alsizyakin/InvertorPowerNewGen/CHANGELOG_rev0.1.md

# CHANGELOG ревизии 0.1

Ведётся по разделам `REV0_1_TASK.md`. Обозначения — как в проекте, координаты — в мм по rev0.
Решения владельца от 2026-10-15 — раздел **Р** задания (Р1…Р7).

---

## §0. Перенос 0.1/0.2 из rev1 — выполнено (Р4)

| Коммит rev0.1 | Из rev1 | Что |
|---|---|---|
| `4d11850` | `7035780` | 0.1: библиотеки символов |
| `399472e` | `4fded72` | 0.2: `no_connect` на J6.14 и J6.16 |
| `45a6383` | `4f0544f` | 0.2: пояснение про семь цепей +3.3 В |
| `ca5474b` | `28699c8` | 0.2: флаги питания |

Перенос прошёл без конфликтов. Подробная запись — в `CHANGELOG_rev1.md`, файл пришёл вместе с коммитами.

**Проверки** (kicad-cli 10.0.3, на копии проекта):

| | База (`main`) | После переноса |
|---|---|---|
| ERC, ошибки | 21 | **9** |
| ERC, предупреждения | 35 | 30 |
| DRC: ошибки / неразведённые / расхождения со схемой | 0 / 0 / 0 | 0 / 0 / 0 |
| DRC, предупреждения | 1 (`silk_edge_clearance`) | 1, то же |
| Netlist | — | отличается только секцией `libraries` (+`CAN_My`, +`Novosense`) и `pintype` у J6.14/16 (`passive+no_connect`) |

**9 ошибок ERC — новая база (Р5):**
- 6 `different_unit_net` + 2 `duplicate_pins` — дефект символа `Logic_My:TLV3502AIDR` (U6). В rev1 они уходили
  вместе с U6, здесь лист OCP заморожен — остаются;
- 1 `power_pin_not_driven` — цепь GND (ERC показывает её на D6.3, лист `Driver_3`). Снимается флагом PWR_FLAG на
  GND в GUI; по критерию Р5 не обязательно.

Предупреждения `endpoint_off_grid` (12, `Phase_A.kicad_sch`) в rev1 чинились в §1.3. Здесь их можно снять в §3.3,
когда лист всё равно переделывается.

### Как правим схему и плату (проверено 2026-10-15)

- **Новые символы в подлисты можно добавлять правкой файла.** Вывод `CHANGELOG_rev1.md` §0.2 («только в GUI»)
  для подлистов не подтвердился. Проба на копии проекта: в `Phase_A.kicad_sch` добавлен `Device:C_Small`
  (C_gs, DNP) параллельно R21.
  - Результат: ERC — те же 9 ошибок; в netlist +3 компонента (по одному на экземпляр листа), каждый между
    затвором своего LS (Q8 / Q9 / Q11) и GND; других изменений связей нет.
  - Условия: символ копируется из кэша `lib_symbols` другого листа той же версии KiCad; у экземпляра
    перечислены пути всех трёх экземпляров листа.
  - Побочный эффект: безымянные цепи переименовываются по новому компоненту (`Net-(Q8-PadG)` →
    `Net-(C902-Pad1)`). Где имя важно для проверок, ставить метку цепи.
  - Корневой лист `Power.kicad_sch` по-прежнему не трогаем: правки задания его не требуют.
- **Обновление платы из схемы — только в GUI** (Tools → Update PCB from Schematic).
- **Python-модуль `pcbnew` 10.0.3 не годится:** `LoadBoard` падает (segfault). Плата правится как текст
  (`.kicad_pcb`). Зоны перезаливаются и файл сохраняется через `kicad-cli pcb drc --refill-zones --save-board`.
  Проба на неизменённой плате: пересохранение меняет 14 строк (округление заливки), DRC тот же.

---

## §1. Подготовка и сверка

### 1.1 Ветка — выполнено

`rev0.1` от `main`, задание и находки стенда — коммит `403fd38`.

### 1.2 Сверка Находок §2 с разбором — выполнено

Разбор — скриптом по `Power.kicad_pcb` (парсер `bench_2026-10-13/tools/kpcb.py`) и рендером kicad-cli.

| Что | Находки | Разбор | Итог |
|---|---|---|---|
| Возврат SW драйвера (вывод 6) | к узлу у шунта: C y ≈ 100–104, B и A y ≈ 102.5 | дорожкой F.Cu к виа узла: D4 → (126.25, 102.25), D5 → (138.25, 103.75), D6 → (162.25, 103.75); от того же вывода — к C7/C8/C9 | совпадает; у A точка в 7.5 мм правее драйвера |
| Возврат GND драйвера (вывод 3) | виа (126.75, 108.0) на слои GND | D4 (126.75, 108.0), D5 (138.82, 108.18), D6 (150.85, 107.95) | совпадает |
| HO, F.Cu + In3, мм | C 3.1 + 26.9, B 3.1 + 27.0, A 3.1 + 30.9 | то же | совпадает |
| LO, F.Cu + In3, мм | C 3.1 + 34.7, B 3.3 + 30.4, A 3.6 + 30.8 | то же | совпадает |
| HO/LO по In3 внутри блока | 13–23 мм | 6.6–13.6 мм в окне §2 задания (x 116.2…169.2, y 72…91.5, оба конца внутри) | разница из-за окна; на задание не влияет |
| Что режет In3 в блоке | 6 × HO/LO, +3.3 В, 3 × NTC | HO/LO по 0.5 мм; +3.3 В — 52.4 мм; `Net-(U1-+)` / `(U2-+)` / `(U3-+)` — 22.8 / 15.7 / 20.4 мм | совпадает |
| Прочие дорожки In4 в зоне блока и драйверов | не упомянуты | одна: **VDC 1 мм, 29 мм** — от виа стока Q7 (129.5, 87.75) через колонку узла фазы C (x 124…129, y 87.75…95.25) к J6.1–4 | **новое:** пересекает путь пары HO+SW фазы C (§2.2). Обойти или перевести этот участок VDC на другой слой — решить в §2 |
| 0603 у блока | C: C92, C94; B: C93; A: C90, C95, C96 | так же по x. C90 (x 153.0) стоит над полосой GND фазы A, ближе к стоку HS фазы B | совпадает |
| Виа GND у истоков LS, вся полоса | 92 / 38 / 34 | 92 / 37 / 33 (окно — колонка полосы) | совпадает |
| Виа GND в 1.5 / 2.5 мм от выводов S у LS | — | C 8 / 29, B 22 / 31, A 22 / 29 | **у выводов фазы равны**; в 1.5 мм у C даже меньше. Лишние ~60 виа фазы C — у края платы |
| Виа узла у истоков HS | 6 / 65 / 40 | в 2.5 мм от выводов S у HS — 0 / 0 / 0. Числа 65 и 40 — поле виа под нижними LS (y 89…93), на пути к втулке | расхождение в трактовке; критерий §7 — вопрос к владельцу |
| B.Cu под блоком | пуры как на F.Cu | компонентов нет; маска открыта на колонках узла (y 74.2…100.5) — сторона радиатора | → Р1: на B.Cu ничего не ставим |
| **Мосты GND между силовой частью и драйверами/МК** | не упомянуты | Между блоком и драйверами (y 92.5…100) земля есть только в четырёх проходах между вырезами под винты и втулками J1–J3, и только на In1 и In4. На F.Cu, In2 и B.Cu её там нет; In3 ниже блока порезан дорожками, и его зона GND кончается на y 96.5. Наименьшее сечение меди GND поперёк прохода: In1 — проход C (слева от J1) 2.7 мм, J1–J2 / J2–J3 / A — 0; In4 — C 1.15, J1–J2 0.35, J2–J3 0, A 0.65 мм. Убрать In1 или In4 по отдельности — земля цела; убрать оба — распадается | **новое.** Через эти же проходы идут LO, HO, линии NTC, +3.3 В и VDC → J6. Проба «перенести LO внутри блока на In4» перерезала оба моста (виа перехода фазы C на In1, дорожки LO на In4) — GND распался на две части. Отсюда проверка: GND — один остров, мосты не уже rev0 |
| Свободное место на F.Cu у ключей | — | средний ряд между ключами y 80.2…83.6 (3.4 мм); нижний до втулок ~2.8 мм; над ключами — медь VDC, свободно от банок ЗПТ y ≈ 72…74.6, между банками до y ≈ 70 | → Р2, Р6, §8: компромиссы по месту |

### 1.3 Номиналы 0603 C90, C92…C96 — выполнено (ответ владельца 2026-10-15)

- В схеме у них стоит `2.2u`. В `BOM/Power_BOM_23.07.2026_*.xlsx` этих позиций **нет**. Керамика ЗПТ 0805
  (C5, C21, C26…C35, C75…C84) там есть: `2.2u`, 100 В.
- **На собранных платах A и B они стоят.** Ставили максимальный номинал, какой нашли в 0603; точное значение
  не записано. Для 0603 на 100 В это десятые доли микрофарады (`REV1_TASK.md` §0.3 в ветке `rev1`).
- **Обозначение `2.2u` в схеме пока оставляем** (решение владельца). Значит, Находки §2.1 верно считают эти
  0603 частью петли rev0.
- В §9 (BOM) внести их строкой с пометкой «номинал — максимальный доступный в 0603 на 100 В».

---

## §3, §5, §6 — схема: выполнено; плата — после обновления из схемы

Правка — в подлистах `Driver.kicad_sch` и `Phase_A.kicad_sch`; корневой лист не трогали. Сценарий правки и
проверки — как в пробе §0: на копии, затем в проекте.

**Что добавлено и изменено** (номера по фазам C / B / A):

| Что | C | B | A |
|---|---|---|---|
| §3.1 NetTie «SW драйвера ↔ узел» (на плате — у истоков HS) | NT1 | NT2 | NT3 |
| §3.3 R_on HO / LO — 0.82 Ом 0805, у драйвера | R106 / R112 | R107 / R113 | R108 / R114 |
| §3.3 R_off HO / LO — 0 Ом 0603 | R109 / R115 | R110 / R116 | R111 / R117 |
| §3.3 D_off HO / LO — PMEG4010BEA, SOD-323 | D30 / D33 | D31 / D34 | D32 / D35 |
| §3.3 R_g,i — было 2.7 Ом 0805, стало **1 Ом 0603** (HS1, HS2, LS1, LS2) | R23, R1, R25, R4 | R28, R2, R29, R5 | R34, R3, R35, R6 |
| §3.3 C_gs 4.7 нФ 0603 X7R, **DNP** | C100 (Q1), C101 (Q7), C102 (Q8), C103 (Q4) | C104 (Q2), C105 (Q10), C106 (Q9), C107 (Q5) | C108 (Q3), C109 (Q12), C110 (Q11), C111 (Q6) |
| §5 снаббер LS «узел — GND»: C 4.7 нФ 100 В C0G 0805 + R 0.51 Ом 1206, **DNP** | C112 + R100 | C113 + R101 | C114 + R102 |
| §5 снаббер HS «VDC — узел», то же | C115 + R103 | C116 + R104 | C117 + R105 |
| §6 HI: R 0 Ом 0603 + C 100 пФ 0603 **DNP** на GND | R118 + C118 | R119 + C119 | R120 + C120 |
| §6 LI, то же | R121 + C121 | R122 + C122 | R123 + C123 |

- **R_on 0.82 Ом** выбран так, что на ключ при включении выходит 2·0.82 + 1 = 2.64 Ом — как 2.7 Ом на
  плате A. Для режима платы B — 0 Ом.
- **R снаббера — 1206 на 0.5 Вт** (вариант §5 «один 1206 повышенной мощности»). Если при расстановке найдётся
  место под 2010 — сменить футпринт.

**Имена цепей:**
- `/Driver_x/HO` и `/Driver_x/LO` — теперь сторона затворов, после ветви (точка X);
- выводы драйвера — новые `/Driver_x/HO_DRV` и `/Driver_x/LO_DRV`;
- `/Driver_x/SW` — вывод 6 драйвера, C7/C8/C9 и NetTie;
- безымянные цепи затворов получили имена по C_gs (`Net-(C100-Pad1)` и т. п.);
- входы драйверов после R — `Net-(D4-HI)` и т. п.

**Проверки** (kicad-cli 10.0.3):

| | После переноса 0.1/0.2 | После правки |
|---|---|---|
| ERC, ошибки | 9 | **9** (те же: TLV3502 ×8, GND ×1) |
| ERC, предупреждения | 30 | 44: +8 `lib_symbol_mismatch` — новые R взяли кэш `R_Small`, который уже расходится с библиотекой (лечится обновлением символов из библиотеки, как в остатке 0.2); +6 `endpoint_off_grid` — C_gs у R21/R27, которые и так вне сетки |
| Компоненты | — | +57; у 12 R_g сменились номинал и футпринт; удалённых нет |
| Связи | — | сверены по каждой цепи: изменились только перечисленные выше. Цепи HO/LO/SW/HI/LI/затворов/узлов — как задумано во всех трёх фазах |

### Схема, второй заход (Р14, Р15)

- **R_off убраны** (R109–R111, R115–R117): D_off идёт прямо от точки X к выводу драйвера. Ветвь у драйвера —
  R_on ∥ D_off: включение через R_on + R_g,i, выключение через диод + R_g,i.
- **R_on** R106–R108, R112–R114 — 0.82 Ом, корпус 0805 → 0603. **D_off** D30–D35 — SOD-323 «для ручной
  пайки» → стандартный SOD-323 (короче на 0.8 мм).
- **Керамика §4** — C124–C135, 1 мкФ 100 В X7R 1206, по 4 на фазу (C: C124–C127, B: C128–C131, A:
  C132–C135). На листе `Phase_A` — отдельным рядом под ключами, VDC — GND.
- Проверки: ERC — 9 ошибок (база); netlist — −6 R_off, +12 C, у 6 диодов и 6 R_on сменились корпуса, цепи
  `/Driver_x/HO_DRV` и `/Driver_x/LO_DRV` объединились с катодами диодов. Других изменений нет.
- **Почему без R_off и где ветви** — перебор укладки (`geom.py`): в промежутке B.Cu между усилителями шунтов
  (≈ 4.7 × 5.4 мм) встаёт одна ветвь из трёх деталей, а в двух средних промежутках нужно по две ветви. С
  R_on 0603 и SOD-323 ветвь HO встаёт на F.Cu между своим бутстрепным конденсатором и соседним драйвером
  (столбик 1.4 × 5.5 мм), если переложить входы соседнего драйвера; ветвь LO — на B.Cu.

---

## Разводка платы (§2–§9) — выполнено, кроме мест под снабберы §5

Плата правится как текст скриптами `tools/rev01_layout/lay_*.py` (по одному на шаг, в порядке коммитов); зоны
перезаливаются `kicad-cli pcb drc --refill-zones --save-board`. Вспомогательные: `geom.py` (проверка места под
деталь), `router.py` (сеточный трассировщик на одном слое), `bridges.py` (сечения GND в проходах), `gndconn.py`,
`hidist.py` (§6), `final_checks.py` (§9.2), `probes.py` (§8). Коммиты: `aed4c93` (фаза C), `0a5d209` (D4),
`9380710` (фаза B, D5), `2e06348` (фаза A, D6), `0bd0c7e` (§6), `ecd2149` (C_gs LS), `02be98b` (§4), `9befba8`
(Р8), последний — этот раздел.

### §2, §3 — затворы, термисторы, In3

**Фаза — как шаблон C со сдвигом +17 / +34 мм.** R_gs верхних HS фаз B и A (R30/R32, R36/R38) сдвинуты на 0.25 мм
вправо: иначе колонка узла не вмещает термистор, R_g,i, net-tie и C_gs.

| | C | B | A |
|---|---|---|---|
| R_g,i верхнего HS → сторона узла | R23 (125.55, 81.5) | R28 (142.55, 81.5) | R34 (159.55, 81.5) |
| NetTie у истоков HS | NT1 (127.09, 81.5) | NT2 (144.09, 81.5) | NT3 (161.09, 81.5) |
| C_gs HS | C100 / C101 под R19 / R26 | C104 / C105 | C108 / C109 |
| Термистор (остался на узле, Р3) | TH1 (123.75, 81.75) | TH2 (140.75, 81.75) | TH3 (157.75, 81.75) |
| Линии термистора в блоке | In1 | In1; +3.3 В ниже блока — по In2 (там полигон +3.3) | In2; +3.3 В — In2 до полигона +3.3 |
| LO в блоке | In4 | In4 | In4 |
| Пара HO+SW в блоке | In4, рядом | In4, рядом, по правому краю колонки узла | HO In4, SW In1 (одна над другой) |
| Пара в проходе к драйверу | J1–J2: HO In3, SW In4 под ней | J2–J3: так же | справа от J3: HO In3, SW In1 |
| Ветвь выключения HO (R_on ∥ D_off) | B.Cu, R106/D30 между U4 и U9 | B.Cu, R107/D31 между U9 и U12 | B.Cu, R108/D32 правее U12 |
| Ветвь LO | B.Cu, R112/D33 левее U4 | F.Cu, R113/D34 под левыми выводами D5 | F.Cu, R114/D35 под D6 |

- **R_g,i нижних HS (R1, R2, R3) остались в нижнем ряду колонки стока**, как в rev0. Задание (§2.2) просило
  перенести и их; у фазы B низ колонки узла занят полем виа узла (72 шт.), места нет. HO нижнего HS
  подключается к паре короткой дорожкой F.Cu.
- **VDC → J6** перенесён с In4 на In2 (0.4 мм): на In4 он резал мост GND фазы C.
- SW каждого драйвера связан с узлом только через свой NT: `/Driver_x/SW` = {C7/C8/C9.2, D4/D5/D6.6, NT.1}.

**Приёмка §2:**

| | rev0 | rev0.1 |
|---|---|---|
| Сегменты In3 в блоке (x 116.2…169.2, y 72…91.5) | 56 | **0** (виа есть) |
| LO, мм: вывод → ветвь + ветвь → R_g (C / B / A) | 37.8 / 33.7 / 34.4 | 8.2 + 33.3 / 2.9 + 35.2 / 2.9 + 36.3 = **41.5 / 38.1 / 39.2** |
| HO, мм: вывод → ветвь + ветвь → R_g | 30.0 / 30.1 / 34.0 | 3.9 + 34.3 / 3.9 + 32.2 / 3.9 + 32.4; SW парой рядом: 40.3 / 38.0 / 33.1 |

- **LO длиннее rev0 на 3.7–4.8 мм — Р9 не выполнен.** Прибавку дают новая ветвь у драйвера (2.9 мм у B и A,
  8.2 мм у C: ветвь LO-D4 стоит на B.Cu левее U4) и обход полос по In4. Сам участок «ветвь → R_g» у C короче
  rev0 на 4.5 мм, у B и A длиннее на 1.5 и 1.9 мм.
- HO длиннее, но идёт парой с SW на всём пути, кроме последних 2–3 мм у драйвера.

**Мосты GND (Р13)** — наименьшее сечение меди GND поперёк прохода, `bridges.py`:

| | rev0 | rev0.1 |
|---|---|---|
| In1 C | 2.70 | 2.70 |
| In4 C | 1.15 | **1.85** (VDC → J6 ушёл на In2) |
| In4 J1–J2 | 0.35 | 0.20 (под SW фазы C) |
| In4 A | 0.65 | **0.90** |
| Сумма | 4.85 | **5.65** |

GND — один остров (DRC: неразведённых GND нет). `gndconn.py` показывает островок 0.5 мм² у C107 — это пад,
подключённый к виа через тепловой разрыв; скрипт такие связи не видит, DRC видит.

### §4 — керамика

- **1206 1 мкФ 100 В: по одному на фазу**, в среднем ряду колонки стока HS, одинаково на трёх фазах: C124
  (132.35, 82.15), C128 (149.35, 82.15), C132 (166.65, 82.15). У каждого своя пара виа: VDC — (131.79 / 148.79 /
  166.09, 81.15), GND — (132.91 / 149.91 / 167.21, 81.15).
- **Больше не помещается.**
  - Верхняя полоса над стоком HS занята корпусами банок ЗПТ: по футпринту `CP_Radial_D10.0mm` круг Ø10
    (контур Ø10.5) с центром на y 69.13 доходит до y 74.1–74.4 под центром банки. Задание считало полосу
    y 72…74.6 свободной — это не так. Над стоком фазы B стоит банка C12, над стоком C — C6 и C18; свободно
    только правее C11 (фаза A).
  - Нижний ряд колонки стока занят R_g нижнего HS и его дорожками (см. выше).
- **C125–C127, C129–C131, C133–C135 удалены из схемы и платы** (Р6, «по месту»; скрипт
  `sch_rev01_c.py`). 0603 C90, C92…C96 оставлены где были.
- **Оценка ESL ветви:** ~1 нГн (1206) + ~0.3 нГн пара виа ≈ 1.3 нГн на фазу, параллельно имеющимся 0603. До
  ориентира задания (0.5–0.7 нГн при 4–6 конденсаторах) далеко.

### §5 — места под RC-снаббер: не выполнено, нужен выбор владельца

На F.Cu у выводов ключей места нет ни для одной из 12 позиций; C112–C117 и R100–R105 лежат вне платы (DRC:
18 неразведённых — только они).
- **LS (узел ↔ полоса GND):**
  - стык полосы и узла в среднем ряду занят R_g, C_gs, виа LO и термистором;
  - сверху стыки фаз B и A (x 138.2 и 155.2) под банками C18 и C11;
  - снизу у B и A стоят поля виа узла.
- **HS (VDC ↔ узел):** между колонками узла и стока — R_gs, C_gs и net-tie; верх под банками; в нижнем ряду —
  R_g нижнего HS.

**Полный перебор** (`snub_search.py`): F.Cu, вся площадь блока и проходов под ним, шаг 0.2 мм, 2 ориентации.
Выводы на узел, GND и VDC должны лежать на заливке своей цепи, средняя точка — на короткой дорожке до 1 мм. Три
варианта корпусов: C 0805 + R 1206, C 0805 + R 0805, C 0603 + R 0603.
- **Мест у выводов нет ни в одной фазе, ни в одном варианте.**
- Единственная находка — HS фазы C в 0603, в верхней полосе левее банки C6. Это 10–11 мм от выводов HS, такая
  цепочка почти не демпфирует.
- Проба «убрать верхние C_gs нижних ключей (C102, C106, C110)» места под LS не дала.
- B.Cu под блоком — сторона радиатора, маска на колонках узла открыта до y 100.5. Значит, и полоса у нижнего
  края блока, скорее всего, занята радиатором; это нужно подтвердить по чертежу радиатора.

**Вариант «на один шунт меньше»** (предложение владельца 2026-10-16; перебор `snub_search2.py`).
- Вывод на GND или VDC можно опустить своей виа в сплошной слой под ним; корпуса C 0805 + R 0805.
- Без шунта узел фазы идёт прямо во втулку под блоком, и поле виа внизу колонки узла (C 25 / B 76 / A 65 виа)
  больше не нужно; его снятие моделирует `snub_noshunt_sim.py`.

| | LS (узел ↔ GND) | HS (VDC ↔ узел) |
|---|---|---|
| Текущая плата, C / B / A | нет / нет / нет | нет / нет / нет |
| Без шунта фазы B | есть: 1.4 мм до стока нижнего LS (Q5), 3.9 мм до истока, GND — виа в In3 | нет |
| Без шунта фазы A | есть: 1.6 / 3.4 мм (у Q6) | нет |
| Без шунта фазы C | только в 5–7 мм | нет |

- **Цена:**
  - прошивка: ток третьей фазы считается как −(i₁ + i₂);
  - аппаратная защита (диодные max/min на U6 → BKIN): КЗ фаза–фаза ловит, но на синусе пик немеряемой фазы
    видит как половину в двух других;
  - критерий Р8 по виа узла для этой фазы теряет смысл.
- Выигрыш — одна LS-цепочка в одной фазе.

**Состояние на 2026-10-16: решение отложено.** Владелец изучает выбросы на стенде: можно ли обойтись без
снабберов.

### §6 — входы драйверов

- R118–R123 (0 Ом, 0603) последовательно, C118–C123 (100 пФ, DNP) на GND.
- **Где стоят C:**
  - у D4 и D6 C на HI — над выводом 1 (C118, C120);
  - у D5 над выводом 1 проходят столбцы виа узла прохода J1–J2, поэтому C119 стоит у R119;
  - C на LI: у D5, D6 — у вывода 2 (C122, C123); у D4 — у R121 (C121).
- **Расстояние от меди HI/LI до меди узла на F.Cu** (`hidist.py`): **2.09 / 2.11 / 2.03 мм** (D4 / D5 / D6).
  - Получено запретом заливки F.Cu над выводами (до y 101.6 у D4 и D6, до y 103.0 у D5).
  - У D5 сняты три нижних виа узла B в проходе J1–J2: 58 → 55; это не колонка узла из Р8.
  - У D6 ближайшая медь — полигон `Phase_OUT` втулки J3 (узел через шунт).
- GND вывода 3: у D4 и D6 виа под корпусом, у D5 — виа рядом с C122.

### §7 — виа (Р8)

| | rev0 | rev0.1 |
|---|---|---|
| GND в полосе (C / B / A) | 92 / 37 / 33 | **95 / 38 / 36** |
| из них в 2.5 мм от выводов S у LS (метрика §1.2) | 29 / 31 / 29 | **29 / 32 / 29** |
| узла в колонке узла, y 72…93.5 (тот же скрипт) | 16 / 72 / 55 | **16 / 72 / 55** |

- Под верхние C_gs LS сдвинуты 3 / 3 / 4 виа внутри своих полос.
- Пять виа добавлены, чтобы вернуть число у выводов S.
- Числа узла по фазе B: задание пишет 74, тем же окном rev0 даёт 72.

### C_gs нижних ключей (§3.3)

C102 (120.05, 82.65), C103 (120.0, 91.4), C106 (135.0, 80.55), C107 (136.9, 90.2), C110 (154.05, 82.8), C111
(153.4, 90.5). У C107 и C111 GND — своими виа: полигон полосы там уже кончился.

### §8 — точки для щупа

Отдельных площадок не добавлял: для каждой пары острие и пружинная земля встают на уже открытые пэды. Пары
подобраны скриптом `probes.py`, шаг 3.1–5.5 мм.

| | C | B | A |
|---|---|---|---|
| 1. VDC / GND у керамики | C124.1 / C124.2 (3.1) | C128.1 / C110.2 (5.4) | C132.1 / C132.2 (3.1) |
| 2. BST / SW драйвера | C7.1 / C7.2 (3.1) | C8.1 / C8.2 (3.1) | C9.1 / C9.2 (3.1) |
| 3. HI / GND | R118.2 / C1.1 (4.3) | C119.2 / C122.2 (4.6) | R120.2 / D6.3 (5.5) |
| 3. LI / GND | R121.2 / C74.2 (4.8) | R122.2 / D5.3 (5.2) | R123.2 / D6.3 (5.0) |
| 4. G / S верхнего HS | R23.2 / Q8.D (5.0) | R28.2 / Q9.D (5.0) | R34.2 / Q11.D (5.0) |
| 4. G / S нижнего HS | R26.2 / Q7.S (5.0) | R32.2 / Q10.S (5.0) | R38.2 / Q12.S (5.0) |
| 5. G / S верхнего LS | R25.2 / R27.1 (4.9) | R29.2 / R33.1 (4.9) | R35.2 / R39.1 (4.9) |
| 5. D / S верхнего LS | Q8.D / R21.1 (5.0) | Q9.D / R31.1 (5.0) | Q11.D / R37.1 (5.0) |

Земля у HS — сток LS (= исток HS, узел). Если нужны отдельные площадки со своей виа у драйверов (пп. 2, 3), их
придётся добавить в схему (TestPoint), иначе плата разойдётся со схемой.

### Углы дорожек

В новой разводке было 36 изломов на 90° (в rev0 — ни одного). `chamfer.py` срезал их под 45°; длина среза
подбиралась от 0.8 мм вниз так, чтобы до чужой меди оставалось ≥ 0.2 мм. Вход HI драйвера D4 (`/TMR1_CH3`)
делал петлю вправо и обратно — переложен прямо. Осталось 6 изломов, все внутри пэдов и виа. Проверки после
правки: DRC 0 ошибок; In3 в блоке 0 сегментов; §6 — 2.09 / 2.11 / 2.03 мм; мосты GND 5.65 мм.

### §9 — итоговые проверки

| | Результат |
|---|---|
| ERC, ошибки | 9 (база Р5) |
| DRC: ошибки / предупреждения | 0 / 1 (`silk_edge_clearance` у C11 — было в rev0) |
| DRC: неразведённые | 18 — только снабберы §5, лежат вне платы |
| DRC: расхождения со схемой | 0 |
| (а) In3 в блоке | 0 сегментов |
| (в) SW только через net-tie | да, три NT |
| (в′) GND | один остров; сумма мостов 5.65 мм ≥ 4.85 |
| (г) DNP | C_gs C100–C111, снабберы C112–C117 и R100–R105, C на HI/LI C118–C123 |
| BOM | новые позиции: C_gs 4.7 нФ 0603 ×12 DNP; снаббер 4.7 нФ 100 В C0G 0805 ×6 DNP и 0.51 Ом 1206 ×6 DNP; 100 пФ 0603 ×6 DNP; 1 мкФ 100 В X7R 1206 ×3; PMEG4010BEA ×6; 0.82 Ом 0603 ×6; 0 Ом 0603 ×6; R_g,i 2.7 Ом 0805 → 1 Ом 0603 ×12 |
| Netlist rev0 → rev0.1 | `netdiff.py`: изменились только цепи затворов, HO/LO (+ `_DRV`), SW (+ NT), HI/LI, узлы (+ C_gs, снаббер), VDC/GND (+ керамика, снаббер). Цепи термисторов не менялись |

---

## Состояние работы на 2026-10-16 (пауза)

Ветка `rev0.1`, не слита и не отправлена. Плата и схема согласованы: DRC 0 ошибок, расхождений со схемой нет,
18 неразведённых — только снабберы вне платы; ERC 9 (база).

**Ждут решения владельца:**
1. **§5, снабберы.** Варианты:
   - убрать их из rev0.1;
   - B.Cu под нижним краем блока, если радиатор кончается выше y 92;
   - убрать шунт фазы B или A и поставить одну LS-цепочку в этой фазе.

   Решение — после изучения выбросов на стенде.
2. **Р9:** LO длиннее rev0 на 3.7–4.8 мм. Принять или сокращать (начать с ветви LO-D4, 8.2 мм).
3. **§4:** оставить 1 мкФ 1206 или поставить 2.2 мкФ 1210 на то же место (правка схемы).
4. **§8:** хватает ли имеющихся пэдов, или у драйверов нужны отдельные TestPoint.

**Как продолжить.**
- Скрипты шагов — `tools/rev01_layout/lay_*.py`, по порядку коммитов; данные расстановок — `tools/rev01_layout/data`.
- Плата правится как текст: Python-модуль `pcbnew` 10.0.3 в этой сборке падает на `LoadBoard` любой платы.
- Зоны перезаливаются и проверки идут через `run_drc.sh`. Регрессия — `final_checks.py`, `hidist.py`,
  `bridges.py`, `corners.py`.
- KiCad на время правок закрыт; обновление платы из схемы (F8) делает владелец.

---

## Проба 2026-10-17: плата длиннее на 4 мм — места под снабберы §5

Вопрос владельца: если плату можно удлинить на 4 мм, отодвинуть банки ЗПТ от блока и поставить снабберы в
освободившуюся полосу. **Длина ещё выясняется**; рабочая плата не менялась, всё — на копиях.

**Как моделировали.**
- `stretch.py`: всё, что выше y 72 (край, J4/J5, H1/H2, 11 банок, 0805 под ними на B.Cu), поднято на 4 мм. Блок,
  драйверы и всё ниже y 72 не двигаются. DRC копии — как у рабочей платы.
- `stretch_zones.py`: верх зон узла и полос GND на F.Cu (y 74.25 / 73.25) поднят до 71.25, VDC между колонками
  стоков HS вырезан. Колонки стоков HS остаются связаны с полем банок. C90, C93, C94 (0603 2.2 мкФ из rev0)
  мешают, на копии сняты.
- Перебор — тем же `snub_search.py` / `snub_search2.py` (критерии §5), положение банок — через `CANY`.

**Результат.** Расстояние — от вывода цепочки до ближайшего вывода D/S ключа, мм:

| Вариант | LS C / B / A | HS C / B / A |
|---|---|---|
| Рабочая плата | нет | нет |
| +4 мм, зоны как есть | только с виа в плоскость: 1.4/3.8, 1.5/1.5, 1.4/2.6 | с виа: 1.3/1.4, 1.3/2.0, 1.3/1.4 |
| **+4 мм, зоны подняты** | **1.3/1.4 во всех фазах, без виа** | **1.3/1.4, без виа** |
| +3 мм, R 0805 | 1.3/1.4 | 1.3/1.4 |
| +3 мм, R 1206 | 1.3/1.4, 1.5/1.5, 1.3/1.4 | 1.3/3.0, 1.3/1.5, 1.3/1.5 |
| +2 мм | 1.3…2.8, по фазам разное | до 3.4 |

- **Расстановка проверена DRC** (`snub_place.py`, данные `data/snub_plus4_ext_a.json`, `snub_plus3_ext_a.json`):
  C112–C117 0805 и R100–R105 1206, как в схеме, на копиях +4 мм и +3 мм — 0 ошибок, неразведённых 0 (было 18).
  Цепочка U-образная, над своим стыком «GND | узел» (LS) или «узел | VDC» (HS), одинаково на трёх фазах.
- **C90, C93, C94** встают рядом (`cer_scan.py`): C90 — на стык «сток HS-B | полоса GND A» (151.5, 73.75), C94 —
  на стык VDC и полосы GND C (118.25, 72.0); C93 — к x 148–151, не над узлом B.
- **§4:** в полосе вместе со снабберами встаёт ещё один 1206 на фазу, в 2–3 мм от верха стока HS (вывод GND —
  своей виа): 2 × 1206 на фазу вместо одного.
- **Электрически сдвиг банок незаметен:** VDC/GND идут тремя парами слоёв с зазором 0.1 мм; +4 мм пути дают
  ~0.01 нГн и ~0.03 мОм (≈0.1 Вт при 60 А постоянного тока).
- **Д3 при удлинении не нужен:** снабберы встают, R_gs остаются у затворов.

**Механика — решает владелец:**
- длина 109 → 113 мм при радиаторе заказчика 110 мм (`REV1_TASK.md` A.4);
- межцентровое H1/H2 ↔ H3/H4 91.75 → 95.75 мм, J4/J5 сдвигаются на 4 мм относительно J1–J3 (шины);
- уступ контура на y 70.75 поднимается вместе с верхом.

---

## In3 — сплошная земля на всю плату (ветка `rev0.1-gnd`, 2026-10-17)

Решение владельца: In3 — один сплошной слой GND по всей плате. Дорожки с него уходят на соседние In2 и In4 (оба
опираются на In3), под блоком — по краям силовых зон. Ветка `rev0.1-gnd` от `rev0.1` (`cebc037`); скрипт
`tools/rev01_layout/lay_G3.py`, затем `run_drc.sh`.

**Что перенесено.** Все 152 сегмента In3 (456 мм, 23 цепи); геометрия прежняя, кроме оговорённого ниже.

| Куда | Цепи | Почему |
|---|---|---|
| In2 (In3 в 0.1 мм) | HO C, HO B — в проходах J1–J2 и J2–J3 над своим SW на In4; ADC_IN_1/2, TMR1_CH1/2, D24-A, D13-K | ближайшая опора; HO — по кромке зон, там нет места под пару в одном слое |
| In4 | LO C/B/A и HO A — теперь целиком на In4, от блока до драйвера; NTC C (U1+, +3.3V) в проходе C; NTC B/A ниже блока (U2+, U3+); +12V; VDC_MCU; SWCLK/SWDIO; Temp_PCB_1/2/3 | продолжение уже идущих по In4 участков; SWD и Temp на In2 резали плоскость +3.3V на острова (FB7, D16) |

- **LO C:** переходная виа (124.0, 96.1) снята (оба участка на In4), стык 0.3/0.5 мм — одним изломом 45°.
- **LO A:** по x 150 прямо до своей виа (150.6, 109.7) — в обход SW B, который на In4 уходит влево с y 104.6.
- Переходные виа LO B, LO A, HO A остаются: через них идёт и F.Cu.

**Проверки** (kicad-cli 10.0.3):

| | `rev0.1` | `rev0.1-gnd` |
|---|---|---|
| DRC: ошибки / неразведённые / расхождения | 0 / 18 (снабберы) / 0 | 0 / 18 / 0 |
| Дорожки на In3 | 152 сегмента, 456 мм | **0** |
| Заливка GND на In3 | 3617 мм², 4 куска | **4085 мм², 1 кусок** |
| GND — одна связная сеть (`gndconn.py`) | да | да |
| Плоскость +3.3V на In2 | 1768 мм², 1 кусок | 1717 мм², 1 кусок |
| Заливка GND на In4 | 3429 мм², 5 кусков | 3054 мм², 11 кусков (все сшиты виа) |
| Мосты GND в проходах C / J1–J2 / J2–J3 / A, In3 | 0.85 / 0 / 0.70 / 1.85 | **2.70 / 0.90 / 1.75 / 2.65** |
| то же, In4 | 1.85 / 0.20 / 0 / 0.90 | 0.55 / 0 / 0 / 0 |
| Сумма мостов In1 + In3 + In4 | 9.05 мм | 11.25 мм |
| Длины LO / HO (§9.2) | — | без изменений, у LO A 36.3 → 35.9 мм |
| Изломы 90° | 6 | 8, все внутри пэдов и виа |
| Виа Р8 по фазам | 95/53/16, 38/35/72, 36/32/55 | те же |

**Потери меди силовых зон** (в основном полоски ниже кустов виа шунтов, y > 102, — тупиковая медь):
Phase_OUT B на In4 −26 мм² (100 → 74), Phase_OUT A на In4 −20 (87 → 67), Phase_OUT A на In2 −10 (94 → 84),
узел B на In2 −7 (170 → 163). Причина — U2+ и U3+ вдоль y ≈ 102 под втулками и LO A по кромке Phase_OUT A.

**Открыто — решает владелец:**
- **Р13 по букве не выполняется:** In1 + In4 = 3.25 мм < 4.85 мм. Но In3 теперь даёт в проходах 8.0 мм, сумма по
  трём слоям выросла с 9.05 до 11.25 мм. Предложение — считать Р13 по In1 + In3 + In4.
- **Пары HO/SW в проходах разделены слоем In3:** C и B — HO на In2, SW на In4 (было In3/In4); A — HO на In4, SW на
  In1 (было In3/In1). Вдвоём в одном слое по проходу не проходят.

### Ревью ветки `rev0.1-gnd`, раунд 1: правки разводки

Ревью — `docs/reviews/`: 01 (аналог и МК), 03 (ЭМС), 05 (силовая часть). Ответы — 02, 04, 06. Скрипт
`tools/rev01_layout/lay_G3b.py`; замеры — `ovl.py` (перекрытия соседних слоёв), `islands.py` (острова заливки).

| № | По замечанию | Что сделано |
|---|---|---|
| F1 | S2, E9 | Temp_PCB_3 — снова на In2. SWD — на In2 от y ≈ 118 вниз вдоль U6; у J6 остаётся на In4: на In2 там отрезалась бы виа FB7 (121.25, 113.75). Новые переходные виа (120.75, 118.5) и (122.0, 117.75) |
| F2 | S4, E5 | Под входами HI драйверов D4 и D6 на In1 — местные зоны GND с приоритетом выше Phase_OUT, x 127.6–129.4 и 148.9–152.7, y 103.1–105.4 |
| F3 | E6 | HO A ушла из-под шайбы правого винта. Обход по F.Cu у выреза и виа (162.1, 92.9) сняты; ветвь по In4 вдоль y 89.4 и виа (166.66, 89.4) у R3.1 — как HO C по In4 вдоль y 90.65 |
| F6 | E8 | 21 сшивающая виа GND: 17 по краю части управления (шаг ≥ 3 мм, 0.9–1.5 мм от края) и 4 у земляных выводов J6/J7 |
| F7 | E7, S6 | Окружение кельвиновских пар одинаково во всех фазах. U2+ и U3+ ниже блока — на In2, от пар их отделяет In3. Линии +3.3V NTC B/A в местах пересечения — на In4: B — вставка (147.2, 100.85…103.6); A — от (159.26, 101.25) в плоскость через виа (156.4, 104.5). Переходная виа U3+ (159.5, 102.0) снята. Спуск +12V фазы A — по оси шунта x 154.7, как в C и B; GND-виа (154.8, 108.0) перенесена в (155.7, 108.0) |
| F8 | S5, E9 | Вторая виа GND (138.45, 103.38) на острове In4 под U4/U9 (55 мм²) |
| F9 | P5 | Зазоры открытых пэдов: C124/C128 (с VDC-виа и подводами) +0.3 мм по x — VDC-пэд в 0.53 мм от R19.2/C100.1 и R30.2/C104.1 (было 0.225); C7/C8/C9 −0.3 мм по x — дорожки HI соседнего драйвера в 0.53 мм (было 0.23). Мест < 0.5 мм по `hv.py` ревьюера: 30 → 24 |
| F10 | P1 | C132: вторая виа GND (167.31, 82.15) у внутренней кромки GND-пэда, рядом с имеющейся (167.21, 81.15); снаружи пэда места нет |
| F11 | E8 | Плоскость +3.3V на In2 отодвинута от левого, правого и нижнего края на 1 мм (`lay_G3c.py`); 1594 → 1525 мм², один кусок |

**Проверки** (`115276c` → после правок):

| | `115276c` | Сейчас |
|---|---|---|
| DRC: ошибки / неразведённые / расхождения | 0 / 18 / 0 | 0 / 18 / 0 |
| In4 над аналоговыми цепями B.Cu: SWD и Temp_PCB_3 над входами U6, D13-K, D24-A | 0.5–4.8 мм² | **нет** |
| In4 над линиями Кельвина (дорожки B.Cu от шунта к U4/U9/U12) | U2+, U3+, +12V A: 0.8–1.8 мм² | 0.09 мм² (+12V по оси пары) и 0.15 мм² (+3.3V A) |
| Входы HI над Phase_OUT на In1 | D6 0.86 мм² | **нет**, под ними GND |
| Ближайшая затворная линия до выреза под винт | 0.29 мм (HO A, F.Cu) | 1.39 мм (LO C, In4) |
| In3 GND | 4085 мм², 1 кусок | 4080 мм², 1 кусок |
| In4 GND | 3054 мм², 11 кусков | 3168 мм², 8 кусков; на одной виа — только островок 9 мм² в блоке (места нет) |
| Плоскость +3.3V на In2 | 1717 мм², 1 кусок | 1525 мм², 1 кусок, в 1 мм от края |
| Phase_OUT на внутренних слоях, A / B | 247 / 241 мм² | 240 / 249 мм² (в rev0.1 276 / 266); потери — полоски ниже кустов виа шунтов |
| Длины LO / HO | — | LO C 32.6 мм, HO A 31.7 мм; остальные прежние |
| Изломы 90° | 8 | 7, все внутри пэдов и виа |
| Открытые пэды ближе 0.5 мм к меди с разностью до 84–96 В (`hv.py`) | 30 (худшее 0.225) | 24 (худшее 0.27 — шаг J6 до свободных выводов; затем 0.281 C_gs ↔ D-пэд нижнего HS) |
| HI/LI до меди узла на F.Cu (`hidist.py`) | 2.09 / 2.11 / 2.03 мм | 2.09 / 2.21 / 2.03 мм |

**После раунда 1 ждут решения владельца** (подробно — ответы 02, 04, 06):
1. **Длина +4 мм** и чем заполнять полосу. Предложение 05:
   - LS-снаббер в компактной геометрии: средняя точка — островок, R — 2 × 1206 по 1 Ом или 0612;
   - 2 керамики на фазу;
   - HS-снаббер — место без установки.

   U-образная проба с ветвью ~2.2 нГн даёт −13…17 %, а не −35 %.
2. **Д3 снять:** места под снабберы он не даёт (05 проверил на копии), R_gs остаются у затворов.
3. **Заземление радиатора** (03 E1) и медь узла у вырезов под винты и у края, у J6/J7 (E6, затрагивает Р8).
4. **Зазоры для 72–84 В:** 24 места < 0.5 мм у открытых пэдов (`hv.py`) — лак или правки геометрии (05 P5).
5. **Поле виа узла B:** 26 виа под нижним рядом (05 P4). Переносить некуда, остаются варианты против Р8 или Р13.
6. **Правки схемы:**
   - бусина и 100 нФ на VDC у J6 (03 E3);
   - 100 нФ у VDD драйверов (01 S7);
   - фильтр OCP τ 12 мкс (01 S3);
   - CAN: дроссель и разделённая терминация (03 E12).
7. **Р13:** считать мосты по In1 + In3 + In4 — поддержано ревью 03 и 05.
8. **AD8418 против выброса узла 83–87 В уже на 48 В** (01 S1): замер на U4.8/U4.1.

**В список стенда добавлены:**
- выброс HS и эмуляция Кельвина проводом на rev0 (05 P3);
- опыт Д1 с длинной и короткой ветвью снаббера;
- синфазный ток клещами при плавающем и заземлённом радиаторе (03);
- наброс на затвор при C_gs в 3–4 мм от выводов;
- напряжение на входах AD8418;
- знак тока фазы A в прошивке (01 S9).

---

## Ветка `rev0.1-plus4` (от `rev0.1-gnd`, 2026-10-17): решения владельца

Ответ владельца на открытые решения раунда 1:
- Д3 снять;
- Д1 и Д2 выполнить;
- длину +4 мм делать в отдельной ветке;
- радиатор изолирован от VDC и стоит на корпусе объекта; батарея с корпусом не соединяется.

### Д1, Д2 — выполнено (`sch_rev01_d.py`)

| | Было | Стало |
|---|---|---|
| Д1: C_gs C100–C111 (12 шт., 0603) | 4.7 нФ, DNP | **10 нФ 50 В C0G**, ставятся (C0G 0603 10 нФ 50 В есть, например GRM1885C1H103J) |
| Д2: D_off D30–D35 (SOD-323) | ставятся | **DNP** |

- R_on (R106–R108, R112–R114) остаются 0.82 Ом, как в задании; окончательный номинал — по Р5 pslc.
- Правка — в символах листов `Phase_A` и `Driver`. Те же номиналы и признак DNP записаны в посадочные места на плате, поэтому
  плата со схемой сходится без обновления из схемы. F8 после этого ничего не должен менять.
- Проверки: ERC — 9 ошибок (база); DRC — 0 ошибок, 18 неразведённых (снабберы), 0 расхождений; BOM — C100–C111 без DNP,
  D30–D35 с DNP.

### Д3 — снят

Проба на копии (05 P2) мест под снабберы не дала; R_gs остаются у затворов.

### Плата длиннее на 4 мм (`plus4.sh`)

Порядок: `stretch.py` → `stretch_zones.py` → `sch_rev01_e.py` → `lay_P4.py` → перезаливка и DRC. Места в полосе подобраны
перебором `strip_plan.py`, результат — `data/strip_plan_plus4.json`.

**Контур и механика.**
- Плата 53 × 108.76 → 53 × 112.76 мм.
- Всё, что выше y 72, поднято на 4 мм: 11 банок ЗПТ, J4/J5 (y 41.5 → 37.5), H1/H2 (42.5 → 38.5), верх контура.
- Блок ключей, драйверы и всё ниже не двигались.
- Межцентровые: H1/H2 ↔ H3/H4 91.75 → 95.75 мм; J4/J5 ↔ J1–J3 55 → 59 мм.
- Верх F.Cu-зон узла и полос GND поднят до y 71.25, VDC там вырезан — как в пробе.

**Полоса между банками и блоком: что где стоит.**

| | C | B | A |
|---|---|---|---|
| Снаббер LS (узел — GND): C / R | C112 / R100 | C113 / R101 | C114 / R102 |
| — от вывода R / вывода C до выводов ключа, мм | 1.14 / 0.39 | 1.14 / 0.39 | 1.14 / 0.39 |
| Снаббер HS (VDC — узел): C / R | C115 / R103 | C116 / R104 | C117 / R105 |
| — от вывода R / вывода C до выводов ключа, мм | 1.46 / 0.39 | 1.21 / 0.39 | 1.29 / 0.39 |
| Новый 1206 1 мкФ 100 В у стока HS | C125 (132.6, 73.3): GND-пэд на полосе GND фазы B + 2 виа | C129 (150.1, 73.3): GND-пэд на полосе GND фазы A + 2 виа | C133 (165.7, 72.1), стоя; 2 виа над GND-пэдом |
| 0603 2.2 мкФ из rev0 | C94, C92 | C93, C90 | C95, C96 |

- **Снаббер — компактная цепочка по 05 P2.**
  - R 0612 стоит выводами вдоль полосы. C 0805 повёрнут на 90° вплотную к среднему пэду R.
  - Средняя точка — медная перемычка 1.2 мм шириной и 0.5 мм длиной вместо дорожки 0.3 × 2.6 мм.
  - Вывод C — прямо над выводами D/S верхнего ключа (0.39 мм). Вывод R — в 1.1–1.5 мм от выводов.
  - Форма цепочки во всех 6 местах одна, без виа. Положение относительно ключа по фазам отличается на 0.3–0.7 мм (07 P9).
- **R снаббера** — 0.47 Ом, 0612 с выводами по длинной стороне, 1.5 Вт (например ROHM LTR18EZPFLR470). Было 0.51 Ом 1206.
  - Почему: по 05 P2 индуктивность ~0.3 нГн против ~0.75 нГн у 1206.
  - Мощность: верхняя граница C·V²·f — 0.49 / 0.66 Вт при 72 / 84 В и 20 кГц. По модели 07 P10 в R реально уходит
    0.1–0.2 Вт.
  - C снаббера — 4.7 нФ 100 В C0G 0805, как было. Все 12 деталей по-прежнему DNP.
- **Зазоры.** У выводов на узел, VDC и GND задан местный зазор 0.5 мм (05 P5).
  - У средней точки сначала было 0.3 мм. Зоны силовых цепей при этом отступают от неё тоже лишь на 0.3 мм: местный зазор
    пэда сильнее зазора зоны.
  - Этого мало (07 P9): по постоянному току средняя точка сидит на потенциале дальнего вывода R. В раунде 2 зазор стал 0.5 мм (F12).
- **0603 C90, C92…C96 — по две на фазу только по обозначениям** (было 2 / 1 / 3, 05 P4). Каждая — VDC-пэдом на ленту,
  GND-пэдом на свою виа в In1/In3. Старые виа и подводы C92, C95, C96 сняты.
  - У стока HS стоят: у C — C92, у B — C90, у A — C95 и C96.
  - C94 (121.6, 69.7) — над полосой GND фазы C. C93 (141.4, 71.1) — над узлом B (07 P11).
  - Ближе к стокам места нет: там снабберы и новые 1206. Разница фаз ≈0.03 нГн, это ≈1 В при 72 В.

**Не поместилось — вторая 1206 на фазу у стока HS** (05 P1 просил ≥ 2 в полосе).
- Ширины полосы над стоком HS хватает либо на место снаббера HS, либо на вторую 1206. Перебор без места снаббера HS ставит
  обе 1206 в 1.25–4.3 мм от верха стока во всех фазах.
- С местом снаббера HS второй 1206 нет места в своей фазе у B. У C она встаёт только в 12 мм, у A — в 6 мм.
- По Р6 керамики на фазах поровну, поэтому добавлено по одной: на фазу теперь две 1206 (C124 в среднем ряду и новая в
  полосе) и две 0603.
- §5 задания требует не урезать цепочку HS. По 07 P11 место снаббера HS весит в 5–10 раз больше второй 1206:
  −9…−12 В на верхнем HS против −1…−2 В. Место HS оставлено.

**Схема** (`sch_rev01_e.py`, лист `Phase_A`):
- R100/R103 → 0612, 0.47 Ом;
- новый символ C125 (экземпляры C125 / C129 / C133) — параллельно C124, как убранный в раунде 3 C125.

Посадочные места на плате связаны с новыми символами (`data/sch_e_uuids.json`), поэтому F8 ничего менять не должен.

**Проверки** (kicad-cli 10.0.3):

| | `rev0.1-gnd` + Д1/Д2 | `rev0.1-plus4` |
|---|---|---|
| DRC: ошибки / неразведённые / расхождения | 0 / 18 / 0 | **0 / 0 / 0** — снабберы на плате |
| ERC, ошибки | 9 | 9 |
| Открытые пэды ближе 0.5 мм к меди другой цепи (`hv.py`) | 24 | 24 — новых нет |
| Перекрытия корпусов у новых и сдвинутых деталей (`crt_overlap.py`; DRC проекта их не проверяет) | — | 0 |
| In3 GND | 4080 мм², 1 кусок | 4290 мм², 1 кусок |
| Изломы 90° | 7 | те же 7. Ещё 11 на B.Cu GND — это дорожки rev0 у выводов банок, сдвинутые вместе с банками; изломы внутри THT-пэдов |
| Длины затворных линий, мосты GND, виа Р8 | — | без изменений: блок и всё ниже не двигались |

### Радиатор на корпусе, батарея плавающая — что из этого следует (решения 03 E1, E6)

- **GND с радиатором не соединять** — ни напрямую, ни через винт. Изоляцию между узлом, VDC, GND и корпусом держит теплопроводящая
  прокладка; её пробивное напряжение должно покрывать 84 В плюс выбросы.
- **Под головками винтов в вырезах лежит медь высоковольтной части.** Если шайба металлическая и касается радиатора, от неё
  эту медь отделяет только маска.
  - Правый вырез, в радиусе 4.75 мм от центра: 32 виа узла A, C109, R3.
  - Левый вырез, в том же радиусе: 6 виа узла C, C103, R68/R69.
  - **Предложение:** изолирующие шайбы под винты (полиамид или текстолит). Убрать медь из-под шайбы значит снять до 32 виа
    узла A (против Р8) и переставить обвязку затворов.
- **Синфазный ток через радиатор** (ёмкость узел — радиатор 25–100 пФ на фазу) возвращается через корпус. Путь для него —
  конденсаторы Y на входе батареи, на уровне системы. Замер клещами — в списке стенда.
  - 09 E13 с выводом «на этой плате ничего не меняется» не согласен: ниже ~30 МГц ток уходит в жгуты. Он предлагает места
    под Y на самой плате — см. раунд 2.

### Ревью ветки `rev0.1-plus4`, раунд 2: правки

Ревью — `docs/reviews/07` (силовая часть, P9–P14) и `09` (ЭМС, E13–E18). Ответы — `08` и `10`. Скрипт —
`tools/rev01_layout/lay_P4b.py`, он же последний шаг `plus4.sh`.

| № | По замечанию | Что сделано |
|---|---|---|
| F12 | 07 P9 | Средним точкам снабберов (C112–C117.2, R100–R105.1) — местный зазор 0.5 мм. Цепочка LS фазы A (R102, C114, перемычка) поднята на 0.06 мм: R102.1 отходит от D-пэда Q11; по x сдвигать некуда — там C129 и Q11. GND-виа (119.75, 74.85) перенесена в (119.35, 75.05) — дальше от R100.1, у тех же выводов S Q8. `hv.py` теперь считает и среднюю точку: у LS-цепочки — как GND, у HS — как узел своей фазы |
| F13 | 07 P14 | VDC на B.Cu над колонками узла в полосе возвращён: три зоны VDC только на B.Cu, x 121.85–129.5 / 138.85–146.5 / 155.85–163.5, y 71.0–73.65. От полос GND и зон узла на B.Cu — 0.6 мм. Приоритет 9: две зоны одной цепи с одним приоритетом DRC считает ошибкой |
| F14 | 09 E14, 07 P12 | Окна маски B.Mask над узлом отодвинуты от пазов под винты на 1.5 мм: из зон B.Mask узлов C и A вырезан круг r 4.25 вокруг (119.0, 95.5) и (166.5, 95.5). Медь и виа (Р8) не тронуты |

**Проверки** (`ea2d599` → после правок):

| | `ea2d599` | Сейчас |
|---|---|---|
| DRC: ошибки / неразведённые / расхождения | 0 / 0 / 0 | 0 / 0 / 0 |
| `hv.py` со средними точками снабберов: мест < 0.5 мм | 41 | **24** (как до удлинения) |
| Перекрытия корпусов у новых и сдвинутых деталей | 0 | 0 |
| VDC на B.Cu в полосе (y 66–74.25) | 242 мм² | 290 мм² |
| Открытая маской медь узла в 1.5 мм от кромки паза, левый / правый | 9.2 / 12.6 мм² | 0 / 0.1 мм² |
| Окно маски до кромки паза | 0 мм | 1.5 мм |
| `plus4.sh` с `515455d` | — | та же плата: DRC 0 / 0 / 0, `hv.py` 24 |

**Уточнено по ревью** (подробно — в 08 и 10):
- **Снабберы** (07 P10, по модели ревьюера):
  - ветвь ≈1.1 нГн у LS и ≈1.4 нГн у HS;
  - выброс на верхнем ключе −24…−28 %, на нижнем LS −23 %, на нижнем HS −12…−17 %. −35 % с корпусом 0805 не будет;
  - на стенде сначала пробовать C 6.8–10 нФ, R менять потом.
- **Место HS-снаббера оставить, вторую 1206 не ставить** (07 P11). Керамику усиливать заменой корпусов на тех же местах.
  0612 обратной геометрии на 1 мкФ 100 В в продаже не нашёл: поиск дал только LLL31 на 100 нФ при 50 и 16 В.
- **84 В** (07 P13): при R_on 0.82 Ом кристалл выше 100 В даже со снаббером, 104–106 В по модели. Нужен спад тока
  ≥ 10–12 нс, это R_on ≈ 2 Ом — выбор по Р5.
- **Отверстия D-пэдов** (07 P12): 12 × 28 = 336 отверстий Ø0.3, открыты с обеих сторон (`*.Mask`). В настройках платы
  заполнение и закрытие выключены. Под прокладкой это бугорки припоя.

**Ждут решения владельца после раунда 2:**
1. **Механика +4 мм.** Плата 112.76 мм при радиаторе 110 мм. H1/H2 ↔ H3/H4 — 95.75 мм, J4/J5 ↔ J1–J3 — 59 мм.
2. **Изоляция крепежа** (07 P12, 09 E14):
   - втулки с буртиком в пазах вместо плоских шайб;
   - отверстие в прокладке не больше паза;
   - у H1–H4 медь начинается в 2.0 мм от кромки, поэтому там шайбы ≤ Ø6 или изолирующие, либо запрет заливки r 4.5 мм.
3. **Отверстия D-пэдов:** заполнение и закрытие (IPC-4761 тип VII) в примечаниях к изготовлению или прокладка на стеклоткани ≥ 0.2 мм.
4. **Места под Y-конденсаторы на плате** (09 E13):
   - новая цепь CHASSIS: у H1/H2 VDC и GND на корпус, у H3/H4 GND на корпус, DNP;
   - нужно знать, к чему крепятся H1–H4;
   - для 72 В — Y2 или ≥ 1 кВ и 2 мм по поверхности.
5. **Снабберы на первых платах:** ставить ли LS-снабберы хотя бы на одной (09 E15).
6. **R_on для 72/84 В** (07 P13, Р5).
7. **Опора CAN и датчиков Холла** (09 E16, E12): к чему отнесены остальные узлы, нужна ли развязка CAN.
8. **Норма ЭМС**, по которой сверяться (09).
9. Открытое с раунда 1:
   - 24 места < 0.5 мм для 72 В — лак или геометрия;
   - поле виа узла B;
   - правки схемы E3, S7, S3, E12;
   - Р13 по In1 + In3 + In4;
   - AD8418 против выброса.

**В список стенда добавлено:**
- снаббер у верхнего LS и HS на rev0 с ветвью ~1 нГн: выброс на верхнем и нижнем ключе, C 4.7 и 10 нФ (07);
- нагрев R снаббера и банок C6/C18/C11 тепловизором при 48 и 72 В (07, 09);
- изоляция собранного узла: мегаомметр 500 В между VDC/GND/узлами и радиатором, ≥ 100 МОм; осмотр B.Cu на бугорки
  припоя (07, 09);
- ёмкость «узел — радиатор» LCR-метром; синфазный ток клещами на парах DC, фазах и J6/J7, с Y и без, со снабберами и без
  (09);
- напряжение «GND платы — радиатор» дифференциальным щупом и ошибки CAN под нагрузкой (09).

### Замечания владельца 2026-10-19: углы дорожек, VDC на J6, INA240

Скрипты — `tools/rev01_layout/octo.py`, `lay_P4c.py`, `sch_rev01_f.py`; это шаги 6–8 `plus4.sh`. Цепочка с `515455d` даёт ту
же плату и схему: дорожки, виа, посадочные места и поля совпадают.

| № | Замечание | Что сделано |
|---|---|---|
| F17 | Дорожки от затворных резисторов идут «неровно» — держаться углов 0, 45 и 90° | `octo.py`: в разводке rev0.1 было 76 отрезков под произвольными углами (в rev0 — ни одного), теперь все под 0/45/90°. 55 выпрямлены сдвигом конца внутри своего пэда или виа; 3 (R_g → затвор верхнего HS во всех фазах, было 151°) заменены на «45° + прямо»; 14 лежали целиком внутри пэда и сняты; в 2 стыках дорожек сдвинута точка стыка. По цепям: затворы 11, драйверы (HO/LO, HO_DRV/LO_DRV, HI/LI, TMR, U1+) 42, GND 20, VDC 3. Новых изломов 90° вне пэдов нет |
| F15 | 03 E3: дорожка VDC на J6 «безобразная», точка старта проседает при коммутации, режет медь узла в проходе C | Начало — в плоскости VDC верхней полосы на In2 (121.0, 73.4), у банок, а не у низа колонки стока HS (129.0, 91.0) внутри петли коммутации. По In2 — прямо вниз по стыку полосы GND и колонки узла C (x 121.0), затем виа (120.0, 92.3) в углу полосы над пазом: там на F.Cu и B.Cu меди нет. Через проход C — по In1 (там GND), параллельно цепочке виа узла у паза, до J6.1. Дорожка 0.4 мм, около 35 мм, ≈43 мОм. Ближняя к выводам S виа Q8 (120.65, 77.5) стояла в 0.5 мм от виа стока, мешая проходу; она сдвинута на 0.4 мм к выводам S, в (120.25, 77.5). Число виа по Р8 прежнее |
| F16 | Виа в проходе уменьшают сечение полигонов | Линии термистора C (+3.3V, U1+) переходили с In1 на In4 двумя виа прямо в горле прохода C — (124.9, 91.85) и (125.6, 92.35), то есть дырами в меди узла на F.Cu, In2 и B.Cu. Теперь они идут по In1 до своих виа у U1; отрезки на In4 и обе виа сняты |
| F18 | AD8418 → INA240 (пин в пин) | U4, U9, U12 — INA240A1 (INA240A1DR), усиление 20 В/В как было. Распиновка SOIC-8 совпадает (1 IN−, 2 GND, 3 REF2, 4 NC, 5 OUT, 6 VS, 7 REF1, 8 IN+; сверено по даташиту TI). У библиотечного INA240A1D другие координаты выводов, поэтому в `Lib/Logic_My` добавлен символ INA240A1D с рисунком AD8418; листы Current_Sensor_1–3 ссылаются на него. Поля Datasheet, Description и Product Name записаны и на плату, поэтому F8 ничего менять не должен |

**Сечение меди узла C в проходе C**, мм (`ea2d599` → сейчас):

| y | F.Cu | In2 | B.Cu | Сумма |
|---|---|---|---|---|
| 92.0 — горло, вход из блока | 3.92 (2 куска) → **6.33** | 4.26 (2) → **7.00** | 4.59 (2) → **7.00** | 12.8 → 20.3 |
| 95.5 — самое узкое место у паза | 4.25 | 3.67 (2) → **4.61** | 4.25 | 12.2 → 13.1 |
| 97.5 | 4.99 | 3.60 (2) → **5.37** | 5.01 | 13.6 → 15.4 |

**Чем заплачено:**
- GND в проходе C (`bridges.py`): In1 — 2.70 → 0 мм, его заняли VDC и линии термистора; In4 — 0.55 → 1.85 мм. In3 сплошной (4290.7 мм², один кусок), там без изменений.
- VDC на In1 в проходе идёт под медью узла на F.Cu (0.1 мм) примерно 9 мм, это ≈1.5–2 пФ на узел. Раньше дорожка шла в одном слое с медью узла, с зазором 0.25 мм, и начиналась гальванически в петле коммутации. Если связь окажется важнее, VDC можно вести по In4: там над ней сплошная In3 GND на 0.485 мм, но In4 в проходе занят LO C.
- Линии термистора C в проходе теперь между медью узла на F.Cu (0.1 мм) и на In2. Фильтр C14 100 нФ у U1+ на месте (01 S10).

**Проверки** (kicad-cli 10.0.3):
- DRC: 0 ошибок, 0 неразведённых, 0 расхождений со схемой;
- ERC: 9 ошибок (база), все 51 замечание те же, что до правок;
- `hv.py`: 24 (как было);
- перекрытий корпусов нет (новых деталей нет).

**Ответы владельцу, без правок платы:**
- **S7, 100 нФ у VDD драйверов.** Места нет. Под выводом 5 стоят виа +12V (134.0, 110.5) и GND (133.25, 111.5), рядом C1.2 и C119. C1–C3 (0805, 10 мкФ) и так вплотную: от корпуса до корпуса драйвера 0.07 мм, дорожка до VDD 2.3 мм. Оставлено как есть.
- **S3, фильтр OCP.** По схеме R42/R43/R56 120 Ом и C37/C39/C64 100 нФ, это 13 кГц; на платах, по словам владельца, ≈100 кГц. Ток к моменту выключения рассчитан так: порог ±185 А (01 S3), выход усилителя ограничен на ±275 А (6 мВ/А, середина 1.65 В), плюс ≈0.3 мкс на компаратор, BKIN, драйвер и ключ.

  | di/dt | 13 кГц | 100 кГц | 1 МГц (до RC АЦП) |
  |---|---|---|---|
  | 10 А/мкс (перегрузка) | 304 А | 208 А | 194 А |
  | 50 А/мкс | 848 А | 296 А | 228 А |
  | 150 А/мкс (КЗ на кабеле) | >2000 А | 529 А | 312 А |

  Выводы:
  - 100 кГц достаточно для перегрузки и мягкого КЗ через обмотку.
  - Для КЗ на выходе нужен отвод на компаратор до RC: с выхода усилителя через 100 Ом / 1–2.2 нФ. Фильтр 100 кГц остаётся только для АЦП. Это правка листа OCP — решает владелец.
  - С INA241 (полоса 1.1 МГц) при 150 А/мкс получается 276 А вместо 312.
- **Снабберы: 0612 не достать; если занять зону керамикой VDC–GND, будет ли толк?** Почти нет.
  - Места LS-снаббера стоят между узлом и GND, места HS — между VDC и узлом; керамику VDC–GND туда не поставить. Без места HS-снаббера встаёт одна 1206 на фазу (перебор `strip_plan.py`).
  - По модели 07 P11 она даёт −1…−2 В на кристалле; место HS-снаббера — −9…−12 В на верхнем HS. Керамика ещё и не гасит звон.
  - Предложение: места оставить, а вместо 0612 ставить на те же пэды 2 × 0805 параллельно (2 × 1 Ом = 0.5 Ом, например 0805 0.25–0.5 Вт с повышенной мощностью) или 3 × 0603. Пэды 1.18 × 3.40 мм с зазором 0.50 мм принимают оба варианта, плату менять не нужно. Индуктивность двух 0805 в параллель ≈0.4 нГн против ≈0.3 нГн у 0612.
- **CAN (03 E12):** не развязываем, дополнительные элементы — на соединительной плате. На этой плате ничего не меняется.
- **INA240 при 72/84 В:** рабочий синфазный диапазон −4…80 В, предел 90 В. На стенде при 48 В и 120 А выброс узла 83–87 В (01 S1): это выше рабочего диапазона, но в пределах выживания. При 72–84 В шина выходит за 80 В уже по постоянному напряжению. Пин в пин подходит **INA241A2**: 20 В/В, SOIC-8, та же распиновка, −5…110 В (предел −20…120 В), полоса 1.1 МГц. Замена — одна строка в `sch_rev01_f.py`.

**Ждут решения владельца после 2026-10-19:**
1. Механика +4 мм (без изменений).
2. INA240A1 или INA241A2 — для 72 В.
3. S3: отвод на компаратор до RC.
4. Снабберы: R из 2 × 0805 на пэдах 0612.
5. Остальное из списка раунда 2: крепёж, отверстия D-пэдов, Y-конденсаторы, R_on, норма ЭМС, 24 места < 0.5 мм, поле виа узла B.
6. E6: «бухта» меди узла C на In2 и B.Cu под пазом (x 116.5–121.25, y 97.5–104.25). Это тупик, ток туда не идёт, а до J6.2 (VDC) от неё 0.26 мм на In2. Её можно отдать под GND с рядом виа — по предложению 03 E6, сечение прохода от этого не меняется.

### Решения владельца 2026-10-19 (второй ответ) и анализ растекания тока в силовой меди

> **Поправка (раунд 3, 11 P15).** Абсолютные сопротивления и пики |J| в этом разделе посчитаны первой версией `cflow.py` и
> занижены в 1.3–2.4 раза: пэд каждой виа был связан со стаканом целиком, и поля виа замыкались. Решения и относительные
> изменения остаются в силе. Верные числа — в разделе «Ревью ветки `rev0.1-plus4`, раунд 3».

**Решения:**
- **INA240A1 остаётся; при шине 72 В меняется на INA241A2.** INA241A2: SOIC-8, та же распиновка, 20 В/В, синфазное −5…110 В. Это записано в поле Replacement у U4, U9, U12 — в схеме и на плате (`sch_rev01_f.py`).
- **S3:** отвод на компаратор до RC не делаем — владелец опасается звона и ложных срабатываний, места под второй фильтр нет. Остаётся фильтр ≈100 кГц, как на платах.
- **E6** («бухта» узла C под пазом): отдать можно, но пока ждём.
- Виа (120.25, 77.5), сдвинутая в F15, помечена `(free yes)` — как прочие виа сшивки; `pcbedit.add_via(..., free=True)`.

**R снабберов из 2 × 0805 на пэдах 0612 — мощность.** Модель: фронт узла за 6–10 нс через L 1.1 нГн, C 4.7 нФ, R 0.47 Ом,
два фронта за период 20 кГц. Сюда добавлена энергия звона ½·L_ext·I² (0.75 нГн, синус с пиком 120 А, в среднем ≈2.7 мкДж за период).

| Шина | На снаббер, Вт | На каждый 0805 | Верхняя граница C·V²·f |
|---|---|---|---|
| 48 В | 0.15–0.20 | 0.08–0.10 | 0.22 |
| 72 В | 0.28–0.39 | 0.14–0.20 | 0.49 |
| 84 В | 0.36–0.51 | 0.18–0.26 | 0.66 |

- Пиковый ток цепочки — 26–72 А на единицы наносекунд, по 13–36 А на резистор.
- Обычный 0805 (0.125 Вт) годится только для 48 В: у ключей плата горячая, и выше 70 °C номинал снижается.
- Для 72 В нужны импульсостойкие 0805 с номиналом 0.4–0.5 Вт — классы Panasonic ERJ-P06 и ROHM ESR10. Номинал и наличие сверить; например, 2 × 1 Ом.
- Нагрев проверить тепловизором (уже в списке стенда).

**Анализ растекания тока** — `tools/rev01_layout/cflow.py` (модель) и `cflow_cases.py` (случаи).
- Медь цепи разбита на сетку 0.1 мм (у VDC и GND — 0.15 мм) по каждому слою: 35 мкм, 0.49 мОм на квадрат.
- Виа и сверлёные пэды — стаканы с металлизацией 25 мкм, высоты по стеку.
- Ключи WMB043N10HGS стоят по два параллельно, у каждого R_ds 4.3 мОм. Ток 100 А постоянный.
- Пути: узел → пэд шунта (проводит LS или HS); 11 банок → стоки HS одной фазы; истоки LS одной фазы → банки.

| 100 А, медь без ключей, мОм | C | B | A |
|---|---|---|---|
| Узел → шунт, LS / HS | 0.44 / 0.57 | 0.24 / 0.38 | 0.42 / 0.56 |
| VDC: банки → стоки HS | 0.38 | 0.36 | 0.56 |
| GND: истоки LS → банки | 0.27 | 0.16 | 0.17 |

- Параллельные ключи делят ток 48.5 / 51.5 А на узле и 50.7 / 49.3 А по VDC и GND. Делёж задаёт в основном R_ds, а не медь.
- **В проходах ток узла по слоям делится ровно** (y 95.5, проводит LS):
  - C — F / In2 / B: 32 / 35 / 33 %;
  - B — F / In1 / In2 / B: 22 / 26 / 27 / 25 %;
  - A — 27 / 22 / 21 / 30 %.
- **У шунта всё сходится на B.Cu**, ведь шунт стоит на нём. На y 100 B.Cu несёт 51 / 49 / 66 %. Пик плотности у пэда шунта при 100 А: C 1141, B 1204, **A 2638 А/мм²**. Всё входит в один угол пэда, остальные стороны пэда без виа.
- **У фазы A** перед шунтом путь режут линии термистора A:
  - виа +3.3V (159.26, 101.25) в 1.9 мм от пэда R52.2;
  - U3+ и +3.3V на In2;
  - +3.3V на In4.
  
  In1 и In2 ниже y 100.5 почти без тока. Поле виа узла A x 163–169, y 99–103 (63 шт.) стоит в тупике за шунтом, по 0.2 А на виа и меньше. Без него медь хуже на 2 %.

Что стоит каждый слой — на сколько вырастет сопротивление меди без него (пэды остаются):

| | In1 | In2 | In3 | In4 | B.Cu |
|---|---|---|---|---|---|
| Узел C / B / A | +8 / +23 / +17 % | +44 / +31 / +13 % | — | +5 / +6 / +5 % | путь обрывается |
| VDC C / B / A | +3 / +3 / +2 % | +91 / +92 / +117 % | — | +3 / +3 / +2 % | +40 / +40 / +55 % |
| GND C / B / A | +33 / +28 / +29 % | +1 / +3 / +3 % | +78 / +81 / +75 % | +28 / +22 / +22 % | +1 / +4 / +4 % |

- Внутренние слои почти без пользы в двух местах:
  - островки узла на In4 в блоке;
  - колонки VDC на In1 и In4.
  
  Им некуда отдать ток. Узел на In4 дальше блока не идёт: в проходах In4 — GND с LO, HO и линиями термистора. In1 и In4 верхней полосы — GND.
- Если бы дорожки (HO/SW, LO, термистор) не резали островки узла на In1/In4, медь узла была бы меньше на 9 / 16 / 9 %. Для колонок VDC — на 0.2 %. Эти дорожки проложены внутри узла ради петли затвора (стенд, п. 1), трогать их ради 9–16 % не предлагаю.
- У фазы C In1 в блоке даёт лишь +8 %: в проходе C на In1 GND, VDC и линии термистора. Если сделать In1 узлом в проходе C, как у B и A, медь узла C станет меньше на 10 %, но VDC и линии термистора придётся вести по In4 вместе с LO.

**Предложение: новые виа сшивки** — 0.6/0.3, `(free yes)`, без перестановки деталей. Места подобраны по разности потенциалов слоёв и законны по правилам проекта:
- 0.2 мм до чужих дорожек и виа;
- 0.5 мм до чужих пэдов;
- не под корпусами;
- 0.55 мм до края.

Список — `tools/rev01_layout/data/cflow_vias.json`. На копии `b2f3c90` все 42 виа вместе дают DRC 0 / 0 / 0 и `hv.py` 24 (как было); In3 остаётся одним куском. **Не применено.**

| Путь | Где | Виа | Медь |
|---|---|---|---|
| VDC C / B / A | вход в колонку стока: верх колонки y 74.5 и полоса VDC над ней | 5 / 6 / 6 | −11 / −12 / −17 % |
| Узел A | вокруг пэда R52.2, не трогая линии термистора | 5 | −11 % (LS), −9 % (HS); пик 2638 → 2080 А/мм² |
| Узел C | у пэда R7.1 снизу слева | 2 | −2 % |
| Узел B | — | 0 | законных мест у R9.2 нет |
| GND C / B / A | верх полосы GND, y 70–74 | 6 / 6 / 6 | −6 / −2 / −2 % |

- **Самое выгодное — фаза A с переделкой линий термистора.**
  - Если увести с подхода к шунту виа +3.3V (159.26, 101.25) и дорожки U3+ и +3.3V на In2/In4, медь узла A станет меньше на 15 %.
  - Если ещё поставить 6 виа вокруг пэда R52.2, медь узла A станет меньше на 27 % (LS) и 21 % (HS), а пик плотности упадёт с 2638 до 1104 А/мм². Это оценка сверху: вырезы в окне x 155.5–162, y 99–104.6 я засыпал медью целиком.
  - Тупиковое поле виа x 163–169 можно одновременно отдать под E6.
- Остальное даёт по несколько процентов. Сопротивление меди на 100 А — 0.16–0.57 мОм на путь, а R_ds двух ключей в параллель — 2.15 мОм. Выигрыш виа виден в нагреве меди у шунта и на входе в колонки, а не в КПД.

### Перестановки по анализу растекания тока (`lay_P4d.py`), 2026-10-19

> **Поправка (раунд 3, 11 P15).** Абсолютные сопротивления и пики |J| в этом разделе посчитаны первой версией `cflow.py` и
> занижены в 1.3–2.4 раза: пэд каждой виа был связан со стаканом целиком, и поля виа замыкались. Решения и относительные
> изменения остаются в силе. Верные числа — в разделе «Ревью ветки `rev0.1-plus4`, раунд 3».

Решение владельца: «делаем всё»; In1 узлом в проходе C — «по возможности». Скрипт `tools/rev01_layout/lay_P4d.py` — шаг 9
`plus4.sh`. Картинки «до/после» и таблица — `cflow_figs.py`; отчёт — в документе Claude Docs «Растекание тока в силовой
меди rev0.1-plus4».

| № | Что сделано |
|---|---|
| F19 | **Фаза A, подход к шунту R52.2.** Линии термистора A (+3.3V, U3+) идут по In2 вплотную к пазу (x 162.7 / 163.3), а не по середине прохода A. +3.3V входит в плоскость +3.3V на In2 ниже зоны узла. U3+ уходит влево по её верху (y 105.6) к прежней трассе. Сняты виа +3.3V (159.26, 101.25) и (156.4, 104.5) и кусок +3.3V на In4. Снято тупиковое поле виа узла A: 81 виа в x 162.5–168.5, y 98.75–102.25; зоны остались (E6 ждёт). Виа SW драйвера A сдвинута (162.25, 103.75) → (161.75, 103.75). У пэда R52.2 поставлено 6 виа узла |
| F20 | **Виа сшивки, 26 шт., `(free yes)`.** VDC на входе в колонки стока: 5 / 6 / 6 (C / B / A). GND у верха полос: 6 в C, 1 в A. Узел C у R7.1: 2 |

Из первого набора сняты 11 виа GND фаз B и A, стоявшие выше полос GND (y < 71.25). На F.Cu и B.Cu там VDC, так что виа связывала
только и так сплошные In1/In3/In4: GND не выигрывал, а VDC терял (VDC B 0.314 → 0.337 мОм). Модель считает цепи по одной и
этого не видела — показал пересчёт платы после перезаливки.

**Не сделано: In1 узлом в проходе C** (оценка −10 % меди узла C). Для этого из In1 в проходе надо убрать линии термистора C. Им
негде пройти: из блока к проходу есть только полоса справа от массивов виа стоков (x 125.6–128.2). На In4 её занимает пара
HO/SW петли затвора, а в самом проходе на In1 справа кластер виа узла и кольцо J1.

**Результат** — пересчёт по платам после перезаливки зон, `9005041` → сейчас:

| Путь, 100 А | Медь, мОм | Пик на B.Cu, А/мм² |
|---|---|---|
| Узел A → шунт, LS / HS | 0.423 → 0.320 (−24 %) / 0.558 → 0.455 (−18 %) | 2638 → 1303 |
| Узел C → шунт, LS / HS | 0.440 → 0.432 / 0.573 → 0.565 (−2 %) | 1141 → 1039 |
| Узел B | без изменений (у R9.2 законных мест нет) | 1204 |
| VDC C / B / A | 0.379 → 0.338 (−11 %) / 0.356 → 0.314 (−12 %) / 0.564 → 0.468 (−17 %) | — |
| GND C / B / A | 0.268 → 0.256 (−4 %) / 0.161 → 0.162 (+1 %) / 0.166 → 0.167 (+1 %) | — |

GND фаз B и A чуть хуже: новые виа VDC прорезают плоскости GND на In1/In3/In4.

**Проверки:**
- DRC: 0 ошибок, 0 неразведённых, 0 расхождений;
- ERC: 9 (база);
- `hv.py`: 24;
- In3 одним куском;
- отрезки под 0/45/90°, новых изломов 90° нет;
- виа по Р8 прежние, кроме полосы GND фазы C: 94 → 98.

### E6: тупиковая медь узла → GND (`lay_P4e.py`), шунт B — без изменений, 2026-10-19

> **Поправка (раунд 3, 11 P15).** Абсолютные сопротивления и пики |J| в этом разделе посчитаны первой версией `cflow.py` и
> занижены в 1.3–2.4 раза: пэд каждой виа был связан со стаканом целиком, и поля виа замыкались. Решения и относительные
> изменения остаются в силе. Верные числа — в разделе «Ревью ветки `rev0.1-plus4`, раунд 3».

Решение владельца: «1 делаем, 2 нет». Скрипт `tools/rev01_layout/lay_P4e.py` — шаг 10 `plus4.sh`.

| № | Что сделано |
|---|---|
| F21 | Из зон узла вырезаны два тупиковых куска, на их месте — зоны GND (зазор 0.6 мм, как у зон узла): **фаза A** — угол справа от прохода под пазом (x > 163.5, y 98.25–104.25) на F.Cu и B.Cu, у J7 и под головкой винта; **фаза C** — «бухта» под пазом (x < 121.25, y 97.5–104.25) на In2 и B.Cu, у J6.1/J6.2 (VDC на соединительную плату). Виа GND `(free yes)`: ряд из 5 между медью узла и краем и ещё 3 в углу A, две в бухте C (других свободных мест там нет) |

| | Фаза A | Фаза C |
|---|---|---|
| Медь узла в 1 мм от контура (все слои), мм² — с ошибкой: дуги пазов заменены хордами (13 E22); у внешнего контура меди узла не осталось, вместе со стенками пазов −62 / −53 % | 14.9 → 3.0 | 16.4 → 4.4 |
| Медь узла под головкой винта (r 4.25 от центра паза), мм² | 29.9 → 17.4 | 35.1 → 22.4 |
| Медь узла на B.Cu (к радиатору), мм² | 217 → 185 | 204 → 176 |
| От меди узла до выводов разъёма | J7.1–4 (GND): 0.61 → 2.48 мм | **J6.1–4 (VDC): 0.25 → 1.73 мм** |
| Медь узла → шунт, LS / HS (`cflow.py`), мОм | 0.320 → 0.323 / 0.455 → 0.458 (+0.9 %) | 0.432 → 0.433 / 0.565 → 0.566 (+0.2 %) |

- У края и под винтами остаётся медь самих проходов у пазов. Полный E6 (узел ≥ 1.5 мм от любого контура) срезал бы её, и медь
  узла C выросла бы на 12 %, поэтому он не сделан.
- Тепловая роль снятых кусков мала: ток через них не шёл. Боковая теплопроводность такого куска меди 35 мкм — около 0.02 Вт/К
  на слой, а через 0.1 мм препрега в сплошные GND-слои под ним уходит примерно в 5 раз больше. Сама медь осталась, теперь она GND.
- Проверки: DRC 0 / 0 / 0; `hv.py` 24; новые куски GND связаны виа; In3 одним куском; цепочка с `515455d` даёт ту же плату.

**Шунт фазы B оставлен как есть** (решение владельца). Разбор:
- рядом с пэдом R9.2 законных мест под виа нет;
- выигрыш дали бы только виа в самом пэде шунта — заполненные и закрытые (IPC-4761 VII), с переносом бутстрепного диода D2 с F.Cu над шунтом: медь узла B −8 % (LS), пик у шунта 1204 → 874 А/мм²;
- то же для A — −9 %, для C — −2 %.

К этому стоит вернуться, если для отверстий D-пэдов будут заказаны заполненные виа.

### Ревью ветки `rev0.1-plus4`, раунд 3: правки и исправленная модель тока

Ревью — `docs/reviews/11` (силовая часть, P15–P20) и `13` (ЭМС, E19–E27). Ответы — `12` и `14`. Схема — `sch_rev01_g.py`,
плата — `lay_P4f.py` (шаги 11–12 `plus4.sh`).

| № | По замечанию | Что сделано |
|---|---|---|
| F22 | 13 E19 | C134 — 100 нФ, 100 В, X7R, 0805 — у J6 на B.Cu, (118.75, 101.6), горизонтально. Пэд VDC идёт дорожкой B.Cu в J6.1, пэд GND — в карман GND E6, со своей виа (116.85, 101.6). Контур корпуса начинается с y 100.62, на уровне шунтов, вне зоны радиатора блока (Р1). В схеме — на корневом листе у J6 |
| F23 | 13 E24, E26 | C37 / C39 / C64 100 нФ → **15 нФ** (с R 120 Ом это 88 кГц, как на платах rev0; решение владельца). R50 (терминация CAN) — **DNP**: терминация переезжает на соединительную плату |
| F24 | 11 P16 | Вывод 4 (NC) U4 / U9 / U12 соединён с GND. INA241A2, замена при 72 В, требует этого по даташиту; INA240 допускает. В символе `Logic_My:INA240A1D` вывод 4 стал passive и видимым. На плате пэд 4 соединён перемычкой B.Cu с пэдом 3 (REF2 = GND) |

**`cflow.py` исправлен (11 P15).**
- **Ошибка.** Стакан виа был связан с медью слоя по всему пэду r 0.3 мм. `kpcb` не читает размер виа, поэтому все виа шли как 0.6 мм. В полях виа узла (0.5/0.3 с шагом 0.5 мм) диски перекрывались и замыкали соседние стаканы. Сопротивление выходило заниженным в 1.3–2.4 раза и падало при мельчении сетки.
- **Исправление.**
  - Размер виа берётся из текста платы.
  - Стакан связан с медью только у стенки: r = d/2 + 25 мкм = 0.175 мм.
  - Сетка: 0.05 мм для узла, 0.1 мм для VDC/GND. При шаге 0.1 → 0.05 мм результат меняется на 2.5–5 %.
  - Вместо пика |J| в одной клетке (в углу пэда это особая точка, она растёт с сеткой) теперь две меры: потери в меди в 2 мм от пэда шунта и 99-й перцентиль |J| в кольце 0.2–0.5 мм вокруг пэда на B.Cu (`cflow.near_pad`).
  - Числа совпали с независимым расчётом ревьюера (11 P15).
- **Точность.** Абсолют зависит от того, как моделировать стакан: у поля 131 виа узла B — от 0.46–0.48 мОм (отверстия вырезаны, расчёт ревьюера) до 0.58 мОм (связь у стенки), у A и C разброс меньше. Сравнение фаз и вариантов от этого не меняется.
- Все таблицы ниже — исправленной моделью (`cflow_report.py`), 100 А постоянного тока, R_ds 4.3 мОм на ключ.

| Медь, мОм, 100 А | `50ad933` | `b2f3c90` (F15/F16) | `bd1f33e` (F19/F20) | `b78f01b` (E6) и сейчас |
|---|---|---|---|---|
| Узел C → шунт, LS / HS | 0.668 / 0.817 | 0.581 / 0.727 | 0.570 / 0.716 | 0.577 / 0.724 |
| Узел B → шунт, LS / HS | 0.579 / 0.737 | 0.579 / 0.737 | 0.579 / 0.737 | 0.579 / 0.737 |
| Узел A → шунт, LS / HS | 0.681 / 0.831 | 0.681 / 0.831 | 0.508 / 0.657 | 0.517 / 0.667 |
| VDC C / B / A | 0.384 / 0.364 / 0.575 | то же | 0.344 / 0.325 / 0.482 | 0.344 / 0.325 / 0.482 |
| GND C / B / A | 0.292 / 0.181 / 0.186 | 0.291 / 0.181 / 0.186 | 0.282 / 0.183 / 0.188 | 0.282 / 0.183 / 0.188 |

| У пэда шунта, 100 А | `50ad933` | сейчас |
|---|---|---|
| Потери в меди в 2 мм от пэда, Вт: C / B / A | 1.15 / 1.12 / 2.50 | 1.07 / 1.12 / 1.19 |
| |J| в кольце 0.2–0.5 мм, перцентиль 99, А/мм²: C / B / A | 959 / 954 / 2457 | 884 / 954 / 1037 |

Что изменили правки, по отдельности:
- **F15/F16 (VDC на J6, линии термистора C):** узел C −13 % (LS) / −11 % (HS). Раньше в CHANGELOG этого числа не было.
- **F19 (фаза A):** узел A −25 % (LS) / −21 % (HS). У шунта A потери 2.50 → 1.17 Вт, теперь как у B и C.
- **F20:** VDC −10 / −11 / −16 % (C / B / A). GND C −3 %; GND B и A +1 %: их прорезают виа VDC.
- **E6:** узел A +1.8 / +1.4 %, C +1.3 / +1.0 % (LS / HS). Раньше я писал +0.9 / +0.2 %.

Что сделано:
- Узел A у шунта больше не выделяется.
- **Фаза B не лучшая:** все три фазы по меди почти равны, 0.52–0.58 мОм (LS). Раньше я писал, что B лучшая.

**Ценность слоёв** — на сколько вырастет сопротивление, если оставить на слое только пэды (`b2f3c90`, C / B / A):

| | In1 | In2 | In3 | In4 | B.Cu |
|---|---|---|---|---|---|
| Узел | +6 / +28 / +18 % | +44 / +30 / +15 % | — | +3 / +4 / +3 % | путь рвётся |
| VDC | +3 / +3 / +2 % | +88 / +90 / +116 % | — | +3 / +3 / +2 % | +39 / +40 / +55 % |
| GND | +31 / +26 / +27 % | +2 / +3 / +4 % | +79 / +86 / +79 % | +26 / +21 / +20 % | +2 / +4 / +4 % |

Сейчас (после F19/F20, E6 и C134), C / B / A:

| | In1 | In2 | In3 | In4 | B.Cu |
|---|---|---|---|---|---|
| Узел | +6 / +28 / +23 % | +45 / +30 / +23 % | — | +3 / +4 / +4 % | путь рвётся |
| VDC | +4 / +4 / +3 % | +90 / +90 / +97 % | — | +5 / +5 / +3 % | +37 / +38 / +48 % |
| GND | +30 / +27 / +27 % | +2 / +3 / +4 % | +72 / +85 / +74 % | +25 / +21 / +21 % | +3 / +4 / +4 % |

После перекладки фазы A её In1 и In2 у шунта заработали: +18 / +15 → +23 / +23 %.

Ток узла в проходе (y 95.5) делится по слоям:
- C — F / In2 / B: 32 / 35 / 32 %;
- B — F / In1 / In2 / B: 23 / 28 / 26 / 23 %;
- A — 27 / 20 / 25 / 29 %.

**Тепловой бюджет** (по 11 P15). Медь узла при 85–106 А RMS (120–150 А амплитуды):
- при 20 °C — 4.3–7.3 Вт на фазу, при среднем сопротивлении LS и HS ≈ 0.65 мОм;
- в горячем состоянии медь хуже на ~23 %, до ~9 Вт;
- шунт WSLF2512 300 мкОм добавляет 2.2–3.4 Вт.

Это в 1.5–2 раза больше, чем следовало из прежних чисел. Проверить тепловизором (стенд).

**Ещё по ревью:**
- **11 P17.**
  - Виа сшивки VDC на верху колонок стока (y 74.5) сужают In3 GND над окнами стоков HS: 2.45 → 1.35 мм. Цена по ВЧ — ≤ 0.02 нГн. Новых виа в полосе y 73–75.6 не ставить.
  - Виа (164.5, 73.0) у C133 оставлена: без неё VDC A хуже на 3.5 % (0.482 → 0.499 мОм).
- **11 P18, 13 E21/E22.** Виа VDC (120.0, 92.3) и U3+ стоят в 0.30 мм от стенок пазов, под головками винтов. Вопрос изоляции крепежа — втулки с буртиком (07 P12, 09 E14), решает владелец. Отвести виа нельзя: угол полосы GND между C103 и пазом — 0.87 мм по высоте.
- **11 P19.** R снаббера 2 × 0805 на пэдах 0612:
  - класс — антиимпульсный ≥ 0.5 Вт (ERJ-P06), 2 × 1 Ом; ESR10 при 84 В без запаса;
  - паста: футпринт 0612 даёт её на весь пэд 1.18 × 3.40 мм, нужен трафарет под выводы 0805 или свой футпринт «2 × 0805».
  
  Решает владелец.
- **11 P20.** Предохранителя на VDC к J6 нет. При КЗ на соединительной плате дорожка 0.4 мм внутри прохода C станет плавкой вставкой (~15–30 А). Предохранитель 1–2 А, 100 В+ — на входе соединительной платы или здесь в разрыв VDC у J6. Решает владелец.
- **13 E20.** In1 GND разделён на два куска (1709 + 1885 мм²; был один, 3594 мм²): проход C на In1 занят VDC и линиями термистора. Сигналов с опорой на In1 через разрез нет, In3 цел. Р13 считать по In1 + In3 + In4: по четырём проходам 10.95 мм (было 11.25).
- **13 E24.** Фильтр ≈100 кГц пропускает к компаратору OCP только выбросы длиннее ≈2 мкс. Выброс 50 нс от звона 130 МГц ослабляется примерно в 30 раз.
- **13 E25, 11 P16.**
  - INA241A2 при 48 В — только опция, решение по замеру (владелец).
  - INA240 при 48 В работает с запасом 3–7 В до предела 90 В (стенд 83–87 В). Снизу по оценке −5…−10 В против предела −6 В.
- **13 E26.** Условие отказа от развязки CAN: все узлы сети отнесены к минусу той же батареи — подтверждает владелец.

**Проверки:**
- DRC: 0 ошибок, 0 неразведённых, 0 расхождений;
- ERC: 9 ошибок (база), все 51 замечание те же;
- `hv.py`: 24;
- перекрытий корпусов нет;
- цепочка `plus4.sh` с `515455d` даёт ту же плату и схему.

**В список стенда добавлено:**
- VDC на J6.1 относительно J6.11 коаксиалом: ожидание ≤ 0.4 В на 130 МГц, с C134 — меньше; сравнить с rev0 (13);
- выход U4 / U9 / U12 (вывод 5) и вход компаратора OCP на фронтах при 48 В и 120 А: длительность выброса против ≈2 мкс (13);
- U.8 и U.1 относительно U.2 при 48 В, 60 и 120 А на выключении LS и HS: максимум против 80 / 90 В, минимум против −4 / −6 В (11);
- шум АЦП каналов температуры A и C под ШИМ: A должен быть заметно чище (13);
- тепловизор при 80–100 А RMS: проходы и шунты трёх фаз греются одинаково; медь узла 4–7 Вт плюс шунт 2–3.4 Вт на фазу (11);
- нагрев R снаббера 2 × 0805 при 72 В: ≤ 0.2 Вт на резистор (11);
- изоляция: мегаомметр, включая левый паз с виа VDC в 0.30 мм от стенки (11);
- частота звона после виа сшивки VDC: H-зонд по фазам (13).

**Ждут решения владельца после раунда 3:**
1. Опора узлов CAN (13 E26).
2. Предохранитель на VDC к J6 (11 P20).
3. R снаббера: тип (ERJ-P06) и трафарет под 2 × 0805 (11 P19).
4. Втулки в пазах, с учётом U3+ и виа VDC у пазов (07 P12, 09 E14).
5. Открытое с раунда 2:
   - механика +4 мм;
   - Y-конденсаторы (E13);
   - снабберы на первых платах (E15);
   - R_on для 72/84 В;
   - норма ЭМС;
   - отверстия D-пэдов.

### Решения владельца 2026-10-20 (после раунда 3): места под Y, снабберы 2 × 0805, предохранитель, нормы ЭМС

Схема — `sch_rev01_h.py` (корневой лист и Phase_A), плата — `lay_P4g.py` (шаги 13–14 `plus4.sh`). Новый файл
`Power.kicad_dru` (правило CHASSIS).

| № | По замечанию | Что сделано |
|---|---|---|
| F25 | 11 P20 | Предохранитель на линии VDC к J6 был поставлен на эту плату (`1c7dd31`, 2410 у банок). **Владелец отменил: предохранитель — на соединительной плате**, отключающую способность владелец продумает там. Плата и корневой лист возвращены к `d30010b` |
| F26 | 09 E13 | Места под Y-конденсаторы между вводными втулками J4 / J5 (DNP): H5 — металлизированное M3 с кольцом виа, цепь `/CHASSIS`, (142.75, 35.5). **Винт — в радиатор, он и есть корпус, длина меньше 1 см.** C135 VDC → CHASSIS и C136 GND → CHASSIS, 1812, B.Cu ниже H5 вне круга головки винта r 3.5. CHASSIS держит 2 мм до всех цепей на всех слоях: правило в `Power.kicad_dru` и местные зазоры 2.0 на пэдах (местные значения KiCad ставит выше правила) |
| F27 | 11 P19 | Снаббер R: вместо одного 0612 (их не достать) — **два 0805 параллельно**, 2 × 1 Ом = 0.5 Ом (было 0.47). R100–R105 стали 0805, к каждому добавлен R124–R129 (лист Phase_A, по одному символу на LS и HS, по экземпляру на фазу). На плате пара стоит поперёк цепочки в пределах прежних пэдов 0612: R_0805_2012Metric по длине цепочки занимает те же ±1.425 мм, детали — на ±0.96 мм поперёк, между корпусами 0.67 мм, контуры не перекрываются. Одноимённые пэды пары соединены дорожкой. Трафарет теперь стандартный, под 0805. Тип — ERJ-P06J1R0V или равный антиимпульсный ≥ 0.5 Вт (11 P19). По-прежнему DNP |

**Места под Y (F26).**
- Номиналы по 09 E13: 2.2–4.7 нФ, класс Y2 или X7R ≥ 1 кВ в 1812. Конкретную деталь Y2 1812 не выбирал.
- Механика:
  - винт M3 в H5 — головка и шайба до r 4 мм; до края платы 0.56 мм от пэда;
  - от центров J4 / J5 — 10.5 мм, проверить с наконечниками кабелей батареи.
- Цена: отверстие r 5.2 мм на всех слоях между втулками. Путь «втулка → банки» по меди: VDC 0.047 → 0.055 мОм, GND 0.084 → 0.099 мОм (+17…18 %, +0.01 мОм).
- Сумму Y учесть в контроле изоляции (09 E13).

**Предохранитель — заметки для соединительной платы** (поиск 2026-10-20, по даташитам):
- 1206 на 125 В DC бывают только быстрые, I²t 0.0075–0.15 А²с. Бросок при подключении входных ёмкостей, по оценке ~0.05 А²с (4.7 мкФ, 84 В, 0.3 Ом), их сожжёт.
- Ожидаемый ток КЗ со стороны этой платы, моя оценка, — до ~1 кА: банки разряжаются через линию ≈ 43 мОм и разъём J6.
- Bel 0679L1000 — 2410, 1 А, быстрый, 125 В DC, 10 кА при 86 В DC, I²t 0.51 А²с.
- Littelfuse 0452001.MRL — 2410, 1 А, с задержкой, 50 А при 125 В DC, I²t 1.98 А²с. Честен, если ток КЗ ограничен.
- 2 А не брать: I²t 0452002 (8.2 А²с) сравним с плавлением дорожки 0.4 мм / 35 мкм (оценка 7–16 А²с).
- На этой плате у J6 2410 не помещается (между пазом и разъёмом 4.7 мм). У банок помещается, ценой VDC C +0.6 % и GND C +0.8 % (`1c7dd31`).

**Остальные ответы владельца.**
- **13 E26, CAN:** все потребители работают от этой же батареи. Развязку CAN не ставим; в следующих ревизиях может понадобиться.
- **11 P18 / 09 E14, пазы:** оставить как есть.
- **Механика +4 мм:** ждём ответа.
- **Снабберы на первых платах:**
  - на испытываемой плате rev0 RC-снабберов нет;
  - 0603 C90, C92…C96 у блока там — керамика VDC–GND 2.2 мкФ (§1.3), а не снабберы;
  - места под снабберы появились только в rev0.1.
  - **Решение:**
    - на части первых плат rev0.1 снабберы ставим. В схеме они остаются DNP, а набор плат со снабберами задаётся в заказе сборки;
    - на rev0 владелец попробует навесной снаббер: 0805 4.7 нФ C0G + 0805 1 Ом прямо на выводы сток–исток LS. Сравнить звон и его частоту с снаббером и без.

**Нормы ЭМС — поиск 2026-10-20** (источники платные, часть цифр не проверена). Владелец: байк, вероятно, внедорожный.
- Детский мотобайк на 48 / 72 В — не игрушка: директива 2009/48/EC ограничивает питание игрушек 24 В. Не EPAC: EN 15194 — педальный ассистент до 25 км/ч. Скорее всего не PLEV: EN 17128 — до 25 км/ч.
- Внедорожный, без омологации — «аппарат» по директиве ЭМС 2014/30/EU:
  - EN 55012 (CISPR 12) на машину целиком;
  - или пара EN IEC 61000-6-3 (излучение) / 61000-6-1 (устойчивость).
- С омологацией L1e — Правила ООН № 10 (UN R10).
- В ЕАЭС ТР ТС 020/2011 касается готового изделия, а не платы.
- Производители контроллеров стандартов почти не называют:
  - Silixcon, ASI, Kelly, VOTOL, VESC — ничего;
  - Fardriver — «CE / FCC» без стандартов;
  - Sevcon Gen4 — EN 12895, EN 55022 класс B, ISO 11452, UN R10, поле 12 В/м.
- **Цель для платы — принята владельцем 2026-10-20:**
  - кондуктивные помехи на проводах батареи — CISPR 25 класс 3 (метод напряжения, два LISN 5 мкГн / 50 Ом на ≥ 100 А) плюс токовые клещи на жгутах. Главный риск — гармоники ШИМ 20 кГц с 8-й по 15-ю, они попадают в ДВ 150–300 кГц;
  - устойчивость: без влияния до 10 В/м, без опасного поведения до 30 В/м;
  - ESD: не меньше 4 кВ контакт / 8 кВ воздух, цель — 8 / 15 кВ без повреждений.

**Проверки:**
- DRC: 0 ошибок, 0 неразведённых, 0 расхождений;
- ERC: 9 ошибок (база; у R124–R129 то же предупреждение о кэше R_Small, что у R100–R105);
- `hv.py`: 24;
- перекрытий корпусов нет;
- `plus4.sh` с `515455d` даёт ту же плату, схему и `Power.kicad_dru`.

### Проход B на In2, углы и ширины дорожек (`lay_P4h.py`), 2026-10-20

Замечание владельца: на In2 у (142, 102) излом 90° и разная ширина дорожки до и после него; линию +3.3V в проходе B
развести с меньшим числом переходов и плотнее, чтобы освободить место полигону у стойки J2. Шаг 15 `plus4.sh`.

| № | Что сделано |
|---|---|
| F28 | **Проход B, In2:** порядок был +3.3V (x 147.2) / U2+ (148.25, 0.5 мм) / HO (149.25). Внизу +3.3V пересекал U2+ перескоком на In4 через две виа. Теперь U2+ / +3.3V / HO на x 148.15 / 148.7 / 149.25, зазоры 0.25 мм, все дорожки 0.3 мм. **Вверху** виа U2+ и +3.3V поменялись местами: U2+ уходит на In2 в (146.55, 92.4), +3.3V обходит её по In1 снизу и уходит на In2 в (147.6, 92.3). Других мест под виа нет: на F.Cu там C105, R32, R2. **Внизу** U2+ поворачивает влево выше +3.3V и идёт по верхней кромке плоскости +3.3V (y 104.25), а не через полигон Phase_OUT B (y 102.25 с изломом 90° у (141.85, 102.25)); +3.3V входит в свою плоскость на x 147.75; виа HO (148.1, 104.0) → (148.45, 103.95), в стороне от SW на In4 и от C8. Виа в проходе 6 → 4 |
| F29 | **Углы и ширины по всей плате.** Сканер теперь сводит концы отрезков с допуском 0.02 мм: так нашлось место у (141.9, 102.3), где концы расходились на 0.005 мм. Исправлены: /TMR1_CH1 F.Cu (148.1, 114.44) — 45°-кусок 0.085 мм давал поворот 90°; /CAN1_TXD_MCU F.Cu (129.75, 133.5) — то же, из rev0; /Driver_3/LO In4 — зигзаг у Т-отвода (122.0, 91.0) и кусок 0.3 мм среди 0.5, теперь ветка идёт от виа (122.75, 90.25) прямо, 0.5 мм; GND F.Cu (154.5, 108.0) 0.3 → 0.5. После правок углов острее 135° и смен ширины в свободных стыках нет |

**Что дало (исправленная cflow, 100 А):** медь Phase_OUT B от шунта R9 до J2 — 0.153 → 0.122 мОм (−20 %).
- Полигон на In2 справа от J2 стал шире примерно на 1 мм вдоль прохода.
- Полоса под прежней линией U2+ (y 102.5–104) присоединилась к полигону.
- На In4 ушёл перескок +3.3V.

**Где ещё можно сблизить дорожки** — проверка 2026-10-20, параллельные линии внутренних слоёв в блоке, зазор 0.3–0.5 мм.
Сужение до 0.2–0.25 мм даёт полигонам 0.1–0.25 мм по ширине:
- линии термисторов C на In1 (x 124.9 / 125.5) и A на In2 (x 162.7 / 163.3) — зазор 0.3;
- пары HO / SW на In4 у верха проходов C и B — зазор 0.5. Их сближение заодно уменьшает петлю затвора;
- SW B / LO A на In4 (x 149.25 / 150.0) — зазор 0.35.

Не делал, решает владелец.

**Ширины по слоям:** вдоль каждой дорожки между пэдами и виа ширина теперь постоянная. У одной цепи на разных слоях ширины разные, это сделано намеренно:
- внутренние линии 0.3 мм;
- подводы к пэдам на F.Cu / B.Cu 0.4–0.5 мм.

**Проверки:**
- DRC: 0 ошибок, 0 неразведённых, 0 расхождений;
- `hv.py`: 24;
- `plus4.sh` с `515455d` даёт ту же плату.

## Ветка `rev0.1-shift3` (от `rev0.1-plus4`, 2026-10-20): длина прежняя, блок на 3 мм ниже

Решения владельца:
- «по увеличению длины на +4 мм отказ»: снаружи инвертора есть дополнительные детали, корпус встаёт впритык.
- Ужаться в зоне МК и сместить блок ключей вниз, освободив место под снабберы. Радиатор можно менять.
- Снабберы: R 1206 («если плотно расставить, должно получиться»). У C HandSolder остаётся, если ничего не меняет.
- J6/J7 смещаются вместе со всеми деталями. Зазор до отверстий 4 мм, если не выйдет — 3.5 мм.
- H3/H4 и вырезы у конденсаторов едут вниз вместе с зоной МК. Прижимная пластина не меняется и должна прижиматься к
  радиатору.

**Как сделано — `shift3.sh`** (с `515455d`). Плата строится в системе координат растяжки на +3 мм: блок, зона МК, J1–J3,
J6/J7, H3/H4 остаются на своих координатах, а верх с 11 банками, J4/J5 и H1/H2 поднят на 3 мм. Последний шаг
(`lay_S3c.py`) снимает 3 мм снизу.
- Контур 53 × 108.76 мм — как у `rev0.1-gnd`.
- Относительно контура блок, зона МК, J1–J3, J6/J7 и H3/H4 сдвинулись на 3 мм вниз. Банки, J4/J5 и H1/H2 остались на месте.
- Плечи контура у винтов прижимной пластины остаются с блоком, поэтому пластина встаёт на блок как раньше
  (`STRETCH_YEDGE=67.9` в `stretch.py`). Это ступенька y 68–70.75 с дугами. Кривые над ней вытянуты вверх на 3 мм.
- Банки C6/C11 от плечевых кривых: 5.46 мм от центра до контура (в `rev0.1-gnd` 5.37).
- Межцентровые: H1/H2 ↔ H3/H4 91.75 → 94.75 мм, J4/J5 ↔ J1–J3 55 → 58 мм.

**Полоса 3 мм между банками и блоком** — план `data/strip_plan_shift3.json`. Ключи `strip_plan.py` записаны в шапке
`shift3.sh`.

| | C | B | A |
|---|---|---|---|
| Снаббер LS: C / R, форма | C112 / R100, L | C113 / R101, L | C114 / R102, I |
| — от вывода R / вывода C до выводов ключа, мм | 1.86 / 0.25 | 1.57 / 0.25 | 1.37 / 1.43 |
| Снаббер HS: C / R, форма | C115 / R103, L | C116 / R104, I | C117 / R105, L |
| — от вывода R / вывода C до выводов ключа, мм | 2.21 / 0.25 | 1.53 / 1.17 | 1.57 / 0.55 |
| 0603 2.2 мкФ | C94 (132.5, 73.8), C92 (132.5, 72.3) | C93 (143.5, 71.3), C90 (150.7, 72.9) | C95 (153.1, 71.2), C96 (167.7, 72.9) |

- **R снаббера** — один 1206 на место, 0.47 Ом, P/N «Resistor SMD 1206 anti-surge 0.5W», посадка HandSolder
  (`sch_rev01_s3.py`). R124–R129 (2 × 0805 из `50a9d8d`) на этой ветке нет.
- **C снаббера** — посадка `C_0805_2012Metric` (стандартные пэды). С HandSolder и у C, и у R место HS B не помещается в
  3 мм, а с HandSolder у R и стандартными у C помещаются все шесть.
  Решение владельца 2026-10-20: «раз иначе не влезает, значит, прототипы будем паять так».
- **Не поместились 1206 1 мкФ в полосе** C125 / C129 / C133. Остались C124 / C128 / C132 в среднем ряду и шесть 0603.
- **0603.** Сначала встали только пять из шести. Чтобы влезла шестая, места двух 0603 фазы C подбираются вместе с её
  снабберами (`JOINT06=C`). Цена: R снабберов C на 0.3 / 0.6 мм дальше от ключей (LS 1.57 → 1.86, HS 1.58 → 2.21).
- Попутно исправлены две ошибки `strip_plan.py`:
  - нижняя граница перебора не учитывала цену пропуска: если вес места больше цены пропуска, хорошие варианты
    отсекались;
  - заливку VDC справа вырезали сами переносимые C95/C96. Теперь план строится на плате, где они убраны.

**Низ платы (`lay_S3c.py`).** Нижний край y 144.5 → 141.5. Под новым краем оказались U7, обвязка входов U6 и ряд виа.
- **U7** (SPI EEPROM, SOIC-8) перенесена на B.Cu под нижний ряд выводов U5, повёрнута на 270°. Порядок её выводов
  совпадает с порядком выводов U5 50–53 (CS, SCK, MISO, MOSI):
  - на F.Cu четыре линии идут лесенкой: CS сворачивает первой, MOSI идёт прямо вниз;
  - у каждой линии одна виа между рядами пэдов U7, дальше по B.Cu в пэд;
  - C54 стоит у вывода VCC;
  - WP и GND уходят виа под угол U5.
- **R79 / R80 / C91 и R54 / R55 / C62** (входы U6) подняты на 2.05 мм вместе со своими дорожками.
  - Виа /SWCLK_IN (126.25, 137.75) оказалась под C91: диагональ перенесена с In2 на F.Cu, виа теперь в (124.5, 136.45).
  - GND-виа C91 и C62 переставлены сбоку от пэдов: (123.5, 137.7) и (131.0, 137.7).
- Виа у края (GND, D8-K, D9-K) y 141.0 → 140.9. Ряд сшивки GND у нижнего края переставлен на новый край, 5 виа.
- Зоны In1–In4 идут по новому краю. Обозначения D8, D9, R44–R47, C40, C41, C43, Y1 стояли под деталями, теперь над ними.
- Разводчик `route.py` (A* по сетке 0.05 мм, только 0/45/90°) нужен для питания U7 / C54. Сигналы EEPROM, SWCLK_IN и
  входы U6 заданы координатами.

**Сшивка VDC / GND (`lay_P4d.py`, `STRIP_DY=3`).** Из 26 мест plus4 законными остались 11. Остальные подобраны заново:
`cflow.best_vias` на плате shift3, затем проверка перезаливкой и `cflow_cases.py`. Всего снова 26 виа.
- У VDC C новых виа нет. Две лучшие режут плоскости GND у полосы GND C: VDC C −1 %, GND C +9 %.
- `geom.py`: дуги контура теперь разбиты на 16 хорд, а не на две (было до 0.2 мм ошибки), учтены кривые Безье плеч (их не
  было вовсе). Из-за этого две виа у дуг плеч сначала прошли проверку и дали ошибку края в DRC.

**Медь, исправленная cflow, 100 А, мОм:**

| Путь | plus4 (`ee0755d`) | shift3 |
|---|---|---|
| Узел C → шунт, LS / HS | 0.577 / 0.724 | 0.577 / 0.721 |
| Узел B → шунт, LS / HS | 0.579 / 0.737 | 0.579 / 0.734 |
| Узел A → шунт, LS / HS | 0.517 / 0.667 | 0.517 / 0.665 |
| VDC C / B / A | 0.344 / 0.325 / 0.482 | 0.365 / 0.331 / 0.547 |
| GND C / B / A | 0.282 / 0.183 / 0.188 | 0.316 / 0.171 / 0.194 |

- VDC A +13 % и GND C +12 % к plus4 — это цена неподвижных плеч: у A стоки HS у правого плеча, у C полоса GND у левого.
  Обе части контура теперь на 3 мм ближе к блоку, чем на plus4.
- Узлы не изменились: блок тот же.
- **Три виа GND у правого паза (164–168, 92): владелец сказал «давай поставим», но выигрыша нет.** Первая оценка была около −9 % GND A,
  по 17 мкОм на виа. После перезаливки и пересчёта GND A 0.194 → 0.194 мОм, у узла A и VDC A тоже без изменений.
  - Почему ошибся: `cflow.via_gain` брал за потенциал 0 медь, не связанную со стоком. В этом месте In1/In4 — тупиковый
    островок GND, и виа лишь присоединяет его.
  - Исправлено: учитывается только живая медь.
  - После исправления на всех шести путях VDC/GND лучшее новое место даёт ≤ 5.6 мкОм (≈1 %). У VDC C места по 4 мкОм, но
    такие виа режут GND C. Поэтому ничего не добавлено.
  - Сшивку этой ветки ошибка не задела: каждый набор проверялся перезаливкой и полным пересчётом.
  - Точки к тому же лежат под шайбой правого винта (r 4.25 от центра паза). Там уже стоят три GND-виа угла E6 (F21).

**Проверки (сборка `shift3.sh` с `515455d`):**
- DRC: 0 ошибок, 0 неразведённых, 0 расхождений со схемой; 1 предупреждение — шелкография C11 у дуги контура, такое же
  есть в `515455d`;
- ERC: 9 ошибок / 51 всего, как в базе;
- `hv.py`: 24, как на plus4;
- `track_scan.py`: углов острее 135° и коротких 45°-кусков нет;
- `plus4.sh` после правок `geom.py` / `strip_plan.py` даёт ту же плату plus4 (дорожки, виа, детали совпадают с `ee0755d`).

**Открыто:**
- Радиатор под новое положение блока относительно контура.

### Пары HO / SW и одна ширина на цепь (`lay_S3d.py`, шаг 16 `shift3.sh`), 2026-10-20

Решения владельца: пары HO / SW сблизить («1 — согласен»), ширину цепей сделать одинаковой («2 — лучше сделать одинаково»).

| № | Что сделано |
|---|---|
| F30 | **HO / SW фаз C и B на In4**, от виа драйвера до верха прохода: зазор 0.5 мм (у B на вертикали 0.35) → 0.25 мм, центры в 0.55 мм. К SW сдвинута HO, углы концентричные; SW и виа на месте. C: HO x 126.05 → 126.30, y 90.65 → 90.40. B: x 144.20 → 144.30, y 90.65 → 90.40. Площадь петли затвора HS на этих участках −31 % (C) и −21 % (B). У фазы A HO на In4, SW на In1, пары на одном слое нет |
| F31 | **Одна ширина на цепь**, по всем слоям, 46 цепей, 205 отрезков. Ширина — та, что уже у большей части длины. Если она нарушает зазор хоть в одном месте цепи, берётся самая узкая ширина цепи (проверено DRC) |

- **0.5 мм:** LO (In4 0.5, подводы 0.4 к выводам расширены); затворы R_g → G ключей (цепи C100–C111, участки 0.3 у C_gs расширены); D8-K, D9-K.
- **0.3 мм:** HO и SW, линии термисторов U1+ / U2+ / U3+, сигналы МК (Hall, ADC_IN, NRST, кварц PH0 / PH1, CAN1_TXD), VCAP_1/2.
  - Temp_PCB_1–3, Current_measure_1–3, ADC_IN_1, BkIN_1 и VDC_MCU (делитель VDC → АЦП) шли в основном 0.5, но у
    выводов МК 0.5 не проходит по зазору, поэтому они целиком 0.3.
- **Не трогал силовые цепи** (GND, VDC, +3.3V, +3.3VA, +12V): у них магистрали и отводы к выводам разной ширины намеренно.

**Проверки:**
- DRC: 0 / 0 / 0;
- углов и смен ширины в стыках нет;
- `hv.py`: 23 (было 24). Ушло R73.1 (ADC_IN_3) — SW A: дорожка SW стала уже. У пэдов R23.2 / R28.2 / R34.2 до линий
  термисторов 0.325 → 0.375 мм;
- `shift3.sh` с `515455d` даёт ту же плату;
- медь силовых путей не менялась.

## Состояние работы на 2026-10-20 (пауза)

Ветка `rev0.1-shift3`, последний коммит — запись этого раздела (до неё `3603f69`). Ветка не слита и не запушена.
- Плата законченная: DRC 0 / 0 / 0, ERC 9 / 51 (база), `hv.py` 23.
- Схема и плата синхронны, F8 не нужен.
- Сборка с нуля — `tools/rev01_layout/shift3.sh` с `515455d`.

Решение владельца: «радиатор будем перерабатывать». Дальше:
1. Радиатор под новое положение блока: блок, зона МК, J6/J7 и H3/H4 на 3 мм ниже относительно контура, банки на месте,
   плечи у винтов прижимной пластины — с блоком.
2. Испытания.
3. Если с радиатором возникнет проблема — прорабатывать схему без снабберов.
