alsizyakin/InvertorPowerNewGen/REV1_TASK.md

# InvertorPowerNewGen — ревизия 1: задание на изменения

Файл для Claude Code. Положить в корень проекта KiCad (`InvertorPowerNewGen/`) и выполнять по разделам, в указанном порядке. Каждый раздел — отдельный коммит.

## 0. Правила

- Проект KiCad 10 (`Power.kicad_pro`, иерархия листов). Работать в ветке `rev1`, исходное состояние не трогать.
- **Не изменять:** ЗПТ (C4…C25 EEUFS1K181, C5/C21/C26…C35/C75…C84, плата `Capacitors/`), `Connector_Board/`, листы `Hall`, `Temperature` (кроме п. 4.3), узел МК U5, CAN, питание 3,3 В, стек платы, силовые втулки J1–J5.
- Все новые символы — в `Lib/Logic_My.kicad_sym` или `Lib/MOSFET_MY`, футпринты — в `Lib/*.pretty`. Внешние библиотеки не подключать.
- После каждого раздела: ERC без ошибок, Annotate без дубликатов, обновление PCB из схемы без потерянных футпринтов, DRC без ошибок в затронутых цепях.
- В конце — `CHANGELOG_rev1.md`: что изменено, по обозначениям, с обоснованием одной строкой.

## 1. Силовые ключи: PDFN 5×6 → TOLT

### 1.1 Компонент

- Прибор: **Infineon IAUS300N10S5N015T** (100 В, R_ds(on) 1,5 мОм макс @10 В; Q_g, Q_rr, C_oss, R_thJC(top) — взять из даташита и записать в CHANGELOG). Корпус **PG-HDSOP-16-2** (TOLT, охлаждение через верхнюю площадку — сток). Выбран 100 В с расчётом на 72-вольтовую (20S, до 84 В) версию.
- Чертёж корпуса: https://www.infineon.com/cms/en/product/packages/PG-HDSOP/PG-HDSOP-16-2/ ; для справки 80-вольтовый аналог того же семейства IAUS300N08S5N012T (1,2 мОм, R_thJC(top) 0,4 K/W макс, Q_g 231 нКл макс) — допустим только для чисто 14S-изделия.
- Запас 100 В при 84 В шины — 16 В: керамика петли коммутации (п. 1.4) обязательна, выброс V_ds измерить на первом включении (п. 5).

### 1.2 Вариант установки — ВЫБРАТЬ ДО НАЧАЛА

Плата 53×109 мм, радиатор заказчика 110×63 мм. Корпус TOLT 9,9×11,7 мм; 6 штук в ряд = 64 мм — в ширину 53 (и в 63) не помещается.

- **Вариант A (по умолчанию): 6 × TOLT, по одному на ключ.** Q1…Q6 остаются, Q7…Q12 удаляются. Один TOLT 1,5 мОм на плечо против нынешних 2 × 4,3 мОм (2,15 мОм) — потери проводимости на ~30 % ниже при том же контуре платы. Драйвер NSD1624 без буферов (Q_g ~230 нКл, R_g 3,3 Ом → перезаряд ~150 нс). Два ряда по 3 корпуса, блок ~33×26 мм.
- **Вариант B: 12 × TOLT, по два на ключ** (класс 200+ A). Требует расширения контура до ~64×130 мм или выноса МК на отдельную плату — не помещается на радиатор заказчика. Выполнять только по явному указанию; тогда дополнительно: буферы на затворы (п. 1.5), C_boot 4,7 мкФ.

Дальше описан вариант A; отличия B помечены.

### 1.3 Символ и футпринт

- Символ: `Lib/MOSFET_MY`, N-MOSFET, выводы по даташиту (стр. 8): **проверить по чертежу** — ожидается: выводы 1–7 исток, 8 затвор, 9–16 сток, верхняя площадка — сток. Пины истока и стока объединить в символе как пассивные группы (как сделано в `IPTG007N06NM5ATMA1.kicad_sym`).
- Футпринт `Lib/MOSFET_MY.pretty/PG-HDSOP-16-2_TOLT.kicad_mod`: по чертежу Infineon; **пэда под верхнюю площадку на меди нет** (охлаждение сверху, к плате площадка не паяется). Контур верхней площадки нанести на `F.Fab` и `F.Courtyard`; добавить keepout-зону высоты компонентов (см. п. 1.6). 3D-модель — STEP с сайта Infineon в `3D/`.
- Обозначения: Q1, Q2, Q3 — верхние ключи фаз C, B, A (по нынешним сеткам: сток VDC, исток Phase_IN соответствующего Current_Sensor); Q4, Q5, Q6 — нижние. Лист `Phase_A.kicad_sch` (3 экземпляра): удалить второй транзистор в каждом плече и его R_g/R_gs.

### 1.4 Размещение и трассировка силовой зоны

- Сохранить структуру: ряд HS (сток = VDC), ряд LS (исток = GND-остров фазы), между ними узел фазы. Ориентация корпусов одинаковая для всех шести; выводы стока (9–16) — к пуру стока, истока (1–7) — к пуру истока, затвор (8) — со стороны драйвера.
- Все шесть корпусов в одной плоскости (общая прижимная пластина): в пределах контура пластины на F.Cu запрещены компоненты выше 2,0 мм; NTC, керамика 0805/1210, резисторы затворов допускаются. Задать keepout-зону «Footprints» на слое `F.Cu` с именем `TOLT_pressure_plate` вокруг блока ключей с полем 1,5 мм, для компонентов выше 2 мм — вручную проверить в 3D.
- Медь: пуры VDC/Phase_IN/GND под стоками и истоками на F.Cu и In1/In2, как сейчас; виа-поля симметрично для всех трёх фаз (одинаковое число виа на плечо, ±10 %).
- Керамика петли коммутации: рядом с каждым плечом между стоком HS (VDC) и истоком LS (GND) — **4 × 2,2 мкФ/100 В 1210** на F.Cu, не дальше 5 мм от корпусов. Это не ЗПТ, а снаббер петли — добавить, несмотря на п. 0.
- Отверстия крепления пластины: 4 × M3 по углам блока ключей, вне пуров, с зазором ≥ 1 мм до меди на всех слоях.

### 1.5 Затворы и драйвер (лист `Driver.kicad_sch`, `Phase_A.kicad_sch`)

- R_g: вместо одного 2,7 Ом — раздельные пути: R_on 3,3 Ом (0805), R_off 1,0 Ом (0805) через диод 1N4148WS (катод к затвору). R_gs 10 kΩ оставить.
- C_boot (C7 и аналоги): 1 мкФ → **2,2 мкФ/25 В X7R 0805**. D_boot: MURA110 (100 В) → **MURA120** или US1D (200 В): при 84 В шины диод видит ~96 В обратного.
- Проверить по даташиту NSD1624 допустимое напряжение SW/VBST с учётом 84 В + выброс; результат — в CHANGELOG.
- Развязка +12 В драйвера (C1 и аналоги): 10 мкФ → 2 × 10 мкФ 0805.
- Вариант B: добавить буфер на каждый ключ — ZXGD3006E6 (или дискретная пара NPN/PNP SOT-23) между HO/LO и R_g; C_boot 4,7 мкФ.

### 1.6 Термодатчики (лист `Temperature.kicad_sch`, TH1–TH3)

Перенести каждый NTC на медный островок 3×3 мм на F.Cu, соединённый двумя виа 0,3 мм с GND-пуром истока нижнего ключа своей фазы, в 2–3 мм от корпуса LS. Островок — под пэдом NTC (пэд «2» на GND-сторону делителя: проверить схему — если NTC включён между +3,3 В и входом LMV321, островок делать под пэдом со стороны +3,3 В и не связывать электрически, только тепловая площадка под корпусом). Цель — привязка датчика к меди истока, а не к воздуху.

## 2. Защита: мониторинг V_ds нижних ключей (новое)

### 2.1 Новый лист `Vds_Monitor.kicad_sch`, 3 экземпляра (по фазе)

Иерархические выводы: `Drain` (узел фазы = Phase_IN), `LI` (команда нижнего ключа, цепь `/TMR1_CHxN` с МК, **до** входа драйвера), `FAULT` (выход, открытый сток, активный низкий), питание +3,3 В, GND.

Схема одного канала (узел N — общий узел измерения):

| Элемент | Номинал / тип | Включение |
|---|---|---|
| D1 | BAS21 (250 В, ≤5 пФ) | анод — N, катод — `Drain` |
| D2 | 1N4148WS | анод — N, катод — `LI` |
| D3 | 1N4148WS | анод — N, катод — +3,3 В |
| D4 | BAT54 | анод — GND, катод — N |
| R1 | 10 kΩ 0603 | `LI` — N |
| C_bl | 47 пФ C0G 0603 | N — GND |
| R_in | 100 Ом 0603 | N — вход «+» компаратора |
| K1 | LMV7239 (SC70-6, открытый сток, 45 нс) | «+» = N через R_in, «−» = V_ref, выход = `FAULT` |
| R_ref | делитель +3,3 В: 15,4 kΩ верх / 10 kΩ низ + 100 нФ | V_ref = 1,30 В |

Логика: LI = 0 → N ≤ 0,7 В через D2, R1 не тянет. LI = 1 → R1 заряжает C_bl (τ = 0,47 мкс, порог 1,3 В достигается через ~0,5 мкс — бланкирование), ключ к этому моменту открыт, D1 проводит, N = V_ds + V_f(D1) ≈ V_ds + 0,65 В. Сквозной ток/пробой: V_ds не падает → N > V_ref → FAULT.

Порог: V_ds ≈ 0,65 В → ~550 A горячего одиночного TOLT (1,5 мОм × 1,5 ≈ 1,15…1,3 мОм при 125 °C с учётом типового значения ниже максимума). **Подстроить на плате** по осциллограмме узла N: V_ref выставить на 0,3 В выше максимума звона N после окончания бланкирования при номинальном токе. Диапазон подстройки заложить: R_ref верхний 12…22 kΩ (0603, 1 %).

Вариант B (два TOLT на плечо): D1 к стоку любого из пары; порог тот же по V_ds.

### 2.2 Размещение канала

D1 — у пэда стока нижнего ключа своей фазы, не дальше 3 мм; трасса N ≤ 10 мм, вдали от узла фазы и затворов; C_bl, D2, D3, D4, R_in, K1 — компактно у D1. `LI` брать с дорожки `/TMR1_CHxN` у драйвера. Возврат GND канала — к GND-пуру истока LS той же фазы одной виа.

## 3. Защита: окно по фазным токам (переработка `Over_Current_Protection.kicad_sch`)

### 3.1 Удалить

D13, D14, D15, D24, D25, D26 (диодная сеть max/min), R57, R78 (подтяжки узлов), U6 TLV3502 с делителями R54/R55/R79/R80, C62, C91, D7 (диодное ИЛИ).

### 3.2 Добавить: три оконных компаратора

По каналу на фазу, вход — **выход AD8418 до RC** (цепи `Net-(U4-OUT)`, `Net-(U9-OUT)`, `Net-(U12-OUT)`; R42/R43/R56 + C37/C39/C64 остаются как фильтр только для АЦП).

| Элемент | Номинал | Назначение |
|---|---|---|
| K_hi, K_lo | LMV7239 × 2 (или один сдвоенный с открытым стоком того же класса) | K_hi: «+» = OUT, «−» = V_hi; K_lo: «+» = V_lo, «−» = OUT |
| R_in ×2 | 100 Ом + 100 пФ на GND | τ = 10 нс, только от иголок |
| V_hi | делитель 4,7 kΩ / 24 kΩ от +3,3 В + 100 нФ | 2,76 В → +185 A при 6 мВ/A |
| V_lo | делитель 10,2 kΩ / 2,0 kΩ от +3,3 В + 100 нФ | 0,54 В → −185 A |

Делители V_hi/V_lo — общие на три канала (одна пара делителей, три компаратора на каждый порог). Порог ±185 A сохранён от текущей схемы; при смене шунтов пересчитать.

### 3.3 Объединение в BKIN

Все выходы (3 × V_ds + 6 × окно) — открытый сток, монтажное ИЛИ на существующей цепи `/BkIN_1`: R подтяжки 4,7 kΩ к +3,3 В, C56 10 пФ и R51 100 Ом оставить. Активный уровень — низкий (в прошивке: TIM1 BKIN polarity = low, MOE защёлкивается аппаратно). Прошивочная часть — вне этого задания; зафиксировать в CHANGELOG.

## 4. Тракт измерения тока (листы `Current_Sensor_1/2/3.kicad_sch`, PCB)

### 4.1 Исправить полярность фазы A

В `Current_Sensor_3.kicad_sch` (экземпляр «Current_Sensor_1», U12/R52/J3) иерархические метки `Phase_IN` и `Phase_OUT` переставлены относительно двух других листов: у U12 +IN сидит на стороне разъёма, у U4/U9 — на стороне моста. Привести к виду `Current_Sensor_1.kicad_sch` (+IN = Phase_IN, −IN = Phase_OUT). Проверить по PCB после обновления: U12 pad 8 → `/Current_Sensor_1/Phase_IN`.

### 4.2 Кельвиновские отводы (PCB, все три фазы одинаково)

- Пуры Phase_IN / Phase_OUT на B.Cu **не должны заходить под корпус шунта**: граница пура — по внешней кромке пэда, зазор между пурами разных цепей под корпусом ≥ 1,5 мм.
- Отводы к входам AD8418 — от **внутренних** кромок пэдов шунта (со стороны резистивного элемента), трассой 0,3 мм, парой, параллельно, длиной ≤ 6 мм; пур не касается трассы отвода (правило зазора 0,3 мм для класса `Kelvin`).
- Виа-поля Phase_IN и Phase_OUT: столбцы вдоль всей высоты пэда с внешней стороны, одинаковое число для всех трёх фаз (сейчас: A 14, B 38, C 32 — выровнять).

### 4.3 Шунты — без изменений в rev1

300 мкОм WSLF2512 и AD8418 остаются (предел ~140 A, что выше ограничения ЗПТ). Замена на 100 мкОм + усилитель — в rev2 вместе с ЗПТ. Целевой усилитель для 72-вольтовой версии — **INA241A2** (синфазное −5…110 В): INA240 (80 В) и AD8418 (70 В) при заряженной батарее 20S (84 В) вне диапазона.

## 5. Итоговые проверки

1. ERC, DRC — чисто; `Power.kicad_pcb` открывается без потерянных футпринтов.
2. 3D-вид: в контуре пластины нет компонентов выше 2 мм; шесть TOLT копланарны (одна сторона, одна ориентация).
2а. Зафиксировать в CHANGELOG пункт для первого включения: выброс V_ds на нижнем ключе при выключении на максимальном токе — не более 15 В над V_dc (щуп с пружинной землёй на пэдах TOLT).
3. Сетка проверки по PCB (скриптом): для каждой фазы — число виа Phase_IN/Phase_OUT у шунта; U4/U9/U12 pad 8 на Phase_IN; отсутствие цепей `Net-(D13-K)`, `Net-(D24-A)`.
4. BOM: обновить `BOM/Power_BOM_*.xlsx` (RU/EN), новые позиции — с Product Name и корпусом.
5. `CHANGELOG_rev1.md` + сравнение netlist rev0/rev1 (`kicad-cli sch export netlist`, diff по цепям силовой зоны и защит).

## 6. Открытые решения (не выполнять, вынести в CHANGELOG как вопросы)

- Вариант B (12 TOLT) и связанное изменение контура / двухплатная конструкция.
- Замена шунтов и AD8418 (rev2).
- ЗПТ (rev2): для 72-вольтовой версии электролиты 80 В не годятся; MLCC 100 В при 84 В теряют ~70 % ёмкости — только гибриды 100 В плюс керамика у ключей.
- Втулки M4 → M6 (при переходе к 200 A).
