alsizyakin/InvertorPowerNewGen/docs/reviews/13_review_plus4r3_emc.md

# Ревью ЭМС: InvertorPowerNewGen, ветка `rev0.1-plus4` (b78f01b)

*Ревьюер: субагент «инженер по ЭМС», 2026-10-20. Текст — как получен.*

**Вердикт.**
- **Четыре коммита по ЭМС принимаю.** В сумме нигде не стало хуже. Заметно лучше стали линии термистора A и медь узла у края.
- **VDC на J6: точку отбора перенесли правильно, а сама дорожка в проходе C связана с узлом сильнее, чем раньше** (E19).
  - Начало теперь в плоскости VDC полосы, у C94. Раньше это был хвост колонки стока HS внутри петли коммутации. Гальваническая связь с L·di/dt колонки ушла: по оценке, это 2–10 В на фронте и звоне.
  - В проходе C дорожка ≈8.3 мм идёт полосковой линией между медью узла на F.Cu (0.1 мм) и на In2 (0.485 мм). Связь с узлом ≈2.7 пФ, раньше было ≈0.65 пФ. GND рядом с дорожкой нет.
  - Фильтра у J6 по-прежнему нет (E3). Место под 0805 100 нФ теперь есть.
- **GND на In1 в проходе C пропал, и In1 GND разрезан на два куска:** 1715 + 1905 мм², раньше было 3619 мм² одним куском (E20).
  - Сигналов, которые опираются на In1 и пересекают разрез, нет. In3 цел.
  - Мосты GND прохода C: 5.95 → 4.55 мм. Принять, но записать в Р13.
- **Линии термистора A — лучшая правка раунда** (E21).
  - U3+ теперь идёт между GND на In1 и In3. Связь с узлом и SW ≈0.9 → <0.05 пФ, у +3.3V ≈1.2 → ≈0.35 пФ.
  - Линии термистора C на In1 связаны с узлом так же, как раньше (≈4 пФ). Изменилось одно: опоры GND у них больше нет.
- **E6 сделан по существу** (E22).
  - В 1 мм от внешнего контура меди узла не осталось: C 8.5 → 0, A 7.6 → 0 мм².
  - До J6 (VDC) теперь 1.65–1.70 мм, до J7 — 2.45 мм.
  - Ёмкость узла на радиатор в окнах маски не изменилась (±3 мм²).
- **S3: решение «≈100 кГц, как на платах» в схему не записано** (E24).
  - В схеме R42/R43/R56 120 Ом и C37/C39/C64 100 нФ — это 13 кГц.
  - По BOM новые платы получат 13 кГц. По таблице автора это ток >2000 А к моменту выключения при КЗ на кабеле, а при 100 кГц — 529 А.
- **INA240 по ЭМС лучше AD8418** (E25). Но выброс узла со стенда (83–87 В) выше рабочих 80 В. Нужен замер выхода усилителя на фронтах.
- **CAN без развязки** принимаю при одном условии: все узлы сети отнесены к минусу батареи (E26).
- Углы 0/45/90° на петли затворов не влияют (E27). Виа сшивки и снятое поле виа по ЭМС нейтральны (E23).

**Как проверял.**
- Платы `b78f01b`, `50ad933`, `b2f3c90` и `bd1f33e` извлёк через `git show` во временный каталог. Рабочее дерево не трогал.
- Полная копия проекта на `b78f01b`, kicad-cli 10.0.3, `run_drc.sh`:
  - 0 ошибок, 0 неразведённых, 0 расхождений; одно предупреждение шелкографии у края;
  - площади заливок в коммите совпадают со свежей перезаливкой по всем зонам;
  - `hv.py`: 24, список тот же, что на `50ad933`.
- Растр медь всех 6 слоёв с шагом 0.05 мм — свой `rast.py`, контур с кривыми Безье. Ёмкости по перекрытию соседних слоёв — ε0·4.2·S/d.
- Погонные ёмкости дорожек в проходах считал 2D-решением уравнения Лапласа по сечению. Шаг 5 мкм, медь 35 мкм, εr 4.2, краевые поля учтены. Сечения взяты из растра: проход C — y 95.5, проход A — y 97.
- Инструменты проекта: `bridges.py`, `islands.py`, `hv.py`.
- Данные усилителей:
  - INA240 — даташит TI SBOS662C;
  - INA241 — даташит TI;
  - AD8418 — по ревью 01.
- Допущения:
  - dv/dt узла 5–10 В/нс;
  - звон 130 МГц амплитудой 20–35 В;
  - L петли 1.15 нГн, Coss 1.3 нФ;
  - входное сопротивление соединительной платы по VDC на 130 МГц — 2–5 Ом (данных нет).
- Скрипты: `/tmp/claude-1000/-home-alexey-Git-KiCad-InvertorPowerNewGen/13246ab1-031f-4df4-bddd-3876e07683de/scratchpad/e13/` (`rast.py`, `coupling.py`, `fd2d.py`, `pic.py`).

**Чего не знаю:**
- вход VDC и цепи CAN на соединительной плате;
- где кончается радиатор (беру край окна маски, y 100.5);
- к чему отнесены остальные узлы CAN;
- номиналы фильтра OCP на платах rev0.

---

## Находки

### E19 — средняя. VDC на J6: точка отбора ушла из петли, но в проходе C дорожка лежит между слоями узла; фильтра у J6 нет

**Где.** Дорожка VDC шириной 0.4 мм:
- In2: (121.0, 73.4) → (121.0, 91.3);
- виа (120.0, 92.3);
- In1: (121.6, 92.3) → (123.25, 93.95) → (123.25, 97.65) → (119.5, 101.4) → J6.1.

Разъём: J6.1–4 — VDC, J6.11/12/17/18 — GND.

**Факты.**
- Длина 35.1 мм: In2 19.3 мм, In1 15.8 мм. Раньше было 20.3 мм. Сопротивление 43 мОм.
- **Точка отбора** — плоскость VDC полосы на In2.
  - В 3.7 мм ниже VDC-вывода C94 (120.74, 69.7). До входа в колонку стока HS (x 128.5, y 74.5) — 7.6 мм.
  - Ток коммутации идёт от керамики вправо, к колонке. Точка отбора лежит в стороне от него.
  - Раньше отбор был в хвосте колонки стока HS C, (129.0, 91.0). Напряжение там отличалось от напряжения на керамике на L колонки и выводов HS: 0.2–0.4 нГн × di/dt 10–17 А/нс, по оценке 2–10 В на фронте и звоне. Теперь этого слагаемого нет.
- **Погонная ёмкость** (2D-сечение):

  | Участок | Слой и соседи | К узлу, пФ/мм | К GND, пФ/мм |
  |---|---|---|---|
  | Было, проход C (y 95.5) | In2; узел In2 с двух сторон в 0.25 мм; GND на In1 и In3 | 0.032 | 0.232 |
  | Сейчас, x 121 (y 73–91) | In2; узел In2 справа; In3 GND в 0.1 мм | 0.028 | 0.235 |
  | Сейчас, проход C | In1; узел на F.Cu в 0.1 мм и на In2 в 0.485 мм | **0.261** | **0** |

  - Медь узла есть с обеих сторон дорожки на ≈8.3 мм: перекрытие 3.29 мм² с F.Cu и 3.35 мм² с In2.
- **Связь с узлом C в сумме:** ≈2.2 пФ в проходе и ≈0.5 пФ вдоль x 121, всего ≈**2.7 пФ**.
  - Раньше было ≈0.65 пФ — боковая связь в слое In2 — плюс гальваническая связь с петлёй.
  - Автор оценивает 1.5–2 пФ. Это плоский конденсатор без краевых полей; по растру у меня тоже 1.48 пФ.
- **Ток узла в дорожку:**
  - на фронте 2.7 пФ × 5–10 В/нс = 14–27 мА;
  - на звоне 130 МГц при 20–35 В — 44–77 мА.
- **У J6** нет ни бусины, ни конденсатора (E3). Ближайший GND-вывод, J6.11, в 5.1 мм от J6.3.
- С того же конца дорожки питается делитель АЦП шины R68/R69 (VDC_MCU): R68.1 соединён дорожкой F.Cu с J6.2.
- После E6 слева от J6 на In2 и B.Cu лежит GND — «карман» 23.9 мм², x 116.5–121.25, y 97.7–104.1. Под концом дорожки у J6 теперь есть опора GND на In2.

**Последствие.**
- Главное сделано: гальванической связи с петлёй коммутации больше нет.
- Остаётся ёмкостный ток узла. При 2–5 Ом на входе соединительной платы (допущение) это 0.1–0.4 В на 130 МГц на J6.1 относительно GND. Это оценка, не замер.
- В проходе обратный путь для этой дорожки — сама медь узла. Плоскость In3 закрыта от неё слоем In2.

**Рекомендация.**
- **Трассу оставить.** Обойти проход C на пути к J6 нельзя. Любой слой прохода, кроме In3, соседствует с узлом через 0.1 мм.
- **Вернуться к E3: место под конденсатор теперь есть.**
  - 0805 100 нФ 100 В X7R на B.Cu, вертикально, центр ≈(118.9, 101.8).
  - Верхний пэд — GND кармана, со своей виа. Нижний — VDC, коротким отрезком B.Cu к J6.2.
  - Грубая проверка растром: до чужой меди, виа и пэдов J6 не меньше 0.2 мм. Проверить `geom.py` и DRC.
  - Проверить, не заходит ли туда радиатор: окно маски кончается на y 100.5, B.Cu-детали рядом уже стоят (R7, U4).
  - С конденсатором остаток на J6 — ≈35–60 мВ (ESL с виа ≈1 нГн).
- Бусина нужна, только если у входа соединительной платы нет керамики.

### E20 — низкая. Проход C без GND на In1: In1 GND разрезан на два куска, мосты GND 5.95 → 4.55 мм

**Где.** In1, проход C: x 121–126.6, y 91.5–101.

**Факты.**
- GND на In1 в проходе C: 2.70 → 0 мм (`bridges.py`). Слой заняли VDC и линии термистора C, остатки меди сняла заливка.
- Через проходы J1–J2 и J2–J3 GND по In1 не шёл и раньше. В проходе A его 0.20 мм, но этот кусок с верхним не соединён.
- Поэтому In1 GND теперь из двух кусков, связанных только через виа на In3 и In4:
  - верхний — полоса ЗПТ и полосы GND, y 31.9–92.6: 1715 мм²;
  - нижний — часть управления, y 91.4–144.2: 1905 мм²;
  - раньше был один кусок 3619 мм².
- Мосты GND по слоям, мм (`bridges.py`):

  | Проход | In1 | In3 | In4 | Сумма |
  |---|---|---|---|---|
  | C | 2.70 → 0 | 2.70 | 0.55 → 1.85 | 5.95 → 4.55 |
  | A | 0 → 0.20 | 2.65 | 0 → 0.90 | 2.65 → 3.75 |
  | Все четыре | 2.70 → 0.20 | 8.00 | 0.55 → 2.75 | 11.25 → 10.95 |

- In3 — один кусок.
- **Что пересекает разрез.**
  - На In1 в проходе C — только VDC и линии термистора C. Их опора — узел, а не GND (E19 и ниже).
  - LO C на In4 опирается на In3, как и раньше.
  - На F.Cu и In2 в проходах лежит медь узла, сигнальных дорожек там нет.
- **Ёмкость узла C на GND** по всем слоям — 95 → 73 пФ. Ушла пара «узел на F.Cu — GND на In1» с зазором 0.1 мм. Это 1.7 % от Coss двух ключей.
- **Линии термистора C на In1 в проходе** (2D-сечение):
  - к узлу 0.209 пФ/мм, к GND 0;
  - раньше (In4, ширина 0.5 мм) было 0.234 и 0.052 пФ/мм.
- Связь линий с узлом в сумме почти не изменилась:
  - +3.3V ≈4.1 → ≈4.0 пФ;
  - U1+ ≈4.6 → ≈4.5 пФ;
  - к GND ≈0.6–0.7 → 0 пФ.
- Заряд за фронт в C14 100 нФ: 4.5 пФ × 48 В — это 2.2 мВ.

**Последствие.**
- По ЭМС почти ничего не изменилось. Возвратный ток драйвера LS фазы C и раньше шёл в основном по In3 и In4.
- Р13 по букве (In1 + In4) теперь 2.95 мм. До правок было 3.25 мм, в rev0 — 4.85 мм.

**Рекомендация.**
- Принять.
- Записать в CHANGELOG, что In1 GND разделён на два куска.
- Р13 считать по In1 + In3 + In4: 10.95 мм.

### E21 — низкая (улучшение). Линии термистора A у паза: связь с узлом почти пропала

**Где.** In2: +3.3V по x 162.7, U3+ по x 163.3, y 92.9–105.6. Правый паз — (166.5, 95.5).

**Факты.**
- Погонная ёмкость в проходе A, сечение y 97 (2D):

  | Линия | К узлу A, пФ/мм | К SW A, пФ/мм | К GND, пФ/мм |
  |---|---|---|---|
  | U3+, было (x 162.0) | 0.038 | 0.015 | 0.163 |
  | U3+, сейчас (x 163.3) | 0.001 | <0.001 | 0.209 |
  | +3.3V, было (x 161.25) | 0.043 | 0.006 | 0.166 |
  | +3.3V, сейчас (x 162.7) | 0.013 | 0.001 | 0.198 |

- **Соседи по слоям.**
  - Над линиями теперь GND на In1 (раньше — узел A), под ними — GND на In3 в 0.1 мм.
  - Узел остался только сбоку, на In2: в 0.25 мм от +3.3V.
- **Переход через медь узла перед шунтом снят.** Раньше U3+ шёл по In2 вдоль y 102, а +3.3V — по In4 над узлом на B.Cu.
- Связь в сумме, к узлу и SW:
  - U3+ ≈0.9 → <0.05 пФ;
  - +3.3V ≈1.2 → ≈0.35 пФ. Из них ≈0.2 пФ — прежний участок в блоке (x 161.25) под узлом на In1.
- **Пары Кельвина шунта A.** Из-под Phase_IN на In4 ушёл +3.3V: 0.15 → 0 мм². Окружение теперь как у фазы C: GND/узел 1.39 / 1.32 мм² против 1.43 / 1.24 мм² у C.
- **Стенка паза.**
  - U3+ теперь ближайшая к стержню винта медь на In2: 0.30 мм до стенки. +3.3V — 0.95 мм.
  - Меди узла A у стенки паза на In1–In4 больше нет.
- **Плоскость +3.3V.** U3+ по y 105.6 прорезает её на In2 на 8.3 мм. TH3 питается по полоске шириной 0.95 мм. Под полоской — In3 GND в 0.1 мм. Сигналов с опорой на +3.3V там нет, поэтому по ЭМС это безразлично.

**Последствие.**
- Наводка на канал температуры A уменьшилась примерно в 3 раза по +3.3V и больше чем на порядок по U3+. Теперь этот канал чище канала C.
- U3+ относится к домену батареи. Если в пазу нет изолирующей втулки, от стержня винта (корпуса) его отделяют 0.30 мм кромки стеклотекстолита.

**Рекомендация.**
- Принять.
- U3+ учесть в той же оценке изоляции у пазов, что и E14 (втулки с буртиком).

### E22 — низкая. E6: медь узла ушла от внешнего контура и от разъёмов; ёмкость на радиатор почти не изменилась

**Где.**
- Угол фазы A: x 163.5–169.25, y 98.25–104.25. На F.Cu и B.Cu медь узла отдана GND.
- Карман фазы C: x 116.5–121.25, y 97.5–104.25. На In2 и B.Cu медь узла отдана GND.

**Факты** (растр, все слои; `bd1f33e` → `b78f01b`, если не сказано иное).

| | Фаза C | Фаза A |
|---|---|---|
| Узел в 1 мм от внешнего контура, мм² | 8.5 → 0 | 7.6 → 0 (в `50ad933` было 16.5) |
| Узел в 1 мм от стенок паза, мм² | 22.3 → 14.6 | 16.6 → 9.2 (в `50ad933` было 36.8) |
| Узел под головкой винта (r 4.25), мм² | 39.5 → 26.8 | 30.2 → 17.7 |
| Узел — пэды разъёма | J6.1/2 (VDC), In2 и B.Cu: 0.25 (по автору) → 1.65–1.70 мм | J7.1/2 (GND), F.Cu/B.Cu: 0.42 → 2.45 мм |
| Узел на B.Cu, всего, мм² | 209.9 → 181.9 | 223.2 → 191.1 |
| то же в окнах маски (на прокладке), от `50ad933` | 110.3 → 112.7 | 129.3 → 125.6 |
| то же под маской, y 74.25–100.5 | 166.9 → 155.0 | 182.7 → 169.3 |

- **Проценты у края.** Автор пишет «−73…−80 %» для меди в 1 мм от края. У меня выходит −53 % (C) и −62 % (A): я считаю и стенки пазов.
  - У внешнего контура узла не осталось совсем.
  - Всё, что осталось, — медь самих проходов у пазов.
- **Ёмкость узла на радиатор.**
  - В окнах маски медь узла изменилась на −3.7 / +2.4 мм² — практически без изменений.
  - Под маской до y 100.5 стало меньше на 12–13 мм². Это −2.6…−3.0 пФ на фазу при прокладке 0.2 мм и εr 5, если радиатор доходит до y 100.5. От 46–56 пФ (09 E13) это ≈5 %.
- **Новые куски GND.**
  - Угол A: по 31.5 мм² на F.Cu и B.Cu и 8 новых виа GND. Пять из них стоят рядом через 1 мм между узлом и краем.
  - После снятия поля виа GND пришёл в угол A и на внутренних слоях: In1 5.5 → 59.6, In3 42.6 → 68.6, In4 15.8 → 62.6 мм².
  - Карман C: по 23.9 мм² на In2 и B.Cu, 2 виа. Для электростатического экрана размером 4.7 × 6.4 мм этого хватает: его резонансы — в гигагерцах.
- **У левого паза появилась виа VDC (120.0, 92.3)** — начало участка трассы E19 на In1.
  - 0.30 мм до стенки паза на всех слоях.
  - Лежит под головкой винта: r 3.35 мм от центра паза.
  - На F.Cu и B.Cu закрыта маской.

**Последствие.**
- Ушло то, о чём просил 03 E6: краевое поле узла у края платы и связь узла с ответными частями J6/J7.
- Синфазный ток на радиатор E6 почти не уменьшил. Под прокладкой лежит медь окон маски, а её E6 не трогал.

**Рекомендация.**
- Принять.
- Виа VDC у левого паза внести в оценку изоляции E14. Это вопрос изоляции, не ЭМС.

### E23 — низкая (для сведения). Виа сшивки и снятое поле виа: дыр в GND стало чуть больше, разрывов нет

**Факты.**
- **17 виа VDC в полосе ЗПТ прорезают GND.**
  - In1 и In4 теряют по 9.6 мм², In3 — 15.8 мм². Это около 1 % площади полосы.
  - Пустот на In3: 143 → 155, по площади 769 → 789 мм². In3 по-прежнему один кусок.
- **Снятые 81 виа узла A в тупике** вернули GND на внутренние слои угла A: In1 +54, In3 +26, In4 +47 мм².
- **Медь узла A** по всем слоям — 1007 → 828 мм² (−18 %). Ёмкость узла A на GND та же, 53 пФ (плоский конденсатор): медь узла на F.Cu теперь лежит над GND на In1.
- **Новые виа узла:** 6 у R52.2 и 2 у R7.1. Они стоят в меди узла перед шунтами. На окружение пар Кельвина не влияют (E21).
- **Виа VDC на входе в колонки стока** должны снизить L VDC-части петли коммутации; автор считает сопротивление −11…−17 %. Частота звона, по оценке, вырастет на единицы процентов, амплитуда немного упадёт. Не считал.

**Вывод.** По ЭМС нейтрально или в плюс. Правок не нужно.

### E24 — средняя. S3: решение «≈100 кГц, как на платах» в схему не записано

**Где.** Листы Current_Sensor_1–3: R42 / R43 / R56 120 Ом и C37 / C39 / C64 100 нФ. Это общий RC перед компаратором OCP и АЦП.

**Факты.**
- 120 Ом × 100 нФ дают fc = 13.3 кГц, τ = 12 мкс. Эти номиналы и уйдут в BOM.
- Таблица автора (CHANGELOG, S3), при 150 А/мкс: с фильтром 13 кГц ток к моменту выключения >2000 А, с фильтром 100 кГц — 529 А.
- **Помехоустойчивость при ≈100 кГц** (τ 1.6 мкс):
  - порог ±185 А — это ±1.11 В от середины 1.65 В; выход усилителя отклоняется не больше чем на +1.45 / −1.6 В;
  - чтобы дойти до порога, выброс выхода до упора должен длиться ≥2 мкс;
  - выброс длиной 50 нс от звона 130 МГц ослабляется примерно в 30 раз, до ≈50 мВ.
- Значит, фильтр ≈100 кГц не даст ложных срабатываний от фронтов и звона, если выброс на выходе усилителя короче 2 мкс.

**Последствие.**
- Если схему не исправить, новые платы получат фильтр в 7.5 раза медленнее, чем решил владелец.
- По ЭМС такой фильтр ещё «тише», но защита от КЗ на кабеле перестаёт работать.

**Рекомендация.**
- Записать в схему номиналы, которые реально стоят на платах.
- При R 120 Ом для ≈100 кГц нужен C 12–15 нФ (110–88 кГц).
- Номиналы сверить с платами rev0: замером или по их BOM.
- Решение владельца оставить один фильтр по ЭМС поддерживаю.

### E25 — низкая. INA240 против AD8418: по ЭМС лучше, но выброс узла 83–87 В выше рабочих 80 В

**Факты.**

| | AD8418 | INA240A1 | INA241A2 |
|---|---|---|---|
| Синфазное рабочее, В | −2…+70 | −4…+80 | −5…+110 |
| Синфазное предельное, В | −4…+85 | −6…+90 | −20…+120 |
| CMRR | — | 132 дБ DC (мин. 120), 93 дБ на 50 кГц | 166 дБ DC, 104 дБ на 100 кГц, 89 дБ на 1 МГц |
| Полоса; установление | — | 400 кГц; 9.6 мкс до 0.5 % | 1.1 МГц; 1 мкс до 1 % |

- **Узел — синфазный вход усилителя**, потому что шунт стоит в фазе. На стенде при 48 В и 120 А выброс узла 83–87 В (01 S1).
- **Живучесть.** INA240 этот выброс переживает (предел 90 В), AD8418 (предел 85 В) — нет.
- **Работа во время выброса.** 83–87 В выше рабочего диапазона INA240. На время выброса выход не нормирован.
  - После выброса выход восстанавливается за время до ~10 мкс — это время установления по даташиту.
  - Восстановление после синфазного скачка TI не нормирует.
- **Входного фильтра нет.** Так и рекомендует TI: не больше 10 Ом последовательно.
- **Опора выхода — VS/2** (REF1 = VS, REF2 = GND). Половина шума +3.3V после FB проходит на выход — так же, как у AD8418.

**Последствие.**
- Замена на INA240 улучшила живучесть и подавление фронтов.
- При 48 В на фронтах выключения LS с током 100–120 А выход может давать выброс. С фильтром ≈100 кГц он опасен, только если длится дольше ≈2 мкс (E24).
- LS-снабберы (E15) сняли бы 20–30 % выброса узла, до ≈65 В.

**Рекомендация.**
- На стенде снять выход U4/U9/U12 (вывод 5) на фронтах при 48 В и 120 А.
- Если выброс длиннее 1 мкс или больше 0.3 В — ставить INA241A2 уже для 48 В. Она совместима пин в пин, поле Replacement уже заполнено.
- Плату не трогать.

### E26 — низкая (системная). CAN без развязки на этой плате — принимаю при одном условии

**Факты.**
- Приёмопередатчик SIT65HVD232 стоит на этой плате, без развязки, рядом с МК STM32F405. По схеме ставятся R50 120 Ом, C58/C59 по 56 пФ и TVS D12.
- GND платы — минус плавающей батареи. Относительно корпуса он скачет на каждом фронте: по 09 E16, без Y-конденсаторов это единицы–10 В. Синфазный диапазон SIT65HVD232 — −2…+7 В.
- J6 — межплатный разъём с шагом 1.27 мм. Кабель CAN выходит с соединительной платы.

**Последствие.**
- Дроссель и разделённая терминация на соединительной плате стоят в правильном месте: там, где кабель выходит из корпуса, а не в 20 мм внутри.
- Позже перенести развязку на соединительную плату не получится: приёмопередатчик стоит здесь. Понадобится перенести его и поставить цифровую развязку TX/RX, то есть переделать обе платы.

**Рекомендация — решает владелец.**
- Подтвердить, что все узлы CAN отнесены к минусу той же батареи, а не к корпусу. Если хоть один отнесён к корпусу, развязка нужна.
- Если терминация переезжает на соединительную плату по разделённой схеме (2 × 60 Ом + 4.7 нФ), R50 здесь сделать DNP. Иначе на этом конце линии будет 60 Ом.
- TVS поставить у разъёма кабеля на соединительной плате. D12 здесь можно оставить.

### E27 — для сведения. Углы 0/45/90° на петли затворов не влияют

**Факты.**
- Отрезков не под 0/45/90° было 74 (мой счёт, допуск 0.01°), стало 0.
- Длины затворных цепей изменились на −0.61…+0.14 мм:
  - HO_DRV −0.61 мм;
  - LO_DRV −0.56 мм;
  - R_g → затвор HS (C100/C104/C108.1) +0.14 мм.
  
  Это ≤2 % длины петли затвора.
- Виа SW драйвера A теперь стоит в (161.75, 103.75), прямо над HO A на In4 (x 161.75). Излом пары на 0.5 мм ушёл.

**Вывод.** Принять.

---

## Пункты прошлых раундов

| № | Что сейчас |
|---|---|
| E3 | Точку отбора VDC вынесли из петли. Фильтра у J6 нет, связь с узлом 2.7 пФ — E19. Открыто |
| E4 | Закрыт (ответ 10). Линии термистора C ушли с In4, LO C не изменился |
| E6 | Сделан в объёме решения владельца — E22 |
| E7 | Окружение пар Кельвина A теперь как у C (E21) |
| E12, E16 | Решение владельца — CAN без развязки; условия — E26 |
| E13 | Без изменений: мест под Y-конденсаторы нет. Открыто |
| E14 | Окна маски сделаны (F14). У пазов добавились виа VDC (0.30 мм) и U3+ (0.30 мм) — E21, E22. Втулки — открыто |
| E15 | Снабберы по-прежнему DNP (C112/C115, R100/R103 на листе Phase_A). Открыто |

## Что хорошо
- Точка отбора VDC — вне петли коммутации, рядом с C94.
- U3+ и +3.3V фазы A идут между GND-слоями. Связь с узлом — <0.05 и ≈0.35 пФ.
- **Медь узла у края и разъёмов.**
  - У внешнего контура меди узла нет.
  - J6 (VDC) отодвинут от узла на 1.65–1.70 мм, J7 — на 2.45 мм.
  - Между узлом A и краем стоит ряд виа GND.
- Пары Кельвина фаз A и C — в одинаковом окружении.
- **Проверки.**
  - In3 — один кусок.
  - DRC на копии — 0 / 0 / 0, заливки в коммите совпадают с перезаливкой.
  - `hv.py`: 24, как было.

## Что решает владелец
1. **E19:** конденсатор 100 нФ у J6, место — B.Cu ≈(118.9, 101.8).
2. **E24:** номинал C фильтра OCP в схеме под ≈100 кГц, со сверкой по платам rev0.
3. **E25:** INA241A2 уже при 48 В — по результату замера.
4. **E26:** к чему отнесены узлы CAN; R50 — DNP, если терминация переезжает.
5. **Открытое с раунда 2:**
   - E13 — места под Y-конденсаторы;
   - E14 — втулки в пазах;
   - E15 — снабберы на первых платах;
   - норма ЭМС.

## Что мерить на стенде (добавить)
1. **VDC на J6.1 относительно J6.11.**
   - Коаксиал 50 Ом через разделительный конденсатор; 48 В, 60–120 А.
   - Ожидаю ≤0.4 В на 130 МГц.
   - Сравнить с rev0 (старая точка отбора) и с 100 нФ у J6.
2. **Выход U4/U9/U12 (вывод 5) и вход компаратора OCP на фронтах**, 48 В / 120 А: амплитуда и длительность выброса. Критерий: при фильтре ≈100 кГц до порога доходит только выброс длиной ≥2 мкс.
3. **Шум АЦП каналов температуры A и C под ШИМ.** Ожидаю, что A заметно чище.
4. **Частота звона после виа сшивки VDC** — вместе с п. 4 списка 09 (H-зонд по фазам).
