alsizyakin/InvertorPowerNewGen/docs/reviews/09_review_plus4_emc.md

# Ревью ЭМС: InvertorPowerNewGen, ветка `rev0.1-plus4` (ea2d599)

*Ревьюер: субагент «инженер по ЭМС», 2026-10-17. Текст — как получен.*

**Вердикт.**
- **Полосу +4 мм по ЭМС принимаю.**
  - Шесть снабберов стоят одинаково, без виа. Каждая петля занимает 9–10 мм² в плане и лежит над In1 GND в 0.1 мм.
  - Медь узла на F.Cu выросла на 9–13 мм² на фазу, и вся она лежит над GND.
  - Новых пустот в GND нет, сигнальных дорожек в полосе нет.
- **Снабберы стоят как DNP.** Если собрать плату по BOM, звон 125–139 МГц останется таким же. По линейной модели LS-снаббер снижает резонансный пик на 10–19 дБ — это главный рычаг в полосе 30–300 МГц (E15).
- **Радиатор на корпусе, батарея плавающая.** Путь синфазного тока теперь определён. Но с выводом журнала «на этой плате ничего не меняется» не согласен:
  - ниже ~30 МГц почти весь синфазный ток уходит в жгуты (по иллюстрации E13 — 75–130 %);
  - Y-конденсаторы у батареи оставляют кабель ЗПТ внутри петли;
  - на плате нет ни точки корпуса, ни мест под Y-конденсаторы (E13).
- **Крепёж теперь на потенциале корпуса.**
  - У вырезов под винты медь узла лежит в 0.25 мм от кромки на всех слоях, а на B.Cu не закрыта маской.
  - У H1–H4 медь шины начинается в 2.0 мм от кромки отверстия.
  - Изолирующей шайбы под головкой винта для этого мало (E14).
- **Д1/Д2 по ЭМС нейтральны или полезны** (E18).
- **E12 (CAN, датчики Холла) стал важнее.** GND платы — это минус батареи, и теперь он «качается» относительно корпуса (E16).

**Как проверял.**
- Взял `ea2d599` и `515455d`. У `515455d` медь та же, что у `rev0.1-gnd` (`0e54180`), отличаются только номиналы и признак DNP.
- Обе платы перезалил и проверил через kicad-cli 10.0.3, на копиях проекта:
  - `ea2d599`: 0 ошибок, 0 неразведённых, 0 расхождений (одно предупреждение по шелкографии у края);
  - `515455d`: 18 неразведённых.
  - У `ea2d599` заливки в коммите совпадают со свежей перезаливкой.
- Медь всех 6 слоёв перевёл в растр с шагом 0.05 мм. Это скрипты раунда 1, окно расширено до y 31.5.
- Ёмкости считал по перекрытию соседних слоёв: ε0·4.2·S/d, без краевых полей.
- По растру посчитал:
  - перекрытия;
  - медь у контура, у вырезов под винты и у H1–H4;
  - окна маски B.Mask;
  - пустоты в слоях GND;
  - сшивку по краю.
- Петли снабберов — по центрам пэдов.
- Модель звона — линейная:
  - Coss 1.3 нФ (2 × WMB043N10HGS при 48–80 В, библиотека pslc);
  - L петли 1.15 нГн (из частоты 130 МГц);
  - R петли 0.05–0.1 Ом, то есть Q0 = 9–19.
- Деление синфазного тока — иллюстрация: внешний путь задан мной (см. E13).
- Скрипты: `/tmp/claude-1000/-home-alexey-Git-KiCad-InvertorPowerNewGen/b297bce8-a27b-4b43-a5c5-acb44f8d7330/scratchpad/emc9/`.

**Чего не знаю:**
- прокладку (TIM): толщину, εr, размер отверстия под винт;
- к чему крепятся H1–H4;
- длины кабелей;
- ёмкость обмоток мотора на корпус;
- опору остальных узлов CAN.

---

## Находки

### E13 — высокая. Радиатор на корпусе: ниже ~30 МГц синфазный ток уходит в жгуты; на плате нет ни точки корпуса, ни мест под Y

**Где.** Вся плата, но решение принимается на уровне системы. H1–H4 — неметаллизированные отверстия, медь в 2.0 мм от их кромки. J4/J5.

**Факты.**

Ёмкость меди B.Cu к радиатору в полосе y 74.25–100.45 (блок не менялся; узел B — +3.8 мм², то есть +2 %):

| Прокладка | Узел C / B / A, пФ | VDC + GND, пФ |
|---|---|---|
| 0.5 мм, εr 6 | 23 / 22 / 27 | 46 |
| 0.2 мм, εr 5 | 48 / 46 / 56 | 95 |
| 0.1 мм, εr 4.5 | 86 / 83 / 100 | 171 |

- Ток узла в радиатор:
  - на фронт: C·dv/dt = 50 пФ × 2–10 В/нс = 0.1–0.5 А;
  - на звоне 130 МГц (20–35 В): до ~1 А.
- Раньше этот ток возвращался только местно. Теперь радиатор связан с корпусом, и ток делится:
  - местный путь — ёмкость VDC и GND на тот же радиатор, ≈95 пФ;
  - внешний путь — жгуты: кабель ЗПТ, ёмкость батареи на корпус, фазные кабели и обмотки, J6/J7.
- Доля тока во внешнем пути. Внешний путь для иллюстрации: 1 м кабеля ≈0.7 мкГн последовательно с 2 нФ «батарея — корпус».

| Частота | Только 95 пФ на плате | + Y 2 × 4.7 нФ у платы (путь ≈6 нГн) | Выигрыш |
|---|---|---|---|
| 0.15–1 МГц | ≈95 % | ≈18 % | −14 дБ |
| 10 МГц | ≈130 % (резонанс пути) | ≈4 % | −30 дБ |
| 30 МГц | ≈75 % | <0.5 % | −45 дБ |
| 130 МГц | ≈2 % | ≈1.3 % | −5 дБ |

- Y-конденсаторы «на входе батареи» эту петлю не укорачивают. Они замыкают ток через кабель ЗПТ, то есть делают кабель частью петли.
- На 130 МГц внешний путь получает всего ~2 %, но это всё ещё ~10–20 мА синфазного тока. Для излучения это очень много: при 1 м кабеля норму 30–230 МГц дают единицы мкА. На этой частоте помогает только сам звон — E15.

**Последствие.**
- Кондуктивная помеха 150 кГц–30 МГц и нижняя часть излучения идут по кабелю ЗПТ, фазным кабелям и жгуту J6/J7.
- Добавить Y-конденсаторы потом негде: на плате нет контакта с корпусом.

**Рекомендация — решает владелец, правка схемы.**
- Места под Y-конденсаторы (DNP) на этой плате — дешёвая страховка.
  - **У H1/H2, рядом с J4/J5:**
    - отверстие с металлизацией и кольцом, новая цепь CHASSIS;
    - по одному конденсатору VDC→CHASSIS и GND→CHASSIS, 2.2–4.7 нФ;
    - GND-вывод — своей виа в In1/In3.
  - **Желательно ещё у H3/H4, рядом с J6/J7:** GND→CHASSIS. Это опора для интерфейса (E16).
- **Условие:** H1–H4 должны крепиться к металлу радиатора или корпуса. С удлинением межцентровое H1/H2 ↔ H3/H4 стало 95.75 мм — сверить с радиатором 110 мм.
- **Для 72 В** (выше 60 В DC) Y-конденсаторы и зазоры CHASSIS входят в основную изоляцию:
  - конденсаторы класса Y2 или X7R ≥1 кВ, 1210/1812;
  - зазор CHASSIS ↔ VDC/GND по поверхности ≥2 мм.
  - Поля VDC вокруг H1/H2 придётся отодвинуть примерно до r 5.5 мм.
- Суммарную ёмкость Y учесть в схеме контроля изоляции (ИМД).
- Если H1–H4 не на корпусе — нужен иной контакт с радиатором (пружинный контакт на B.Cu вне прокладки). Это вопрос механики.

### E14 — высокая для 72 В, средняя для 48 В. Крепёж на потенциале корпуса: медь узла у вырезов и медь шины у H1–H4

**Где.** Вырезы под винты (119.0, 95.5) и (166.5, 95.5), r 2.75; отверстия H1–H4.

**Факты.**
- **Вырезы.** Медь узла лежит в 0.25 мм от кромки выреза на всех 6 слоях:
  - F.Cu, In1–In4, B.Cu: 0.25–0.28 мм;
  - на F.Cu под маской — 42 мм² (левый вырез) и 67 мм² (правый) в пределах 4.75 мм от кромки.
- **Окна маски B.Mask заходят в вырезы.**
  - Правое окно x ≤ 165.25 при вершине выреза x 163.75. Левое x ≥ 121.25 при 121.75.
  - Медь узла без маски на B.Cu в пределах 1 мм от кромки: 4.3 мм² (левый) и 6.1 мм² (правый); в пределах 2 мм — 12.9 и 16.9 мм².
- **Виа узла у кромки выреза** (считая от края пэда виа):

  | Расстояние | Левый вырез | Правый вырез |
  |---|---|---|
  | ≤ 1.0 мм | 6 | 13 |
  | ≤ 1.5 мм | 6 | 24 |
- **H1–H4.** Медь начинается в 2.01 мм от кромки, то есть на r 3.61 мм от центра.
  - H1/H2: VDC на F.Cu, In2, B.Cu.
  - H3/H4: GND, +3.3V (In2), CANH (F.Cu, r 4.35).
  - Край шайбы M3 по DIN 125 (Ø7) не доходит до меди всего 0.1 мм. Головка Ø5.5–5.7 без шайбы оставляет 0.8 мм.
  - GND — это минус батареи, то есть тот же изолированный домен, что и VDC.

**Последствие.**
- **Вырез.** Винт стоит на корпусе. Изолирующая шайба закрывает только головку.
  - Между медью узла и стержнем винта остаются 0.25 мм кромки стеклотекстолита плюс воздушный зазор.
  - Со стороны радиатора открытая медь узла смотрит на металл через отверстие в прокладке, на расстоянии её толщины (0.1–0.5 мм).
  - Пиковое напряжение 84 В плюс выброс — 110–120 В. Для основной изоляции при 72 В этого мало. Пробой в одной точке привяжет «плавающую» батарею к корпусу.
- **Ёмкостная связь** со стержнем — доли пФ. Для ЭМС это не важно, вопрос только в изоляции.

**Рекомендация.**
- **Вырезы:**
  - изолирующие шайбы с буртиком (втулкой в вырез), а не плоские;
  - окна B.Mask отвести от кромки вырезов на ≥1.5 мм. Это правка только маски, около 20 мм² окна на сторону;
  - отверстие в прокладке — не больше выреза + 1 мм.
- Отвод меди узла на ≥1 мм на всех слоях снимает 6/13 виа (Р8). Делать это только если варианту 72 В не хватит втулки.
- **H1–H4:** шайбы ≤ Ø6 или изолирующие. Либо зона запрета заливки r ≥ 4.5 мм вокруг H1–H4 (до −23 мм² меди на слой у каждого отверстия, в углах платы).
- Если H1/H2 станут точками CHASSIS по E13 — зазор 2 мм от кольца.

### E15 — средняя. Снабберы встали хорошо, но все DNP: без них звон 125–139 МГц не демпфирован

**Где.** C112–C117 / R100–R105, y 70.8–74.3.

**Факты.**
- **Петля снаббера в плане** (вывод ключа → C → перемычка → R → вывод ключа): LS 10.1 / 10.2 / 10.4 мм², HS 9.0 / 9.3 / 9.1 мм² (C / B / A).
  - Под всеми петлями — сплошной In1 GND в 0.1 мм. Виа в петле нет.
  - Сигнальных дорожек в полосе нет, кроме самих перемычек: 6 × 1.6 мм.
- **L ветви снаббера** — моя оценка 0.8–1.1 нГн:

  | Участок | L, нГн |
  |---|---|
  | C 0805 | ≈0.4 |
  | Перемычка 1.2 × 1.8 мм над In1 | 0.1–0.25 |
  | R 0612 | 0.15–0.3 |
  | Подводы | 0.1–0.2 |
- **Модель LS-выключения:** высота резонанса и где оказывается остаточный пик.

  | L_s | Q0 = 19 | Q0 = 9 | Остаточный пик, ζ |
  |---|---|---|---|
  | 0.6 нГн | −22 дБ | −16 дБ | 229 МГц, 0.20 |
  | 0.8–1.0 нГн | −17…−19 дБ | −11…−14 дБ | 196–209 МГц, 0.12 |
  | 1.5 нГн | −12 дБ | −7 дБ | 176 МГц, 0.08 |

  Без снаббера: 130 МГц, ζ 0.03–0.05, τ 23–46 нс.
- Новые 1206 C125/C129/C133 у стоков HS снижают L петли. Частоту звона жду на 5–10 % выше, ≈135–150 МГц (оценка).
- R101 и R103 стоят в 0.77 мм (в плане) от корпусов банок C18 и C6, R105 — в 0.94 мм. На R приходится 0.22 / 0.49 / 0.66 Вт при 48 / 72 / 84 В.

**Последствие.**
- По BOM снабберы не ставятся, поэтому звон и всё, что идёт за ним в E13 и E16, останутся как на rev0.
- Со снаббером звон уходит на 190–230 МГц с низкой добротностью. Широкий низкий пик проще для норм, но это другие полосы — с какой нормой сверять, решает владелец.
- Нагрев R рядом с алюминиевыми электролитами сокращает их ресурс.

**Рекомендация.**
- На первых платах поставить хотя бы LS-снабберы хотя бы на одной плате. Предварительный скан делать с ними и без них: это единственный рычаг на 130 МГц.
- Проверить тепловизором температуру R и корпусов C6/C18 при 48 и 72 В.

### E16 — средняя (зависит от системы). CAN и датчики Холла: GND платы — минус батареи, и теперь он «качается» относительно корпуса

**Где.**
- CAN: SIT65HVD232 (без гальванической развязки), J6.19/20. TVS D12, R50 120 Ом, C58/C59 по 56 пФ. Синфазного дросселя нет.
- Датчики Холла: J7.18–20, на входах RC и диоды (лист `Hall`). Датчики сидят в моторе, а мотор стоит на корпусе.

**Факты.**
- На каждом фронте фазы потенциал шинного домена относительно корпуса скачет. Величину задаёт делитель:
  - с одной стороны — ёмкость узла на радиатор и ёмкость обмоток на корпус мотора;
  - с другой — ёмкость шины на корпус: местные ≈95 пФ, батарея, Y-конденсаторы.
- Без Y-конденсаторов это, по оценке, единицы–10 В на фронт плюс звон. Диапазон синфазного напряжения SIT65HVD232 — −2…+7 В.
- По схеме ничего не изменилось с раунда 1 (E12): дросселя нет, терминация не разделена, на +12V у J6 конденсатора нет.

**Последствие.**
- Если хотя бы один узел CAN или опора датчиков Холла связан с корпусом:
  - CAN получит синфазную помеху на пределе диапазона, будут ошибки кадров;
  - связь через GND привяжет батарею к корпусу.
- Если вся сеть CAN питается от той же батареи — по постоянному току вопроса нет. Но жгут CAN всё равно несёт синфазный ток (E13).

**Рекомендация — решает владелец.**
- Выяснить, к чему отнесены остальные узлы CAN и датчики Холла.
- Если к корпусу — развязка CAN (изолированный приёмопередатчик) на этой или на соединительной плате.
- В любом случае:
  - места под синфазный дроссель и разделённую терминацию (E12);
  - Y GND→CHASSIS у H3/H4 (E13).

### E17 — низкая. Удлинение +4 мм: по ЭМС ничего не ухудшило

**Факты.**
- **Медь узла.** Узел C / B / A на F.Cu: 202 → 215, 198 → 210, 259 → 270 мм² (+4…6 %). Прирост — в полосе y 71.25–74.25.
  - Вся новая медь лежит над In1 GND в 0.1 мм. Ёмкость узла на GND выросла на +5 / +3 / +4 пФ — это меньше 0.4 % от Coss.
  - Узел целиком по всем слоям: +1 %.
  - Раунд 1 оценивал прирост в +21 мм² на фазу — по факту вдвое меньше.
  - Узел B на B.Cu +3.8 мм² (y 74.25–74.9, в окне маски) — это +0.8 пФ на радиатор при прокладке 0.2 мм.
- **VDC в полосе.** На F.Cu VDC заменён узлом и GND, на B.Cu — GND и пустыми местами (x 121–129, 138.5–146, 155–163). Колонки стоков HS связаны с полем банок на F.Cu, In2 и B.Cu.
- **Плоскости GND.** In1, In3 и In4 прибавили по +210 мм² (полоса 53 × 4 мм). Число и площадь пустот не изменились:

  | Слой | Пустот | Площадь пустот |
  |---|---|---|
  | In1 | 97 | 263 мм² |
  | In3 | 143 | 780 мм² |
  | In4 | 72 | 294 мм² |

  In3 — один кусок, 4290 мм².
- **Путь банки → блок.** +4 мм трёх пар VDC/GND с зазором 0.1 мм дают ≈0.003–0.01 нГн и ≈0.03 мОм. J4/J5 и H1/H2 сдвинуты вместе с банками, путь J4/J5 → банки прежний. Журнал подтверждаю.
- **Медь у контура** по слоям — та же, что раньше. Минимум для узла 0.25 мм; периметр в 1 мм от меди узла: 22 / 19 / 31 / 11 / 11 / 31 мм.
- **Верхний край** (часть ЗПТ): 127 мм периметра без GND-виа ближе 3 мм, было 119.
  - Снаружи там VDC, внутри GND In1/In3/In4, связанные выводами банок и J5.
  - Первая резонансная мода пары VDC/GND — выше 0.6 ГГц. Для 30–300 МГц это не важно.

**Вывод.** Принять, правок не нужно.

### E18 — низкая (для сведения). Д1/Д2: спектр не хуже, на фронтах выключения — лучше

**Факты** (стенд 16.10 и 13.10, оценки 05 P3/P6).
- **Без D_off выключение идёт через R_on.**
  - Фронт напряжения ≈18 → 29 нс. Верхний излом спектра трапеции сдвигается с 17.7 до 11 МГц, выше него — −4 дБ, но только на фронтах выключения.
  - di/dt HS −27 % (05), выброс при 120 А 37 → 33.5 В: минус 1–3 дБ звона на этих фронтах.
- **Фронты включения не изменились** (R_on и раньше работал на включение). Огибающую спектра выше ~20 МГц задают они и обратное восстановление диода (Qrr 82 нКл).
- **C_gs 10 нФ на выводах:**
  - наброс на затвор 3.0–3.4 → 1.3 В: уходит риск частичного включения и сквозных пиков тока — сильного ВЧ-источника;
  - у каждого из параллельных приборов свой C_gs — гасит паразитную генерацию между ними;
  - звон 130 МГц C_gs не демпфирует: выброс 20 → 20–24 В при 60 А.
- **Заряд затвора вырос** ≈98 → ≈218 нКл на прибор. Средний ток +12V ≈24 → ≈53 мА при 20 кГц. Импульсы дают C1–C3 по 10 мкФ у драйверов; у J6 конденсатора по-прежнему нет (E12).

**Вывод.** По ЭМС Д1/Д2 принимаю. Если на предварительном скане не хватит запаса в 10–100 МГц, ручка — R_on (общий на оба фронта), а не C_gs.

---

## Пункты раунда 1

| № | Что сейчас |
|---|---|
| E1 | Владелец решил: радиатор на корпусе. Из этого — E13 и E14 |
| E2 | Места под снабберы есть во всех 6 позициях, R 0612 0.47 Ом 1.5 Вт. Все DNP — E15 |
| E3 | Без изменений: дорожка VDC на In2, 0.4 мм, от колонки стока C к J6.1; ни бусины, ни 100 нФ. Открыто (схема) |
| E4 | Без изменений: LO C / B / A к узлу на B.Cu — 2.92 / 2.33 / 2.51 пФ. Довод 05 P8 (< 0.5 % Qgd) принимаю, можно закрыть |
| E5, E7–E11 | Блок не двигался; состояние после F1–F11 сохранилось |
| E6 | Медь узла у края и у J6/J7 — как было. Теперь это и вопрос изоляции от корпуса: вырезы — E14 |
| E12 | Без изменений, но стал важнее — E16 |

## Что хорошо
- Снабберы во всех 6 позициях одинаковы, без виа, над сплошным In1 GND. Средняя точка — перемычка 1.2 мм, а не дорожка.
- Новые 1206 C125/C129/C133 — у верха стоков HS, GND-вывод на две виа в In1 в 0.1 мм.
- 0603 стоят по две на фазу, у каждой своя виа GND.
- Медь узла выросла меньше, чем ожидалось, и вся лежит над GND. Рядом нет ничего чувствительного.
- Удлинение не дало новых пустот. In3 — один кусок. DRC 0 / 0 / 0 — проверено на копии.

## Что решает владелец
1. **Места под Y-конденсаторы на плате (E13):**
   - у H1/H2 — VDC и GND на CHASSIS;
   - у H3/H4 — GND на CHASSIS;
   - DNP; к чему крепятся H1–H4.

   Это правка схемы (новая цепь CHASSIS) и посадочных мест H.
2. **Изоляция у крепежа (E14):**
   - шайбы с буртиком в вырезах;
   - окна B.Mask в ≥1.5 мм от вырезов;
   - отверстие в прокладке;
   - шайбы или запрет заливки у H1–H4.
3. **Снабберы на первых платах (E15):** ставить ли LS хотя бы на одной плате.
4. **Опора CAN и датчиков Холла (E16):** развязка CAN, дроссель и разделённая терминация.
5. **Норма для ЭМС:** звон уходит на 135–150 МГц (керамика), а со снаббером — на 190–230 МГц. От нормы зависят полосы, на которые смотреть.

## Что мерить на стенде
1. На собранном узле с прокладкой и затянутыми винтами:
   - LCR-метром ёмкости «узел C/B/A — радиатор» и «VDC+GND — радиатор»;
   - сопротивление изоляции VDC и GND на радиатор при 500 В DC (до установки Y).
2. Синфазный ток токовыми клещами, 150 кГц–300 МГц:
   - где: пара DC (J4+J5), три фазы вместе, жгут J6/J7;
   - три варианта: как есть; временные Y 2 × 4.7 нФ/1 кВ с короткими выводами от J4/J5 на винт радиатора; плюс LS-снабберы.
3. Напряжение «GND платы (J6.11) — радиатор» дифференциальным щупом ≥200 МГц:
   - сравнить с диапазоном −2…+7 В у SIT65HVD232;
   - счётчики ошибок CAN под нагрузкой.
4. H-зондом по фазам:
   - частота и затухание звона без снабберов и с ними;
   - ожидаю ≈135–150 МГц и ≈190–210 МГц соответственно.
5. Тепловизором — R100–R105 и корпуса C6/C18/C11 при 48 и 72 В.
6. Кондуктивная помеха на входе DC через эквивалент сети, 150 кГц–108 МГц, с Y у платы и без.
