alsizyakin/InvertorPowerNewGen/docs/reviews/02_reply_gnd_analog.md

# Ответ на ревью 01 (аналог и МК), ветка `rev0.1-gnd`

**Где правки.**
- Коммиты: `5a5163a` (по ревью 01 и 03), `e4ee7da` (по 05), следующий — F11 и ответы.
- Скрипты: `tools/rev01_layout/lay_G3b.py` и `lay_G3c.py`.
- Запись: `CHANGELOG_rev0.1.md`, раздел «Ревью ветки `rev0.1-gnd`, раунд 1».

**Состояние после правок:** DRC — 0 ошибок, 18 неразведённых (это снабберы вне платы), 0 расхождений со схемой.

**Перепроверка утверждений ревью.**
- **S2.** Пересчитал своим растром (`tools/rev01_layout/ovl.py`), порядок величин тот же:
  - Temp_PCB_3 над D13-K — 4.77 мм² (в ревью 5.73);
  - SWCLK над U6B+ — 1.20 мм² (в ревью 1.34).

  В `rev0.1` этих наложений не было — подтверждаю.
- **S4.** 0.86 мм² — подтверждаю.
- **S3.** Номиналы по схеме: R42/R43/R56 — 120 Ом, C37/C39/C64 — 100 нФ. Подтверждаю.

---

**S1 — согласен, вопрос не разводки, решает владелец.**
- То, что AD8418 (70 В) не годится для варианта 72 В, уже записано в `REV1_TASK.md`; там же целевой усилитель для rev2 — INA241A2.
- Новое в ревью: выброс узла 83–87 В при 48 В и 120 А выходит за рабочий диапазон уже на 48 В и почти упирается в предел 85 В.
- Замер на U4.8/U4.1 относительно U4.2 добавляю в список стенда.

**S2 — сделано (F1).**
- Temp_PCB_3 целиком вернул на In2. Плоскость +3.3V не рвётся (проверено DRC).
- SWD — на In2 от y ≈ 118 вниз, на всём участке вдоль U6. Новые переходные виа — (120.75, 118.5) и (122.0, 117.75).
  - Участок у J6 (y 111.9–118) остался на In4. Под ним на B.Cu аналоговых цепей нет.
  - На In2 этот участок отрезал бы на остров виа FB7 (121.25, 113.75), через которую FB7 садится на плоскость. Проверено пробой со всей SWD на In2: DRC даёт «не соединено» FB7.
- **Результат:** над входами U6, D13-K, D24-A и D7 на In4 больше ничего нет (было 0.5–4.8 мм²).
- **Остались на In4 над аналогом B.Cu:**
  - VDC_MCU над Current_measure_3 — 2.81 мм². На этом узле стоит 100 нФ, по вашей оценке это микровольты.
  - Temp_PCB_1/2 над D13-K — 0.38 и 0.62 мм², это пересечения. На In2 эти линии отрезают D16/D17 от плоскости — проверено.
  - +12V над REF1 — 0.9–1.2 мм², одинаково во всех трёх фазах.

**S3 — подтверждаю, решает владелец.**
- C37/C39/C64 стоят на листах Current_Sensor, а не на замороженном листе OCP, так что вариант «1–2.2 нФ» делается правкой схемы.
- Это меняет фильтр перед АЦП и требует ответа владельца и сверки с временем выборки в прошивке.

**S4 — сделано (F2).**
- Под HI драйверов D4 и D6 на In1 стоят местные зоны GND с приоритетом 40 — выше, чем у Phase_OUT: x 127.6–129.4 и 148.9–152.7, y 103.1–105.4.
- Проверка F.Cu ↔ In1 через `ovl.py`: под всеми HI/LI теперь только GND.
- Цена: Phase_OUT A на In1 95.4 → 90.0 мм².
- `hidist.py` не дополнял. Межслойную проверку делает `ovl.py <board> F.Cu In1.Cu … HI,LI`.

**S5 — сделано частично (F6, F8).**
- GND на In4 — 11 → 8 кусков.
- Острова под U4/U9 (55 мм²) и под U12 (30 мм²) теперь на двух виа.
- На одной виа остался только островок 9 мм² в блоке, у LO B (x 136.5–138.1, y 85.4–92.9). Места под вторую виа там нет: поиск `check_items` ничего не нашёл.
- Куски по 0.3 мм² — это кольца виа, а не острова.
- По краю части управления добавлена 21 сшивающая виа (E8 ревью 03).

**S6 — сделано (F7).**
- Спуск +12V фазы A идёт по оси шунта x 154.7, как у C (130.7) и B (142.75). GND-виа (154.8, 108.0) перенесена в (155.7, 108.0).
- U2+ и U3+ ниже блока ушли на In2, от линий Кельвина их отделяет In3.
- Чтобы они не пересекали линии +3.3V NTC, те в местах пересечения перешли на In4:
  - B — вставка (147.2, 100.85…103.6);
  - A — от (159.26, 101.25) в плоскость через виа (156.4, 104.5).
- Над линиями Кельвина (дорожки B.Cu от шунта к выводам 1/8) на In4 теперь 0.09 мм² (+12V по оси пары) и 0.15 мм² (+3.3V A). Было 0.8–1.8 мм² от U2+, U3+ и +12V.

**S7 — согласен.** 100 нФ у VDD — правка схемы, решает владелец.

**S8 — принимаю, не менял.** Ревью 05 (P8) оценивает это в 0.15–0.2 нКл за фронт против Qgd 2 × 32 нКл, меньше 0.5 %. Запрет заливки B.Cu под LO снял бы медь узла на пути к шунтам — см. ответ 04, E4.

**S9 — для прошивки.** Знак тока фазы A записал в открытые вопросы.

**S10 — согласен.**

**Остаётся открытым:** S1, S3, S7 и S8/E4 — решения владельца; S9 — прошивка.
