alsizyakin/InvertorPowerNewGen/docs/reviews/04_reply_gnd_emc.md

# Ответ на ревью 03 (ЭМС), ветка `rev0.1-gnd`

**Где правки.**
- Коммиты: `5a5163a`, `e4ee7da`, следующий — F11 и ответы.
- Скрипты: `tools/rev01_layout/lay_G3b.py` и `lay_G3c.py`.
- Запись: `CHANGELOG_rev0.1.md`, раздел «Ревью ветки `rev0.1-gnd`, раунд 1».
- DRC после правок: 0 ошибок, 18 неразведённых (снабберы), 0 расхождений со схемой.

**Перепроверка утверждений ревью.**
- **E5.** D6-HI над Phase_OUT на In1 — 0.86 мм². Подтверждаю.
- **E6.** HO A на F.Cu в 0.29 мм от кромки правого выреза. Подтверждаю.
- **E9.** Наложения In4 на B.Cu: того же порядка, что в ревью 01.
- **E1.** Ёмкости «узел — радиатор» не пересчитывал: без данных о прокладке это всё равно оценка.

---

**E1 — решает владелец.** Схема заземления радиатора — системное решение.
- Что сделано: затворная линия HO A убрана из-под шайбы (F3, см. E6).
- Кольцо GND вокруг вырезов требует отвести медь узла C/A и поле виа узла A — это Р8.
- Без решения владельца не делаю.

**E2 — согласен.**
- Пересчёт мощности: 4.7 нФ · 48² · 20 кГц = 0.22 Вт, при 72 В — 0.49 Вт.
- Вариант «+3 мм с R 0805» снимаю.
- Геометрию и номиналы снаббера для +4 мм пересмотрю вместе с 05 P2, когда будет решение по длине:
  - средняя точка — островок вместо дорожки;
  - R — 2 × 1206 по 1 Ом или 0612.

**E3 — решает владелец.**
- Бусина и 100 нФ у J6.1–4 — правка схемы корневого листа, его в этой ветке не трогаем.
- Запрет заливки узла вдоль дорожки VDC на In2 снимает медь узла C в горловине. Там, по 05 P7, и так 12.1 мм ширины меди против 12.9 мм в rev0.
- Выношу вместе с фильтром.

**E4 — оставил как есть, решает владелец.**
- 05 P8: наводка 0.15–0.2 нКл за фронт против Qgd 2 × 32 нКл, меньше 0.5 %.
- 01 S8: «принять».
- Запрет заливки B.Cu полосой 1.2–1.5 мм под LO и линиями NTC снимает медь узла в проходах, а это путь тока к шунтам.

**E5 — сделано (F2).**
- Под HI D4 и D6 на In1 — местные зоны GND с приоритетом выше Phase_OUT.
- Под всеми HI/LI на In1 теперь только GND (`ovl.py`).

**E6 — HO A сделано (F3), остальное решает владелец.**
- Обход HO A по F.Cu у выреза и его виа (162.1, 92.9) сняты.
- Затвор нижнего HS A теперь питается ветвью по In4 вдоль y 89.4 под колонкой стока, через виа (166.66, 89.4) у R3.1 — так же, как HO C идёт по In4 вдоль y 90.65.
- Ближайшая к вырезам затворная линия — LO C на In4, в 1.39 мм. На F.Cu и B.Cu у вырезов затворов нет.
- Отвод меди узла от края и от J6/J7 — решает владелец: это затрагивает поле виа узла A (Р8).

**E7 — сделано (F7).**
- U2+ и U3+ ниже блока — на In2, за слоем In3.
- Спуск +12V A — по оси шунта, как у C и B.
- Над линиями Кельвина на In4: 0.09 мм² (+12V по оси пары) и 0.15 мм² (+3.3V A). Было 0.8–1.8 мм².
- Окружение пар теперь одинаковое в трёх фазах.

**E8 — сделано (F6, F11).**
- 21 сшивающая виа GND: 17 по краю части управления (шаг ≥ 3 мм, 0.9–1.5 мм от края) и 4 у земляных выводов J6/J7.
- Плоскость +3.3V на In2 отодвинута на 1 мм от левого, правого и нижнего края: 1525 мм², один кусок.
- У скруглений под H3/H4 зазор до края по-прежнему задаёт общее правило 0.25 мм.

**E9 — сделано (F1, F8).**
- Temp_PCB_3 и участки SWD вдоль U6 ушли на In2. Над входами компаратора OCP на In4 ничего нет.
- Остров In4 под U4/U9 получил вторую виа.
- На одной виа остался только островок 9 мм² в блоке, места под вторую виа там нет.

**E10 — согласен, для сведения.** Ту же разницу фазы B нашёл 05 (P4). Перенести 26 виа узла B ниже нельзя, см. ответ 06.

**E11 — согласен, оставляю.** 05 P8: по индуктивности это то же, что было на In3/In4 (~0.78 нГн/мм).

**E12 — решает владелец.** Это схема и, возможно, уже сделано на соединительной плате.

**Остаётся открытым:** E1, E3, E4, E6 (медь узла у края), E12 и длина платы с номиналами снаббера (E2) — решения владельца.
