alsizyakin/InvertorPowerNewGen/docs/reviews/06_reply_gnd_power.md

# Ответ на ревью 05 (силовая часть), ветка `rev0.1-gnd`

**Где правки.**
- Коммит `e4ee7da` (F9, F10), правки по 01/03 — `5a5163a`.
- Скрипт: `tools/rev01_layout/lay_G3b.py`.
- Ваш скрипт зазоров добавлен в репозиторий как `tools/rev01_layout/hv.py`.
- DRC после правок: 0 ошибок, 18 неразведённых (снабберы), 0 расхождений со схемой.

**Перепроверка утверждений ревью.**
- **P4.** Виа узла под нижним рядом (y 88.45–90.1): C 0, B 26, A 8. Подтверждаю.
- **P5.** Ваш `hv.py` на `115276c` дал 29 мест. Худшие 0.225 мм (C124.1/C128.1) и 0.23 мм (C7/C8 ↔ HI) подтверждаю по геометрии пэдов.
- **P6.** C7–C9 — 1 мкФ 1206, в поле Description P/N указано «50V». Требование ≥ 25 В выполнено.
- **Д3.** Ваш вывод совпадает с геометрией: R_gs не стоят у верхней кромки блока, где ищутся места под снабберы.

---

**P1 — сделано частично (F10).**
- **C132:** вторая виа GND (167.31, 82.15) у внутренней кромки GND-пэда, рядом с имеющейся (167.21, 81.15). Снаружи пэда места нет: поиск `check_items` в радиусе 1.5 мм дал только места под пэдом.
- **C124/C128:** виа и так стоят у внутренних кромок пэдов, в 0.04 мм от края, в промежутке между пэдами. «Дорожка 1.1 мм» — это подвод от центра пэда к его углу. GND-пэд к тому же слит с полосой GND соседней фазы. После F9 GND-пэд ушёл в полосу ещё на 0.3 мм. Больше здесь ничего не делал.
- **≥ 2 × 1206 в полосе +4 мм и 0612 обратной геометрии** — после решения по длине платы.
- **Окна под D-пэдами** — это футпринт (Р8), не трогаю.

**P2 — согласен, решает владелец (вместе с длиной).**
- Если плату удлинят, полоса заполняется так:
  - LS-снаббер в компактной геометрии: средняя точка — медный островок ≥ 1.2 мм, R — 2 × 1206 по 1 Ом или 0612;
  - 2 керамики на фазу;
  - HS-снаббер — место без установки.
- Ваша оценка ветки U-образной пробы (~2.2 нГн) снимает мою оценку −35 %. В CHANGELOG пробы +4 мм это нужно уточнить при её выполнении.
- **Д3:** предлагаю владельцу снять его из задания — R_gs остаются у затворов.

**P3 — согласен.**
- Замер выброса HS (P2) и эмуляцию Кельвина проводом на rev0 добавляю в список стенда до заказа.
- R_on для HO и LO и так отдельные детали: R106–R108 и R112–R114.

**P4 — проверил, решает владелец.**
- Перенести 26 виа узла B ниже y 90.6 нельзя: свободных мест в поле узла B там два. Поиск `check_items`: виа 0.6/0.3 с посадкой на заливку узла F.Cu и B.Cu.
- Остаются два пути, оба затрагивают решения владельца:
  - убрать эти 26 виа — против Р8;
  - сдвинуть часть поля в проход J1–J2 — съест мост In3 0.9 мм, то есть Р13.

**P5 — сделано в части худших мест (F9).**
- C124/C128 сдвинуты на +0.3 мм по x вместе с VDC-виа и подводами. VDC-пэд теперь в 0.53 мм от R19.2/C100.1 и R30.2/C104.1 (было 0.225). GND-виа остались на месте: на сдвинутом месте у C124 она подходила к C106.1.
- C7/C8/C9 сдвинуты на −0.3 мм по x. Дорожки HI соседнего драйвера теперь в 0.53 мм (было 0.23). Все концы дорожек остались внутри пэдов. C9 сдвинут ради одинаковости фаз.
- По `hv.py`: мест меньше 0.5 мм — 30 → 24.
- **Оставшиеся места:**
  - 0.27 мм — шаг J6 до свободных выводов;
  - 0.281 мм — C_gs верхнего HS ↔ D-пэд нижнего HS. Сдвиг C_gs тянет за собой R_gs, а на его пэде стоит NT (Кельвин) — не делал;
  - 0.325 мм — R23/R28/R34 ↔ линии NTC;
  - 0.35 мм — GND U4/U9/U12 ↔ HO_DRV на B.Cu.
- Правило `.kicad_dru` на 0.5 мм не добавлял: DRC сразу даст 24 ошибки. Сначала нужно решение владельца — лак или правки.

**P6 — принято.**
- C0G 10 нФ учту при выполнении Д1.
- Наброс на затвор при C_gs в 3–4 мм от выводов — в список стенда.

**P7 — согласен.**

**P8 — согласен.** Это закрывает открытый вопрос CHANGELOG о парах HO/SW, разделённых слоем In3.

**Остаётся открытым:** P1 (керамика в полосе +4 мм), P2, P4, P5 (24 места: лак или геометрия) — решения владельца; P3 и P6 — стенд.
