alsizyakin/InvertorPowerNewGen/docs/reviews/01_review_gnd_analog.md

# Ревью разводки `rev0.1-gnd` (`115276c`): аналоговая часть — датчики тока, NTC, МК, входы драйверов

*Ревьюер: субагент «электронщик: аналог, смешанный сигнал, МК», 2026-10-17. Текст — как получен.*

**Вердикт.** Для аналоговой части перенос дорожек с In3 в целом безопасен:
- всё, что ушло на In2 (ADC_IN_1/2, TMR1_CH1/2, D24-A, D13-K), стало полосковой линией между GND In1 (0.485 мм) и GND In3 (0.1 мм) — 100 % длины над землёй;
- плоскость +3.3V — один кусок 1717 мм² без горловин;
- на копии подтверждены DRC 0 ошибок / 18 неразведённых / 0 расхождений и ERC 9 (база).

**Главный регресс.** Дорожки, ушедшие на In4, теперь лежат в 0.1 мм над аналоговыми цепями B.Cu (OCP U6, Current_measure, REF/VS AD8418). В rev0.1 между ними был экран In4 GND, а In4 GND под аналогом распался на острова, часть из которых держится на одной виа. Связи получаются по ёмкости малыми (0.2–2.3 пФ); практический риск — ложный BKIN от SWD около порога.

**Самое серьёзное в датчиках тока — не от переноса.** Синфазный диапазон AD8418 (−2…+70 В) ниже выброса узла со стенда (83–87 В) и не допускает вариант 72 В. Перед компаратором OCP стоит RC с τ = 12 мкс.

Ёмкости ниже — плоский конденсатор, εr 4.5 из стека платы: 0.40 пФ/мм² при 0.1 мм, 0.08 пФ/мм² при 0.485 мм. Краевые поля не учтены (+30–60 %), так что это нижние оценки.

---

## Находки

### S1 — высокая для 72 В, средняя для 48 В. Синфазное напряжение AD8418 против выброса узла
- **Где.** U4/U9/U12 (B.Cu, y 107.25). Входы — прямо на узле и втулке, последовательных R нет: U4.8 = Phase_IN C, U4.1 = Phase_OUT C.
- **Данные.**
  - AD8418: рабочий диапазон синфазного −2…+70 В, выживание −4…+85 В (даташит, по поисковой выдаче).
  - По поисковой выдаче, у AD8418A ADI PCN 18_0156 снижает предел до −3…+80 В; сам PCN открыть не удалось.
  - В BOM — просто «AD8418», без суффикса.
  - Стенд (REV0_1_TASK A, Д): выброс при выключении LS 83–87 В при 120 А; при 60 А перерегулирование 20–26 В, то есть пики 68–74 В.
- **Следствие.**
  - 48 В, 120 А: пики выходят за рабочий диапазон и упираются в предел выживания. После каждого выключения LS выход может восстанавливаться с ошибкой.
  - 72 В: шина выше рабочего диапазона уже по постоянному напряжению.
- **Рекомендация (решает владелец).**
  - Для 72 В нужен усилитель с синфазным ≥ 100 В (класса INA241, −5…+110 В). Распиновку и посадочное место я не сверял.
  - Для 48 В снять напряжение прямо на выводах U4.8/U4.1 относительно U4.2 при 120 А (на стенде мерили у LS, у усилителя — нет). Учесть это в решении по снабберам §5.

### S2 — средняя (регресс). In4 над аналогом B.Cu: экран снят, связь через 0.1 мм
- **Что.** В rev0.1 перенесённые цепи лежали на In3, и под ними на In4 была заливка GND:
  - SWCLK_IN 27.0 мм из 27.6, SWDIO_IN 26.2 мм, Temp_PCB_3 36.6 мм, VDC_MCU 24.1 мм, +12V 60.6 мм.
  - Теперь они сами на In4, и ближайший проводник — B.Cu в 0.1 мм. In3 GND остаётся выше, в 0.485 мм.
- **Наложения In4 → B.Cu** (`ovl.py`, мм² → пФ):

  | Источник помехи (In4) | Жертва (B.Cu) | мм² | пФ | Где |
  |---|---|---|---|---|
  | SWCLK_IN | U6B+ (порог) | 1.34 | 0.53 | x 125.0, y 133–136 |
  | SWCLK_IN | D24-A (узел min) | 1.34 | 0.53 | около (120.25, 120.3) |
  | SWCLK_IN | U6A− (порог) | 0.81 | 0.32 | около (124.1, 128.6) |
  | SWDIO_IN | D13-K (узел max) | 1.41 | 0.56 | около (125.75, 128.9) |
  | SWDIO_IN | D7.1 = OUTB U6 | 1.01 | 0.40 | около (123.2, 125.5) |
  | Temp_PCB_3 | D13-K | 5.73 | 2.3 | 10.5 мм, x 138–150, y 118.75–121 |
  | VDC_MCU | Current_measure_3 | 3.47 | 1.4 | 5.6 мм, около (136–142, 119.5–120.5) |
  | +12V | REF1/VS U4 / U9 / U12 | 1.64 / 1.80 / 1.24 | 0.5–0.7 | ряд C36/C38/C63, y 110.5–111.5 |
  | +12V | U4-OUT, U1+ | 0.72, 1.35 | 0.29, 0.54 | там же |

- **Доля длины B.Cu-цепей над In4 GND:** в rev0.1 было 100 %, теперь:
  - D13-K — 47 % (17.3 из 37 мм);
  - D24-A — 71 %;
  - U6B+ — 64 %;
  - Current_measure_3 — 67 %;
  - REF1 U9 — 38 %, REF1 U12 — 46 %.
- **Следствие.**
  - Почти у всех жертв на выводе стоят 100 нФ (REF1, Current_measure, NTC, пороги), там наводки — микровольты.
  - Исключение — узлы max/min D13-K и D24-A на входах TLV3502 (4.5 нс): там только 10 кОм и BAT54WS.
  - Грубая оценка: фронт SWD 3.3 В через 0.5 пФ на собственные ~25–30 пФ узла (переходы трёх диодов) даёт выброс ~50–100 мВ длительностью в несколько нс. Это ≈ 8–15 А по шкале 6 мВ/А.
  - Ложный BKIN возможен, только когда SWD активен (отладчик, live watch на стенде), а ток в пределах ~10–15 А от порога.
- **Рекомендация.**
  - Минимум: переложить на In4 участки SWCLK_IN/SWDIO_IN, которые идут вдоль входов U6 (x 120–126, y 119–136). Пересекать U6 поперёк над выводами 5 (V−) и 8 (V+), а не над 1–4. Temp_PCB_3 сдвинуть с D13-K на ≥ 1 мм вбок.
  - Полностью (решает владелец): вернуть SWD и Temp на In2 другим путём, чтобы не отрезать FB7/D16 (в CHANGELOG отрезала исходная трасса, а не сам слой), и восстановить In4 GND над узлом OCP.
  - На In2 TMR1_CH1 идёт вдоль D24-A 6–7 мм с зазором 0.48 мм. Так было и на In3; при опоре в 0.1 мм это не критично.

### S3 — средняя (схема, было с rev0). OCP стоит за фильтром с τ = 12 мкс
- **Где.** U4.OUT → R42 120 Ом → Current_measure_3 → C37 100 нФ → диоды max/min D13–D26 → U6 → D7 → R51/C56 → BKIN. Так же в фазах B (R43/C39) и A (R56/C64).
- **Данные.**
  - τ = 120 Ом × 100 нФ = 12 мкс, f−3дБ = 13.3 кГц.
  - Пороги: U6A− = 3.3·18/23.6 = 2.52 В; U6B+ = 3.3·0.75/3.15 = 0.79 В.
  - При 6 мВ/А, середине 1.65 В и Vf BAT54WS ≈ 0.25 В срабатывание ≈ ±185 А.
- **Следствие.** Компаратор на 4.5 нс стоит за фильтром на 12 мкс. При нарастании 10–50 А/мкс (КЗ на выходе) ток к срабатыванию превысит порог на 120–600 А.
- **Рекомендация (решает владелец).** Если OCP должна защищать от КЗ, а не только от перегрузки:
  - уменьшить C37/C39/C64 до 1–2.2 нФ (АЦП при 120 Ом это допускает; сверить с временем выборки);
  - или брать max/min с выхода усилителя до R42. Это правка на листе OCP, а он заморожен.

### S4 — низкая–средняя (с rev0.1, `hidist.py` её не видит). Вход HI драйвера D6 над узлом A на In1
- **Где.** Пад C120.2 и дорожка HI на y 104.10, x 149.30–151.05, y 103.63–104.23. Под ними в 0.1 мм — заливка In1 `/Current_Sensor_1/Phase_OUT`: её край y 104.25, это узел A через шунт.
- **Данные.**
  - D6-HI: 0.85 мм² ≈ 0.34 пФ к узлу. D4-HI: 0.15 мм² (x 128.33–128.78). У D5 перекрытия нет.
  - В rev0 перекрытия не было (TMR1_CH1 целиком над In1 GND). Появилось при перекладке §6 под C120.
  - `hidist.py` меряет только F.Cu и показывает 2.03 мм.
- **Следствие.** Прямая ёмкостная связь узла со входом HI — ровно механизм гипотезы просадки узла (BENCH §3.4). По амплитуде мала: ~3 мА при 10 В/нс.
- **Рекомендация.**
  - Запрет заливки на In1 для Phase_OUT A в окне x 149–153, y > 103.3 (≈ −4 мм² медь шунт → втулка). То же у D4: x 127.8–129.
  - Добавить в `hidist.py` проекцию на In1.

### S5 — низкая. In4 GND под аналогом раздроблен
- **Данные.**
  - Площадь In4 GND в окне x 116–170, y 98–140: 1728 → 1385 мм² (−20 %).
  - Новые острова, висящие на одной виа:
    - 7.0 мм² под U6 (x 120.8–125.2, y 119.7–128.9);
    - 22.4 мм² под выводами 5–8 U9 (x 138.0–141.4, y 100.9–110.1);
    - 5.9 мм² (x 153.2–155.2, y 104.0–110.7);
    - 9.2 мм² в блоке (x 136.5–138.1, y 85.4–92.9);
    - 1.0 мм² (x 144.7–146.4, y 117.8–118.5).
  - Остров 16.1 мм² под U12 (x 150.5–153.4, y 103.7–110.1) — на двух виа.
  - Полоса +12V (y 110–111.5, x 118–158) отрезает ряд усилителей от остальной In4 GND.
- **Рекомендация.** Вторая виа GND на каждый остров ≥ 5 мм² там, где на B.Cu нет пэдов. Мелкие острова убрать настройкой зоны.

### S6 — низкая. Фазы несимметричны в окружении усилителей тока
- **+12V к диоду бутстрепа.** Взаимная индуктивность (интеграл Неймана, обратный ток — в In3) с петлёй «шунт — линии Кельвина — входы»:
  - C ≈ 0 (спуск по x 130.70 — ровно по оси пары);
  - B 0.02 нГн;
  - A 0.25 нГн: спуск уходит наискось (154.70, 103.25) → (156.0, 104.55), пересекает линию IN− и идёт над выводами 1–4 U12.
- **NTC над линиями Кельвина.**
  - U2+ (x 141.85) лежит прямо над IN+ фазы B (x 141.95) на 4.0 мм; U3+ (x 153.85) — над IN+ фазы A на 3.7 мм. По 1.09 мм² ≈ 0.43 пФ.
  - В фазе C NTC идёт в проходе, мимо усилителя.
- **Следствие.** Импульс в выходе фазы A — двуполярный, среднее ≈ 0; при RC 12 мкс он практически не виден. Но фазы перестают быть одинаковыми по смещению и шуму.
- **Рекомендация (если трогать In4).**
  - Спуск +12V фазы A провести прямо вниз по x 154.70, как в C/B. Это требует сдвинуть U3+: сейчас зазор ~0.2 мм.
  - U2+/U3+ проводить поперёк пары, а не вдоль IN+.

### S7 — низкая. Распределение +12V на драйверы
- **Данные.**
  - In4, 1.0 мм, всего 77 мм; от J6.7–10 до D6 ≈ 40 мм ≈ 20 мОм. Средний ток — десятки мА, падение — единицы мВ.
  - Локально у каждого драйвера только C1/C2/C3 10 мкФ 0805 50 В (BOM). От C1.2 до D4.5 3.1 мм по F.Cu, земля через виа у C1.1 и D4.3.
  - Ток подзаряда бутстрепа идёт по вертикальным отводам In4 над U4/U9/U12 (S6).
- **Вывод.** Сечение и путь в порядке.
- **Рекомендация (решает владелец).** Опционально — 100 нФ 0603 у каждого вывода VDD. Учесть просадку ёмкости 10 мкФ 0805 под постоянным смещением 12 В.

### S8 — низкая. LO C сильнее связан со своим узлом
- **Данные.** Перекрытие LO с медью своего узла через 0.1 мм:
  - LO C: 4.5 → 7.74 мм² (≈ 1.8 → 3.1 пФ). LO на In4 над B.Cu Phase_IN C в проходе C.
  - LO B 6.4 → 6.4, LO A 7.1 → 7.1 — без изменений.
- **Следствие.** При 10 В/нс ≈ 31 мА в цепь LO, ~55 мВ на точке X. Это 2–4 % от наброса на затвор, измеренного на стенде (1.3–3.4 В).
- **Рекомендация.** Принять. При правке прохода C — сместить LO C с пура узла на B.Cu.

### S9 — низкая. Полярность фазы A обратная (информация, так с rev0)
- **Где.**
  - U12.8 (IN+) = Phase_OUT A (втулка), U12.1 = Phase_IN A.
  - У U4/U9 наоборот: IN+ = Phase_IN.
- **Следствие.** Знак тока фазы A должна инвертировать прошивка. OCP — окно max/min, на неё это не влияет.
- **Рекомендация.** Подтвердить в прошивке.

### S10 — низкая (приемлемо). Линии NTC
- **Данные.**
  - На перенесённых участках связь с медью узла через 0.1 мм у C и A прежняя: U1+ 5.79 → 5.73 мм², его +3.3V 6.02 → 5.95 мм², U3+ ~2.5 мм².
  - У B выросла: U2+ 2.99 → 5.20 мм².
  - На In4 они идут вдоль +12V (U2+ 11.6 мм с зазором 0.25 мм, U3+ 5.1 мм с зазором 0.2 мм), а +3.3V к TH1 — вдоль LO C (4.4 мм, 0.25 мм).
  - Фильтр на месте: C14/C16/C19 100 нФ в ≤ 2 мм от U1+/U2+/U3+, линия входит через узел R20/C14.
- **Следствие.** ~±1 мВ на фронт, знак чередуется, среднее ≈ 0. На температуру не влияет.

---

## Что хорошо
- **In3** — сплошная GND 4085 мм² одним куском. Сопротивление земли между AD8418 (её REF2 = локальная GND) и VSSA МК стало меньше.
- **Сигналы на In2** — полосковая линия, 100 % длины над GND с обеих сторон, кроме вырезов вокруг виа. Переходные виа — в 1.0–4.5 мм от ближайшей виа GND.
- **+3.3V на In2:**
  - один кусок; прорези TMR1/D24-A и ADC_IN — внутренние;
  - с верхней полосой (FB7–FB12) плоскость связана слева (x 116.5–127) и справа (x 158.5–169);
  - пара In2/In3 через 0.1 мм даёт ≈ 0.68 нФ межслойной ёмкости;
  - развязка U5 не менялась.
- **Линии Кельвина:**
  - от внутренней кромки пэда шунта, 0.5 мм, шаг пары 1.5 мм, ~5.5 мм каждая;
  - геометрия одинакова во всех трёх фазах;
  - заливкой своей цепи не поглощены (0.02–0.03 мм из 5.5).
- **HI/LI:** на F.Cu 100 % над In1 GND (кроме S4); `hidist.py` 2.09 / 2.11 / 2.03 мм — без изменений.
- **HO C и HO B в проходах:** перекрытие с медью узла соседней фазы прежнее (3.22 / 3.26 мм²), но теперь через 0.485 мм вместо 0.1 мм: ≈ 1.3 → 0.27 пФ. Остаётся боковой зазор 0.25 мм к заливкам узлов B/A на In2 по 12 мм. Цена — пара HO/SW разделена слоем In3; это уже записано в CHANGELOG.
- **U6 TLV3502:** распиновка символа сверена с TI SBOS321E (1 +IN A, 2 −IN A, 3 +IN B, 4 −IN B, 5 V−, 6 OUT B, 7 OUT A, 8 V+) — верна. 8 ошибок ERC — только продублированные выводы NC.
- **Связность:** GND одна сеть (`gndconn.py`: известный пэд 0.5 мм² у C107). DRC 0 / 18 / 0, ERC 9.

## Что добавить в стендовые проверки
1. Напряжение на U4.8/U4.1 (и U9, U12) относительно U4.2 при выключении LS на 60 и 120 А. Выход U4.5 до R42 — время восстановления после выброса (S1).
2. Смещение и шум трёх каналов тока при ШИМ и 0 А — сравнить фазы (S6), с SWD отключённым и с активным live watch (S2).
3. OCP:
   - задержка от пересечения порога по Current_measure до BKIN на ступеньке или пилообразном тестовом сигнале — ожидаю ≈ τ (S3);
   - пики на U6.1/U6.4 при работающем SWCLK (S2).
4. HI у вывода D6.1 на фронтах узла A против D5.1 — с C120 и без (S4).
5. Пульсации на выходах U1–U3, синхронные с ШИМ (S10).

**Не проверено:** сам ADI PCN 18_0156 (не открылся); пороги входов NSD1624; ёмкости — нижние оценки, а собственная ёмкость узлов max/min (~25–30 пФ) — грубая.
