alsizyakin/InvertorPowerNewGen/docs/reviews/03_review_gnd_emc.md

# Ревью ЭМС: ветка `rev0.1-gnd` (`115276c`), сравнение с `rev0.1` (`cebc037`) и rev0 (`main`)

*Ревьюер: субагент «специалист по ЭМС», 2026-10-17. Текст — как получен.*

**Вердикт.** Сплошной In3 в целом улучшает ЭМС, и по ЭМС его стоит принять:
- пустоты In3 сократились с 1234 до 775 мм², 41–43-миллиметровые прорези от дорожек исчезли;
- связь плоскости +3.3V и линий термисторов с узлом стала меньше, чем в rev0, примерно в 2.5–3 раза.

Почти все сигналы (ШИМ, HI/LI, CAN, SPI, выходы датчиков тока) идут над сплошной землёй. Главные риски ЭМС создало не это изменение:
- **(1)** не определён путь синфазного тока через радиатор: медь узла на B.Cu под радиатором, медь узла вокруг вырезов под винты;
- **(2)** звон 125–139 МГц не демпфирован, мест под снабберы на рабочей плате нет;
- **(3)** VDC уходит на J6 без фильтра, и отвод взят в самой шумной точке.

Изменение внесло четыре новых мелких недостатка:
- линии LO C и NTC C на In4 лежат над медью узла на B.Cu;
- кельвиновские пары шунтов потеряли одинаковое окружение;
- на In4 появились островки на одной виа;
- две линии на In4 идут параллельно дорожкам B.Cu на 10.4 и 5.5 мм.

Вариант «+4 мм» по ЭМС поддерживаю, но номиналы и мощность резистора снаббера нужно поправить.

**Как проверял.** Все 6 слоёв трёх ревизий переведены в растр с шагом 0.05 мм. Ёмкости посчитаны по перекрытию соседних слоёв, ε0·4.2·S/d, без краевых полей. Скрипты и картинки — в `/tmp/claude-1000/-home-alexey-Git-KiCad-InvertorPowerNewGen/b297bce8-a27b-4b43-a5c5-acb44f8d7330/scratchpad/rev_emc/`.

Чего не знаю:
- dv/dt узла не измерено. Беру 5–15 В/нс: стенд дал спад тока около 6 нс, ΔV 33–37 В;
- нет данных о радиаторе, прокладке (TIM) и винтах. В `3D/Invertor_v1.0.step` радиатора нет.

---

## Находки

### E1 — высокая. Путь синфазного тока через радиатор не определён

**Где.** B.Cu в окне маски y 74.25–100.45, отверстия H1–H4, вырезы под винты с центрами (119.0, 95.5) и (166.5, 95.5), радиус 2.75 мм.

**Факты.**
- Медь узла (Phase_IN + Phase_OUT) на B.Cu в окне: C 218 / B 205 / A 250 мм².
- Из неё под открытой маской, то есть прямо на прокладке: Phase_IN 116 / 99 / 136 мм² и Phase_OUT 7 / 25 / 21 мм², всего около 403 мм².
- В том же окне VDC 271 мм² (открыто 99) и GND 164 мм² (открыто 0.9).
- Ёмкость «узел — радиатор» на фазу:

  | Прокладка | Ёмкость на фазу |
  |---|---|
  | 0.5 мм, εr 6 | 23–28 пФ |
  | 0.2 мм, εr 5 | 45–55 пФ |
  | 0.1 мм, εr 4.5 | 82–100 пФ |

- При 10 В/нс это 0.2–1 А пикового тока на каждый фронт. На частоте звона 130 МГц сопротивление 50 пФ около 24 Ом.
- Если радиатор плавает, на нём остаётся около 9–11 В ступеньки на каждый фронт фазы: доля узла в ёмкостях 218–250 из 1108 мм², умножить на 48 В.
- H1–H4 — неметаллизированные отверстия, меди нет в радиусе 3.5 мм ни на одном слое. Связать землю платы с корпусом негде.
- Вокруг вырезов под винты, в радиусе 4.75 мм (под головкой или шайбой), лежит узел, а не земля:
  - слева: узел C на F.Cu 12.1 мм², на B.Cu 20.8 мм²; GND 2.1 / 2.3 мм²;
  - справа: узел A на F.Cu 18.4 мм², на B.Cu 22.2 мм², плюс HO фазы A 1.9 мм²; GND 0.
  - Узел у вырезов был и в rev0, HO A — новое (см. E6).

**Последствие.**
- Звон и фронты узла уходят синфазным током через радиатор: излучение 30–230 МГц и кондуктивная помеха по шинам.
- Если винты металлические, между узлом и радиатором только паяльная маска. Для варианта 72 В это и вопрос надёжности.

**Рекомендация — решает владелец (схема заземления системы).**
- Предпочтительно связать радиатор с GND по ВЧ прямо у блока:
  - вокруг обоих вырезов кольцо GND на F.Cu и B.Cu, по 6–8 виа к In1/In3/In4;
  - металлический винт с зубчатой шайбой;
  - если гальваническая связь с DC− запрещена — места под 2 конденсатора Y (1206, 4.7–10 нФ, DNP) от кольца GND к изолированной площадке винта.
- Как минимум отвести медь узла от вырезов на радиус шайбы + 0.5 мм. Это около 20 мм² на сторону; проверить плотность тока к шунту.
- Измерить ёмкость «узел — радиатор» на собранном узле с прокладкой.

### E2 — высокая. Звон 125–139 МГц без демпфирования; места под снабберы есть только в пробе «+4 мм»

**Факты.**
- Отношение выброса к L·di/dt около 1.85 — звон почти не затухает.
- На рабочей плате C112–C117 и R100–R105 вне контура (18 неразведённых).
- В пробе +4 мм цепочки встают в 1.3 / 1.4 мм от выводов во всех фазах.
- Мощность на R снаббера P = C·V²·f:
  - 4.7 нФ, 48 В, 20 кГц — 0.22 Вт;
  - при 72 В — 0.49 Вт, то есть 98 % от 0.5 Вт у 1206, без запаса на температуру;
  - вариант «+3 мм, R 0805» (0.125–0.25 Вт) перегружен уже при 48 В.
- Индуктивность ветви снаббера — оценка 1–2 нГн: U-образная пара C 0805 + R 1206, центры в 2.4 мм (`snub_plus4_ext_a.json`). Это сопоставимо с L петли около 1 нГн. На 130 МГц X_L около 0.8–1.6 Ом против R 0.51 Ом, поэтому демпфирование будет частичным. Это оценка, не проверено.
- Плата +4 мм прибавляет к узлу на F.Cu около 21 мм² на фазу (+10 %) — несущественно.

**Последствие.** Звон 130 МГц — основной источник излучения: через кабели фаз, радиатор (E1) и шину. От него же зависит запас для варианта 72 В.

**Рекомендация.**
- По ЭМС поддерживаю +4 мм: снабберы LS и HS во всех фазах плюс второй 1206 на фазу.
- Номиналы снаббера:
  - либо C 2.2–3.3 нФ (1.5–2 × Coss). Получается 0.10–0.15 Вт при 48 В и 0.23–0.34 Вт при 72 В, R 0.5–0.8 Ом;
  - либо оставить 4.7 нФ, но R 2010/2512 или два 1206 параллельно.
- Выбор — по опыту Д1 на платах rev0. Проверить затухание звона и температуру R тепловизором.
- Зазор в букве U держать минимальным.

### E3 — средняя/высокая. VDC на соединительную плату взят из петли коммутации, без фильтра

**Где.** Дорожка In2 0.4 мм, 20.3 мм:
- начинается в (129.0, 91.0) — низ колонки стока HS фазы C, рядом с Q7;
- идёт через проход C внутри заливки узла C на In2 с зазором 0.25 мм;
- приходит на J6.1 (119.5, 104.25).

Делитель R68/R69 снят с J6.2.

**Факты.**
- Ни последовательного элемента, ни конденсатора у J6.1–4 нет.
- Ближайший GND-вывод, J6.11/12, в 5.1 мм от J6.3/4.

**Последствие.** Пульсации и остаток звона шины, наводки от узла уходят прямо на соединительную плату и её кабели.

**Рекомендация.**
- Ферритовая бусина 0603/0805 (≥ 200 мА) последовательно и 100 нФ 100 В X7R 0805/1206 на GND со своей виа, у J6.1–4. Место — x 117–121.5, y 99.5–103.5 рядом с R68/R69; проверить `geom.py` и DRC.
- Дорожку VDC отвести от заливки узла на ≥ 1 мм (запрет заливки вдоль неё).

### E4 — средняя. LO и линии термистора C идут по In4 в 0.1 мм над медью узла на B.Cu

**Факты.** In3 GND над ними в 0.485 мм, то есть ближайшая опора — узел. Длина над узлом и ёмкость к нему:

| Линия | Длина над узлом | Ёмкость |
|---|---|---|
| LO C | 17.5 мм | 2.92 пФ |
| LO B | 12.7 мм | 2.39 пФ |
| LO A (над Phase_OUT/узлом A) | 13.3 мм | 2.51 пФ |
| +3.3V к термистору C | 12 мм | 2.24 пФ |
| U1+ | 11.5 мм | 2.15 пФ |

Где: проход C (x 121–125, y 91–106), x 137–138 у фазы B, x 150–152 у фазы A.

Суммарная ёмкость LO к узлу (C / B / A):

| | C | B | A |
|---|---|---|---|
| rev0 | 4.39 | 3.65 | 3.55 |
| rev0.1 | 2.41 | 3.08 | 3.27 |
| rev0.1-gnd | **3.58** | 3.05 | 2.84 |

У фазы C — ухудшение относительно `rev0.1`, но всё ещё ниже rev0.

Сечение прохода J1–J2 при y 96–100: LO B лежит под полоской In3 шириной 0.9 мм между пустотами виа узла, под ней сплошной узел B на B.Cu. Мелочь: SW фазы B над узлом A — 1.3 пФ.

**Последствие.**
- Около 25–35 мА на фронт втекает в LO, того же знака, что ток Миллера. Это мало по сравнению с Cgd·dv/dt, но съедает запас после C_gs.
- Этот ток возвращается через землю драйвера и мосты GND в часть управления; по +3.3V шум уходит и на J7.

**Рекомендация.** Под LO, +3.3V и U1+ в проходах сделать запрет заливки на B.Cu полосой 1.2–1.5 мм. Узел C на B.Cu в проходе шириной 11 мм, останется около 9.5 мм; проверить ток к R7. Другой путь — эти участки на In2 с запретом заливки узла: In2 над In3 в 0.1 мм — лучшая опора. Решает владелец.

### E5 — средняя. Входы HI драйверов D6 и D4 над Phase_OUT на In1; проверка §6 смотрела только F.Cu

**Факты.**
- `Net-(D6-HI)` — площадка C120.2 и дорожка к D6.1, x 149.4–151.2, y 103.7–104.25. Лежит в 0.1 мм над In1 Phase_OUT A: 0.90 мм², около 0.33 пФ.
- `Net-(D4-HI)`: 0.16 мм² над In1 Phase_OUT C у (128.3, 103.6), около 0.06 пФ.
- В rev0 перекрытий не было.
- `hidist.py` мерил только F.Cu (2.03 мм).

**Последствие.** Около 3 мА на фронт и до около 8 мА на звоне в HI при R120 = 0 Ом и C120 DNP. На выводе драйвера это десятки–сотни мВ — ровно тот механизм, который Находки §3.4 подозревают в частичном выключении HS.

**Рекомендация.**
- Зоны запрета «HI/LI Dx» распространить на In1/In2: Phase_OUT A/C отодвинуть на ≥ 1 мм от меди HI/LI (под C118/C120 — y ≤ 103.0).
- Повторить проверку §6 по всем слоям.
- Поставить C118–C123 по 100 пФ.

### E6 — средняя. Медь узла у края платы, у J6/J7 и HO фазы A у выреза

**Факты.**
- Медь узла в пределах 1 мм от контура (длина по периметру): F.Cu 20 мм, In1 19, In2 31, In4 11, B.Cu 31; минимум 0.25 мм.
  - Фаза C: x 116.5–122.7, y 92.6–104 (In2, B.Cu).
  - Фаза A: x 162.8–168.9, y 92–104, все слои.
- Расстояние от узла до площадок разъёмов:
  - до J6.2 (VDC): In2 0.26 мм, B.Cu 0.61 мм;
  - узел A до J7.1–2: In1/In2 0.26 мм, F.Cu/B.Cu 0.63 мм.
- HO фазы A на F.Cu — (162.6 → 165.56, 92.4), ширина 0.4 — в 0.29 мм от кромки правого выреза, то есть под головкой винта. В rev0 этой дорожки там не было.

**Последствие.** Краевое поле узла уходит в корпус и радиатор, ёмкостная связь с ответной частью J6/J7. Затвор HS A отделён от винта только маской.

**Рекомендация.**
- Отвести медь узла на ≥ 1.5–2 мм от контура и от площадок J6/J7, поставить между ними ряд виа GND.
- HO A увести на ≥ 1.5 мм от выреза.
- Поле виа узла A (x 163–169, y 99–103) затрагивает Р8 — решает владелец.

### E7 — средняя/низкая. Кельвиновские пары шунтов потеряли одинаковое окружение на In4

**Факты.**
- В `rev0.1` все шесть линий (B.Cu 0.5 мм, по 6.2 мм) имели над собой на In4 одно и то же: 2.4 мм GND и 3.6 мм Phase_OUT.
- Сейчас (y 103.25–105.0):
  - C: Phase_OUT — 3.6 мм без меди на In4;
  - B (x 141.95): Phase_IN под U2+ (линия термистора B) 2.5 мм, около 0.28 пФ; Phase_OUT на всех 6.2 мм без меди;
  - A: Phase_IN под +12V 2.6 мм, 0.48 пФ; Phase_OUT под U3+ 2.5 мм.

**Последствие.**
- Несимметрия паразитных ёмкостей дифференциального входа AD8418: часть синфазного скачка 48 В переходит в дифференциальную ошибку.
- Прямая наводка от линий термистора (у них около 8 пФ связи с узлом) и от +12V (импульсы заряда бутстрепа).
- По величине мало (источник — шунт 300 мкОм), но это самая чувствительная аналоговая точка.

**Рекомендация.** Увести U2+, U3+ и +12V на In4 от пар на ≥ 1 мм (пересекать под прямым углом) и вернуть GND на In4 под обе линии каждой пары одинаково.

### E8 — низкая/средняя. Сшивка GND по краю части управления и у J6/J7

**Факты.** Самые длинные участки края без виа или GND-вывода в пределах 3 мм:
- 60 мм — правый край от y 116.8, вокруг H3, по низу до x 136.2;
- 28.5 мм — правый край, y 83.5–101.8;
- 22 мм — левый край, y 93–108, включая верх J6.

Ниже y 104 всего 78 виа GND, но у края — только выводы J6/J7 и 3 виа. Земля J6 держится только на 4 своих выводах (11, 12, 17, 18), дополнительных виа рядом нет. Плоскость +3.3V на In2 доходит до 0.27 мм от контура, наравне с GND.

**Рекомендация.**
- Ряд виа GND 0.3/0.6 мм через 3–4 мм по периметру нижней части.
- По 2–4 виа GND у J6.11/12/17/18 и у J7.
- +3.3V отодвинуть от края на 1 мм.

Дёшево, ограничения не затрагивает.

### E9 — низкая. Разрезы In4: островки и дорожки B.Cu без близкой опоры

**Факты.**
- GND на In4: 3429 → 3054 мм², 5 → 11 кусков.
- Новые островки на 1–2 виа: 22 мм² (x 138–141, y 101–110), 16, 9, 7, 6 мм².
- Дорожки B.Cu под дорожками In4 в 0.1 мм:
  - D13-K (вход OCP по максимуму) под Temp_PCB_3 — 10.4 мм параллельно, 1.76 пФ;
  - Current_measure_3 под VDC_MCU — 5.5 мм, 1.04 пФ;
  - SWCLK_IN/SWDIO_IN пересекают цепи OCP (D24-A, U6B+, U6A−, D13-K) — 0.2–0.5 пФ каждое.

**Последствие.** В основном цепи медленные и отфильтрованные. Но SWD — внешняя линия, и она пересекает входы компаратора OCP.

**Рекомендация.**
- Temp_PCB_3 сдвинуть с D13-K на ≥ 0.5 мм в сторону.
- Островкам — вторая виа или удаление.
- SWD пересекать цепи U6 под прямым углом.

### E10 — низкая (для сведения). In3: оставшиеся пустоты и разница фаз

**Факты.**
- In3 — один кусок, пустот 775 мм².
- Крупнейшие пустоты — втулки вместе с полями виа узла:
  - фаза B: 18.8 мм, 112 мм², от D-пэда Q5 через поле виа к J2, x 136.75–147, y 84.2–103;
  - фаза A: 91.6 мм²; фаза C: 74.7 мм².
- Колонка виа в проходе J1–J2: щель 1.5 × 9.25 мм.
- Под каждым ключом D-пэд даёт пустоту 4.6 × 4.6 мм — 12 штук по 17.1 мм².
- Заполнение In3 под блоком 72 % (rev0 — 57 %). Под колонками узла C / B / A — 0.66 / 0.54 / 0.59.

**Вывод.** Щели в проходах вытянуты по y, вдоль тока GND, — это допустимо. Под узлом B обратный путь по x перфорирован сильнее всего, так что L петли и частота звона по фазам, вероятно, разные.

### E11 — низкая. Пары HO/SW в проходах разделены слоем In3 (открытый вопрос в CHANGELOG)

**Факты.** Ёмкость HO к GND: C 2.02 пФ, B 2.07 пФ (в `rev0.1` 1.40 и 1.26). Это +0.6–0.8 пФ, около 6–8 мА на фронт.

**Вывод.** По ЭМС приемлемо: поле петли затвора заперто между плоскостями, In3 экранирует. Менять не нужно.

### E12 — низкая. Интерфейс J6: CAN, SWD, +12V

**Факты.**
- CAN: TVS D12 в 8–9 мм от разъёма, R50 120 Ом без разделённой терминации, C58/C59 по 56 пФ на GND.
  - CANH и CANL в 1.9 мм друг от друга, длины 20.9 / 18.8 мм.
  - CANH на 5 мм в 1.75 мм от края.
  - Места под синфазный дроссель нет.
- SWD: 28 мм по In4 до R48/R49, защита от ESD U10 стоит у МК.
- +12V: у J6 конденсатора нет. Ближайшие — C1–C3 по 10 мкФ у драйверов, в 12–38 мм.

**Рекомендация (если на соединительной плате этого нет).** Место под синфазный дроссель и разделённую терминацию (DNP); 100 нФ на +12V у J6.7–10.

---

## Что хорошо

- In3 — один кусок, 4085 мм². Пустоты 1234 → 775 мм², прорези 43.5 и 41.3 мм ушли. Заполнение под блоком 57 % (rev0) → 72 %. Мосты In3 в проходах — 2.70 / 0.90 / 1.75 / 2.65 мм.
- Ушла связь дорожек In3 с плоскостью +3.3V в 0.1 мм: +12V — 21.6 пФ, Temp — 2.7–6.9 пФ, SWD — около 5 пФ на линию, VDC_MCU — 4.5 пФ.
- Связь с узлом: +3.3V — 17.9 → 6.2 пФ, линии термисторов — 18.8 → 7.9 пФ относительно rev0.
- Все линии ШИМ (TMR1_CHx/CHxN) и HI/LI идут по F.Cu над сплошной In1 GND (исключение — E5). Переходы CH1/CH2 на In2 — с виа GND не дальше 1.4 мм. Дорожки In2 везде над In3 в 0.1 мм.
- Межплоскостная ёмкость: +3.3V/In3 — 778 пФ (было 672); VDC/GND — три пары по 0.1 мм, 1.41 нФ. Плюс 22 конденсатора 2.2 мкФ 0805 и 11 электролитов.
- SW драйверов связан с узлом только через NT. На выходах AD8418 стоит RC 120 Ом / 100 нФ. На CAN есть TVS.

## Что добавить на стенд и предварительные замеры ЭМС

1. Токовыми клещами — синфазный ток 30–300 МГц, пики 125–139 МГц:
   - на паре DC (J4/J5), на каждом фазном кабеле и на всех трёх вместе, на кабеле J6/J7;
   - два варианта: радиатор плавает или временно соединён с GND через винт в вырезе.
2. Ёмкость «узел — радиатор» по фазам LCR-метром на собранном узле; напряжение радиатора относительно GND щупом ×10 при 48 В.
3. Ближнее поле:
   - H-зонд над каждой фазой — частота звона по фазам (ожидаю отличие у B);
   - E-зонд у вырезов под винты, у края J6/J7, у J6.1–4.
4. VDC на J6.1–4 через разделительный конденсатор и коаксиал 50 Ом — до и после бусины с конденсатором.
5. HI и LI на выводах D6.1 и D4.1 при 60–120 А — с C120 и без.
6. Выходы AD8418 на фронтах, по фазам (проверка E7).
7. Опыт Д1 (снаббер) на rev0: затухание звона, ΔV, температура R; пересчёт на 72 В.
8. Кондуктивная помеха на входе DC через эквивалент сети (150 кГц–108 МГц) и предварительный скан излучения 30–300 МГц с реальным жгутом.
