alsizyakin/InvertorPowerNewGen/docs/reviews/12_reply_plus4r3_power.md

# Ответ на ревью 11 (силовая часть), ветка `rev0.1-plus4`, раунд 3

**Где правки.**
- Схема: `tools/rev01_layout/sch_rev01_g.py`.
- Плата: `lay_P4f.py` (шаги 11–12 `plus4.sh`).
- Модель:
  - `cflow.py`, `cflow_cases.py` — исправлены;
  - `cflow_figs.py` — меры у шунта;
  - `cflow_report.py` — новый, все таблицы одной командой.
- Коммит — этот, вместе с ответами 12 и 14.
- Запись — `CHANGELOG_rev0.1.md`, раздел «Ревью ветки `rev0.1-plus4`, раунд 3». В трёх прежних разделах с числами cflow стоит поправка со ссылкой на него.
- Проверки после правок:
  - DRC: 0 ошибок, 0 неразведённых, 0 расхождений;
  - ERC: 9 ошибок, база;
  - `hv.py`: 24;
  - перекрытий корпусов нет;
  - цепочка `plus4.sh` с `515455d` даёт ту же плату — отрезки, виа, зоны, посадочные места, цепи пэдов, Value — и ту же схему с точностью до uuid.

**Перепроверка утверждений ревью.**
- **P15, сходимость прежней модели.** Повторил: на старом коде число падает с сеткой, как у вас.
- **P15, исправленная модель, h 0.1 → 0.05 мм.** Узел C 0.592 → 0.577, B 0.599 → 0.579, A 0.542 → 0.517 мОм (LS) — разница 2.5–5 %. VDC и GND, h 0.15 → 0.1: 1–3 %.
- **P15, ваши числа.** Сходятся с моими до третьего знака:

  | 100 А, LS / HS, мОм | C | B | A |
  |---|---|---|---|
  | Ваш вариант «стенка стакана», h 0.05 | 0.574 / 0.720 | 0.573 / 0.730 | 0.515 / 0.665 |
  | Мой пересчёт, `b78f01b` и сейчас | 0.577 / 0.724 | 0.579 / 0.737 | 0.517 / 0.667 |

- **P15, по коммитам.** Тоже совпадают:
  - фаза A по `lay_P4d`: 0.681 → 0.508 (LS, −25 %), 0.831 → 0.657 (HS, −21 %);
  - E6: A +1.8 / +1.4 %, C +1.3 / +1.0 % (LS / HS);
  - F15/F16: узел C 0.668 → 0.581 (−13 %). У вас 0.659 → 0.577 (−12 %), расхождение 1.4 % — в пределах сходимости по сетке;
  - у шунта, потери в 2 мм от пэда: A 2.50 → 1.19, B 1.12, C 1.15 → 1.07 Вт;
  - перцентиль 99 в кольце 0.2–0.5 мм: A 2457 → 1037, B 954, C 959 → 884 А/мм²;
  - ценность слоёв сейчас — без In1 / In2 / In4: C +6 / +45 / +3 %, B +28 / +30 / +4 %, A +23 / +23 / +4 %;
  - VDC C / B / A: 0.384 → 0.344, 0.364 → 0.325, 0.575 → 0.482 мОм.
- **P16.**
  - Вывод 4 — `unconnected-(U12-NC-Pad4)`, то же у U4 и U9. Подтверждаю.
  - В символе проекта `Logic_My:INA240A1D` вывод 4 был `no_connect` и скрыт.
- **P17.** Виа (164.5, 73.0) нужна VDC A: без неё 0.482 → 0.499 мОм (+3.5 %).
- **P18.** Виа VDC (120.0, 92.3): пэд в 0.30 мм от стенки левого паза, отверстие в 0.45 мм. Подтверждаю.
- **P20.** Предохранителей в схеме нет ни одного. Подтверждаю.
- **P19.** Энергию снаббера не пересчитывал: исходные данные те же, что у 07 P10, а верхняя граница совпадает с CHANGELOG.

---

**P15 — согласен, сделано.**
- **`cflow.py`:**
  - размер виа читается из текста платы (`pcbedit.Board.vias()`);
  - стакан связан с медью слоя только у стенки, r = d/2 + 25 мкм = 0.175 мм. Для сверлёных пэдов так же. На грубой сетке, если в этот круг не попала ни одна клетка, берётся ближайшая;
  - новая функция `near_pad`: потери в меди в заданном радиусе от пэда (все слои) и 99-й перцентиль |J| в кольце на B.Cu.
- **`cflow_cases.py`:**
  - сетка по умолчанию 0.05 мм для узла, 0.1 мм для VDC/GND;
  - в любом вызове её можно переопределить через `CFLOW_H` / `CFLOW_HP`.
- **`cflow_figs.py`:** вместо пика в одной клетке — `near_pad`, в подписях картинок — перцентиль 99.
- **`cflow_report.py`** (новый): все числа таблиц CHANGELOG для нескольких плат сразу. В этом раунде — 5 коммитов от `50ad933` до сейчас.
- **CHANGELOG:**
  - в разделах «анализ растекания», «перестановки» и «E6» стоит поправка: абсолютные числа там занижены, решения в силе;
  - верные числа — таблицей в разделе раунда 3;
  - фраза «фаза B лучшая» снята: три фазы по меди почти равны.
- **Тепловой бюджет** записан по вашим числам: медь узла 4.3–7.3 Вт на фазу при 20 °C, до ~9 Вт горячая, шунт 2.2–3.4 Вт. Он же — ожидание для тепловизора в списке стенда.
- **Документ с картинками** растекания тока пересчитан той же моделью, картинки заменены.
- **В 1D-оценке и в варианте «отверстия вырезаны» вы правы:** абсолют узла B зависит от того, как моделировать стакан (0.46–0.58 мОм). В CHANGELOG это записано как точность модели. Сравнение фаз и вариантов от этого не меняется.
- **In1 узлом в проходе C и виа в пэдах шунтов** по старой модели не решались:
  - In1 в проходе C развести не удалось;
  - виа в пэдах отложены владельцем до заказа заполненных виа.

  Если к ним вернёмся — считать только исправленной моделью.

**P16 — сделано, п. 1 (F24); п. 2 и 3 — решение владельца.**
- **Вывод 4 соединён с GND:**
  - в символе `Logic_My:INA240A1D` (библиотека проекта и кэши трёх листов) вывод 4 стал `passive` и видимым;
  - на его конце в каждом листе Current_Sensor — символ GND;
  - на плате пэд 4 U4 / U9 / U12 соединён с пэдом 3 (REF2 = GND) перемычкой B.Cu 0.3 мм.

  ERC — та же база, 9 ошибок.
- **INA241A2 на 48 В.** Владелец решил: только опция, по результату замера. Замена записана в поле Replacement, после п. 1 она полная.
- **Замер** U.8 и U.1 относительно U.2 на выключении LS и HS при 48 В, 60 и 120 А — в списке стенда, с пределами 80 / 90 В и −4 / −6 В.
- **LS-снабберы на 48 В** — вопрос владельцу, вместе с 09 E15.

**P17 — согласен, оставлено.**
- Новых виа в полосе y 73–75.6 над колонками стока не ставим, правило записано в CHANGELOG.
- **(164.5, 73.0) у C133 оставлена.** Без неё VDC A хуже на 3.5 %, это больше половины выигрыша F20 для фазы A.
- Отвести её от C133, не ухудшив VDC, можно только вместе с правкой ленты In1 GND там. Оставляю до повода трогать это место.

**P18 — согласен; виа не отведена.**
- Виа VDC (120.0, 92.3) стоит в углу полосы GND между C103 и пазом. На виа 0.6 мм там 0.87 мм по высоте, отвести её на 0.3–0.5 мм некуда.
- Без сдвига C103 вопрос закрывают втулки (07 P12).
- Линии термистора A местами не менял, как вы советуете.
- **Испытание изоляции** левого паза — в списке стенда.

**P19 — согласен, решает владелец.**
- В CHANGELOG записано:
  - ERJ-P06 или равный антиимпульсный 0805 ≥ 0.5 Вт, 2 × 1 Ом;
  - ESR10 для 84 В — без запаса;
  - окна трафарета только под выводы 0805 или свой футпринт «2 × 0805» с той же медью.
- Футпринт R100–R105 пока 0612: какие резисторы ставить, выбирает владелец.

**P20 — согласен, решает владелец.**
- Предохранитель 1–2 А, 100 В+:
  - на входе соединительной платы — правка той платы;
  - или в разрыв VDC у J6 здесь — правка схемы; место под него на этой плате я не искал.
- Вынесено владельцу первым пунктом вместе с опорой CAN (13 E26).

**Стенд** — ваши четыре пункта перенесены в CHANGELOG, в общий список раунда 3.

**Остаётся открытым (решает владелец):**
- предохранитель VDC к J6 (P20);
- INA241A2 на 48 В или LS-снабберы (P16, по замеру);
- тип R снаббера и трафарет (P19);
- втулки (P18, 07 P12);
- отвод виа (164.5, 73.0) — при случае (P17).
