alsizyakin/InvertorPowerNewGen/docs/reviews/14_reply_plus4r3_emc.md

# Ответ на ревью 13 (ЭМС), ветка `rev0.1-plus4`, раунд 3

**Где правки.**
- Схема — `tools/rev01_layout/sch_rev01_g.py`, плата — `lay_P4f.py` (шаги 11–12 `plus4.sh`). Коммит — этот, вместе с ответами.
- Запись — `CHANGELOG_rev0.1.md`, раздел «Ревью ветки `rev0.1-plus4`, раунд 3».
- Проверки после правок:
  - DRC: 0 ошибок, 0 неразведённых, 0 расхождений;
  - ERC: 9 ошибок — база, все 51 замечание те же;
  - `hv.py`: 24;
  - перекрытий корпусов нет.

**Перепроверка утверждений ревью.**
- **E20.** In1 GND сейчас из двух кусков: 1709 и 1885 мм². На `50ad933` был один, 3594 мм². Подтверждаю.
- **E21, E22.** Виа VDC (120.0, 92.3) и U3+ лежат в 0.30 мм от стенки паза (пэд виа — 0.303 мм). Подтверждаю.
- **E22, моя ошибка.**
  - «Медь узла в 1 мм от края −73…−80 %» я считал через `geom.Board.edge`. Там дуга паза заменена двумя хордами, а хорды лежат внутри паза, поэтому расстояние до стенки выходило больше настоящего.
  - Ваши цифры верны: у внешнего контура меди узла не осталось, вместе со стенками пазов −53 / −62 %. CHANGELOG поправил.
  - Тот же дефект хорд нашёлся в моей проверке места для новых виа рядом с пазами (`cflow.legal_via`). Новые виа ставил по точной дуге — DRC их принял.
- **E19.**
  - Место 0805 на B.Cu у J6 проверил по пэдам, виа и дорожкам. Ставлю горизонтально, центр (118.75, 101.6), а не вертикально в (118.9, 101.8).
  - Причина: контур корпуса начинается с y 100.62 — на уровне шунтов (контуры с y 100.57). Он не заходит в зону радиатора блока (Р1: B.Cu на y 74…100). Вертикально контур начинался бы с y 99.92.

---

**E19 — сделано (F22).**
- C134 — 100 нФ, 100 В, X7R, 0805 — на B.Cu:
  - пэд 1 (VDC) короткой дорожкой B.Cu 0.5 мм в J6.1;
  - пэд 2 (GND) — в кармане GND, который освободил E6, со своей виа (116.85, 101.6).
- В схеме C134 — на корневом листе у J6, между символами VDC и GND. На плате посадочное место связано с символом, поэтому F8 ничего менять не должен.
- **Трасса VDC оставлена,** как вы и советуете: обойти проход C нельзя.
- **Бусина** не ставится. По словам владельца, фильтры есть на входе соединительной платы.

**E20 — согласен.**
- В CHANGELOG записано, что In1 GND разделён на два куска.
- Р13 считаем по In1 + In3 + In4: сумма по четырём проходам 10.95 мм (у вас), было 11.25.

**E21 — согласен.** U3+ в 0.30 мм от стенки правого паза внесён в оценку изоляции крепежа (E14, втулки), вместе с виа VDC у левого паза.

**E22 — согласен; мои проценты исправлены** (см. выше).
- Виа VDC (120.0, 92.3) под головкой левого винта стоит в 0.30 мм от паза.
- Отвести её на 0.3–0.5 мм не удаётся: угол полосы GND зажат между C103 сверху и пазом снизу (0.87 мм по высоте на виа 0.6). Остаётся вопросом втулок (E14).

**E23 — согласен.**
- Силовой ревьюер (11 P17) сделал ту же оценку с другой стороны: виа VDC на верху колонок стока сужают In3 GND над окнами стоков. Цена по ВЧ ≤ 0.02 нГн.
- Новых виа в полосе y 73–75.6 не ставим.

**E24 — сделано (F23).**
- Владелец подтвердил номинал: C37 / C39 / C64 — 15 нФ. С R 120 Ом это 88 кГц.
- Записано в схему и на плату (поле Value), BOM теперь совпадает с платами rev0.
- Ваш довод, что фильтр ≈100 кГц пропускает к компаратору только выбросы длиннее ≈2 мкс, внесён в CHANGELOG.

**E25 — решение владельца: только опция, по результату замера.**
- Замена на INA241A2 при 48 В остаётся в поле Replacement.
- Для неё по даташиту обязательно заземлить вывод 4 (NC) — это 11 P16, сделано (F24): пэд 4 U4 / U9 / U12 соединён с пэдом 3 (REF2 = GND).
- Замер выхода U4 / U9 / U12 на фронтах при 48 В и 120 А — в списке стенда.

**E26 — R50 сделан DNP (F23).**
- Терминация переезжает на соединительную плату, как вы предлагаете: 2 × 60 Ом + 4.7 нФ и TVS у разъёма кабеля. D12 остаётся.
- Условие «все узлы CAN отнесены к минусу батареи» передано владельцу: от этого зависит, хватит ли развязки на соединительной плате или нужна на этой.

**E27 — согласен.**

**Пункты прошлых раундов.**
- **E3** закрыт: точка отбора вне петли (F15), у J6 стоит C134.
- **E6** закрыт в объёме решения владельца (F21).
- **E12/E16** — см. E26.
- **E13, E14, E15** и норма ЭМС открыты, решает владелец.

**Замеры** — ваш список «Что мерить на стенде» перенесён в CHANGELOG.

**Остаётся открытым:**
- опора узлов CAN (E26);
- E13 — места под Y;
- E14 — втулки, с учётом U3+ и виа VDC у пазов;
- E15 — снабберы;
- норма ЭМС.
