alsizyakin/InvertorPowerNewGen/docs/reviews/07_review_plus4_power.md

# Ревью силовой части: InvertorPowerNewGen, ветка `rev0.1-plus4` (ea2d599)

*Ревьюер: субагент «инженер силовой электроники», 2026-10-17. Текст — как получен.*

**Вердикт.**
- Удлинение сделано чисто. Блок, драйверы и всё ниже y 72 не сдвинулись: посадочные места, дорожки, виа и заливки внутри блока сверены с `515455d`. DRC на копии 0 / 0 / 0, ERC 9 (база). Лишние 4 мм пути от банок электрически незаметны.
- Снабберы §5 подключены правильно и стоят у выводов верхнего ряда, над сплошной GND In1. Ветвь L-цепочки ≈1.1 нГн (LS) и ≈1.4 нГн (HS), у U-пробы было ≈2.2. По модели при 72 В и 120 А выброс на ближнем ключе снижается на 24–28 % (у U-пробы на 20 %). На дальнем ключе позиции: LS −23 %, HS −12…−17 %. Обещанные −35 % требуют ветви ~0.3 нГн, с корпусом 0805 это недостижимо. R 0612 на 1.5 Вт с большим запасом: реально в нём 0.1–0.2 Вт.
- Вторую 1206 ценой места HS-снаббера не ставить. Она даёт −1…−2 В, установленный HS-снаббер — −9…−12 В на верхнем HS. Керамику лучше улучшать заменой корпусов на тех же местах.
- Новое по зазорам: средние точки снабберов (X) лежат в 0.30–0.44 мм от меди узла и VDC, разность до 84 В. Таких мест 17, `hv.py` их не видит. Лечится зазором 0.5 мм у X-пэдов, на копии проверено.
- «Радиатор на корпусе»: шайб под головками мало. Медь узла на всех шести слоях лежит в 0.21–0.25 мм от кромки пазов под винты. Со стороны радиатора маска открыта до самой кромки, под прокладкой 336 открытых отверстий D-пэдов.
- Д1/Д2 подключены верно, мёртвое время с запасом. При 84 В и R_on 0.82 Ом кристалл по-прежнему выше 100 В (104–106 В даже со снаббером). Нужен спад тока ≥ 10–12 нс, то есть R_on ≈ 2 Ом (Р5).

**Как проверял.**
- Копия проекта, kicad-cli 10.0.3:
  - DRC с перезаливкой: 0 ошибок, 0 неразведённых, 0 расхождений; одно предупреждение silk у C11. Перезалитая плата совпала с файлом ветки байт в байт.
  - ERC: 9 ошибок, это база.
- Сравнил с `515455d` (до удлинения): посадочные места, дорожки и виа; заливки растром 0.05 мм по слоям внутри блока.
- Зазоры: `hv.py` как есть и его вариант, где X относится к своей цепи (у LS ≈ GND, у HS ≈ узел). Окно расширил на всю плату.
- Сечения VDC/GND — растром по горизонталям. Вырезы под винты — растром 0.025 мм, расстояние до кромки паза.
- Опыт на копии: зазор 0.5 мм у 12 X-пэдов, затем перезаливка, DRC и `hv.py`.
- L ветвей — суммы микрополосков над In1 (h 0.135 мм; Z₀ в воздухе по Уилеру) плюс типовые ESL корпусов. Допущения указаны в таблицах.
- Выброс — своя модель выключения (RK4, шаг 2–4 пс):
  - элементы: нелинейная Coss WMB043 из pslc (`mosfet_si.csv`), L корпусов 0.25 нГн на пару, линейный спад тока канала t_f, Coss HS с идеальным диодом, снаббер L_s–R–C у выводов;
  - вариант «два прибора»: снаббер у верхнего, нижний связан с ним через L_tb;
  - калибровка как в 05: 48 В, 120 А, L_ext 0.75 нГн, t_f 6 нс → 31.7–32.4 В на выводах (стенд 33–37 В), звон 118 МГц (стенд 125–139 МГц). Абсолюту не верю, беру разности и отношения.
- Номинал R: ROHM LTR18EZPFLR470 — 1.5 Вт при 70 °C (даташит серии LTR18, element14).

---

## Находки

### P9 — средняя. Средние точки снабберов: 17 мест 0.30–0.44 мм до меди с разностью 84 В
**Где.** X-пэды R100–R105.1 и C112–C117.2, y 70.8–74.2.

**Факты.**
- По постоянному току X сидит на потенциале дальнего вывода R: у LS-цепочки ≈ GND, у HS ≈ узел. Поэтому зазоры X ↔ узел (у LS) и X ↔ VDC (у обеих) держат всю шину.
- Местный зазор X-пэдов — 0.3 мм. Зоны F.Cu (свой зазор 0.6) отступают от X только на 0.30–0.385 мм: побеждает зазор пэда. Фраза CHANGELOG «зоны силовых цепей и так держат 0.6 мм» для X неверна.
- `hv.py` относит X к `None` и не считает. Если отнести X к его цепи, на `ea2d599` получается 41 место < 0.5 мм против 24 на `515455d`. Новые 17:

| Зазор, мм | Что с чем | Мест |
|---|---|---|
| 0.30 | R100/R101/R102.1 (X LS) ↔ зона узла | 3 |
| 0.314 | R100–R105.1 ↔ зона VDC | 6 |
| 0.385–0.395 | C112–C117.2 ↔ зона VDC или узла | 7 |
| 0.44 | C113.2 ↔ зона узла B | 1 |

- Есть и место «открытый пэд — открытый пэд»: R102.1 (X LS, фаза A) ↔ Q11.D, 0.457 мм по DRC.
  - Цепочка A стоит на 0.7 мм ближе к стоку, чем C: R102 x 154.3 при Q11 x 156.75, а R100 x 119.6 при Q8 x 122.75.
  - Форма цепочки во всех фазах одна, сдвиг относительно ключей — нет.

**Следствие.**
- При DNP X-пэды плавают — опасности нет.
- При установке на стенде:
  - уже на 48 В 0.30 мм меньше 0.4 мм (IPC-2221B A6, 31–50 В);
  - на 72–84 В — меньше 0.5 мм, как места из 05 P5.

**Проверено на копии.** Зазор 0.5 мм у 12 X-пэдов, перезаливка:
- неразведённых 0;
- сечения VDC/GND прежние (F.Cu GND на y 72: −0.6 мм);
- `hv.py` с X — 24 места, как до удлинения;
- DRC — 2 ошибки:
  - R102.1 ↔ Q11.D 0.457 мм;
  - R100.1 ↔ виа GND (119.75, 74.85) 0.416 мм. Это тот же потенциал, электрически безвредно.

**Что сделать.**
1. X-пэдам — зазор 0.5 мм.
2. Цепочку A (R102, C114, перемычку) сдвинуть на −0.1…−0.2 мм по x. Виа (119.75, 74.85) — сдвинуть или оставить исключением.
3. В `hv.py` относить X к своей цепи: у LS — к GND, у HS — к узлу. Иначе регрессионная проверка их не видит.

### P10 — средняя. Снабберы §5: подключение верное, ветвь вдвое короче U-пробы, но −35 % не будет; HS-цепочка работает на верхний HS
**Где.**
- LS: C112/R100 (C), C113/R101 (B), C114/R102 (A).
- HS: C115/R103, C116/R104, C117/R105.
- Все шесть — над верхним рядом ключей, y 70.8–74.2.

**Подключение.** По плате, при паритете со схемой 0:
- LS: узел — C.1 | C.2 — X — R.1 | R.2 — GND;
- HS: VDC — C.1 | C.2 — X — R.1 | R.2 — узел.

Фазы верные: Current_Sensor_3/2/1 = C/B/A. Все 12 деталей — DNP.

**Близость к выводам.**
- Пэд C до D-пэда верхнего ключа: 0.385 мм, во всех шести цепочках.
- Пэд R на GND до выводов S у LS: 1.145 мм.
- Пэд R на узел до выводов S у HS: 1.46 / 1.21 / 1.29 мм. Путь по меди около 3 мм — в обход X-пэда.
- Под цепочками In1 — сплошная лента GND (y < 74.0) в 0.1 мм. Это главный плюс места: боковая петля над такой плоскостью — почти микрополоски.

**Оценка L ветви, нГн.** Сумма микрополосков над In1 (h 0.135 мм) и типовые ESL корпусов:

| Участок | LS | HS |
|---|---|---|
| От вывода ключа к C (узел / VDC) | 0.10–0.17 | 0.15–0.25 |
| C 0805 4.7 нФ | 0.40–0.55 | 0.40–0.55 |
| X: пэд C + перемычка 1.2 × 0.5 + пэд R (1.85 мм, 0.106 нГн/мм) | 0.15–0.20 | 0.15–0.20 |
| R 0612 (1.6 × 3.2 мм, плёнка на ~0.55 мм) | 0.20–0.30 | 0.20–0.30 |
| От R к выводам S (GND / узел) | 0.08–0.15 | 0.25–0.35 |
| **Итого** | **0.9–1.4, ≈1.1** | **1.15–1.65, ≈1.4** |

- U-проба (05 P2): ≈2.2 нГн (1.5–2.5).
- Теперь самый большой член ветви — C 0805.

**Модель.** ΔV на кристалле, В, 72 В, 120 А; L_ext — петля без корпусов:

| | Без снаббера | U, L_s 2.2 | HS, L_s 1.4 | LS, L_s 1.1 | L_s 0.3 |
|---|---|---|---|---|---|
| t_f 6 нс, L_ext 0.75 | 39.8 | 31.8 (−20 %) | 30.3 (−24 %) | 29.4 (−26 %) | 25.8 (−35 %) |
| t_f 6 нс, L_ext 0.6 | 33.9 | 28.1 | 27.0 | 26.4 | 23.5 |
| t_f 8 нс (Д2, R_on 0.82), L_ext 0.75 | 30.0 | 24.3 | 23.2 | 22.6 | — |

При 84 В цифры те же с точностью ±0.3 В: выше 80 В Coss постоянна.

**Какие ключи гасит.** Модель «два прибора»: снаббер у верхнего, нижний через L_tb (значения из 05 P2). 72 В, t_f 6 нс, L_ext 0.75; без снаббера 39.6 / 39.6 В.

| Цепочка | L_tb, нГн | Верхний | Нижний |
|---|---|---|---|
| LS, L_s 1.1 | 0.25 | 28.7 (−28 %) | 30.4 (−23 %) |
| HS, L_s 1.4 | 0.8 | 28.5 (−28 %) | 32.7 (−17 %) |
| HS, L_s 1.4 | 1.7 | 27.3 (−31 %) | 34.7 (−12 %) |

**Номиналы.**
- При L_s 1.1 R почти не важен: 0.33–1.0 Ом дают 29.0–30.7 В.
- C важнее: 3.3 / 4.7 / 6.8 / 10 нФ (R 0.47) → 30.3 / 29.4 / 28.2 / 26.6 В.

**Мощность R.**
- Верхняя граница C·V²·f = 0.22 / 0.49 / 0.66 Вт при 48 / 72 / 84 В и 20 кГц — эти числа в CHANGELOG.
- Реально в R за период:
  - жёсткий фронт: C²V²R / t_фр при t_фр ≈ 20 нс — 2.7–3.7 мкДж;
  - звон после выключения — 1.4–1.8 мкДж (модель);
  - мягкий фронт — ≲3 мкДж.

  Итого 0.1–0.2 Вт.
- Остальная часть C·V²/2 уходит во включающийся ключ: ≈0.2 Вт на цепочку при 72 В, ≈0.4 Вт на фазу с двумя цепочками. Это единицы процентов потерь переключения фазы при 120 А.
- LTR18EZPFLR470 рассчитан на 1.5 Вт при 70 °C — запас не меньше пяти раз.

**Следствие.**
- L-цепочка — хороший компромисс: −24…−28 % на верхнем ряду.
- Нижний HS (Q7/Q10/Q12) она гасит вдвое слабее.
- Ожидание −35 % (§5, Находки §3.1) снять.

**Что сделать.**
1. Геометрию оставить.
2. В CHANGELOG записать:
   - L ветви ≈1.1 / 1.4 нГн;
   - ожидание −24…−28 % на верхнем ряду и −12…−23 % на нижнем;
   - мощность R 0.1–0.2 Вт (граница 0.5–0.66 Вт).
3. На стенде сначала пробовать C 6.8–10 нФ C0G 0805 100 В, R менять потом.

### P11 — средняя. Керамика петли: вторая 1206 против места HS-снаббера — место снаббера важнее
**Где.**
- 1206: C124 / C128 / C132 — средний ряд; C125 (132.6, 73.3), C129 (150.1, 73.3), C133 (165.7, 72.1, стоя).
- 0603: C92, C94 — фаза C; C90, C93 — B; C95, C96 — A.

**Факты.**
- Новые 1206 стоят хорошо:
  - VDC-пэд — на верху колонки стока, в 0.35 мм от D-пэда верхнего HS;
  - у GND-пэда две виа 0.6/0.3 вплотную (0.015–0.02 мм от пэда), в In1 (лента GND в 0.1 мм) и In3.
- Ветви, оценка:
  - 1206 с монтажом над In1 — ≈1.0–1.2 нГн;
  - C124 — ≈1.2–1.6 нГн (05 P1);
  - 0603 у стока — ≈0.7–0.9 нГн;
  - 0603 вдали — ≈1.1–1.3 нГн (ещё +0.3–0.5 нГн по ленте VDC).

  Вся сеть фазы ≈0.27 нГн без учёта взаимной индукции.
- «По две 0603 на фазу» — только по обозначениям. У стока HS стоят: у C одна (C92), у B одна (C90), у A две (C95, C96).
  - C94 (121.6, 69.7) — над полосой GND фазы C, в 7–8 мм от колонки стока.
  - C93 (141.4, 71.1) — снова над узлом B, хотя 05 P4 просило x 148–151.
  - Разница фаз ≈0.03 нГн, это ≈1 В при 72 В.

**Сравнение.** Модель, 72 В, 120 А, t_f 6 нс, L_ext 0.75:

| Мера | Действует на | ΔV на кристалле |
|---|---|---|
| Вторая 1206 рядом с C125 (ΔL_ext ≈ −0.04…−0.05 нГн) | LS и HS, всегда | −1.9 В без снабберов, −1.0 В со снаббером |
| Установленный HS-снаббер, L_s 1.4 | выключение HS | верхний HS −9…−12 В, нижний −5…−7 В |
| Замена C125/C129/C133 на 0612 обратной геометрии или на 2 × 0603 1 мкФ 100 В со своими виа (ΔL ≈ −0.06…−0.08 нГн) | LS и HS, всегда | −1.2…−3 В |

**Вывод.**
- Место HS-снаббера весит в 5–10 раз больше второй 1206.
- После Кельвина выброс HS дорастёт до уровня LS (05 P3), а замеров HS всё ещё нет. Требование §5 «не урезать HS-цепочку» в силе.

**Что сделать.**
1. Место HS-снаббера оставить. Вторую 1206 ценой снаббера не ставить.
2. Если керамику нужно усилить — уменьшать ESL на тех же местах:
   - 0612 обратной геометрии на 100 В, если найдётся;
   - иначе 2 × 0603 1 мкФ 100 В X7S/X7R, у каждой своя виа в In1.
3. C93 перенести к стоку B, C94 — к стоку C, если влезут. Иначе записать в CHANGELOG, что «по две на фазу» — только по обозначениям.

### P12 — высокая для решения «радиатор на корпусе». Изоляция у вырезов под винты и со стороны радиатора держится на 0.25 мм и прокладке
**Где.**
- Вырезы — U-пазы шириной 5.5 мм, открытые к краю платы, с центрами (119.0, 95.5) и (166.5, 95.5).
- B.Cu под блоком.

**Измерено** (растр 0.025 мм).
- Медь до кромки паза:
  - узел — 0.21–0.25 мм на всех шести слоях (слева узел C, справа A);
  - GND на In1–In4 у левого паза — 0.25 мм.
- Окна маски B.Cu (зоны B.Mask узлов C и A) доходят до кромки паза (0.02 мм).
  - Открытой меди узла в 1 мм от кромки: 5.2 / 7.6 мм² (левый / правый паз); в 2 мм — 13.8 / 18.4 мм².
  - Виа узла, у которых кольцо в 1 мм от кромки: 6 / 13.
- Отверстия D-пэдов: 12 × 28 = 336 шт., Ø0.3 мм.
  - В посадочном месте у них `*.Mask`, то есть на B.Cu они открыты.
  - Ни заполнения, ни закрытия нет: в настройках платы plugging, filling и capping выключены.
  - Под LS это узел, под HS — VDC.
- Под головкой (r ≤ 5 мм) на F.Cu:
  - справа — 32 виа узла A (закрыты маской);
  - слева — 6 виа узла C, 3 виа GND и пэды C103, R68/R69.

  Совпадает с CHANGELOG.

**Следствие.**
- Стержень винта (потенциал корпуса) отделён от меди узла только 0.25 мм кромки — по стенке паза, без маски. Шайба под головкой этого не закрывает.
- Со стороны радиатора открытая медь и кольца виа узла стоят у самого паза. Если отверстие в прокладке больше паза, между узлом и радиатором остаётся только воздух, не больше толщины прокладки.
- Припой затекает в 0.3-мм отверстия D-пэдов и даёт бугорки на B.Cu (обычно десятки–сотни мкм). Они могут проколоть прокладку.
  - Теперь прокладка — единственная изоляция VDC и узлов от корпуса: 84 В плюс выбросы до ~110 В.

**Что сделать.**
1. Изолирующие втулки с буртиком (полиамид со стеклом): изолируют и стержень в пазу, и головку. Плоской шайбы мало.
2. Окна B.Mask узлов отодвинуть от пазов на ≥1.5–2 мм.
   - Правится только маска: медь и виа (Р8) не трогаются.
   - Теряется 14–18 мм² открытой меди у J1/J3, не под ключами.
3. В примечаниях к изготовлению: заполнение и закрытие отверстий D-пэдов (IPC-4761, тип VII) или хотя бы закрытие со стороны B.Cu. Если нет — прокладка на стеклоткани ≥ 0.2 мм и контроль бугорков.
4. Отверстие в прокладке — не больше паза.
5. Испытание изоляции собранного узла — см. «Что добавить на стенде».

### P13 — средняя. Д1/Д2: подключение верное, мёртвое время с запасом; для 84 В спад тока нужен медленнее
**Подключение** (все 12 ключей).
- C_gs.1 — на цепи затвора после R_g,i (вместе с R_gs).
- C_gs.2 — на S своего ключа: у LS это GND, у HS — свой узел.
- C100–C111 — 10 нФ 50 В C0G, ставятся. D30–D35 — DNP. R106–R108 и R112–R114 — 0.82 Ом, ставятся.
- Расстояния центр–центр: до G — 1.2–3.6 мм, до S — 2.6–4.7 мм (как в 05 P6).

**Времена.**
- τ = R·(5.1 нФ + C_gs) по стенду 16.10; сток драйвера 0.9 Ом, источник 0.6 Ом.
- Спад тока — по формуле 05 P3, L_cs 0.3–0.5 нГн.

| | R_on 0.82 Ом | R_on 2.0 Ом |
|---|---|---|
| R на прибор, выключение / включение | 4.44 / 3.84 Ом | 6.8 / 6.2 Ом |
| τ выключения | 67 нс | 103 нс |
| Задержка до 10 % Vds (×1.46, стенд) | ≈98 нс | ≈150 нс |
| Затвор ниже 1.0 В (горячий порог), с плато | ≈195 нс | ≈300 нс |
| Запас до мёртвого времени 500 нс | ≈300 нс | ≈200 нс |
| Спад тока при 120 А | 8–9.5 нс | 11–12 нс |

- Бутстреп: 2 × (≈98 + 120) нКл ≈ 0.44 мкКл, это 0.44 В на 1 мкФ (≈0.55 В с учётом DC-bias). Норма.

**84 В по модели.** Пик на кристалле, В:

| t_f, нс | L_ext 0.75: без снаббера / со снаббером 1.1 | L_ext 0.6: без / со снаббером |
|---|---|---|
| 8 | 114 / 106 | 109 / 104 |
| 10 | 108 / 102 | 104 / 100 |
| 12 | 104 / 100 | 101 / 98 |
| 15 | 100 / 97 | 98 / 95 |

**Следствие.**
- При R_on 0.82 Ом и 84 В кристалл выше 100 В даже со снаббером.
- Ниже 100 В — при t_f ≥ 10–12 нс со снаббером или ≥ 15 нс без него. R_on ≈ 2 Ом это даёт, и мёртвое время 500 нс ещё проходит.
- Цена — рост E_sw, её считать по Р5 в pslc.
- Диод D_off не ставить — согласен (Д2).

**Что сделать.** В Р5 выбрать R_on для 72/84 В по выбросу и E_sw. До 2.2 Ом мёртвое время 500 нс менять не нужно.

### P14 — низкая. Удлинение: блок цел, но VDC у кромки блока потерял 27 % сечения, B.Cu над узлами в полосе пустой
**Измерено** (`ea2d599` против `515455d`).
- Изменились только детали полосы: сдвинуты 18 (снабберы и 0603), добавлены 3 новых 1206.
- Дорожки: −5 / +18 (подводы 0603 и перемычки снабберов). Виа: −4 / +12. Всё это — только в полосе.
- Заливки в блоке (y ≥ 74.6): на внутренних слоях без изменений; на F.Cu и B.Cu +4 мм² — на месте снятых подводов.
- Сечение VDC (сумма ширин меди по слоям) на y 74.1–74.2:
  - 50–53 мм против 69–72 мм, то есть −27 %;
  - F.Cu — 14 мм вместо 19, B.Cu — 15 вместо 29.
- Сечение GND там же: 106–111 мм против 93–97 (+14 %).
- На B.Cu в полосе y 71.3–74.25 над колонками узла (3 участка по ~7 мм) меди нет.
  - VDC вырезать нужно было только на F.Cu.
  - Вырез в двухслойной зоне VDC убрал медь и на B.Cu, а зона узла на B.Cu начинается только с y 74.25.
- Путь «банки → блок» стал длиннее на 4 мм: ≈0.004 нГн (три пары слоёв через 0.1 мм на ширине 52 мм) и ≈26 мкОм (VDC + GND). Цифры CHANGELOG подтверждаю.

**Следствие.** Электрически незаметно: в узком месте +8 мкОм. Медь просто потеряна.

**Что сделать.** Вернуть VDC на B.Cu над колонками узла в полосе: вырез в двухслойной зоне VDC оставить только на F.Cu.

---

## Что хорошо
- Снабберы стоят над сплошной GND In1 в 0.1 мм, без виа; C — в 0.39 мм от стока. Цепочка одинаковая во всех фазах.
- Новые 1206 — вплотную к стоку HS, у каждого по две виа у пэда в In1/In3.
- Блок и всё ниже y 72 не тронуты. DRC 0 / 0 / 0, ERC 9. Прежние 24 места по зазорам не ухудшились, сечение GND у кромки блока выросло.
- Д1/Д2 внесены в схему и плату одинаково, расхождений со схемой нет.

## Что решает владелец
1. P9: зазор 0.5 мм у X-пэдов и сдвиг цепочки A на 0.1–0.2 мм — или лак, вместе с решением по P5.
2. P11: место HS-снаббера оставить (рекомендую). Керамику усиливать заменой корпусов на тех же местах; вторую 1206 ценой снаббера не ставить.
3. P12: втулки с буртиком, отступ маски B.Cu от пазов, заполнение отверстий D-пэдов в примечаниях к изготовлению, тип прокладки.
4. P13: R_on для 72/84 В (Р5). При 0.82 Ом на 84 В кристалл выше 100 В.
5. Если радиатор на корпусе — нужны ли на плате места под Y-конденсаторы «GND/VDC — корпус» (DNP). Сейчас точки корпуса на плате нет: H1–H4 неметаллизированы.
6. Механика из пробы: плата 112.76 мм при радиаторе заказчика 110 мм, межцентровое H1/H2 ↔ H3/H4 95.75 мм — подтвердить у заказчика.

## Что добавить на стенде
1. Снаббер у верхнего LS на rev0, с ветвью ~1 нГн: выброс на верхнем и нижнем LS. Ожидание −28 % / −23 %. C 4.7 и 10 нФ.
2. То же для HS после эмуляции Кельвина (05 P3): верхний и нижний HS. Ожидание −28 % / −12…−17 %.
3. Нагрев R снаббера при 72 В. Ожидаю 0.1–0.2 Вт.
4. Изоляция:
   - до установки — осмотреть B.Cu на бугорки припоя в отверстиях D-пэдов;
   - на собранной плате с прокладкой и втулками — мегаомметр 500 В между закороченными VDC/GND/узлами и радиатором, ≥ 100 МОм.
5. 84 В — поднимать ступенями, R_on — по Р5. Пик на выводах держать ≤ 90 В: на кристалле по модели на 8–11 В больше.

**Не проверено.**
- Абсолютные L: модель откалибрована как в 05, беру только разности.
- Есть ли в продаже 0612 обратной геометрии 1 мкФ 100 В.
- Действительно ли 0603 2.2 мкФ (C90, C92–C96) на 100 В: в BOM только «Capacitor SMD 100V», без P/N.
- Чертёж радиатора и винтов. По ширине паза 5.5 мм это M5 или M4 с зазором.
- L_tb между верхним и нижним прибором — взяты из 05, сам не считал.
