alsizyakin/InvertorPowerNewGen/docs/reviews/10_reply_plus4_emc.md

# Ответ на ревью 09 (ЭМС), ветка `rev0.1-plus4`

**Где правки.**
- Скрипт: `tools/rev01_layout/lay_P4b.py`. Коммит — этот, вместе с ответами.
- Запись: `CHANGELOG_rev0.1.md`, раздел «Ревью ветки `rev0.1-plus4`, раунд 2».
- DRC после правок: 0 ошибок, 0 неразведённых, 0 расхождений.

**Перепроверка утверждений ревью.**
- **E14, H1–H4.** Отверстия Ø3.2. Ближайшая точка заливки — r 3.60 мм от центра, то есть 2.0 мм от кромки. Подтверждаю.
- **E14, вырезы.** Окна B.Mask доходят до кромки паза: моим растром 0.00 мм. Медь всех слоёв — по правилу 0.25 мм от края.
  Подтверждаю.
- **E15.** Положения снабберов совпадают с моими данными: шесть цепочек, без виа, над In1 GND.
- **E13, E16** — оценки системы (кабели, ёмкость батареи на корпус). Не пересчитывал: исходных данных у меня тоже нет.

---

**E13 — согласен, решает владелец.**
- Вывод CHANGELOG «на этой плате ничего не меняется» был слишком сильным. Исправил его там же со ссылкой на ваше ревью.
- Места под Y (DNP) с новой цепью CHASSIS у H1/H2 и H3/H4 — это правка схемы и посадочных мест H. Сначала нужно знать, к
  чему крепятся H1–H4. Вынесено владельцу вместе с условиями для 72 В: Y2 или ≥ 1 кВ, 2 мм по поверхности, отвод VDC у
  H1/H2.

**E14 — маска сделана (F14), остальное решает владелец.**
- Окна B.Mask узлов отодвинуты от пазов на 1.5 мм. Открытой меди узла в 1.5 мм от кромки было 9.2 / 12.6 мм², стало
  0 / 0.1 мм².
- **Медь узла в 0.25 мм от кромки паза.** Отвод на ≥ 1 мм снимает 6 / 13 виа (Р8), как вы и пишете. Не делал: сначала —
  втулки с буртиком.
- **H1–H4:** шайбы ≤ Ø6 или изолирующие, либо запрет заливки r 4.5 мм — решение владельца.

**E15 — согласен, решает владелец.**
- Поставить ли LS-снабберы хотя бы на одной из первых плат — вопрос владельцу.
- Нагрев R и банок тепловизором — в списке стенда. По модели 07 P10 в R уходит 0.1–0.2 Вт, а не 0.5–0.66 Вт.

**E16 — решает владелец** (опора остальных узлов CAN и датчиков Холла). Стоит вместе с E12.

**E17, E18 — согласен.**

**Пункты раунда 1:**
- **E4** — закрываю по доводу 05 P8, оба ревью согласны.
- **E3 и E12** — открыты, это правка схемы.
- Норма ЭМС — вопрос владельцу.

**Замеры** — список «Что мерить на стенде» перенесён в CHANGELOG.

**Остаётся открытым:** E13, E14 (крепёж), E15, E16, E3, E12 и норма ЭМС — решения владельца.
