alsizyakin/InvertorPowerNewGen/docs/reviews/05_review_gnd_power.md

# Ревью силовой части: InvertorPowerNewGen, ветка `rev0.1-gnd` (115276c)

*Ревьюер: субагент «инженер силовой электроники», 2026-10-17. Текст — как получен.*

**Вердикт.**
- Под ключами обратный путь заметно лучше, чем в rev0. Петля затвора HS стала замкнутой и короткой. DRC чистый: на копии 0 нарушений, 18 неразведённых (это снабберы вне платы), 0 расхождений со схемой.
- Цель §4 (петля 0.5–0.7 нГн) не достигнута. Под каждым D-пэдом In3 вырезан. Ёмкостная ветвь — один 1206 на фазу, по оценке она сопоставима с путём через ключи.
- Снабберы из пробы «+4 мм» в предложенной U-геометрии снизят выброс на 13–17 %, а не на 35 %. R 1206 на 72 В перегружен. Проба Д3 мест под снабберы не даёт (проверено на копии).
- После Кельвина выброс HS вырастет до уровня LS, а замеров HS ещё нет. Для 72/84 В ни одна мера в одиночку не держит кристалл ниже 100 В. Нужны вместе: меньше L петли, компактный снаббер и более медленное выключение (раздел Д).
- `rev0.1-gnd` внутри блока ничего не меняет относительно `rev0.1`: In3 там уже был чистым. Её вклад — мосты GND и восстановленная горловина узла C.

**Как проверял.**
- Медь всех 6 слоёв трёх ревизий (main, cebc037, 115276c) растеризовал с шагом 0.05 мм. По растру — покрытие слоёв, сечения, что лежит рядом с дорожками. Зазоры считал по геометрии пэдов, дорожек и заливок.
- Индуктивность пути ключей — своя PEEC-модель. Ток через корпуса задан, ток возврата в In3 решается по минимуму энергии. Проверка на микрополоске: расхождение с формулой Уилера ±2 % при h = 0.79 мм.
  - Абсолют модели со стендом не сходится: для rev0 модель даёт 2.6–3.5 нГн только на путь ключей, а частота звона на стенде даёт ≲1–1.3 нГн на всю петлю. Поэтому беру **только отношения**.
- Выброс — модель выключения LS: L петли, L корпусов 0.25 нГн на пару, нелинейная Coss из библиотеки pslc, спад тока 6 нс. Калибровка: 48 В, 120 А, L_ext 0.75 нГн → 32 В на выводах; на стенде 33–37 В.
- DRC и Д3 — kicad-cli на копии проекта. Для Д3 удалил 12 R_gs, перезалил зоны, прогнал `snub_search.py` и `snub_search2.py`.

---

## Находки

### P1 — высокая. Петля коммутации: возврат только по In3, и он с окнами; ветвь керамики слабая
**Где.** Блок, все фазы. Смотрел полосу под путём тока «сток HS → узел → исток LS»: x 119.6–133.6 (+17/+34 по фазам), y 75–89.
- In1, In2, In4 и B.Cu там — острова узла и VDC (узел 62–66 %, VDC 71–85 % площади). GND на этих слоях есть только в полосах и в верхней ленте (y < 74.5).
- In3 — единственный GND под путём, в 0.79 мм под F.Cu.
  - Под каждым D-пэдом In3 вырезан на 98 %. Антипады 28 отверстий сливаются: шаг 0.71 мм, пэд 0.6 + зазор 0.25. Получается 12 окон ≈ 4.2 × 3.8 мм.
  - В rev0 так же. Без смены футпринта не лечится, а футпринт трогать нельзя (Р8).
- В промежутке «D-пэд LS — выводы S HS» меди In3 теперь 94/91/93 % (C/B/A), в rev0 было 58/65/67 %.

**Модель пути ключей** (относительные единицы, VDC идёт по паре In2/In3):

| | C | B | A |
|---|---|---|---|
| rev0, возврат только по In3 | 3.50 | 3.82 | 3.83 |
| rev0.1 = rev0.1-gnd | 1.74 | 2.19 | 1.78 |
| с радиатором (проводящая плоскость на −1.76 мм), rev0 → rev0.1 | 2.58 → 1.65 | 2.81 → 1.91 | — |
| если бы окна под D-пэдами были залиты | 1.21 | 1.23 | 1.22 |

Итог по модели: путь ключей стал на 32–50 % ниже. Окна под D-пэдами добавляют +40 %. Фаза B хуже на 16–25 % (P4).

**Ветвь керамики.**
- На фазу один 1206 1 мкФ (C124/C128/C132) и те же 0603 из rev0: 2 / 1 / 3 шт. по фазам C/B/A.
- GND-пэд 1206 идёт на одну виа 0.3 мм в In3 через дорожку 0.5 × 1.1 мм. Тело конденсатора на ~1.2 мм выше In3.
- Индуктивность ветви ≈1.2–1.6 нГн (оценка; в CHANGELOG §4 — 1.3 нГн), то есть сопоставима с путём ключей.
- У C124 и C128 GND-пэд ещё и сливается с полосой GND соседней фазы, где много виа. У C132 (фаза A) — только одна виа.

**Следствие.** Частота звона вырастет, но 0.5–0.7 нГн не будет. Модель при 72 В, 120 А, спаде 6 нс: на кристалле ΔV = 41 В (113 В) при L_ext 0.75 нГн и 31 В (103 В) при 0.5 нГн.

**Что сделать.**
1. В полосе +4 мм ставить **≥2** × 1206/1210 на 100 В на фазу, а не один.
   - Вывод VDC — прямо на ленту VDC F.Cu.
   - Вывод GND — ≥2 виа у самого пэда. Под лентой In1 — GND в 0.1 мм, это лучшая опора на плате.
   - По модели при 72 В каждые −0.1 нГн L_ext дают ≈ −4 В выброса.
2. C132: добавить 1–2 виа GND. У всех трёх 1206 виа поставить вплотную к пэду, а не через 1.1 мм дорожки.
3. Если найдутся на 100 В — 0612 обратной геометрии (ESL ~0.3 нГн против ~1 нГн) на те же места. По Р12 размер допустим.

### P2 — высокая. Снабберы §5 в пробе «+4 мм»: индуктивность ветви съедает эффект, R перегружен на 72 В; Д3 не помогает
**Где.** `data/snub_plus4_ext_a.json`. C 0805 и R 1206 стоят вертикально в 2.4 мм друг от друга (C-LS: C в точке (122.2, 73.2), R — (119.8, 72.6)). Средняя точка соединена дорожкой 0.3 мм длиной 2.64 мм.

**Оценка L ветви** (над GND In1 в 0.135 мм): C ≈0.6 + R ≈0.75 + дорожка ≈0.75 + подводы ≈0.1 ≈ **2.2 нГн** (диапазон 1.5–2.5). Это больше, чем L петли.

**Модель, 72 В, 120 А, ΔV на кристалле, В** (при 84 В почти те же цифры):

| L_ext \ снаббер | нет | L_s 2.2 (как в пробе) | L_s 1.5 | L_s 1.0 |
|---|---|---|---|---|
| 0.75 нГн | 41 | 34 | 33 | 31 |
| 0.60 нГн | 35 | 30 | 29 | 28 |
| 0.50 нГн | 31 | 27 | 26 | 25 |

- Снаббер с почти нулевой L ветви (L_s 0.3 нГн) даёт 26 В, то есть −35 %, как в Находках.
- При L_s 2 нГн номиналы почти не важны: R 0.33–1 Ом и C 4.7–10 нФ дают 33.4–34.6 В. Подбирать R и C бессмысленно, пока L_s больше L петли.

**Мощность в R.** C·V²·f = 0.22 / 0.49 / 0.66 Вт при 48 / 72 / 84 В и 20 кГц, плюс часть энергии звона. 1206 «0.5 Вт» при плате 80–100 °C после снижения нагрузки держит ~0.3 Вт. На 72 В этого мало.

**Какие ключи гасит цепочка сверху блока.**
- LS-цепочка гасит оба LS фазы: Q8 и Q4 связаны по стоку через In2 узла над In3 GND (0.1 мм), по истоку — через полосу GND. Между ними ≈0.25 нГн.
- HS-цепочка гасит в основном верхний HS. Q1 и Q7 связаны по истоку только через F.Cu узла, по стоку — через колонку VDC. Это ≈0.8–1.7 нГн (оценка). Нижние HS (Q7/Q10/Q12) она почти не демпфирует.

**Д3 проверен на копии.** Удалил все 12 R_gs и перезалил зоны. `snub_search.py` (варианты a и c) и `snub_search2.py` (вариант b, с виа в слой) мест у выводов не находят ни в одной фазе. Есть только HS-C в 0603+0603 на 10.6 / 5.4 мм от выводов, как и раньше. **Д3 не нужен — R_gs оставить у затворов.**

**Что сделать.**
1. Среднюю точку сделать медным островком шириной ≥1.2 мм (или поставить пэды встык) вместо дорожки 0.3 мм. Это −0.4…−0.5 нГн.
2. R: два 1206 по 1.0 Ом параллельно (вдвое меньше L, вдвое больше мощность) или широкотерминальный 0612 на ≥1 Вт (L ~0.3 нГн; проверить наличие 0.5 Ом).
3. C 4.7 нФ C0G 0805 на 100 В оставить: C/Coss ≈ 4, волновое сопротивление петли ≈0.7–0.8 Ом, R 0.51 Ом в разумной зоне.
4. В полосе: LS-снаббер плюс 2 керамики на фазу. HS-снаббер — место без установки (DNP), с пониманием, что он работает на верхний HS.
5. До фиксации полосы снять Д1/Д2 на rev0 (см. «Что добавить на стенде», п. 3).

### P3 — высокая для 72/84 В. Выброс выключения HS вырастет до уровня LS, а замеров HS нет
**Где.** NT1–NT3 стоят в 2.3–2.8 мм от выводов S HS, вне пути тока коммутации, — Кельвин работает. В rev0 SW подключался у шунта, L_cs(HS) ≈1–2 нГн, и выброс HS был 8–16 В.

**Оценка** по формуле Находок di/dt = gm·(Vpl − Voff)/(Ciss·R + gm·L_cs) при gm 62 См, Vpl 4.9 В, Ciss 5.2 нФ:
- rev0, HS (R ≈2 Ом, L_cs 1.5 нГн): 2.9 А/нс на прибор;
- rev0.1, HS с Д (R ≈ 2·0.82 + 1 + 1.3 + 0.5 = 4.4 Ом, L_cs 0.3–0.5 нГн): 5.6–7.3 А/нс, то есть в 1.9–2.5 раза больше;
- проверка формулы: LS платы A даёт 7.3–10.5 А/нс на прибор, 15–21 на позицию; на стенде ~20.

**Следствие.**
- Выброс HS ожидаю на уровне LS этой ревизии: 20–27 В на выводах при 48 В и 120 А.
- Д по сравнению с платой A снижает di/dt на ~27 % (спад ≈8–9 нс). При 72 В и L_ext 0.75: 27 В на кристалле без снаббера (99 В), 22 В со снаббером L_s 1.5 (94 В). Запаса почти нет. Замер P2 (выброс HS) не сделан, HS-снаббера нет.

**Что сделать.**
1. Сделать P2 на rev0 сейчас. Затем эмулировать Кельвин на rev0: дорожку SW от D4.6 перерезать у шунта и провести проводом к выводам S Q1/Q7. Так рост di/dt HS будет виден до заказа.
2. R_on HO (R106–R108) и R_on LO (R112–R114) — отдельные детали. Выключение HS можно замедлить отдельно (например 1.5–2.2 Ом), не трогая LS.

### P4 — средняя. Разброс фаз: B хуже из-за поля виа узла под нижним рядом
**Где.**
- Из виа поля узла B **26 стоят выше y 90.1**, то есть прямо под нижним рядом (Q5/Q10; низ D-пэдов на y 88.45). In3 там сплошь в антипадах: x 137.3–144, y 88.4–92.8.
- У фазы C таких виа 0 (поле начинается с y 91.75), у A — 8.

**Модель.** Путь ключей B — 2.19 против 1.74/1.78 у C/A (с радиатором 1.91 против 1.65). Если освободить полосу In3 шириной 1.1 мм (y 88.4–89.5) под нижним рядом B, получается 1.79 — как у C/A. Виа в среднем ряду (TH, NT, R_g) на результат не влияют (<1 %).

**Добавляют разброс.** C132 (фаза A) — одна виа GND. Набор 0603 остался как в rev0: 2/1/3, и C93 стоит над узлом B, а не у стока.

**Следствие.** Звон фазы B на ~7–10 % ниже по частоте, выброс выше на ~10–15 % при том же di/dt (оценка).

**Что сделать.** 26 виа узла B с y < 90.1 перенести ниже (y ≥ 90.6) или в проход J1–J2 — число по Р8 сохраняется. C132 — по P1. C93 — к стоку B (в пробе +4 мм уже предложено место x 148–151).

### P5 — средняя. Зазоры для 72–84 В: открытые пэды в 0.225–0.47 мм от меди с разностью 84–96 В
**Измерено** (внешние слои; разность — максимальная при шине 84 В):

| Зазор, мм | ΔV, В | Что с чем | Фазы |
|---|---|---|---|
| 0.225 | 84 | C124.1/C128.1 (VDC) ↔ C100.1, R19.2 / C104.1, R30.2 (затвор HS) | C, B (у A — 0.56) |
| 0.23 | 96 | C7.2, C8.1, C8.2 (SW/BST) ↔ дорожки HI соседнего драйвера (D5-HI, D6-HI) | C→B, B→A |
| 0.281 | 84 | C_gs верхних HS (C100.1, C104.1, C108.1) ↔ D-пэд нижнего HS (VDC) | все |
| 0.325 | 96 | R23 / R28 / R34 (HO, затвор HS) ↔ дорожки +3.3V и NTC | все |
| 0.35 | 96 | U4.2 / U9.2 / U12.2 (GND) ↔ HO_DRV на B.Cu | все |
| 0.42–0.47 | 84–96 | C106.1↔Q1.D, Q6.D↔C110.1, TH1–3↔D-пэды LS, R73.1 (ADC_IN_3)↔SW A | — |

- Всего 27 мест меньше 0.5 мм. В rev0 их было 17, худшее 0.447 мм. Выводы J6.5/J6.6 не считаю — они свободные.
- Нормы IPC-2221B, табл. 6-1:
  - открытые выводы компонентов без покрытия (A6): 0.4 мм для 31–50 В, 0.5 мм для 51–100 В;
  - дорожки под маской (B4): 0.13 мм;
  - внутренние слои (B1): 0.1 мм.
- Внутренние слои и дорожки под маской проходят (в проекте один класс с зазором 0.2 мм). Места 0.225–0.35 мм у открытых пэдов не проходят уже при 48 В.

**Что сделать.**
1. C124 и C128 сдвинуть на +0.3 мм по x: GND-пэд уйдёт глубже в полосу GND (та же цепь), зазор станет 0.525 мм.
2. Дорожки HI соседнего драйвера отвести от C7/C8 на ≥0.5 мм.
3. Добавить правило в `.kicad_dru`: на внешних слоях 0.5 мм между {VDC, узлы, цепи домена HS} и остальным — DRC сам найдёт такие места.
4. Для 72/84 В — эти правки или лак (A7: 0.13 мм). **Решает владелец.**
5. Держать пики ниже 100 В. Иначе действует строка 101–150 В: B4 0.4 мм, A6 0.8 мм.

### P6 — средняя. Раздел Д: задержка в норме, но фронт и потери растут; C_gs стоят не у выводов
- **Задержка.** τ_выкл ≈ 4.4 Ом × 15.1 нФ ≈ 67 нс (на стенде B — 42 нс). Задержка ≈ 1.45·τ ≈ 97 нс; коэффициент 1.45 взят со стенда (62/43). Это много меньше мёртвого времени 500 нс.
- **Фронт и потери.** Ток затвора на плато 4.9 В / 4.4 Ом ≈ 1.1 А (на стенде B — 1.75 А). Фронт напряжения ≈ Qgd/Ig ≈ 29 нс вместо 18 (+60 %). По таблице pslc при 120 А и 20 кГц: R_g 2.7 Ом против 1 Ом — E_sw +10 %, +2.2 Вт на три фазы. Плата за это — di/dt −27 % (P3).
- **Бутстреп.** Заряд на одно включение HS ≈ 2 × (≈108 нКл + 10 нФ · 12 В) ≈ 0.46 мкКл. На 1 мкФ это ΔV ≈ 0.5 В, с учётом DC-bias до ~0.7 В. До UVLO запас есть. Напряжение C7–C9 в схеме не указано — проверить, что ≥25 В.
- **Положение C_gs.** C_gs стоят в 3.4–4.7 мм (центр–центр) от выводов G/S своего ключа; C106, C107, C111 — в 1.2–2.9 мм. На стенде 16.10 C_gs были прямо на выводах. Контур удержания ~1–2 нГн против ~0.5, так что наброс на плате может быть выше 1.3 В. Проверить на стенде.
- **Тип C_gs.** 10 нФ C0G 50 В в 0603 существуют (Murata GRM1885C1H103J…, TDK C1608C0G1H103J…) — брать C0G.
- Д1 в плату ещё не внесён (C100–C111 = 4.7 нФ DNP) — по заданию так и должно быть.

### P7 — низкая. Сечения по току
- **Узел C**, горловина между отверстием крепежа и J1 (y ≈ 95.75–96): F.Cu 4.2 + In2 3.7 + B.Cu 4.2 = 12.1 мм ширины меди (0.42 мм²). В rev0 было 12.9 мм.
  - В `rev0.1` было 7.6 мм: виа перехода LO C в точке (124.0, 96.1) резала F.Cu и B.Cu. В `rev0.1-gnd` это исправлено.
  - Оставшиеся −0.8 мм на In2 — дорожка VDC → J6.
- **Узел B** — 14.0 мм (rev0 14.6). **Узел A** — 16.5 мм (rev0 18.9, −13 % с rev0.1): в проходе A легли SW A на In1 и U3+/+3.3V на In2.
- При 120 А постоянного тока (стопор) в горловине C ~285 А/мм², ~1 Вт на ~2 мм длины (оценка). Тепло уходит в радиатор: маска B.Cu там открыта до y 100.5.
- **Phase_OUT.** Потери на In4/In2 (−26/−20/−10 мм²) — тупиковые куски ниже кустов виа шунтов, подтверждаю. Обхват втулок заливкой по слоям не изменился: F.Cu/B.Cu 10–11 мм из 25, внутренние 12–18 мм. Между шунтом (B.Cu) и внутренними слоями Phase_OUT — 9–10 виа на фазу, как в rev0.
- **Шина.** Минимальные сечения VDC/GND — 58.5 / 71.7 мм ширины меди, без изменений.
- **Тепло и Р1/Р8.** В каждом D-пэде по-прежнему 28 отверстий. Под радиатором на B.Cu деталей нет. Виа GND в блоке 165 → 175, виа узла 147 → 147.

### P8 — низкая. Петли затворов после переноса In3: индуктивность не хуже rev0.1, связь с узлом пренебрежима
- **HO/SW фаз C и B.** 12 мм идут парой In2/In4 через In3: 0.66 мм по вертикали, в плане совпадают (0.1 мм). Ещё 13–17 мм — рядом на In4 с шагом 0.7–1.0 мм.
  - По индуктивности это то же, что было на In3/In4: ~0.78 нГн/мм в обоих случаях (две микрополоски над In3, 0.26 + 0.53, против пары с зазором 0.52 мм).
- **Фаза A.** HO на In4, SW на In1: 22.6 мм, 1.17 мм по вертикали, между ними In2 и In3. Ещё 3.3 мм HO идёт по F.Cu к R3 в 3.4 мм от SW.
- **Оценка петель.** HS ~18–21 нГн на фазу (C/B/A близки), LS ~15–20 нГн. С C_gs 10 нФ: Z0 = √(20 нГн / 30 нФ) ≈ 0.8 Ом при R ≈ 2.5 Ом → ζ ≈ 1.5, звона не будет. В rev0 петля HS была ~6 × 28 мм вокруг самого ключа.
- **Нижние HS** (Q7/Q10/Q12): R_g,i стоят в нижнем ряду колонки стока (R1–R3), а возврат идёт вверх к NT (y 81.5) и обратно вниз по SW. Петля больше, чем у верхних HS; расхождение по времени ~2 нс (оценка) — некритично. Цепи затворов от R_g,i до G симметричны: 4.5–5.8 мм.
- **Связь с узлом.**
  - LO в 0.1 мм над медью узла на B.Cu: C — 17.5 мм, B — 12.7, A — 13.3. Это 3–4 пФ, 0.15–0.2 нКл за фронт против Qgd 2 × 32 нКл (<0.5 %).
  - HO C/B на In2 в 0.1 мм над GND: ~2 пФ, ~40 мА при 20 В/нс.
  - NTC (U1+) 11.5 мм на In4 над узлом C: на входе LMV321 стоит 100 нФ, наводка — единицы мВ.

---

## Что хорошо
- In3 — один кусок, в блоке без дорожек. Горловина узла C восстановлена. Мосты GND суммарно 11.25 мм (In1 + In3 + In4).
- Кельвин HS: NT в среднем ряду, вне пути тока коммутации. SW связан с узлом только там, HO на всём пути идёт парой с SW.
- 1206 в среднем ряду колонки стока — правильное место: симметрично между верхним и нижним HS, одинаково на трёх фазах.
- На каждый прибор свои R_g,i и C_gs. R_on для HO и LO — отдельные детали, скорость HS и LS можно подбирать раздельно.
- Р1 и Р8 соблюдены (P7). DRC 0 / 18 (снабберы) / 0 — проверено на копии. На VDD каждого драйвера 10 мкФ.

## Что добавить на стенде
1. Сначала Р1 (наводка на щуп), затем Б1–Б5 на **всех трёх** фазах: частота звона и выброс. По модели B должна быть на 7–10 % ниже по частоте.
2. P2 (выброс HS) на rev0 и эмуляция Кельвина проводом (P3) — до заказа rev0.1.
3. Д1/Д2 на rev0:
   - снаббер распаять дважды — с ветвью ~2 нГн, как в U-пробе, и максимально коротким;
   - отдельно 2–3 × 1206 у стойки;
   - по результатам решить, чем заполнять полосу +4 мм.
4. Наброс на затвор LS при C_gs в 3–4 мм от выводов (как на плате) против C_gs прямо на выводах.
5. Нагрев горловины узла C и шунта при 120 А постоянного тока (стопор), со стороны F.Cu.
6. Для 72 В поднимать шину ступенями 48 → 60 → 72 В. Пик на выводах держать < 90 В: на кристалле по модели на ~10 В больше.

**Не проверено:** абсолютная L петли (модель с бенчем не сходится, взяты только отношения), чертёж радиатора, наличие 0612 нужных номиналов на 100 В, номинальное напряжение C7–C9.
