alsizyakin/InvertorPowerNewGen/REV0_1_TASK.md

# InvertorPowerNewGen — ревизия 0.1: доработка PDFN-версии по стенду 13.10.2026

**Редакция 2 от 2026-10-15.** Редакция 1 — коммит `403fd38`. В редакции 2 внесены решения владельца от
2026-10-15 (раздел **Р**); места, которые они меняют, помечены «(Р1)»…«(Р7)».

**Дополнение от 2026-10-17 — раздел Д** (стенд 16.10: C_gs, D_off, R_gs). Оно заменяет в §3.3 строки C_gs
и D_off.

Задание подготовлено в проекте `~/Git/PC/power_loss_calc` (pslc) по результатам
стенда и разбору `Power.kicad_pcb`. Обоснование, картинки и числа —
`bench_2026-10-13/BENCH_FINDINGS.md` (дальше — **«Находки»**, ссылки вида «Находки §3.1»).

**Ревизия 1 (TOLT, `REV1_TASK.md`) откладывается.** Сначала дорабатывается текущая плата с теми же ключами,
проверяется на стенде, и только потом — следующая ревизия. Уроки этой доработки для rev1 — Находки §9.

---

## Как пользоваться этим документом

- Разделы выполняются сверху вниз, каждый — отдельным коммитом.
- Под каждой задачей — **Почему** (одна-две строки и ссылка на Находки) и **Приёмка** (что проверить скриптом
  или глазами).
- Координаты — в мм, как в KiCad, по текущему `Power.kicad_pcb` (rev0).

| Пометка | Смысл |
|---|---|
| **Почему:** | обоснование; подробности — в Находках |
| **Измерено:** | факт из `Power.kicad_pcb` или со стенда |
| **Проверить:** | цифра прикидочная или зависит от того, что видно только в KiCad |
| **Решает владелец** | вопрос, где у задания нет данных; вынести в CHANGELOG и спросить |

---

## A. Что это за доработка

**Плата остаётся той же:**
- 12 × WMB043N10HGS (PDFN 5×6, по два на ключ, на F.Cu);
- драйверы D4–D6 NSD1624 с бутстрепом;
- контур, стек (6 слоёв, медь 35 мкм), разъёмы J6/J7 и втулки J1–J5 — как в rev0 (`REV1_TASK.md` A.4 в силе).

**Что показал стенд** (только фаза C, 48 В, до 120 А; Находки §0, §3):
1. Выброс при выключении нижнего ключа — 83–87 В при 120 А (ΔV 33–37 В). Спад тока ~6 нс. Для 72-вольтового
   варианта это за пределом 100 В.
2. Звон 125–139 МГц → индуктивность петли ~1 нГн. Общий участок истока у LS мал (0.3–0.5 нГн), у HS — больше.
3. Наброс на затвор выключенного LS — 2.8–3.4 В при Vth typ 2.9 В (min 2 В).
4. На плате B при 20 А узел проседает до 24 В через ~70 нс после включения HS.

**Что в разводке за этим стоит** (Находки §2):
- обратный путь петли коммутации — слой In3 — под ключами нарезан дорожками;
- у ключей только 0603;
- возврат затвора HS — у шунта, в 15–25 мм от истоков;
- входы HI/LI без RC у конца пура узла;
- фазы несимметричны.

**Цель ревизии 0.1:**
- меньше индуктивность петли и её разброс по фазам;
- управляемые и короткие петли затворов;
- места под снаббер, C_gs и R_off, чтобы подобрать их на стенде;
- точки для щупа.

Компоновку силового блока (колонки ключей по фазам) **не меняем**.

---

## Р. Решения от 2026-10-15

Приняты после разбора задания по плате. Полностью задание в этот размер не помещается: обвязке затворов,
керамике, снабберам и площадкам для щупа нужно ~230–270 мм² на фазу, а свободно на F.Cu вокруг ключей
~130 мм² (оценка по посадочным местам; средний ряд между ключами — 3.4 мм по высоте, нижний до втулок —
~2.8 мм). Отсюда компромиссы ниже.

| № | Решение | Почему |
|---|---|---|
| Р1 | **На B.Cu под блоком компонентов нет.** Керамика §4 и снабберы §5 — только на F.Cu | B.Cu под блоком — сторона радиатора: на колонках узла маска открыта (y 74…100). Пазы в радиаторе делать нельзя |
| Р2 | **Ветвь выключения D_off + R_off — одна на позицию** (6 шт., у драйвера). У каждого затвора остаются свой R_g,i, R_gs и C_gs (DNP) — §3.3 | На пять деталей на затвор нет места. Колебания между параллельными затворами демпфирует только сопротивление контура «затвор — затвор», а общая ветвь в него не входит; R_g,i ≥ 1 Ом даёт тот же контур, что на плате B |
| Р3 | **Термистор остаётся на узле, как в rev0;** схема делителя и прошивка не меняются. Его линии внутри блока переходят с In3 на In1 по той же трассе (§2.3) | На полосе GND он снял бы 6–11 виа на фазу (Р8). Связь линий с узлом — как сейчас: на In3 они идут в 0.1 мм под медью узла на In2, на In1 будут в 0.1 мм под F.Cu |
| Р4 | **Разделы 0.1 и 0.2 из `rev1` перенесены** cherry-pick'ом | Библиотеки и флаги питания общие; ERC 21 → 9 ошибок |
| Р5 | **ERC: ошибок не больше, чем на базе** — 9 после переноса 0.1/0.2. DRC — без ошибок | С этой схемой платы собраны и работают. 8 из 9 ошибок — дефект символа TLV3502 (U6) на замороженном листе OCP |
| Р6 | **Керамика §4 — сколько позволит место**, одинаково по фазам. 0603 C90, C92…C96 — по месту: оставить, если не мешают | — |
| Р7 | **Шаг пары площадок для щупа ~5 мм** (пружинная земля) | — |
| Р8 | **Виа — не меньше, чем в rev0, по каждой фазе** (§7). Подтягивать B и A до числа виа фазы C не нужно | Принято при условии, что тепло и ток отводятся не хуже rev0. Основной путь тепла ключа — D-пэд и 28 отверстий в нём на B.Cu и радиатор — доработка не трогает. Виа полос и узла не убавляются, а rev0 на всех фазах работает |
| Р10 | **VDC → J6.1–4 можно перекладывать тонкой дорожкой** и увести с мостов GND (§9 (в′)) | Питает преобразователи МК и драйверов на Connector_Board; ток — десятки миллиампер (зависит от частоты ШИМ) |
| Р11 | **Детали у драйверов можно ставить на B.Cu** (ветви выключения §3.3, RC §6) — вне радиатора, если рядом с обвязкой шунтов (U4/U9/U12) найдётся место | На F.Cu между бутстрепным конденсатором одного драйвера и входами следующего ~1 мм |
| Р12 | **Корпуса не меньше 0603** | Ручная перепайка на стенде |
| Р13 | **Мосты GND (§9 (в′)) считаются суммарно** по проходам и слоям In1/In4, не меньше rev0 (4.85 мм) | Полоска In4 в проходе J1–J2 (0.35 мм) уходит под пару HO+SW фазы C; мост In4 слева от J1 после переноса VDC → J6 на In2 прибавил 0.7 мм |
| Р14 | **Ветвь выключения без R_off:** у драйвера R_on (0603) ∥ D_off (SOD-323), у затвора — один R_g,i. Для HS и LS одинаково. Ветвь HO — на F.Cu справа от своего бутстрепного конденсатора (входы соседнего драйвера перекладываются), ветвь LO — на B.Cu между усилителями шунтов | На 0603 у драйверов помещается по 2 детали на ветвь. Включение — через R_on + R_g,i, выключение — через диод + R_g,i; R_off — слабый рычаг (Находки §3.1). Бутстрепные C7–C9 остаются на месте |
| Р15 | **Керамика §4 — по 4 × 1206 1 мкФ 100 В на фазу** в схеме (C124–C135); лишние удаляются после расстановки | Р6: сколько позволит место |
| Р9 | **Длины затворных дорожек:** LO — не длиннее rev0, HO — по месту, но на всём пути парой с SW. Без меандров | Втулки J1–J3 заставляют вести пары фаз разными путями. Меандры для выравнивания добавили бы индуктивность; для HO важна площадь петли (§3), а не длина |

---

## Д. Дополнение от 2026-10-17: стенд 16.10, C_gs у выводов

Выполнять после текущей паузы (CHANGELOG, §5), отдельными коммитами Д1, Д2, Д3. Результат Д3 — в CHANGELOG.

**Измерено.** Плата B, фаза C, 48 В. C_gs стояли на всех четырёх ключах фазы, у выводов: сначала 100 нФ, потом
4.7 нФ, потом 10 нФ. Данные — в pslc, `docs/validation/bench_2026-10-16/`.

| | Без C_gs (13.10) | 4.7 нФ | 10 нФ |
|---|---|---|---|
| Наброс на затворе выключенного LS, у выводов | 3.0–3.4 В (0–20 А) | 1.9–2.1 В (60 А) | **1.3 В** (60 А) |
| Выброс при выключении LS, 60 А | ≈ 20 В | 26 В | 20–24 В |
| Задержка выключения: начало спада затвора → 10 % Vds | 34 нс | 48 нс | 62 нс |

- **Задержку C_gs увеличивает.** Постоянная спада затвора у выводов на всех снимках — τ = 2.8 Ом · (5.1 нФ + C_gs).
- **Выброс C_gs не снижает.**
  - Между C_gs и кристаллом стоит R_g,int 1.3 Ом. Быстрые процессы — спад тока ~5 нс — идут через него мимо C_gs.
  - 100 нФ выброс снизили, но задержка выросла до ~300 нс при мёртвом времени 500 нс: сквозной ток был близко.
    Такой номинал не ставить.
- **Диод D_off ускоряет выключение и этим поднимает выброс.** 13.10, 120 А: на плате A (с диодом) 37 В, на B
  (без диода) 33.5 В. Удерживать выключенный затвор теперь будет C_gs у выводов, поэтому диод больше не нужен.

### Д1. C_gs — 10 нФ, ставится

- C100–C111: было 4.7 нФ DNP, станет **10 нФ 0603 X7R 50 В** (C0G 50 В, если найдётся). **Ставится.**
- Посадочное место и разводка — без изменений.
- **Почему:** наброс у выводов падает с 3.0–3.4 до 1.3 В.
- **Проверить:** каждый C_gs подключён между выводом G и выводами S своего ключа, после R_g,i — как сейчас.

### Д2. D_off — не ставится; R_on — по стенду

- D30–D35 — **DNP**. Места остаются: они у драйверов, в блоке ключей места не занимают.
- R_on (R106–R108, R112–R114) без диода работает на оба фронта. На прибор получается 2·R_on + R_g,i:
  - R_on 0 Ом → 1 Ом на прибор, как плата B на стенде 16.10;
  - R_on 0.82 Ом (как сейчас) → 2.6 Ом на прибор, как опыт Р5 pslc (R_g 2.7 Ом).
- В схеме оставить 0.82 Ом. Окончательный номинал — по Р5 (pslc `docs/validation/program_osc.md`).
- **Почему:** один R на оба фронта замедляет и включение, и выключение. Медленнее включение — меньше наброс на
  кристалле соседа; медленнее выключение — меньше выброс. Диод замедлил бы только включение.

### Д3. R_gs — проба: вынести из блока ради мест под снаббер

**Сейчас:** R_gs 10 кОм 0603 стоит у каждого из 12 затворов:
- HS: R19, R26 (C), R30, R32 (B), R36, R38 (A);
- LS: R21, R27 (C), R31, R33 (B), R37, R39 (A).

**Проба:**
- Вместо них поставить один 10 кОм 0603 на позицию у драйвера, всего 6 шт.
- Подключение: от точки X (после R_on ∥ D_off, до разветвления на R_g,i) к опорному выводу драйвера. Для HO это
  SW у C7–C9, для LO — GND.
- Затем повторить перебор мест под снаббер §5: `snub_search.py`, `snub_search2.py`.

**Принимать, только если** у выводов появится место под снаббер (не дальше 2–3 мм, как в §5). Иначе R_gs оставить
у затворов: там они защищают затвор при обрыве его цепи. Результат пробы — в CHANGELOG.

**Почему это безопасно:**
- Через 10 кОм текут микроамперы–миллиамперы.
- У драйвера R_gs стоит параллельно его выходу: от точки X до выхода ~1 Ом через R_on.
- Обратный путь — та же пара HO/SW или LO/GND, новой петли нет.
- Быстрые скачки при обесточенном драйвере ограничивает C_gs 10 нФ у выводов: наброс ~1.2 В.

**Цена:** при обрыве R_g,i или дорожки затвор висит. **Проверка после сборки:** омметр между затвором и истоком у
каждого ключа должен показывать ≈ 10 кОм.

**Какой снаббер от чего:**
- снаббер LS (узел ↔ GND) гасит выброс выключения LS — ток втекает в фазу;
- снаббер HS (VDC ↔ узел) гасит выброс выключения HS — ток вытекает.

В моторе за период бывает и то, и другое, поэтому важны оба. Насколько выброс снизит один R_g без снабберов,
покажет Р5. До его результата решение по §5 остаётся за владельцем.

---

## 0. Правила работы

- **Ветка `rev0.1` от `main`.** `main` не трогаем; ветку `rev1` не трогаем (в ней уже удалены Q7…Q12).
  - Разделы 0.1 и 0.2 из `rev1` (библиотеки, ERC) — общие, **перенесены** `cherry-pick`'ом (Р4); их запись —
    в `CHANGELOG_rev1.md`. Раздел §1.3 rev1 (удаление ключей) — **нельзя**.
- **Не менять:**
  - ключи и их места (Q1…Q12), драйверы D4–D6 по типу;
  - контур, стек, разъёмы J6/J7, втулки J1–J5;
  - шунты R7/R9/R52 и усилители U4/U9/U12;
  - МК U5, CAN, питание 3.3 В;
  - листы `Hall`, `Over_Current_Protection`.
- После каждого раздела: ERC — ошибок не больше, чем на базе (9, Р5), Annotate без дубликатов, обновление PCB
  из схемы без потерянных футпринтов, DRC без ошибок.
- Новые позиции, которые ставятся не сразу, — в схеме с пометкой **DNP** (не устанавливать). Номиналы для стенда —
  в поле значения, как ориентир.
- Всё, что изменено, — в `CHANGELOG_rev0.1.md` по разделам этого задания: по обозначениям, с обоснованием одной
  строкой.
- Скрипт разбора `.kicad_pcb` в проекте уже есть (`REV1_TASK.md` §5, п. 5). Готовый простой разбор лежит и в
  `bench_2026-10-13/tools/kpcb.py`. Все проверки «Приёмки» — скриптом, с числами в CHANGELOG.

---

## 1. Подготовка и сверка

1. Создать ветку `rev0.1` от `main`. Положить в неё `REV0_1_TASK.md` и папку `bench_2026-10-13/` (они лежат в
   рабочей папке незакоммиченными).
2. **Сверить Находки §2 со своим разбором** — до правок:
   - возвраты драйверов (SW — к узлу у шунта, GND — на слои GND);
   - длины HO/LO по In3;
   - что режет In3 под блоком;
   - 0603 по фазам;
   - виа у истоков.

   Расхождения записать в CHANGELOG — задание опирается на эти факты.
3. **Сверить фактические номиналы 0603** C90, C92…C96 по закупке (как `REV1_TASK.md` §0.3).

**Приёмка:** таблица сверки в CHANGELOG.

---

## 2. In3 под ключами — без пересечений: переложить затворы и термисторы

**Почему:**
- Под ключами In1, In2 и In4 заняты пурами узлов и VDC, In3 — единственный сплошной GND. Его пара с In2 (VDC) —
  через 0.1 мм препрега, это лучшая пара плоскостей платы и естественный обратный путь петли коммутации.
- **Измерено:** под блоком In3 режут шесть затворных дорожек HO/LO (27–35 мм каждая), +3.3 В к термисторам и
  три цепи NTC. Обратный ток петли обходит прорези (Находки §2.2, рис. 3).
- Дорожки нужны — их не убирают, а **перекладывают в медь своего опорного потенциала** (Находки §5, рис. 5).

**Область «блок ключей»:** x 116.2…169.2, y 72.0…91.5 (ключи и ряд керамики над ними).

| Фаза | Полоса GND (истоки LS) | Узел | Сток HS (VDC) |
|---|---|---|---|
| C | x 116.2…121.2 | x 121.2…128.2 | x 128.2…134.2 |
| B | x 134.2…138.2 | x 138.2…145.2 | x 145.2…151.2 |
| A | x 151.2…155.2 | x 155.2…162.5 | x 162.5…169.2 |

**Измерено:** в полосах GND — земля на In1…In4 и B.Cu.

### 2.1 Затворы нижних ключей (LO)

LO каждой фазы (`/Driver_x/LO`) внутри блока вести **по In4 вдоль полосы GND своей фазы**, к R_g нижних ключей:
- фаза C — R25 (Q8), R4 (Q4);
- фаза B — R29 (Q9), R5 (Q5);
- фаза A — R35 (Q11), R6 (Q6).

Дорожка идёт параллельно полосе (по y), с её внешнего края. Выше и ниже блока — как удобно.

**Проверить:** полосы 4–5 мм шириной, в них виа GND истоков (92 / 38 / 34 по фазам C / B / A). Дорожка 0.5 мм
должна пройти между ними с зазором; если не проходит — 0.3 мм.

### 2.2 Затворы верхних ключей (HO) — вместе с §3

HO каждой фазы (`/Driver_x/HO`) вести **по In4 внутри узла своей фазы, парой с отдельной дорожкой SW** (§3.1).
Дорожки идут рядом, параллельно току узла (по y).

R_g верхних ключей перенести на сторону узла, к выводу G (x ≈ 127.6 / 144.6 / 161.6). Сейчас они стоят справа,
над стоком:
- фаза C — R23 (Q1), R1 (Q7);
- фаза B — R28 (Q2), R2 (Q10);
- фаза A — R34 (Q3), R3 (Q12).

R_gs (R19, R26, R30, R32, R36, R38) уже стоят у узла.

### 2.3 Термисторы

**Почему:** TH1/TH2/TH3 стоят на пуре узла между двумя LS (x 124.25 / 141.25 / 158.25, y 81.75). Поэтому их цепи
(+3.3 В и `Net-(U1-+)`…`Net-(U3-+)`) идут по In3.

- Перенести термистор **на полосу GND своей фазы, у истоков LS**, по высоте — там же (y ≈ 82, между Q8/Q4 и т. п.).
- +3.3 В и линию к U1–U3 вести вдоль полосы по In4, как LO. **Схема делителя не меняется.**
- В CHANGELOG отметить: датчик теперь меряет у истоков LS, а не у стока. На стенде сравнить с прежним положением.
- **Решено (Р3, уточнено 2026-10-15): датчик остаётся на узле, как в rev0.** Линии +3.3 В и NTC внутри блока
  переходят с In3 на In1 по той же трассе, за блоком — на In3, как сейчас. Схема и прошивка не меняются.
  Пункты выше про перенос на полосу GND не выполняются: на полосе датчик снял бы 6–11 виа на фазу (Р8).

### 2.4 Прочее на In3 в блоке

Прочие дорожки In3 из блока увести: `+3.3V` вне цепей термисторов и т. п. **Измерено:** +12 В идёт по In3 ниже
блока (под втулками и шунтами) — его не трогать.

**Приёмка §2:**
- в области «блок ключей» на In3 нет ни одного сегмента дорожки, только зона GND (виа допустимы);
- на In2 зона VDC в блоке не уменьшилась против rev0;
- LO и линии термисторов — в своих полосах GND; HO — внутри своего узла;
- длины (Р9): LO — не длиннее rev0 (37.8 / 33.7 / 34.4 мм по фазам C / B / A); HO — парой с SW на всём пути, без
  меандров.

---

## 3. Петли затворов

### 3.1 Кельвиновский возврат HS

**Почему:**
- **Измерено:** вывод SW драйвера (D4.6, D5.6, D6.6) подключён к узлу у шунта (y ≈ 100–104), в 15–25 мм от истоков
  HS.
- Петля затвора HS ≈ 6 × 28 мм охватывает сам ключ. Отсюда большая индуктивность петли, связь с силовым контуром
  и, на плате B, вероятно, звон (Находки §2.3, рис. 4, §3.2).

**Что сделать:**
- Выделить SW драйвера в отдельную цепь (`/Driver_x/SW`), соединённую с узлом **только у выводов S верхних ключей**
  — через net-tie (`NetTie` с группами пэдов) у пэдов S Q1/Q7, Q2/Q10, Q3/Q12. От драйвера — дорожкой парой с HO
  (§2.2).
- Бутстрепный конденсатор C7/C8/C9 подключить к этой же цепи SW у драйвера, как сейчас.

**Проверить:** у каждой фазы два HS, их S-пэды — на одной вертикали (x 127.6 и т. д.). Точку net-tie поставить
между ними или у верхнего; записать решение.

### 3.2 Возврат LS

**Не менять:** GND драйвера через слои GND к истокам LS. Общий участок — только выводы, это хорошо для затвора.
Дорожка LO — по §2.1.

### 3.3 Цепь затвора (`Phase_A.kicad_sch`, ×3) — ветвь выключения общая на позицию (Р2)

Позиция — два параллельных ключа (HS или LS одной фазы). Цепь: выход драйвера → [R_on ∥ (D_off + R_off)] →
точка разветвления X → R_g,i → затвор каждого ключа.

**На позицию** (6 комплектов) — у драйвера, между выводом HO/LO и переходом на внутренний слой:

| Элемент | Номинал / тип | Включение | Установка |
|---|---|---|---|
| R_on | 0805, место под подбор: 0.82 Ом ≈ плата A, 0 Ом ≈ плата B | выход драйвера → X | ставится |
| D_off | диод Шоттки SOD-323 (как на плате A: PMEG4010BEA или 1N5819WS) | анод — X, катод — через R_off к выходу драйвера | ставится |
| R_off | 0 Ом 0603 (место под подбор) | последовательно с D_off | ставится, 0 Ом |

**На каждый ключ** (12 комплектов) — у выводов корпуса:

| Элемент | Номинал / тип | Включение | Установка |
|---|---|---|---|
| R_g,i | 1 Ом 0603 | X → затвор, у вывода G | ставится |
| C_gs | 4.7 нФ 0603 X7R 50 В | затвор — исток, **у выводов корпуса** | **DNP** |
| R_gs | 10 кОм 0603 | затвор — исток | как сейчас |

Эквивалент на ключ: включение ≈ 2·R_on + R_g,i + R_g,int, выключение ≈ 2·(R_off + r_D) + R_g,i + R_g,int
(общая ветвь несёт ток двух затворов). R_g,int у WMB043 — 1.3 Ом.

**Почему ветвь общая (Р2):**
- Пять деталей на затвор в ряды между ключами не помещаются; общая ветвь уходит из блока к драйверу, где есть
  место и её удобно перепаивать.
- Колебания между параллельными затворами демпфирует только сопротивление контура «затвор — затвор»:
  2·R_g,int + 2·R_g,i. Общая ветвь в этот контур не входит, поэтому R_g,i у каждого ключа обязателен.
  - При R_g,i = 1 Ом контур такой же, как на плате B (1 Ом на затвор, на стенде работает).
  - Он демпфирован сильнее, чем в редакции 1 при R_off = 0: там при выключении в контуре только R_g,int и диоды.
  - **R_g,i меньше 1 Ом не ставить без проверки на стенде.**
- Цена: R_g,i стоит и в пути удержания закрытого затвора. Удержание — как у платы B, а не A: на стенде разница
  наброса A/B 0…0.4 В при 20 А, в пределах разброса приборов. Компенсирует C_gs у выводов.
- **Проверить:** повторяющийся импульсный ток D_off. Через диод разряжаются два затвора: пик до ~6 А (его
  ограничивает сток драйвера), τ ≈ (R_g,int + R_g,i)·C_iss ≈ 12 нс. Это вдвое больше, чем через каждый диод
  на плате A.

**Почему элементы такие:**
- R_off — единственный способ подобрать скорость выключения на стенде. Эффект умеренный: R_off до 10 Ом снижает
  выброс примерно на 45 % при фронте ×3.7 (Находки §3.1).
- C_gs снижает наброс на 30–45 % (Находки §4, Д3).
- Кламп Миллера в этой ревизии не закладываем: он ускоряет выключение и ухудшает выброс (Находки §9).
  **Решает владелец**, если нужен — тогда только место без установки.

**Приёмка §3:** петля «HO → R_g → G → S → net-tie → SW» каждого HS замкнута рядом идущими дорожками. Площадь
петли — в CHANGELOG по фазам, в мм², оценкой.

---

## 4. Керамика петли коммутации

**Почему:**
- **Измерено:** у блока только 0603 — фаза C: C92, C94; фаза B: одна C93; фаза A: C90, C95, C96.
- У фазы B её C93 стоит над узлом (x 141.9…143.6), а не у стока HS. У фазы C C92 стоит правильно — над стоком HS.

**Что сделать:**
- На каждую фазу **1206 (или 1210, где помещается) 1 мкФ 100 В X7R — сколько позволит место, одинаково на трёх
  фазах** (Р6); ориентир 4–6. 0603 C90, C92…C96 — по месту: оставить, если не мешают.
- **Только F.Cu (Р1).** Стык «сток HS — полоса GND соседней фазы» (x ≈ 133.4…134.2 и 150.4…151.2, y 75…89) на F.Cu
  занят выводами ключей и R_gs; B.Cu под блоком — сторона радиатора.
- **Место — колонка стока HS** (у фазы A — x 162.5…169.2). **Проверить** по месту, ориентир 4 на фазу:
  - по одному в среднем (y ≈ 80.2…83.6) и нижнем (y ≈ 89…91.5) ряду: место освобождает перенос R_g HS на
    сторону узла (§2.2);
  - два — над стоком HS, на меди VDC F.Cu. От корпусов банок ЗПТ (Ø10) свободна полоса y ≈ 72…74.6 на всю
    ширину, а клинья между банками — до y ≈ 70.
- Вывод VDC — на пур, вывод GND — своими виа на In3: соседняя полоса GND для этого не нужна, поэтому три фазы
  ставятся одинаково.
- **Правило:** каждый конденсатор — со своей парой виа, VDC-виа на In2 и GND-виа на In3, вплотную к пэдам. Между
  этими виа и виа истоков LS своей фазы In3 сплошной (§2).

**Почему место такое.** Петля фазы: сток HS → ключ → узел → LS → исток LS → In3 под узлом → GND конденсатора →
конденсатор → сток HS. При конденсаторе у стока и сплошном In3 под узлом она лежит «вертикально»: F.Cu сверху, In3
в 0.7 мм снизу, ширина — две колонки ключей. **Оценка:** 0.5–0.7 нГн против ~1 нГн по стенду.

**Приёмка §4:**
- число и номиналы конденсаторов по фазам равны;
- у каждого своя пара виа длиной в один слой;
- в CHANGELOG — координаты и оценка ESL ветви по фазе.

---

## 5. Места под RC-снаббер (DNP)

**Почему:**
- Звон после выключения почти не демпфирован: выброс ≈ 1.85·L·di/dt.
- **Оценка:** снаббер снижает выброс на ~35 % (Находки §3.1). Без мест его потом не добавить.

**Что сделать** — на каждую фазу две RC-цепочки, все **DNP**:
- **LS:** узел ↔ полоса GND, у выводов D/S нижних ключей (стык x ≈ 121.2 / 138.2 / 155.2);
- **HS:** VDC ↔ узел, у верхней или нижней кромки стока HS.
- Только F.Cu (Р1).
- C — 0805 или 1206, 100 В, C0G или X7R, ориентир 3.3…4.7 нФ. R — 2010, два 1206 параллельно или один 1206
  повышенной мощности (0.5–0.75 Вт), ориентир 0.47…0.56 Ом. Корпуса — по месту.
- **Не урезать HS-цепочку.** Кельвиновский возврат HS (§3.1) ускорит выключение HS, и его выброс, вероятно,
  дорастёт до уровня LS (Находки §3.2).
- Мощность в R: `C·V²·f` = 0.15–0.22 Вт при 48 В / 20 кГц, до 0.5 Вт при 72 В.
- Петля снаббера — у выводов, без виа, если ставится на F.Cu рядом с ключом.

**Приёмка:** 12 мест (6 C + 6 R, или 6 C + 12 R), DNP в схеме и BOM.

---

## 6. Входы драйверов

**Почему:**
- **Измерено:** HI/LI (`/TMR1_CH1…3`, `/TMR1_CH1N…3N`) — 0.3 мм по F.Cu, начинаются в 1–3 мм от конца пура узла.
  RC-фильтра нет.
- Даташит NSD1624 §7.3: R 2–5 Ом + C 100 пФ у выводов HI/LI. Кандидат на причину просадки узла (Находки §3.4).

**Что сделать:**
- У D4–D6 на HI и LI — R (0603, 0 Ом, место под 2–5 Ом) последовательно и C 100 пФ (0603, **DNP**) на GND, вплотную
  к выводам.
- Трассы HI/LI у драйвера — над GND, не вдоль пура узла и куста виа у шунта.

**Приёмка:** 6 R + 6 C; расстояние от трасс HI/LI до меди узла ≥ 2 мм — в CHANGELOG.

---

## 7. Симметрия фаз

**Почему — измерено:**
- виа GND у истоков LS в блоке — 92 / 38 / 34 (C / B / A);
- виа узла у истоков HS — 6 / 65 / 40;
- керамика — 2 / 1 / 3;
- HS фазы A в 7 мм в сторону от D6.

На стенде пока снята только фаза C (Находки §7).

**Уточнено при сверке (CHANGELOG §1.2):** у самих выводов фазы равны. В 2.5 мм от выводов S у LS виа GND — 29 / 31 / 29;
у выводов S у HS виа узла нет ни в одной фазе. Лишние виа фазы C стоят у края платы. Числа 65 / 40 — поле виа под
нижними LS, на пути тока к втулке.

**Что сделать (Р8):**
- по каждой фазе виа **не меньше, чем в rev0**:
  - GND в полосе: 92 / 37 / 33, из них в 2.5 мм от выводов S у LS — 29 / 31 / 29;
  - узла в колонке узла (y 72…93.5): 16 / 74 / 55.
- Виа, снятые под дорожки, переставить в ту же полосу или колонку. Подтягивать B и A до фазы C не нужно — с этим
  числом виа они сейчас работают.
- **Почему так, а не «до лучшей фазы».**
  - Основной путь тепла ключа — D-пэд и 28 отверстий в нём на B.Cu и радиатор; доработка их не трогает.
  - Виа полосы несут весь ток истоков LS (у полосы на F.Cu другого выхода нет) и часть тепла через выводы истока.
  - «Не меньше rev0» гарантирует путь тока и тепла не хуже, чем на работающей плате.
- керамика — §4;
- затворные пары — §2, §3.

**Приёмка:** таблица по фазам в CHANGELOG.

---

## 8. Площадки для щупа

**Почему:** все опыты сделаны на выводах PDFN. Нужны ещё точки для опытов Находок §7:
- шина у стойки (лепестки тока восстановления);
- бутстреп;
- вход драйвера;
- затвор HS.

**Что сделать** — пары точек на F.Cu, **шаг пары ~5 мм** (Р7, пружинная земля):
1. VDC / GND у каждой стойки, рядом с керамикой §4;
2. BST / SW у каждого драйвера;
3. HI и LI, каждая рядом с площадкой GND драйвера;
4. G / S у каждого HS — для math или дифференциального щупа;
5. G / S и D / S у одного LS каждой фазы — повторяемая точка для щупа (сейчас щуп ставят прямо на выводы).

**Экономия места в блоке (пп. 1, 4, 5).** Острие щупа — на пэд нужной цепи, который и так есть рядом: пэд
затвора у R_gs / C_gs, пэды керамики и снаббера. Земля щупа — пятачок Ø ~1.2 мм, открытый от маски на меди
опорной цепи в ~5 мм от острия. Пятачок не требует ни компонента, ни виа. Отдельные площадки со своей виа —
у драйверов (пп. 2, 3), там место есть.

**Приёмка:** перечень площадок с координатами в CHANGELOG.

---

## 9. Итоговые проверки

1. ERC — ошибок не больше 9 (база, Р5); DRC — без ошибок, без неразведённых, без расхождений со схемой; плата
   открывается без потерянных футпринтов.
2. Скриптом по PCB:
   - (а) In3 в «блоке ключей» — без сегментов дорожек;
   - (б) у каждой фазы: число керамики §4, виа §7, длины HO/LO и площади петель §3;
   - (в) SW каждого драйвера связан с узлом только через net-tie у истоков HS;
   - (в′) GND — один остров (DRC: 0 неразведённых). Сумма наименьших сечений GND в проходах между блоком и
     драйверами (между вырезами под винты и втулками J1–J3), на In1 и In4, — не меньше rev0: 4.85 мм
     (In1 C 2.7; In4 C 1.15, J1–J2 0.35, A 0.65; CHANGELOG §1.2), Р13. Через эти проходы идут и все линии к
     драйверам;
   - (г) DNP-позиции §3, §5, §6 отмечены.
3. BOM: новые позиции и DNP; корпуса и напряжения (100 В для керамики и снаббера).
4. `CHANGELOG_rev0.1.md`; сравнение netlist rev0 / rev0.1 по цепям затворов, SW, термисторов.

---

## 10. Открытые вопросы — не выполнять, вынести в CHANGELOG

- **Драйверы ближе к ключам.** Сейчас 17–30 мм. Сильно сократило бы петли затворов, но требует перекомпоновки
  нижней части платы — отдельное решение.
- **Медь 35 мкм** на всех слоях при 120–150 А амплитуды — проверить сечение путей узел → шунт → втулка и VDC/GND.
  Перекладка §2 не должна его уменьшить.
- **Номиналы** C_gs, R_off, снаббера, R/C на HI/LI — по стенду после изготовления.
- **Опыты Р1 (наводка на щуп) и Р2 (выброс HS)** ещё не сделаны (Находки §7). Если Р1 покажет, что часть выброса —
  наводка, приоритет §5 снижается. Остальное не зависит.
- **72-вольтовый вариант** — только после проверки выброса на этой ревизии.
- **Кламп Миллера** — §3.3.

---

## 11. Что проверить на стенде после изготовления

Методика — программа опытов `~/Git/PC/power_loss_calc/docs/validation/program_osc.md`: базовый набор Б1–Б5 на всех
фазах. Сравнить с rev0 (Находки §8):

| Величина | rev0 (фаза C) | Ожидание rev0.1 |
|---|---|---|
| Частота звона после выключения | 125–139 МГц | выше, одинаково по фазам (±10 %) |
| Выброс выключения LS при 120 А | ΔV 33–37 В | ниже за счёт L петли; со снаббером — ещё на ~35 % |
| Наброс на затвор LS | 2.8–3.4 В | без C_gs — около того; с C_gs — на 30–45 % ниже |
| Просадка узла на B при 20 А | до 24 В | нет (если причина во входе или петле затвора HS) |
