alsizyakin/InvertorPowerNewGen/bench_2026-10-13/img/f4_turnoff_vgs_vds.png

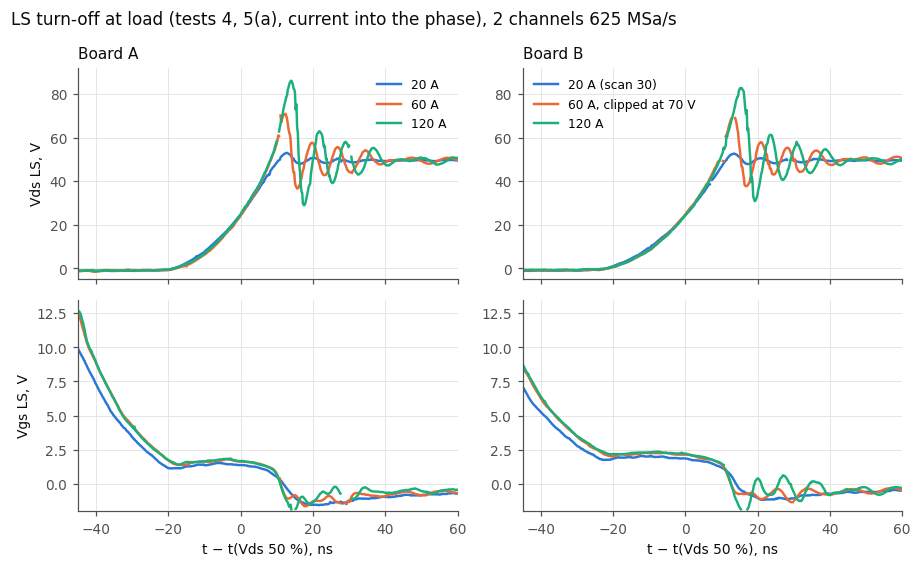
bench_2026-10-13/img/f4_turnoff_vgs_vds.png
