alsizyakin/InvertorPowerNewGen/bench_2026-10-13/img/scan16.jpg

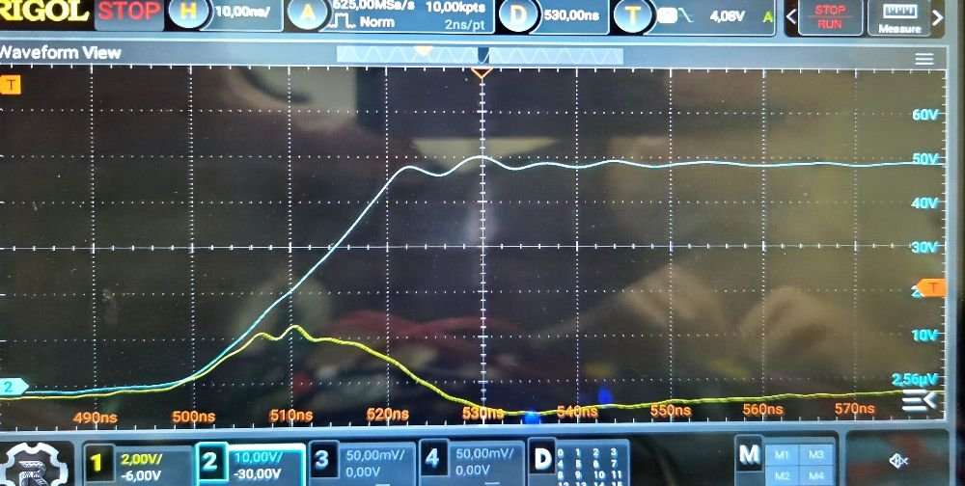
bench_2026-10-13/img/scan16.jpg
