alsizyakin/InvertorPowerNewGen/bench_2026-10-13/img/scan29.jpg

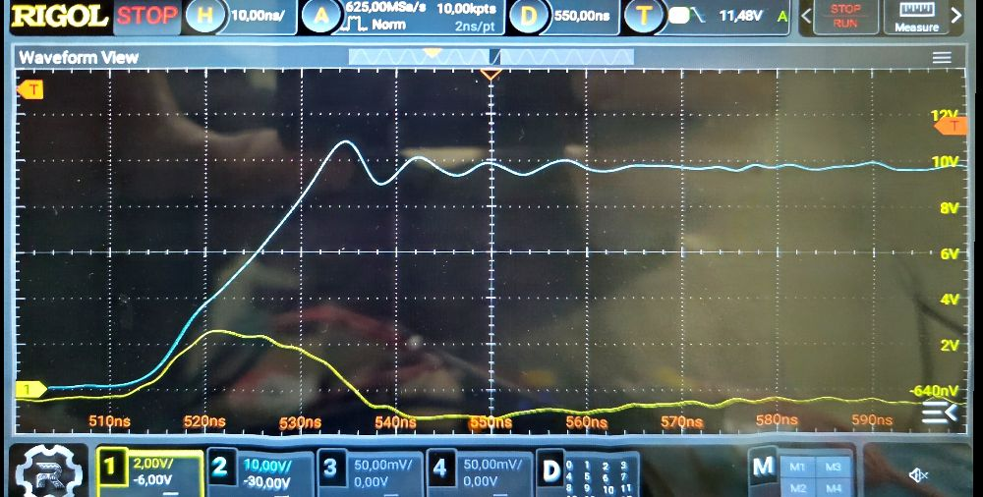
bench_2026-10-13/img/scan29.jpg
