alsizyakin/InvertorPowerNewGen/BOM/Power_BOM_23.07.2026_EN.xlsx

Reference | Value | Product Name | Replacement | Package | Description | Quantity | DNP
C13, C14, C16, C17, C19, C20, C36, C37, C38, C39, C42, C43, C45, C47, C48, C49, C50, C61, C62, C63, C64, C66, C69, C72, C74, C91 | 100n |  |  | SMD 0603 | Capacitor SMD 50V | 26
C85, C86 | 10n |  |  | SMD 0603 | Capacitor SMD 50V | 2
C56 | 10p |  |  | SMD 0603 | Capacitor SMD 50V | 1
C51 | 10u |  |  | SMD 0603 | Capacitor SMD 50V | 1
C1, C2, C3 | 10u |  |  | SMD 0805 | Capacitor SMD 50V | 3
C40, C41 | 12p |  |  | SMD 0603 | Capacitor SMD 50V | 2
C4, C6, C10, C11, C12, C15, C18, C22, C23, C24, C25 | 180u | EEUFS1K181 |  | CP Radial D10.0mm P5.00mm | Capacitort electrolytic 80V | 11
C65, C68, C71, C87, C88, C89 | 1n |  |  | SMD 0603 | Capacitor SMD 50V | 6
C53, C54, C55 | 1u |  |  | SMD 0603 | Capacitor SMD 50V | 3
C7, C8, C9 | 1u |  |  | SMD 1206 | Capacitor SMD 50V | 3
C44, C46, C60 | 2.2u |  |  | SMD 0603 | Capacitor SMD 50V | 3
C5, C21, C26, C27, C28, C29, C30, C31, C32, C33, C34, C35, C75, C76, C77, C78, C79, C80, C81, C82, C83, C84 | 2.2u |  |  | SMD 0805 | Capacitor SMD 100V | 22
C52 | 4.7u |  |  | SMD 0603 | Capacitor SMD 50V | 1
C57, C58, C59, C67, C70, C73 | 56p |  |  | SMD 0603 | Capacitor SMD 50V | 6
D1, D2, D3 | ~ | MURA110T3G |  | SMA | Ultra Fast diode | 3
D8, D9 | ~ | FYLS-0603UBC |  | SMD 0603 | Blue LED | 2
D13, D14, D15, D24, D25, D26 | ~ | BAT54WS-E3-08 |  | SOD-323 | Schottky Diode | 6
D11 | ~ | SIT65HVD232DR |  | SOIC-8 3.9x4.9mm P1.27mm | CAN interface | 1
D4, D5, D6 | ~ | NSD1624 |  | SOIC-8 3.9x4.9mm P1.27mm | Gate driver | 3
D7 | ~ | BAT54C |  | SOT-23 |  | 1
D12 | ~ | PESD2CAN |  | SOT-23 | Dual Line CAN Bus Protector, 24Vrwm | 1
D10, D16, D17, D18, D19, D20, D21, D22 | ~ | BAT54S |  | SOT-23 | TVS | 8
FB1, FB7, FB8, FB9, FB10, FB11, FB12 | ~ | MMZ2012R301AT000 |  | SMD 0603 | Ferrite bead | 7
J1, J2, J3, J4, J5 | ~ |  |  | Bush M4 |  | 5
J6, J7 | ~ | DS1065-03-2x10S8BV |  | PinSocket 2x10 P1.27mm | Connector | 2
Q1, Q2, Q3, Q4, Q5, Q6, Q7, Q8, Q9, Q10, Q11, Q12 | ~ | WMB043N10HGS |  | PDFN-8L | N MOSFET | 12
R51 | 100 |  |  | SMD 0603 | Resistor SMD 1% | 1
R19, R20, R21, R22, R24, R26, R27, R30, R31, R32, R33, R36, R37, R38, R39, R45, R47, R57, R78 | 10k |  |  | SMD 0603 | Resistor SMD 1% | 19
R42, R43, R56, R60, R63, R66, R70, R71 | 120 |  |  | SMD 0603 | Resistor SMD 1% | 8
R50 | 120 |  |  | SMD 0805 | Resistor SMD 1% | 1
R68, R69 | 16.2k |  |  | SMD 0805 | Resistor SMD 1% | 2
R55, R58, R61, R64, R72, R74, R76 | 18k |  |  | SMD 0603 | Resistor SMD 1% | 7
R44, R46, R67 | 1k |  |  | SMD 0603 | Resistor SMD 1% | 3
R79 | 2.4k |  |  | SMD 0603 | Resistor SMD 1% | 1
R1, R2, R3, R4, R5, R6, R23, R25, R28, R29, R34, R35 | 2.7 |  |  | SMD 0805 | Resistor SMD 1% | 12
R48, R49 | 20 |  |  | SMD 0603 | Resistor SMD 1% | 2
R7, R9, R52 | 300u | WSLF2512L3000FEA |  | SMD 2512 | Resistor SMD 1% | 3
R59, R62, R65, R73, R75, R77 | 36k |  |  | SMD 0603 | Resistor SMD 1% | 6
R54 | 5.6k |  |  | SMD 0603 | Resistor SMD 1% | 1
R80 | 750 |  |  | SMD 0603 | Resistor SMD 1% | 1
TH1, TH2, TH3 | ~ | NCP18XH103F03RB |  | SMD 0603 | NTC | 3
U5 | ~ | APM32F405RGT6 |  | LQFP-64 10x10mm P0.5mm | MCU | 1
U6 | ~ | TLV3502AIDR |  | SOIC-8 3.9x4.9mm P1.27mm | Comparator | 1
U7 | ~ | FM25W256 |  | SOIC-8 3.9x4.9mm P1.27mm | FRAM | 1
U4, U9, U12 | ~ | AD8418 |  | SOIC-8 3.9x4.9mm P1.27mm | Shunt monitor | 3
U1, U2, U3, U13, U14, U15 | ~ | LMV321 |  | SOT-23-5 | Op-Amp | 6
U10 | ~ | USBLC6-2SC6 |  | SOT-23-6 | ESD protection | 1
Y1 | 16M | X322516MOB4SI |  | Crystal SMD SeikoEpson FA238-4Pin 3.2x2.5mm | Crystal | 1
