alsizyakin/InvertorPowerNewGen/tools/rev01_layout/data/bom_rev01.csv

Reference | Value | Footprint | QUANTITY | DNP
C1-C3 | 10u | Capacitor_SMD:C_0805_2012Metric_Pad1.18x1.45mm_HandSolder | 3
C4,C6,C10-C12,C15,C18,C22-C25 | 180u | Capacitor_THT:CP_Radial_D10.0mm_P5.00mm | 11
C5,C21,C26-C35,C75-C84 | 2.2u | Capacitor_SMD:C_0805_2012Metric_Pad1.18x1.45mm_HandSolder | 22
C7-C9 | 1u | Capacitor_SMD:C_1206_3216Metric_Pad1.33x1.80mm_HandSolder | 3
C13,C14,C16,C17,C19,C20,C36-C39,C42,C43,C45,C47-C50,C61-C64,C66,C69,C72,C74,C91 | 100n | Capacitor_SMD:C_0603_1608Metric_Pad1.08x0.95mm_HandSolder | 26
C40,C41 | 12p | Capacitor_SMD:C_0603_1608Metric_Pad1.08x0.95mm_HandSolder | 2
C44,C46,C60,C90,C92-C96 | 2.2u | Capacitor_SMD:C_0603_1608Metric_Pad1.08x0.95mm_HandSolder | 9
C51 | 10u | Capacitor_SMD:C_0603_1608Metric_Pad1.08x0.95mm_HandSolder | 1
C52 | 4.7u | Capacitor_SMD:C_0603_1608Metric_Pad1.08x0.95mm_HandSolder | 1
C53-C55 | 1u | Capacitor_SMD:C_0603_1608Metric_Pad1.08x0.95mm_HandSolder | 3
C56 | 10p | Capacitor_SMD:C_0603_1608Metric_Pad1.08x0.95mm_HandSolder | 1
C57-C59,C67,C70,C73 | 56p | Capacitor_SMD:C_0603_1608Metric_Pad1.08x0.95mm_HandSolder | 6
C65,C68,C71,C87-C89 | 1n | Capacitor_SMD:C_0603_1608Metric_Pad1.08x0.95mm_HandSolder | 6
C85,C86 | 10n | Capacitor_SMD:C_0603_1608Metric_Pad1.08x0.95mm_HandSolder | 2
C100-C111 | 4.7n | Capacitor_SMD:C_0603_1608Metric_Pad1.08x0.95mm_HandSolder | 12 | DNP
C112-C117 | 4.7n 100V C0G | Capacitor_SMD:C_0805_2012Metric_Pad1.18x1.45mm_HandSolder | 6 | DNP
C118-C123 | 100p | Capacitor_SMD:C_0603_1608Metric_Pad1.08x0.95mm_HandSolder | 6 | DNP
C124,C128,C132 | 1u 100V X7R | Capacitor_SMD:C_1206_3216Metric_Pad1.33x1.80mm_HandSolder | 3
D1-D3 |  | Diode_SMD:D_SMA | 3
D4-D6,D11,U4,U6,U7,U9,U12 |  | Package_SO:SOIC-8_3.9x4.9mm_P1.27mm | 9
D7,D10,D12,D16-D22 |  | Package_TO_SOT_SMD:SOT-23 | 10
D8,D9 |  | LED_SMD:LED_0603_1608Metric_Pad1.05x0.95mm_HandSolder | 2
D13-D15,D24-D26 |  | Diode_SMD:D_SOD-323_HandSoldering | 6
D30-D35 | PMEG4010BEA | Diode_SMD:D_SOD-323 | 6
FB1,FB7-FB12 |  | Inductor_SMD:L_0603_1608Metric_Pad1.05x0.95mm_HandSolder | 7
J1-J5 |  | Connector_My:Bush_M4 | 5
J6,J7 |  | Connector_PinSocket_1.27mm:PinSocket_2x10_P1.27mm_Vertical | 2
Q1-Q12 |  | MOSFET_MY:PDFN-8L | 12
R1-R6,R23,R25,R28,R29,R34,R35 | 1 | Resistor_SMD:R_0603_1608Metric_Pad0.98x0.95mm_HandSolder | 12
R7,R9,R52 | 300u | Resistor_SMD:R_2512_6332Metric_Pad1.40x3.35mm_HandSolder | 3
R19-R22,R24,R26,R27,R30-R33,R36-R39,R45,R47,R57,R78 | 10k | Resistor_SMD:R_0603_1608Metric_Pad0.98x0.95mm_HandSolder | 19
R42,R43,R56,R60,R63,R66,R70,R71 | 120 | Resistor_SMD:R_0603_1608Metric_Pad0.98x0.95mm_HandSolder | 8
R44,R46,R67 | 1k | Resistor_SMD:R_0603_1608Metric_Pad0.98x0.95mm_HandSolder | 3
R48,R49 | 20 | Resistor_SMD:R_0603_1608Metric_Pad0.98x0.95mm_HandSolder | 2
R50 | 120 | Resistor_SMD:R_0805_2012Metric_Pad1.20x1.40mm_HandSolder | 1
R51 | 100 | Resistor_SMD:R_0603_1608Metric_Pad0.98x0.95mm_HandSolder | 1
R54 | 5.6k | Resistor_SMD:R_0603_1608Metric_Pad0.98x0.95mm_HandSolder | 1
R55,R58,R61,R64,R72,R74,R76 | 18k | Resistor_SMD:R_0603_1608Metric_Pad0.98x0.95mm_HandSolder | 7
R59,R62,R65,R73,R75,R77 | 36k | Resistor_SMD:R_0603_1608Metric_Pad0.98x0.95mm_HandSolder | 6
R68,R69 | 16.2k | Resistor_SMD:R_0805_2012Metric_Pad1.20x1.40mm_HandSolder | 2
R79 | 2.4k | Resistor_SMD:R_0603_1608Metric_Pad0.98x0.95mm_HandSolder | 1
R80 | 750 | Resistor_SMD:R_0603_1608Metric_Pad0.98x0.95mm_HandSolder | 1
R100-R105 | 0.51 | Resistor_SMD:R_1206_3216Metric_Pad1.30x1.75mm_HandSolder | 6 | DNP
R106-R108,R112-R114 | 0.82 | Resistor_SMD:R_0603_1608Metric_Pad0.98x0.95mm_HandSolder | 6
R118-R123 | 0 | Resistor_SMD:R_0603_1608Metric_Pad0.98x0.95mm_HandSolder | 6
TH1-TH3 |  | Resistor_SMD:R_0603_1608Metric_Pad0.98x0.95mm_HandSolder | 3
U1-U3,U13-U15 |  | Package_TO_SOT_SMD:SOT-23-5_HandSoldering | 6
U5 |  | Package_QFP:LQFP-64_10x10mm_P0.5mm | 1
U10 |  | Package_TO_SOT_SMD:SOT-23-6 | 1
Y1 | 16M | Crystal:Crystal_SMD_SeikoEpson_FA238-4Pin_3.2x2.5mm | 1
