alsizyakin/InvertorPowerNewGen/3D/Shunt_Resistors-PSL2(2512).step

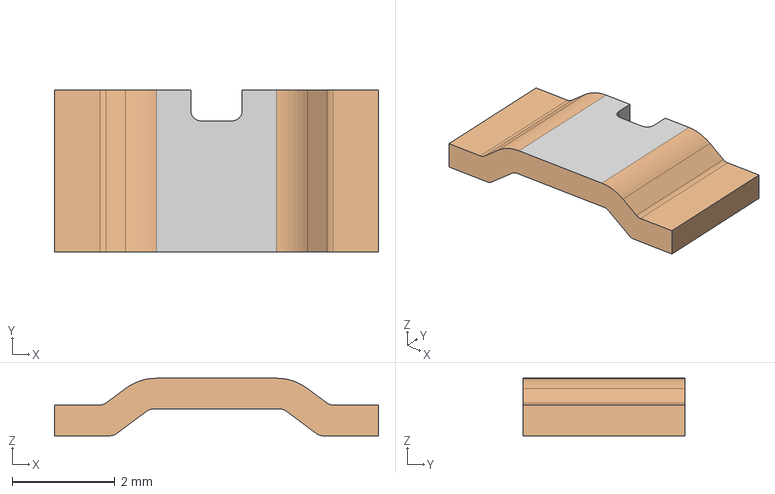
[picture p22: CAD file, 2026-09-23]
3D/Shunt_Resistors-PSL2(2512).step
6.30 x 3.15 x 1.12 mm
