alsizyakin/InvertorPowerNewGen/3D/Втулка М4 6х10.STEP

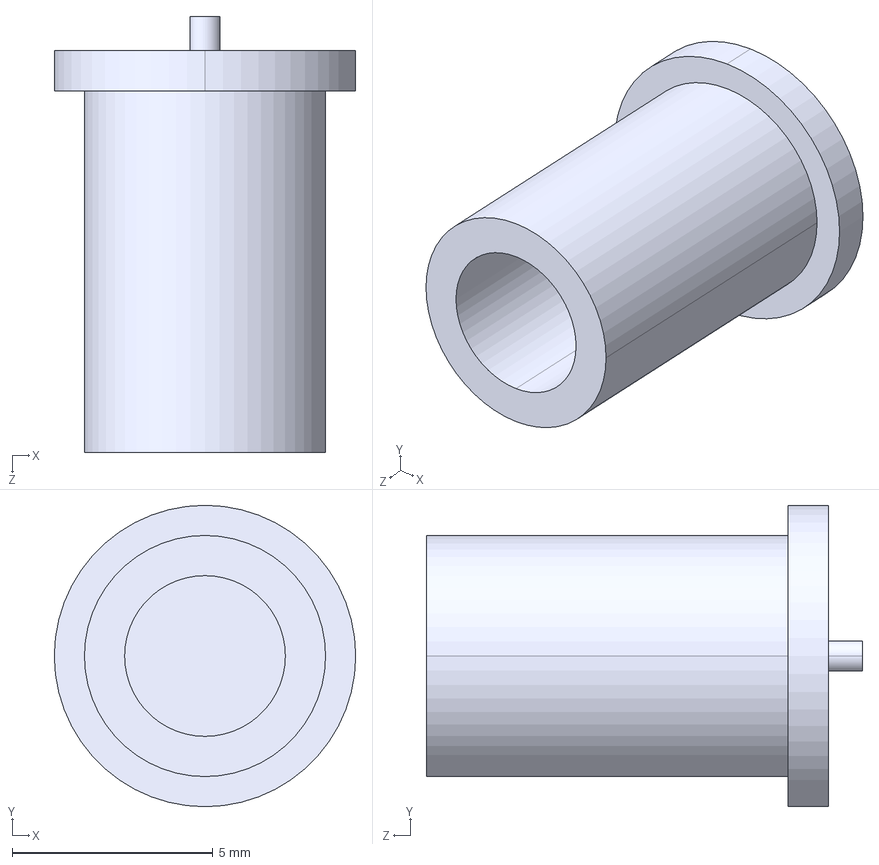
[picture p23: CAD file, 2026-09-23]
3D/Втулка М4 6х10.STEP
7.50 x 7.50 x 10.8 mm
