alsizyakin/InvertorPowerNewGen/3D/Invertor_v1.0.step

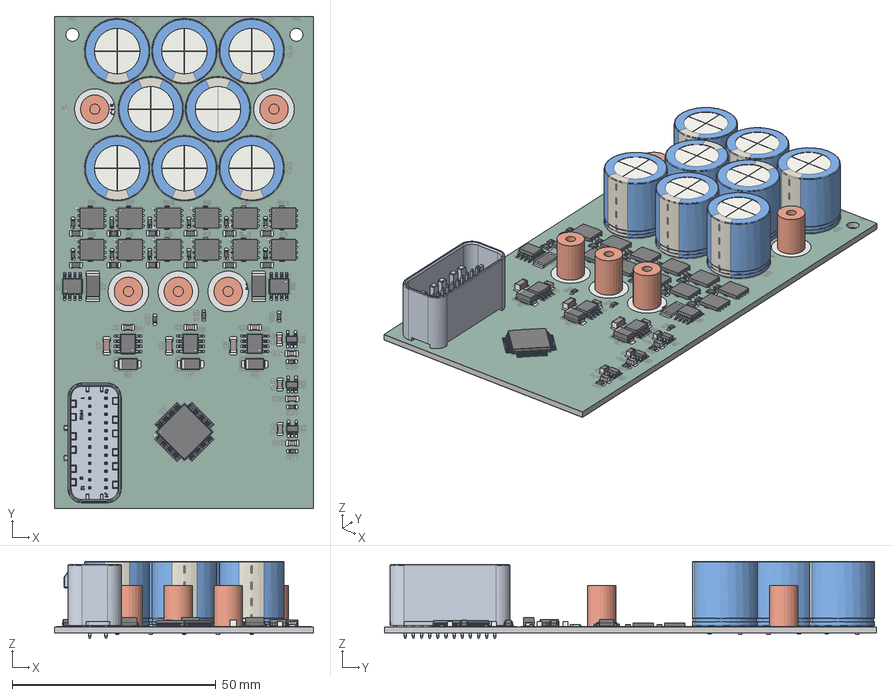
[picture p24: CAD file, 2026-09-23]
3D/Invertor_v1.0.step
63.6 x 120.8 x 19.0 mm
C_0805_2012Metric x 9
DFN-8-1EP_6x5mm_P1.27mm_EP4x4mm x 12
R_2512_6332Metric x 2
R_0805_2012Metric x 12
R_0603_1608Metric x 18
CP_Radial_D16.0mm_P7.50mm x 8
SOIC-8_3.9x4.9mm_P1.27mm x 5
D_SMA x 3
Bush_Phase x 5
M20036S-2x12__(X) 3D
C_1206_3216Metric x 3
SOT-23-5 x 3
LQFP-64_10x10mm_P0.5mm
Power_copper
Power_pad
Power_via
Power_silkscreen
Power_soldermask
Power_PCB
