alsizyakin/InvertorPowerNewGen/3D/1-188275-0.stp

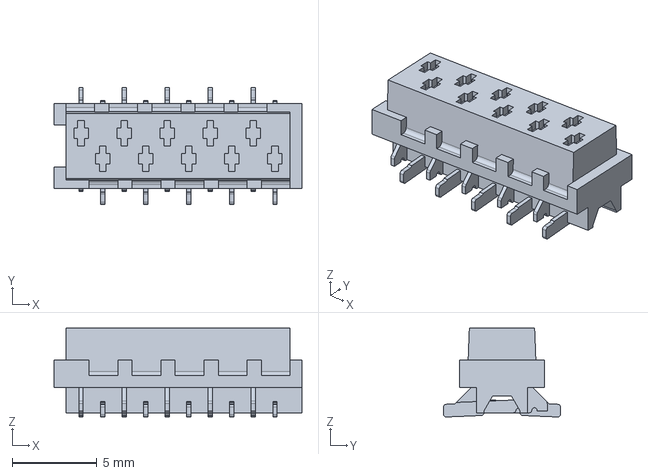
[picture p25: CAD file, 2026-09-23]
3D/1-188275-0.stp
14.6 x 6.90 x 5.25 mm
