alsizyakin/InvertorPowerNewGen/3D/Bush_Phase.stp

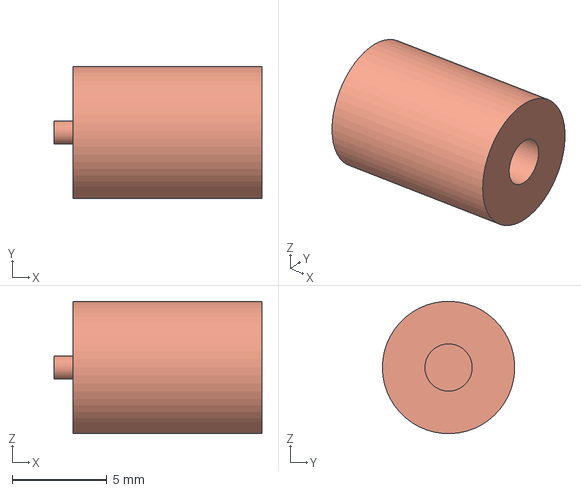
[picture p26: CAD file, 2026-09-23]
3D/Bush_Phase.stp
11.0 x 6.99 x 7.00 mm
