alsizyakin/InvertorPowerNewGen/3D/Bush.stp

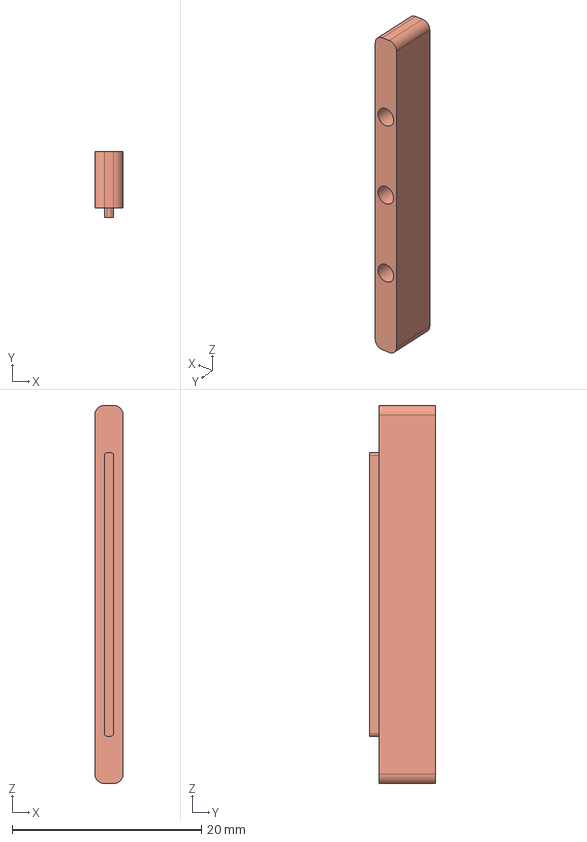
[picture p27: CAD file, 2026-09-23]
3D/Bush.stp
3.00 x 7.00 x 40.0 mm
