alsizyakin/InvertorPowerNewGen/3D/220uF 63V electr 10 x20mm -P.diameter 5mm-Blue-Black.stp

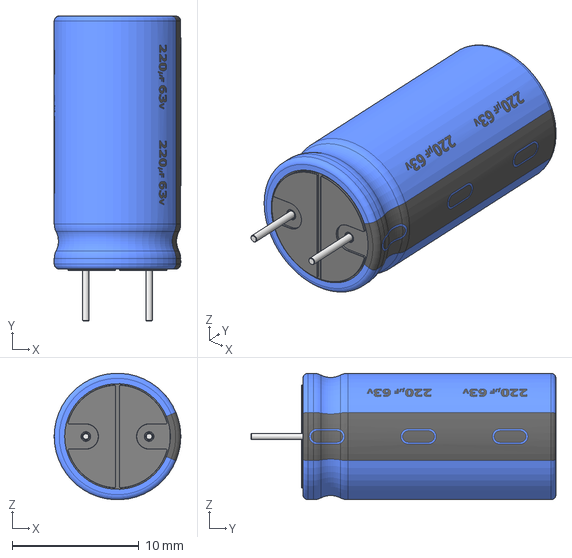
[picture p28: CAD file, 2026-09-23]
3D/220uF 63V electr 10 x20mm -P.diameter 5mm-Blue-Black.stp
10.0 x 24.1 x 9.99 mm
