alsizyakin/InvertorPowerNewGen/3D/PG-HSOF-8-1.STEP

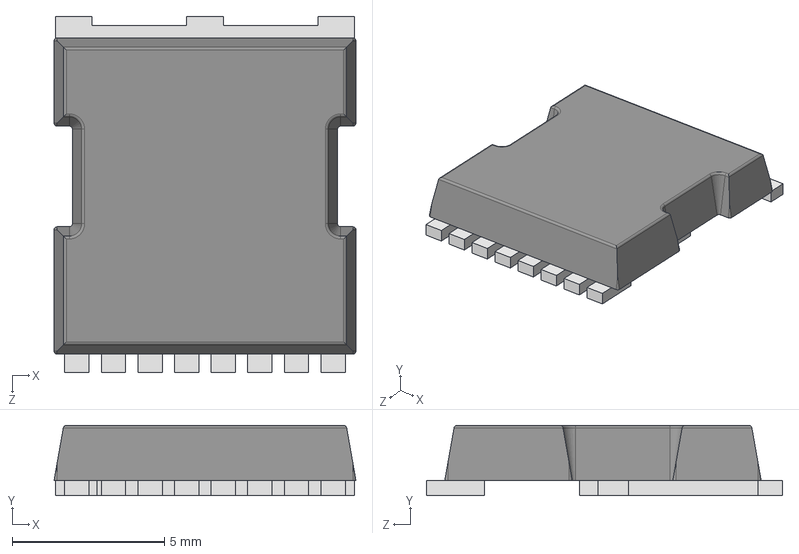
[picture p29: CAD file, 2026-09-23]
3D/PG-HSOF-8-1.STEP
9.90 x 2.30 x 11.7 mm
