alsizyakin/InvertorPowerNewGen/3D/Power_test_v4.step

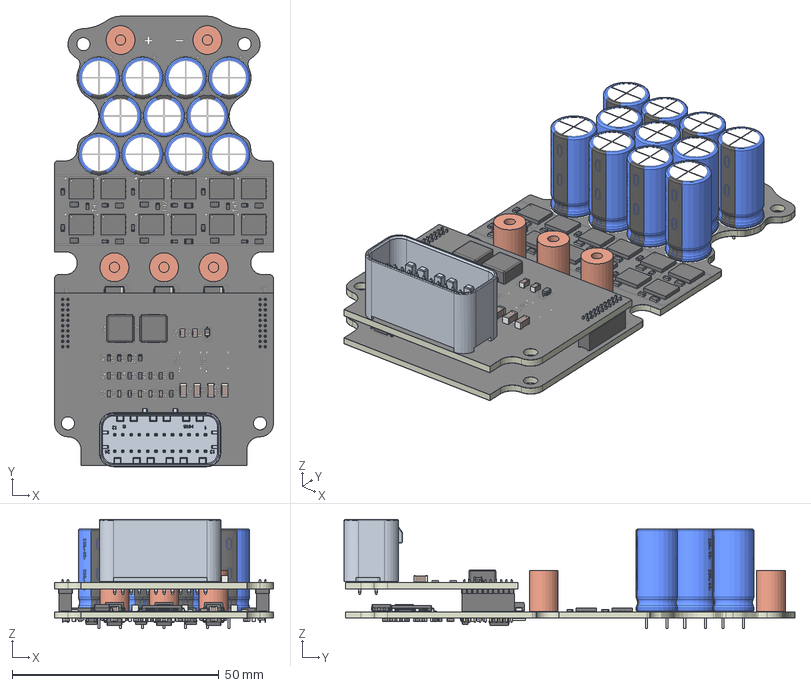
[picture p30: CAD file, 2026-09-23]
3D/Power_test_v4.step
53.0 x 109.0 x 26.4 mm
C_0805_2012Metric x 5
DFN-8-1EP_6x5mm_P1.27mm_EP4x4mm x 12
R_0603_1608Metric x 35
220uF 63V electr 10 x20mm -P.diameter 5mm-Blue-Black x 11
SOIC-8_3.9x4.9mm_P1.27mm x 8
R_0805_2012Metric x 12
C_0603_1608Metric x 34
D_SMA x 3
C_1206_3216Metric x 7
Bush_Phase x 5
PinSocket_2x10_P1.27mm_Vertical x 2
L_Vishay_IHLP-2525 x 2
D_SOD-323
M20036S-2x12__(X) 3D
PinHeader_2x10_P1.27mm_Vertical x 2
Connector_Board_silkscreen x 2
Connector_Board_soldermask x 2
Connector_Board_PCB
LQFP-64_10x10mm_P0.5mm
Crystal_SMD_SeikoEpson_FA238-4Pin_3.2x2.5mm
R_2512_6332Metric x 3
L_0603_1608Metric x 6
SOT-23-5 x 3
Power_silkscreen x 2
Power_soldermask x 2
Power_PCB
