alsizyakin/InvertorPowerNewGen/3D/M20036S-2x12__(X) 3D.STEP

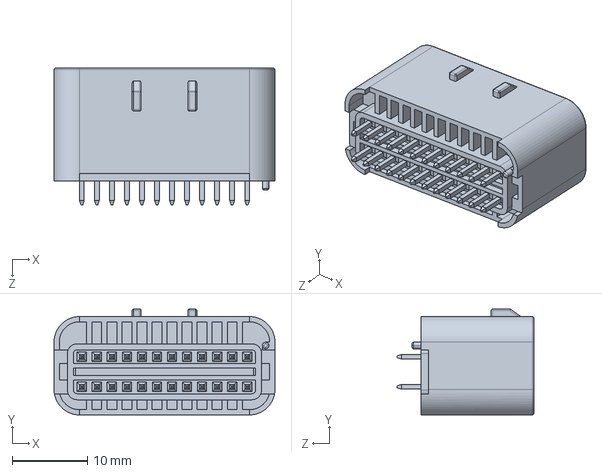
[picture p31: CAD file, 2026-09-23]
3D/M20036S-2x12__(X) 3D.STEP
29.4 x 14.1 x 18.2 mm
