alsizyakin/InvertorPowerNewGen/3D/Power_test_v3.step

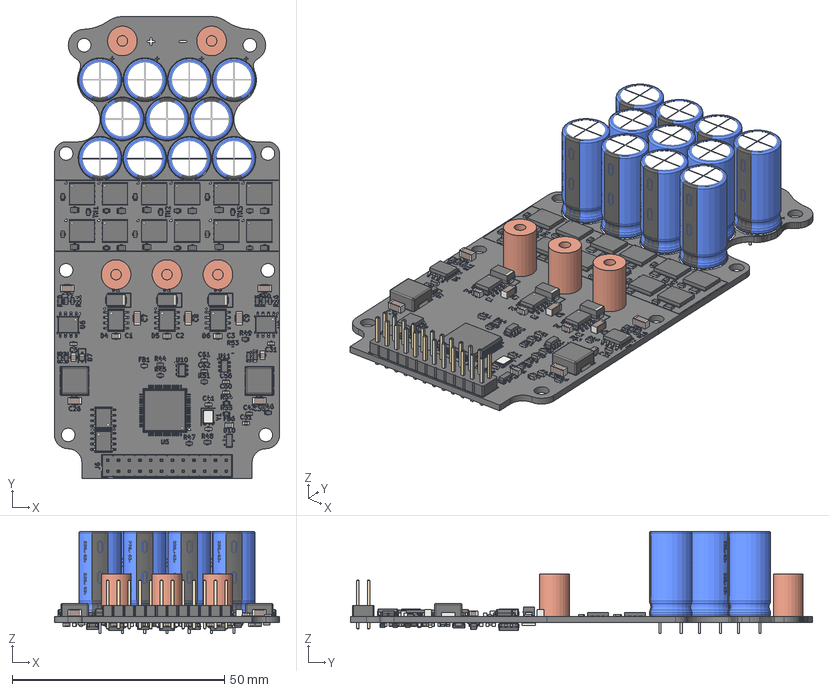
[picture p32: CAD file, 2026-09-23, an earlier design]
3D/Power_test_v3.step
53.0 x 108.8 x 24.1 mm
C_0805_2012Metric x 5
DFN-8-1EP_6x5mm_P1.27mm_EP4x4mm x 12
R_0603_1608Metric x 43
220uF 63V electr 10 x20mm -P.diameter 5mm-Blue-Black x 11
L_0805_2012Metric
SOIC-8-1EP_3.9x4.9mm_P1.27mm_EP2.29x3mm
C_1206_3216Metric x 7
C_0603_1608Metric x 41
D_SOD-323 x 4
SOIC-8_3.9x4.9mm_P1.27mm x 8
R_0805_2012Metric x 13
SOT-23 x 2
D_SMA x 3
Bush_Phase x 5
SOT-23-6 x 2
L_Vishay_IHLP-2525 x 2
PinHeader_2x12_P2.54mm_Vertical
L_0603_1608Metric x 7
SOIC-8-1EP_3.9x4.9mm_P1.27mm_EP2.41x3.81mm
LQFP-64_10x10mm_P0.5mm
Crystal_SMD_SeikoEpson_FA238-4Pin_3.2x2.5mm
LED_0603_1608Metric x 2
R_2512_6332Metric x 3
SOT-23-5 x 3
Power_silkscreen x 2
Power_PCB
