alsizyakin/InvertorPowerNewGen/(list of files, cad)

Other CAD files:
3D/Bush.ipt
3D/Bush_Phase.ipt
3D/OldVersions/Bush.0003.ipt
3D/OldVersions/Bush_Phase.0001.ipt
