alsizyakin/InvertorPowerNewGen/(list of files, drawings)

Other design files:
tools/rev01_layout/data/sch_e_uuids.json
tools/rev01_layout/data/sch_g_uuids.json
tools/rev01_layout/data/sch_h_uuids.json
