alsizyakin/InvertorPowerNewGen/Power.kicad_pcb

## KiCad design Power.kicad_pcb (2026-10-20)

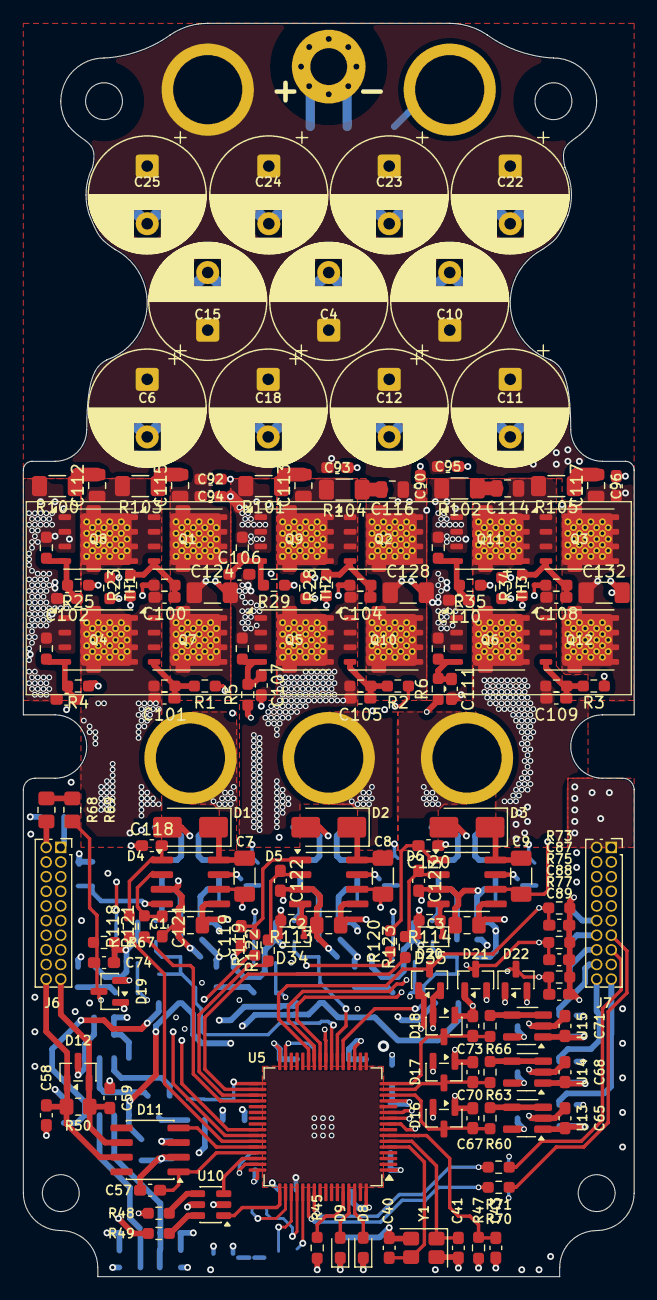
[picture p33: board Power.kicad_pcb from above]

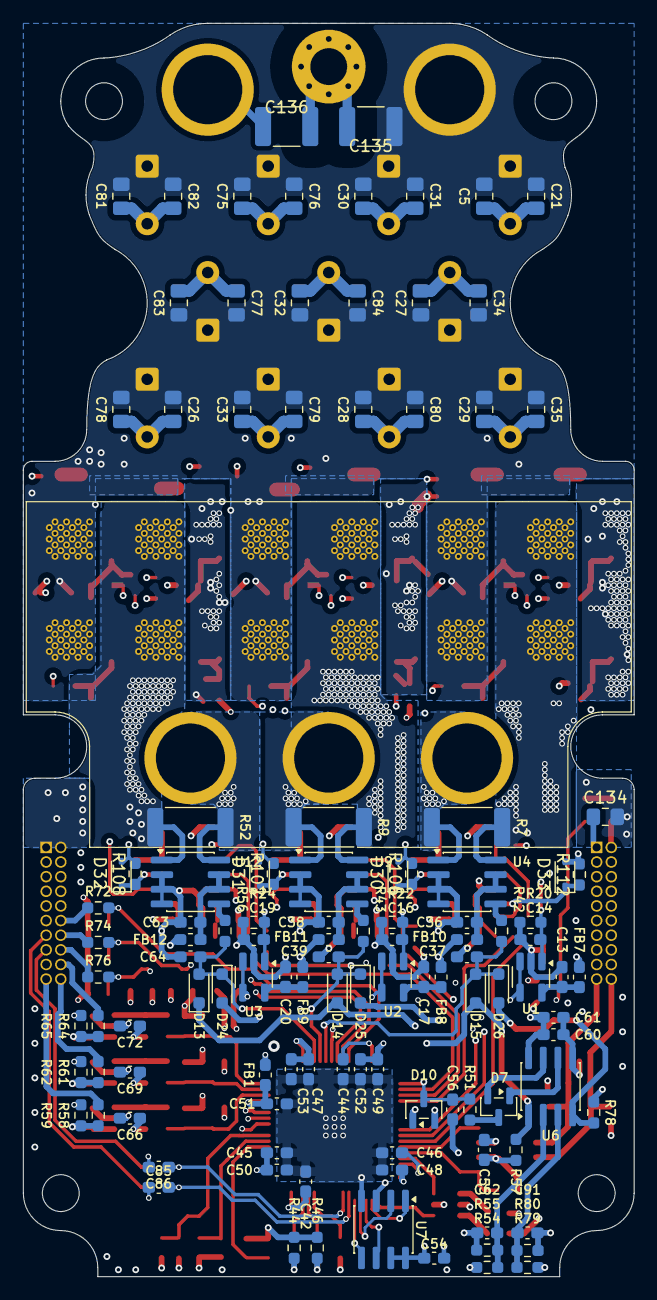
[picture p34: board Power.kicad_pcb from below]

Board: 6 copper layers, 53.0 x 108.8 mm, 293 parts (118 on the bottom side), 134 nets.

Parts:
C1, C2, C3: 10u; C_0805_2012Metric_Pad1.18x1.45mm_HandSolder
C4, C6, C10, C11, C12, C15, C18, C22, C23, C24, C25: 180u; CP_Radial_D10.0mm_P5.00mm
C5, C21, C26, C27, C28, C29, C30, C31, C32, C33, C34, C35, C75, C76, C77, C78, C79, C80, C81, C82, C83, C84: 2.2u; C_0805_2012Metric_Pad1.18x1.45mm_HandSolder
C7, C8, C9: 1u; C_1206_3216Metric_Pad1.33x1.80mm_HandSolder
C13, C14, C16, C17, C19, C20, C36, C38, C42, C43, C45, C47, C48, C49, C50, C61, C62, C63, C66, C69, C72, C74, C91: 100n; C_0603_1608Metric_Pad1.08x0.95mm_HandSolder
C37, C39, C64: 15n; C_0603_1608Metric_Pad1.08x0.95mm_HandSolder
C40, C41: 12p; C_0603_1608Metric_Pad1.08x0.95mm_HandSolder
C44, C46, C60, C90, C92, C93, C94, C95, C96: 2.2u; C_0603_1608Metric_Pad1.08x0.95mm_HandSolder
C51: 10u; C_0603_1608Metric_Pad1.08x0.95mm_HandSolder
C52: 4.7u; C_0603_1608Metric_Pad1.08x0.95mm_HandSolder
C53, C54, C55: 1u; C_0603_1608Metric_Pad1.08x0.95mm_HandSolder
C56: 10p; C_0603_1608Metric_Pad1.08x0.95mm_HandSolder
C57, C58, C59, C67, C70, C73: 56p; C_0603_1608Metric_Pad1.08x0.95mm_HandSolder
C65, C68, C71, C87, C88, C89: 1n; C_0603_1608Metric_Pad1.08x0.95mm_HandSolder
C85, C86: 10n; C_0603_1608Metric_Pad1.08x0.95mm_HandSolder
C100, C101, C102, C103, C104, C105, C106, C107, C108, C109, C110, C111: 10n 50V C0G; C_0603_1608Metric_Pad1.08x0.95mm_HandSolder
C112, C113, C114, C115, C116, C117: 4.7n 100V C0G; C_0805_2012Metric
C118, C119, C120, C121, C122, C123: 100p; C_0603_1608Metric_Pad1.08x0.95mm_HandSolder
C124, C128, C132: 1u 100V X7R; C_1206_3216Metric_Pad1.33x1.80mm_HandSolder
C134: 100n 100V X7R; C_0805_2012Metric_Pad1.18x1.45mm_HandSolder
C135, C136: 4.7n Y2; C_1812_4532Metric
D1, D2, D3: D_SMA
D4, D5, D6, D11: SOIC-8_3.9x4.9mm_P1.27mm
D7, D10, D12, D16, D17, D18, D19, D20, D21, D22: SOT-23
D8, D9: LED_0603_1608Metric_Pad1.05x0.95mm_HandSolder
D13, D14, D15, D24, D25, D26: D_SOD-323_HandSoldering
D30, D31, D32, D33, D34, D35: PMEG4010BEA; D_SOD-323
FB1, FB7, FB8, FB9, FB10, FB11, FB12: L_0603_1608Metric_Pad1.05x0.95mm_HandSolder
H1, H2, H3, H4: MountingHole; MountingHole_3.2mm_M3
H5: MountingHole_Pad; MountingHole_3.2mm_M3_Pad_Via
J1, J2, J3, J4, J5: Bush_M4
J6, J7: PinSocket_2x10_P1.27mm_Vertical
NT1, NT2, NT3: NetTie_2; NetTie-2_SMD_Pad0.5mm
Q1, Q2, Q3, Q4, Q5, Q6, Q7, Q8, Q9, Q10, Q11, Q12: PDFN-8L
R1, R2, R3, R4, R5, R6, R23, R25, R28, R29, R34, R35: 1; R_0603_1608Metric_Pad0.98x0.95mm_HandSolder
R7, R9, R52: 300u; R_2512_6332Metric_Pad1.40x3.35mm_HandSolder
R19, R20, R21, R22, R24, R26, R27, R30, R31, R32, R33, R36, R37, R38, R39, R45, R47, R57, R78: 10k; R_0603_1608Metric_Pad0.98x0.95mm_HandSolder
R42, R43, R56, R60, R63, R66, R70, R71: 120; R_0603_1608Metric_Pad0.98x0.95mm_HandSolder
R44, R46, R67: 1k; R_0603_1608Metric_Pad0.98x0.95mm_HandSolder
R48, R49: 20; R_0603_1608Metric_Pad0.98x0.95mm_HandSolder
R50: 120; R_0805_2012Metric_Pad1.20x1.40mm_HandSolder
R51: 100; R_0603_1608Metric_Pad0.98x0.95mm_HandSolder
R54: 5.6k; R_0603_1608Metric_Pad0.98x0.95mm_HandSolder
R55, R58, R61, R64, R72, R74, R76: 18k; R_0603_1608Metric_Pad0.98x0.95mm_HandSolder
R59, R62, R65, R73, R75, R77: 36k; R_0603_1608Metric_Pad0.98x0.95mm_HandSolder
R68, R69: 16.2k; R_0805_2012Metric_Pad1.20x1.40mm_HandSolder
R79: 2.4k; R_0603_1608Metric_Pad0.98x0.95mm_HandSolder
R80: 750; R_0603_1608Metric_Pad0.98x0.95mm_HandSolder
R100, R101, R102, R103, R104, R105: 0.47; R_1206_3216Metric_Pad1.30x1.75mm_HandSolder
R106, R107, R108, R112, R113, R114: 0.82; R_0603_1608Metric_Pad0.98x0.95mm_HandSolder
R118, R119, R120, R121, R122, R123: 0; R_0603_1608Metric_Pad0.98x0.95mm_HandSolder
TH1, TH2, TH3: R_0603_1608Metric_Pad0.98x0.95mm_HandSolder
U1, U2, U3, U13, U14, U15: SOT-23-5_HandSoldering
U4, U6, U7, U9, U12: SOIC-8_3.9x4.9mm_P1.27mm
U5: LQFP-64_10x10mm_P0.5mm
U10: SOT-23-6
Y1: 16M; Crystal_SMD_SeikoEpson_FA238-4Pin_3.2x2.5mm

Connections:
+3.3V: C42.1, C45.1, C47.1, C48.1, C49.1, C50.1, C52.1, C53.1, C54.1, C55.2, C60.1, C61.1, C66.1, C69.1, C72.1, D10.2 (K), D11.3 (Vcc), D16.2 (K), D17.2 (K), D18.2 (K), D19.2 (K), D20.2 (K), D21.2 (K), D22.2 (K), FB1.2, FB7.1, FB8.1, FB9.1, FB10.1, FB11.1, FB12.1, J7.7, J7.8, J7.9, J7.10, R47.1, R54.1, R78.1, R79.1, TH1.1, TH2.1, TH3.1, U5.1 (VBAT), U5.19 (VDD), U5.32 (VDD), U5.48 (VDD), U5.64 (VDD), U6.8 (V+), U7.3 (~WP), U7.7 (~HOLD), U7.8 (VCC), U10.5 (VBUS), U13.5 (V+), U14.5 (V+), U15.5 (V+)
+3.3VA: C51.1, FB1.1, U5.13 (VDDA)
+12V: C1.2, C2.2, C3.2, D1.2 (A), D2.2 (A), D3.2 (A), D4.5 (VDD), D5.5 (VDD), D6.5 (VDD), J6.7, J6.8, J6.9, J6.10
/ADC_IN_1: C89.1, D22.3 (A), R76.2, R77.1, U5.25 (PC5)
/ADC_IN_2: C88.1, D21.3 (A), R74.2, R75.1, U5.26 (PB0)
/ADC_IN_3: C87.1, D20.3 (A), R72.2, R73.1, U5.27 (PB1)
/BkIN_1: C56.1, D10.3 (common), R51.1, U5.33 (PB12)
/CAN1_RXD_MCU: D11.4 (R), U5.44 (PA11)
/CAN1_TXD_MCU: C57.2, D11.1 (D), U5.45 (PA12)
/CANH: C58.2, D11.7 (CANH), D12.1 (K), J6.20, R50.2
/CANL: C59.1, D11.6 (CANL), D12.2 (K), J6.19, R50.1
/CHASSIS: C135.2, C136.2, H5.1
/Current_Sensor_1/Phase_IN: C108.2, C109.2, C114.1, NT3.2, Q3.S, Q6.D, Q11.D, Q12.S, R36.1, R38.1, R52.2, R105.2, U12.1 (IN-)
/Current_Sensor_1/Phase_OUT: J3.1 (Pin_1_1), R52.1, U12.8 (IN+)
/Current_Sensor_2/Phase_IN: C104.2, C105.2, C113.1, NT2.2, Q2.S, Q5.D, Q9.D, Q10.S, R9.2, R30.1, R32.1, R104.2, U9.8 (IN+)
/Current_Sensor_2/Phase_OUT: J2.1 (Pin_1_1), R9.1, U9.1 (IN-)
/Current_Sensor_3/Phase_IN: C100.2, C101.2, C112.1, NT1.2, Q1.S, Q4.D, Q7.S, Q8.D, R7.1, R19.1, R26.1, R103.2, U4.8 (IN+)
/Current_Sensor_3/Phase_OUT: J1.1 (Pin_1_1), R7.2, U4.1 (IN-)
/Current_measure_1: C64.2, D13.2 (A), D24.1 (K), R56.1, U5.21 (PA5)
/Current_measure_2: C39.2, D14.2 (A), D25.1 (K), R43.1, U5.22 (PA6)
/Current_measure_3: C37.2, D15.2 (A), D26.1 (K), R42.1, U5.23 (PA7)
/Digital_IN/OUT_1: C85.2, R70.1, U5.54 (PD2)
/Digital_IN/OUT_2: C86.1, R71.2, U5.55 (PB3)
/Driver_1/HO: D32.2 (A), R3.1, R34.1, R108.2
/Driver_1/HO_DRV: D6.7 (HO), D32.1 (K), R108.1
/Driver_1/LO: D35.2 (A), R6.1, R35.1, R114.2
/Driver_1/LO_DRV: D6.4 (LO), D35.1 (K), R114.1
/Driver_1/SW: C9.2, D6.6 (SW), NT3.1
/Driver_2/HO: D31.2 (A), R2.1, R28.1, R107.2
/Driver_2/HO_DRV: D5.7 (HO), D31.1 (K), R107.1
/Driver_2/LO: D34.2 (A), R5.1, R29.1, R113.2
/Driver_2/LO_DRV: D5.4 (LO), D34.1 (K), R113.1
/Driver_2/SW: C8.2, D5.6 (SW), NT2.1
/Driver_3/HO: D30.2 (A), R1.1, R23.1, R106.2
/Driver_3/HO_DRV: D4.7 (HO), D30.1 (K), R106.1
/Driver_3/LO: D33.2 (A), R4.1, R25.1, R112.2
/Driver_3/LO_DRV: D4.4 (LO), D33.1 (K), R112.1
/Driver_3/SW: C7.2, D4.6 (SW), NT1.1
/EEPROM_MISO_MCU: U5.52 (PC11), U7.2 (MISO)
/EEPROM_MOSI_MCU: U5.53 (PC12), U7.5 (MOSI)
/EEPROM_SCK_MCU: U5.51 (PC10), U7.6 (SCK)
/EEPROM_~CS_MCU: U5.50 (PA15), U7.1 (~CS)
/HALL_1: J7.19, R58.1
/HALL_2: J7.20, R61.1
/HALL_3: J7.18, R64.1
/Hall_1_MCU: C67.1, D16.3 (A), R60.2, U5.14 (PA0)
/Hall_2_MCU: C70.1, D17.3 (A), R63.2, U5.15 (PA1)
/Hall_3_MCU: C73.1, D18.3 (A), R66.2, U5.16 (PA2)
/SWCLK: U5.49 (PA14), U10.1 (I/O1)
/SWCLK_IN: J6.15, R49.2
/SWDIO: U5.46 (PA13), U10.3 (I/O2)
/SWDIO_IN: J6.13, R48.2
/TMR1_CH1: R120.1, U5.41 (PA8)
/TMR1_CH1N: R123.1, U5.34 (PB13)
/TMR1_CH2: R119.1, U5.42 (PA9)
/TMR1_CH2N: R122.1, U5.35 (PB14)
/TMR1_CH3: R118.1, U5.43 (PA10)
/TMR1_CH3N: R121.1, U5.36 (PB15)
/Temp_PCB_1_MCU: U3.3 (-), U3.4, U5.9 (PC1)
/Temp_PCB_2_MCU: U2.3 (-), U2.4, U5.10 (PC2)
/Temp_PCB_3_MCU: U1.3 (-), U1.4, U5.11 (PC3)
/VDC_MCU: C74.1, D19.3 (A), R67.1, R69.2, U5.24 (PC4)
BOOT0: R45.2, U5.60 (BOOT0)
GND: C1.1, C2.1, C3.1, C4.2, C5.2, C6.2, C10.2, C11.2, C12.2, C13.2, C14.1, C15.2, C16.1, C17.2, C18.2, C19.1, C20.2, C21.2, C22.2, C23.2, C24.2, C25.2, C26.2, C27.2, C28.2, C29.2, C30.2, C31.2, C32.2, C33.2, C34.2, C35.2, C36.1, C37.1, C38.1, C39.1, C40.1, C41.2, C42.2, C43.1, C44.2, C45.2, C46.2, C47.2, C48.2, C49.2, C50.2, C51.2, C52.2, C53.2, C54.2, C55.1, C56.2, C57.1, C58.1, C59.2, C60.2, C61.2, C62.2, C63.1, C64.1, C65.2, C66.2, C67.2, C68.2, C69.2, C70.2, C71.2, C72.2, C73.2, C74.2, C75.2, C76.2, C77.2, C78.2, C79.2, C80.2, C81.2, C82.2, C83.2, C84.2, C85.1, C86.2, C87.2, C88.2, C89.2, C90.2, C91.2, C92.2, C93.2, C94.2, C95.2, C96.2, C102.2, C103.2, C106.2, C107.2, C110.2, C111.2, C118.1, C119.1, C120.1, C121.2, C122.2, C123.2, C124.2, C128.2, C132.2, C134.2, C136.1, D4.3 (GND), D5.3 (GND), D6.3 (GND), D10.1 (A), D11.2 (GND), D12.3 (A), D16.1 (K), D17.1 (K), D18.1 (K), D19.1 (K), D20.1 (K), D21.1 (K), D22.1 (K), J5.1 (Pin_1_1), J6.11, J6.12, J6.17, J6.18, J7.1, J7.2, J7.3, J7.4, J7.5, J7.6, J7.11, J7.17, Q4.S, Q5.S, Q6.S, Q8.S, Q9.S, Q11.S, R20.1, R21.1, R22.1, R24.1, R27.1, R31.1, R33.1, R37.1, R39.1, R44.2, R45.1, R46.2, R55.2, R57.1, R59.2, R62.2, R65.2, R67.2, R73.2, R75.2, R77.2, R80.2, R100.2, R101.2, R102.2, U1.2 (V-), U2.2 (V-), U3.2 (V-), U4.2 (GND), U4.3 (REF2), U4.4 (NC), U5.12 (VSSA), U5.18 (VSS), U5.63 (VSS), U6.5 (V-), U7.4 (GND), U9.2 (GND), U9.3 (REF2), U9.4 (NC), U10.2 (GND), U12.2 (GND), U12.3 (REF2), U12.4 (NC), U13.2 (V-), U14.2 (V-), U15.2 (V-), Y1.2, Y1.4
NRST: C43.2, R47.2, U5.7 (NRST)
unnamed: C100.1, Q1.G, R19.2, R23.2
unnamed: C101.1, Q7.G, R1.2, R26.2
unnamed: C102.1, Q8.G, R21.2, R25.2
unnamed: C103.1, Q4.G, R4.2, R27.2
unnamed: C104.1, Q2.G, R28.2, R30.2
unnamed: C105.1, Q10.G, R2.2, R32.2
unnamed: C106.1, Q9.G, R29.2, R31.2
unnamed: C107.1, Q5.G, R5.2, R33.2
unnamed: C108.1, Q3.G, R34.2, R36.2
unnamed: C109.1, Q12.G, R3.2, R38.2
unnamed: C110.1, Q11.G, R35.2, R37.2
unnamed: C111.1, Q6.G, R6.2, R39.2
unnamed: C112.2, R100.1
unnamed: C113.2, R101.1
unnamed: C114.2, R102.1
unnamed: C115.2, R103.1
unnamed: C116.2, R104.1
unnamed: C117.2, R105.1
unnamed: C7.1, D1.1 (K), D4.8 (BST)
unnamed: C8.1, D2.1 (K), D5.8 (BST)
unnamed: C9.1, D3.1 (K), D6.8 (BST)
unnamed: C118.2, D4.1 (HI), R118.2
unnamed: C121.1, D4.2 (LI), R121.2
unnamed: C119.2, D5.1 (HI), R119.2
unnamed: C122.1, D5.2 (LI), R122.2
unnamed: C120.2, D6.1 (HI), R120.2
unnamed: C123.1, D6.2 (LI), R123.2
unnamed: D7.1, U6.6
unnamed: D7.2, U6.7
unnamed: D7.3, R51.2
unnamed: D8.2 (A), U5.62 (PB9)
unnamed: D8.1 (K), R44.1
unnamed: D9.2 (A), U5.61 (PB8)
unnamed: D9.1 (K), R46.1
unnamed: D13.1 (K), D14.1 (K), D15.1 (K), R57.2, U6.1 (+)
unnamed: D24.2 (A), D25.2 (A), D26.2 (A), R78.2, U6.4 (-)
unnamed: J7.12, R72.1
unnamed: J7.13, R70.2
unnamed: J7.14, R74.1
unnamed: J7.15, R71.1
unnamed: J7.16, R76.1
unnamed: R48.1, U10.4 (I/O2)
unnamed: R49.1, U10.6 (I/O1)
unnamed: R68.2, R69.1
unnamed: C14.2, R20.2, TH1.2, U1.1 (+)
unnamed: C13.1, FB7.2, U1.5 (V+)
unnamed: C16.2, R22.2, TH2.2, U2.1 (+)
unnamed: C17.1, FB8.2, U2.5 (V+)
unnamed: C19.2, R24.2, TH3.2, U3.1 (+)
unnamed: C20.1, FB9.2, U3.5 (V+)
unnamed: R42.2, U4.5 (OUT)
unnamed: C36.2, FB10.2, U4.6 (VS), U4.7 (REF1)
unnamed: C40.2, U5.5 (PH0), Y1.3
unnamed: C41.1, U5.6 (PH1), Y1.1
unnamed: C44.1, U5.31 (VCAP_1)
unnamed: C46.1, U5.47 (VCAP_2)
unnamed: C62.1, R54.2, R55.1, U6.2 (-)
unnamed: C91.1, R79.2, R80.1, U6.3 (+)
unnamed: R43.2, U9.5 (OUT)
unnamed: C38.2, FB11.2, U9.6 (VS), U9.7 (REF1)
unnamed: R56.2, U12.5 (OUT)
unnamed: C63.2, FB12.2, U12.6 (VS), U12.7 (REF1)
unnamed: C65.1, R58.2, R59.1, U13.1 (+)
unnamed: R60.1, U13.3 (-), U13.4
unnamed: C68.1, R61.2, R62.1, U14.1 (+)
unnamed: R63.1, U14.3 (-), U14.4
unnamed: C71.1, R64.2, R65.1, U15.1 (+)
unnamed: R66.1, U15.3 (-), U15.4
VDC: C4.1, C5.1, C6.1, C10.1, C11.1, C12.1, C15.1, C18.1, C21.1, C22.1, C23.1, C24.1, C25.1, C26.1, C27.1, C28.1, C29.1, C30.1, C31.1, C32.1, C33.1, C34.1, C35.1, C75.1, C76.1, C77.1, C78.1, C79.1, C80.1, C81.1, C82.1, C83.1, C84.1, C90.1, C92.1, C93.1, C94.1, C95.1, C96.1, C115.1, C116.1, C117.1, C124.1, C128.1, C132.1, C134.1, C135.1, J4.1 (Pin_1_1), J6.1, J6.2, J6.3, J6.4, Q1.D, Q2.D, Q3.D, Q7.D, Q10.D, Q12.D, R68.1
