alsizyakin/InvertorPowerNewGen/(commit log)

2026-09-23 Начальный коммит: проект KiCad InvertorPowerNewGen
    Исходное состояние силовой платы инвертора (KiCad 10):
    - иерархическая схема Power.kicad_sch (листы Phase_A, Driver, Hall,
    Temperature, Current_Sensor 0..3, Over_Current_Protection);
    - плата Power.kicad_pcb, подпроект ЗПТ Capacitors/;
    - собственные библиотеки Lib/ (символы, футпринты);
    - 3D-модели корпусов и втулок, BOM (RU/EN);
    - REV1_TASK.md — задание на ревизию 1.
    [1-188275-0.stp, 220uF 63V electr 10 x20mm -P.diameter 5mm-Blue-Black.stp, Bush.0003.ipt, Bush.ipt, Bush.stp, Bush_Phase.0001.ipt, Bush_Phase.ipt, Bush_Phase.stp]
2026-10-15 rev0.1: задание на доработку PDFN-платы и находки стенда 13.10.2026
    REV0_1_TASK.md (редакция 1 от 2026-10-15) и bench_2026-10-13/ (BENCH_FINDINGS.md,
    картинки, kpcb.py, layout_figures.py) — по §1.1 задания. Ветка от main;
    rev1 (TOLT) отложена.
2026-10-15 0.1: починены библиотеки символов
    sym-lib-table указывал на несуществующий Lib/MOSFET_My.kicad_sym, а ники
    Logic_My, Novosense и CAN_My не разрешались нигде — символы жили только
    в кэше lib_symbols внутри схем.
    - создан Lib/MOSFET_My.kicad_sym (пустой, под будущий символ TOLT);
    - Novosense:NSD1624 извлечён из кэша Driver.kicad_sch в Lib/Novosense.kicad_sym;
    - CAN_My:SIT65HVD232DR извлечён из Power.kicad_sch в Lib/CAN_My.kicad_sym;
    - в sym-lib-table добавлены Logic_My, Novosense, CAN_My.
    Правок lib_id нет, лис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
2026-10-15 0.2 частично: no_connect на J6.14 и J6.16
    Добавлены два флага "не подключено" на неиспользуемые выводы J6.
    ERC: 21 -> 19 ошибок. Netlist изменился ровно на две строки — у этих
    выводов pintype стал passive+no_connect. Распиновка J6 не менялась,
    ограничение по Connector_Board соблюдено. DRC: 0 нарушений, 0
    неподключённых, 0 расхождений со схемой.
    Остальная часть 0.2 текстом не делается — зафиксировано в CHANGELOG
    вместе с диагностикой: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
2026-10-15 CHANGELOG 0.2: объяснено, почему +3,3 В это семь цепей
    Флаг на +3,3 В гасит одну ошибку, потому что ферриты FB1 и FB7..FB12
    рвут шину на семь независимых цепей, и ERC считает каждую отдельно.
    В таблицу добавлены имена цепей, схема разветвления по ферритам,
    ориентир по месту (на стороне развязочного конденсатора) и счётчик
    ошибок для контроля по ходу: 8 установок закрывают 10 ошибок, потому
    что ERC сообщае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
2026-10-15 0.2: флаги питания расставлены в GUI, ERC 19 -> 9
    Десять PWR_FLAG (#FLG1..#FLG10) поставлены в редакторе на цепи +3.3V,
    +3.3VA, VDC, +12V, три локальные цепи за FB7..FB9 (один флаг в
    Temperature.kicad_sch покрыл все три экземпляра) и три за FB10..FB12 в
    Current_Sensor_1/2/3. Добавлены сопутствующие символы шин
    (#PWR50-51, #PWR93).
    Проверено:
    - ERC 19 -> 9 ошибок, power_pin_not_driven 11 -> 1 (осталась GND);
    - hier_label_mismatch нет — иерархия в порядке, в отличие от того, что
    получ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
2026-10-15 REV0_1_TASK ред. 2: решения 2026-10-15 (Р1–Р7), CHANGELOG §0
    Р1 B.Cu под блоком не трогаем (радиатор, пазов нет) — керамика и снабберы
    только на F.Cu; Р2 ветвь выключения D_off+R_off одна на позицию, у затвора
    свой R_g,i 1 Ом; Р3 делитель термистора не меняется, датчик на полосу GND;
    Р4 0.1/0.2 из rev1 перенесены; Р5 ERC — не больше базы (9); Р6 керамика по
    месту; Р7 шаг пары площадок ~5 мм.
    CHANGELOG_rev0.1.md §0: проверка переноса — ERC 21 -> 9 ош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
2026-10-15 §1: сверка Находок §2 с разбором платы
    Совпало: возвраты SW/GND драйверов, длины HO/LO, содержимое In3 в блоке,
    0603 по фазам, виа по полосам. Новое: на In4 идёт VDC 1 мм к J6 через
    колонку узла фазы C — пересекает путь пары HO+SW; виа GND у самих выводов
    S равны по фазам (29/31/29 в 2.5 мм), виа узла у истоков HS — 0 во всех
    фазах. §1.3: C90, C92…C96 нет в BOM 23.07 — ждёт ответа владельца.
2026-10-15 §1.3: 0603 C90, C92…C96 стоят на платах A и B, номинал не записан
    Ответ владельца 2026-10-15: ставили максимальный доступный номинал в 0603,
    обозначение 2.2u в схеме пока оставляем. В BOM 23.07 этих позиций нет —
    внести в §9.
2026-10-15 CHANGELOG: символы в подлисты добавляются правкой файла (проба)
    Проба на копии: Device:C_Small в Phase_A параллельно R21 — ERC те же 9
    ошибок, netlist +3 компонента на затворах Q8/Q9/Q11 и GND, прочие связи
    не изменились. Обновление платы из схемы — только в GUI.
2026-10-15 REV0_1_TASK: Р8 (виа — не меньше rev0 по фазе), Р9 (длины без меандров)
    §7: критерий «до лучшей фазы» заменён на «не меньше rev0 по каждой фазе»
    (GND в полосе 92/37/33, у выводов S 29/31/29, узел 16/74/55) — путь тепла
    и тока не хуже работающей rev0, D-пэды не затрагиваются.
    §2: LO не длиннее rev0, HO парой с SW на всём пути, без меандров.
2026-10-15 §1.2: мосты GND между блоком и драйверами; pcbnew API непригоден
    В rev0 силовая земля и земля драйверов/МК соединены только в четырёх
    проходах у втулок J1–J3, на In1 (2.7 мм) и In4 (1.15/0.35/0.65 мм). Через
    те же проходы идут все линии к драйверам. Проба переноса LO на In4 перерезала
    оба моста — добавлена проверка §9 (в′): GND один остров, мосты не уже rev0.
    pcbnew 10.0.3 падает на LoadBoard — плата правится текстом + kicad-cli.
    Co-Aut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
2026-10-15 §3, §5, §6 схема: NetTie SW, ветвь выключения на позицию, C_gs, снабберы, RC на HI/LI
    Driver.kicad_sch: SW драйвера — своя цепь через NetTie NT1–NT3; на HO и LO
    R_on 0.82 Ом ∥ (D_off PMEG4010BEA + R_off 0 Ом), R106–R117, D30–D35; на HI/LI
    R 0 Ом + C 100 пФ DNP (R118–R123, C118–C123).
    Phase_A.kicad_sch: R_g 2.7 Ом 0805 -> 1 Ом 0603; C_gs 4.7 нФ DNP C100–C111;
    снабберы LS и HS DNP (C112–C117, R100–R105).
    ERC — 9 ошибок (база), netlist сверен по цепям: +57 компонентов, прочие связи
    без изменений. ТЗ: Р3 — термисто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
2026-10-15 Плата обновлена из схемы (KiCad GUI, F8)
    57 новых футпринтов (§3, §5, §6) положены за край платы; R_g 12 шт. —
    0805 -> 0603, 1 Ом. Сверка со схемой чистая. Ошибки DRC (замыкания,
    зазоры, 102 неразведённых) — старые дорожки на разделённых цепях
    HO/LO/SW/HI/LI, исправляются расстановкой и трассировкой.
2026-10-15 REV0_1_TASK: Р11 (B.Cu у драйверов), Р12 (не меньше 0603), Р13 (мосты GND суммарно)
2026-10-15 Схема, второй заход: ветвь выключения без R_off, керамика §4 (Р14, Р15)
    R_off (R109–R111, R115–R117) убраны — D_off прямо от X к выводу драйвера;
    R_on — 0603, D_off — стандартный SOD-323. Керамика петли C124–C135,
    1 мкФ 100 В 1206, по 4 на фазу. ERC — 9 ошибок (база), netlist сверен.
2026-10-15 Плата обновлена из схемы, второй заход (KiCad GUI, F8)
    R_off (R109–R111, R115–R117) удалены; R_on — 0603, D_off — SOD-323;
    керамика C124–C135 положена за край платы. Сверка со схемой чистая.
2026-10-15 WIP разводка: фаза C (блок, пара HO+SW, ветви D4), VDC→J6 на In2
    Фаза C: R_g,i верхнего HS на стороне узла, NetTie NT1 у истоков HS, C_gs HS,
    термистор на 0.5 мм левее, его линии в блоке на In1; LO C в блоке и проходе
    на In4; пара HO (In3) / SW (In4) от D4 через проход J1–J2 в колонку узла;
    ветви выключения D4: HO — на B.Cu справа от U4, LO — на B.Cu слева от U4.
    VDC → J6.1–4 перенесён с In4 на In2 (мост GND In4 слева от J1: 1.15 → 1.85 мм).
    Не сделано: RC на входах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
2026-10-15 WIP разводка: драйвер D4 — RC на HI/LI, GND под корпусом, заливка узла отодвинута от входов
    R118/R121 под драйвером, C118 над выводом 1, C121 рядом с R121; виа GND
    вывода 3 — под корпусом D4; R67/C74 сдвинуты на 0.25 мм; запретная область
    заливки F.Cu у входов D4 (узел не ближе 2 мм). Зона фазы C и D4 — DRC чисто.
2026-10-15 WIP разводка: фаза B (блок, пара HO+SW через J2–J3, драйвер D5 с ветвями и RC входов)
    Блок B как C со сдвигом +17 мм; R30/R32 сдвинуты на 0.25 мм вправо, чтобы
    колонка узла вместила TH2, R28, NT2. Пара HO+SW по In4 вдоль правого края
    колонки узла (поле переходных узла занимает x <= 144), в проходе J2–J3 HO
    на In3, SW на In4 под ним. Линия +3.3 термистора TH2 переведена на In2
    (под драйверами там полигон +3.3), NTC на In3 сдвинута под корпу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
2026-10-15 WIP разводка: фаза A (блок, пара HO+SW через проход A, драйвер D6 с ветвями и RC входов)
    Блок A как C со сдвигом +34 мм; R36/R38 сдвинуты на 0.25 мм вправо. Пара HO+SW
    идёт прямо вниз по проходу справа от J3: HO по In4 в блоке, ниже на In3; SW
    по In1 на всём пути (In1 в проходе A — полигон узла, моста GND там нет).
    HO пересекает y 91.5 внутри полигона узла на In4, мост A на In4 0.65 → 0.90 мм.
    Линии TH3 в блоке и проходе по In2: +3.3 сразу в пол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
2026-10-15 WIP разводка: §6 — медь узла не ближе 2 мм к HI/LI у D4–D6
    Запрет заливки F.Cu над выводами драйверов (у D4 и D6 — до y 101.6, чтобы
    конденсатор HI остался над выводом 1). У D5 над выводом 1 стоят столбцы виа
    узла B прохода J1–J2: C119 перенесён к R119, HI входит в вывод 1 прямо,
    три нижних виа столбца сняты (58 -> 55). Скрипт hidist.py: 2.09 / 2.11 /
    2.03 мм по D4 / D5 / D6.
2026-10-15 WIP разводка: C_gs нижних ключей (C102/C103, C106/C107, C110/C111)
    Нижние C_gs — под R_g нижнего ряда, GND у C107/C111 своими виа (полоса GND
    там уже закончилась). Верхние — в полосе GND у R_gs/R_g; под них в полосе
    сдвинуты 3/3/2 виа истоков внутри той же полосы: число виа полос 92/37/33,
    как в rev0 (Р8). DRC: 0 ошибок.
2026-10-15 WIP разводка: керамика §4 — по одному 1206 на фазу; лишние три на фазу убраны из схемы
    1206 1u 100V (C124/C128/C132) в среднем ряду колонки стока HS, одинаково на
    трёх фазах, у каждого своя пара виа (VDC и GND). Верхняя полоса над стоком
    занята корпусами банок ЗПТ Ø10 (по футпринту до y 74.1), нижний ряд — R_g
    нижнего HS; поэтому C125–C127, C129–C131, C133–C135 удалены из схемы и платы
    (Р6, «по месту»). C110 переставлен вглубь пол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
2026-10-15 WIP разводка: Р8 — виа у истоков LS восстановлены
    Сдвиги виа под C_gs увели из зоны 2.5 мм от выводов S две виа у фазы C и одну
    у A. Добавлено 5 виа GND в полосах C и A. Итог по Р8: полоса 95/38/36 (rev0
    92/37/33), в 2.5 мм от выводов S 29/32/29 (rev0 29/31/29), узел 16/72/55
    (как rev0 тем же скриптом).
2026-10-15 Разводка rev0.1: §2–§4, §6–§9 выполнены, §5 (снабберы) — на решение владельца
    CHANGELOG: раздел «Разводка платы» — что где стоит, приёмка по разделам задания,
    отступления (LO длиннее rev0 на 3.7–4.8 мм; керамика 1 шт./фазу — верх над стоком
    под банками ЗПТ; R_g нижних HS на прежнем месте; §8 на имеющихся пэдах).
    Плата: скрыто обозначение C103 (заходило на край выреза). DRC: 0 ошибок,
    18 неразведённых — только с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
2026-10-15 §5: полный перебор мест под снабберы (0805/1206, 0805/0805, 0603/0603) — у выводов мест нет
2026-10-15 Разводка: изломы 90° срезаны под 45° (29 из 36; 6 внутри пэдов и виа), вход HI D4 переложен прямо
2026-10-16 Пауза: §5 «на один шунт меньше» — результаты перебора; состояние работы и открытые решения в CHANGELOG
2026-10-17 REV0_1_TASK: раздел Д — стенд 16.10 (C_gs 10 нФ ставится, D_off DNP, проба R_gs у драйвера)
2026-10-17 Проба «плата длиннее на 4 мм»: снабберы §5 встают у выводов при поднятых зонах узла и GND (на копиях, рабочая плата не менялась)
2026-10-17 In3 — сплошная земля на всю плату: 152 сегмента (456 мм, 23 цепи) перенесены на In2/In4, DRC 0 ошибок
2026-10-17 Ревью rev0.1-gnd, раунд 1: SWD/Temp и NTC — на In2 над In3, GND под HI на In1, HO A из-под винта, сшивка GND по краю
2026-10-17 Ревью rev0.1-gnd, раунд 1 (силовая часть): зазоры C124/C128 и C7–C9 для 72 В, вторая виа GND у C132
2026-10-17 Ревью rev0.1-gnd, раунд 1: +3.3V на In2 в 1 мм от края; ответы рецензентам 02/04/06, открытые решения в CHANGELOG
2026-10-17 Д1, Д2: C_gs C100–C111 — 10 нФ C0G, ставятся; D_off D30–D35 — DNP (схема и плата); Д3 снят решением владельца
2026-10-17 Плата длиннее на 4 мм: банки ЗПТ, J4/J5, H1/H2 выше; снабберы §5 у выводов (C 0805 + R 0612 0.47 Ом, средняя точка — перемычка), 1206 C125/C129/C133 у стока HS, 0603 по две на фазу; DRC 0/0/0
2026-10-17 Ревью rev0.1-plus4, раунд 2: средние точки снабберов в 0.5 мм от узла и VDC, VDC на B.Cu в полосе, окна B.Mask в 1.5 мм от пазов под винты; ревью 07/09 и ответы 08/10
2026-10-19 Замечания владельца 19.10: все дорожки под 0/45/90° (octo.py, 76 отрезков); VDC на J6 от верхней полосы по In2, через проход C по In1 — In2 узла C в проходе одним куском; линии термистора C по In1 бе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
2026-10-19 Анализ растекания тока в силовой меди (cflow.py): узел → шунт, VDC, GND по фазам, ценность слоёв, предложенные виа сшивки (не применены); U4/U9/U12 — замена на INA241A2 при 72 В в поле Replacement; в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
2026-10-19 Растекание тока: фаза A — линии термистора A у паза, тупиковое поле виа снято, 6 виа у шунта R52.2 (медь узла A −24 %, пик у шунта 2638 → 1303 А/мм²); 26 виа сшивки VDC/GND/узел C (VDC −11…−17 %); In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
2026-10-19 E6: тупиковая медь узла фаз A и C → GND (угол у J7, бухта у J6), виа GND; медь узла у края −73…−80 %, до J6 (VDC) 0.25 → 1.73 мм, сопротивление узла +0.2…0.9 %; шунт B без изменений (решение владельц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
2026-10-20 Ревью rev0.1-plus4, раунд 3 (11 силовик, 13 ЭМС): C134 100n 100V у J6 на B.Cu; C37/C39/C64 15n; R50 DNP; вывод 4 U4/U9/U12 на GND (под INA241A2); cflow исправлен — стакан связан с медью у стенки, сет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
2026-10-20 Решения владельца после раунда 3: предохранитель F1 2410 на линии VDC к J6 (Bel 0679L1000, замена 0452001.MRL; J6, C134, R68 → /VDC_J6; VDC/GND C +0.6/+0.8 %); места под Y между J4/J5 — H5 CHASSIS (M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
2026-10-20 Решения владельца: предохранитель снят с платы (на соединительную плату, плата и корневой лист — как в d30010b); снаббер R — 2 × 0805 1 Ом параллельно (R100–R105 + R124–R129) в пределах прежних пэдов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
2026-10-20 Проход B на In2: U2+ | +3.3V | HO с зазором 0.25, без перескока +3.3V на In4 (виа 6 → 4), U2+ по кромке плоскости +3.3V; медь Phase_OUT B R9 → J2 0.153 → 0.122 мОм; углы 90° (в т. ч. скрытые 45°-куск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
2026-10-20 track_scan.py: проверка углов, смен ширины и коротких 45°-кусков со сведением концов отрезков в 0.02 мм
2026-10-20 rev0.1-shift3: длина платы как у rev0.1-gnd (108.76 мм), блок и зона МК на 3 мм ниже, полоса 3 мм под снабберы
    - shift3.sh с 515455d: верх (банки, J4/J5, H1/H2) на 3 мм выше; плечи у винтов прижимной пластины остаются с блоком; низ снят на 3 мм (lay_S3c.py)
    - снабберы: R 1206 0.47 Ом anti-surge (HandSolder), C 0805 стандартные пэды; все шесть 0603 2.2 мкФ в полосе; 1206 C125/C129/C133 не поместились
    - U7 на B.Cu под U5 (270°, линии CS/SCK/MISO/MOSI лесенкой, по одной виа); обвяз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
2026-10-20 cflow.via_gain: только живая медь (островок, не связанный со стоком, давал потенциал 0 и ложный выигрыш); виа GND A у правого паза не ставятся — после перезаливки эффекта 0; решение владельца по пэда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
    - три виа GND у (164–168, 92): первая оценка −9 % GND A, после перезаливки и cflow_cases GND A 0.194 → 0.194 мОм, узел A и VDC A без изменений
    - после исправления лучшее новое место на путях VDC/GND даёт ≤ 1 %; сшивка cf3d47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
2026-10-20 rev0.1-shift3, шаг 16 (lay_S3d.py): пары HO/SW фаз C и B на In4 с зазором 0.25 мм вместо 0.5; одна ширина на цепь по всем слоям (46 цепей, силовые не трогал)
    - HO сдвинута к SW, углы концентричные; площадь петли затвора HS на этих участках −31 % (C) / −21 % (B)
    - 0.5: LO, затворы R_g → G (C100–C111), D8/D9-K; 0.3: HO/SW, термисторы, сигналы МК; где 0.5 не проходит у выводов МК — 0.3 целиком
    - DRC 0/0/0, track_scan 0, hv.py 23 (было 24); shift3.sh с 515455d даёт ту же плату
    Co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
2026-10-20 CHANGELOG: состояние на 2026-10-20 (пауза) — rev0.1-shift3 законченный вариант; дальше радиатор и испытания, при проблеме с радиатором — вариант без снабберов
